BlockWorker/ModularAudio/design_simulations/lm5123sim/LM5123_Excel_Quickstart_Calculator_for_Boost_Controller_Design.xlsx

Sheet: Design Converter
 | LM5123 BOOST Controller Design Tool
ABOUT |  | =Input Box |  |  |  | TERMS OF USE
 |  |  |  |  |  | Rev 0.2 | December-2021
Step 1: Design Specifications
 |  |  | Minimum Input Supply Voltage , VSUPPLY(min) | 11 | V
 |  |  | Typical Input Supply Voltage, VSUPPLY(typ) | 12 | V
 |  |  | Maximum Input Supply Voltage , VSUPPLY(max) | 24 | V
 |  |  | Output Target Voltage, VLOAD | 54 | V
 |  |  | Maximum Output Current , ILOAD | 6.00 | A
 |  |  | Light load operation switching mode | FPWM
 |  |  | Free Running Switching Frequency, FSW | 1000 | kHz
 |  |  | Free running Oscillator Set Resistor, RT | 21.14 | kΩ
 |  |  | Output Power, POUT | 324.0 | W
 |  |  | Boost Converter Duty Cycle Limit of LM5123 at VSUPPLY(MIN) | 88.0 | %
 |  |  | Ideal Duty Cycle at VSUPPLY(MIN) | 79.6 | %
Step 2: Filter Inductor
 |  |  | Switching mode at VSUPPLY(min) | CCM
 |  |  | Desired Maximum Inductor Current Ripple Ratio | 60 | %
 |  |  | Recommended Inductance (LM_CALC) | 1.646 | uH
 |  |  | User Selection. Inductance, (LM) | 1.5 | uH
 |  |  | Max Inductor DCR, RDCR | 2.3 | mΩ
 |  |  | Peak inductor current, ILPK | 32.37 | A
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
