BlockWorker/ModularAudio/design_simulations/TPS552892/TPS552892-CALCULATION-TOOL-V1.0-orig.xlsx

Sheet: Design Calculation
Design Tool for TPS552892
V1.0 (04/26/2023)
This tool is designed to aid the user in designing the TPS552892 buck-boost converter. Refer to TPS552892 datasheet for detail design precedure and all equations.
 |  | User input value
 |  | Calculated value
 |  | No use or internal value
Description | Value | Units | Instructions/Comments | Schematic
Component Value
Vin(min) | 9 | V | >=3.0V
Vin(max) | 16 | V | <=36V
Vout | 12.00 | V | Must be lower than or equal to 22V
Iout(max) | 4 | A | Maximum output current
VCC | Internal |  | Select internal VCC or use external VCC power supply
EXTVCC | High |  | EXTVCC pin input logic status
Switching Mode at light load | FPWM |  | Select Forced PWM or Auto PFM mode at light load
MODE | High |  | MODE pin input logic status
R5 recommended | 100000.0 | Ω | Up resistor value of the extenral feedback resistor value. It is recommended to 100kΩ
R6 recommended | 11111.1 | Ω | Bottom resistor value of the external feedback resistor divider
Iout(limit) | 5 | A | Output current limit setting
R1 | 10.0 | mΩ | Output current sensing resistor
ΔIout(Cout_rms) | 2.31 | Arms | The equivalent output capacitor current ripple spec must be higher than this value.
ΔIin(Cin_rms) | 1.73 | Arms | The equivalent input capacitor current ripple spec must be higher than this value
f(sw) | 400000 | Hz | Typical switching frequency
R2 recommended | 49050 | Ω | Switching frequency setting resistor
Frequency dithering f(mod) | 1000 | Hz | Modulation frequency for spread spectrum
C8 recommended | 7.281199942e-09 | F |  | Register Setting
ΔVout(pk-pk) | 0.05 | Vpp | Maximum desired output ripple solely due to output capacitance (ignores ESR)
Cout(min) recommended | 5e-05 | F | Minimum output capacitance needed for Vout ripple requirement
C2 actual | 1e-06 | F | Effective ceramic capacitance at VOUT. Need to consider the derating with DC bias voltage
C3 actual | 6.8e-05 | F | Effective electrolytic capacitance. Need to consider the derating with DC bias voltage
ESR of C3 | 0.003 | Ω | Equivalent ESR if multiple high ESR electrolytic capacitors in parallel
ΔVin(pk-pk) | 0.05 | Vpp | Maximum desired input ripple due to solely to input capacitance at buck mode
Cin(min) recommended | 5e-05 | F | Minimum input capacitance needed for Vin ripple requirement
Cin actual | 4.3e-05 | F | effective output capacitance. Need to consider the derating with DC bias voltage when using ceramic cap
η estimate | 95.0% |  | Efficiency estimate. Correct it after getting the calculated efficiency
K | 0.5 |  | Fraction of maximum average inductor current that is ripple current (0.2-0.6 typically)
L1 recommended min | 2.00390625e-06 | H | L1's minimum recommended inductance value to meet inductor current ripple ratio at boost mode with Vin_min
L1 actual | 4.7e-06 | H
I(Lrms) max | 5.62 | Arms | Inductor maximum RMS current
I(Lpeak) max | 6.21 | A | The inductor (L1) is recommended to have saturation current rating 30% higher than this value.
I(Laverage) max | 5.61 | A | The inductor average current at minmum Vin.
I(Lvalley) max | 5.02 | A
Average Inductor Limit | 8.0 | A | Desired typical average inductor current limit. ±1A tolerance
External CDC voltage ratio | 0 | mV/mV | ΔVout / (VISP-VISN)
R4 recommend | floating | Ω | Recommended R4 for external CDC setting
Loop Compensation Calculation in FPWM CCM mode |  |  |  | Bode Plot
Vin | 9.0 | V | Check both buck and boost mode by changing Vin and Vout. The loop must have enough phase margin and gain margin
Vout | 12.0 | V
Buck or Boost? | Boost |  | Calculate open loop compensate at buck mode or boost mode
gm_PS | 18.6 | S | Power stage gm of IL/Vcomp
fp_PS | 1537.728919 | Hz | Power stage pole of Rload and Cout
fz_RHP | 51571.9159 | Hz | Right half plane zero in boost mode
fz_ESR | 780171.2897 | Hz | ESR zero of the output cap
f(BW) desired | 8000 | Hz | Should be less than 1/5*fzRPH and 1/10*fsw
gm_EA | 0.00019 | S | Error amplifier gm
R3 recommended | 14640.46384 | Ω
R3 actual | 10000 | Ω | COMP pin has internal 2k resistor in seriese with R3
C7 recommended | 1.657863991e-08 | F | Set the compensation fz = fco/10
C7 actual | 4.7e-09 | F
fz_COMP | 2821.896154 | Hz | Loop compensation zero frequency
C6 recommended | 3.302953772e-10 | F | The lower zero of the Cout's ESR zero and boost right half plane zero should be cancelled by the R3*(C6*C7/(C6+C7)) pole.
C6 actual | 1e-10 | F
fp2_COMP | 131588.0313 | Hz | Have internal 3pF cap between COMP and GND
Efficiency in buck CCM mode or boost CCM mode with maximum Iout
Vin | 9.0 | V | Vin for efficiency estimation at desired Vout and Iout(max)
I(Lrms) | 5.62 | A | Inductor RMS current
I(Lpeak) | 6.21 | A | Inductor peak current
I(Lvalley) | 5.02 | A | Inductor valley current
DCR of L1 | 0.013 | Ω | Inductor series resistance per inductor datasheet
Buck HSFET Rdson | 0.014 | Ω | Buck HSFET on-resistance in TPS552892 is 14mΩ at 25°C. Temperature coefficient is 0.4%/°C. Correct it when at high Tj
Buck HSFET rise time | 1.3e-08 | s | Estimate of SW1 node 10-90% rise time from measurement
Buck HSFET fall time | 1.3e-08 | s | Estimate of SW1 node 10-90% fall time from measurement
Buck LSFET Rdson | 0.022 | Ω | Buck LSFET on-resistance in TPS552892 is 22mΩ at 25°C. Temperature coefficient is 0.4%/°C. Correct it when at high Tj
Buck LSFET dead time | 1e-08 | s | Dead time during the switching
Buck LSFET diode voltage | 0.8 | V | Estimate of body diode voltage of the HSFET
Boost LSFET Rdson | 0.011 | Ω | Boost LSFET on-resistance in TPS552892 is 11mΩ at 25°C. Temperature coefficient is 0.4%/°C. Correct it when at high Tj
Boost LSFET fall time | 9e-09 | s | Estimate of SW node 10-90% fall time from measurement
Boost LSFET rise time | 1.3e-08 | s | Estimate of SW node 10-90% rise time from measurement
Boost HSFET Rdson | 0.01 | Ω | Boost HSFET on-resistance in TPS552892 is 10mΩ at 25°C. Temperature coefficient is 0.4%/°C. Correct it when at high Tj
Boost HSFET dead time | 2e-08 | s | Dead time during the switching
Boost HSFET diode voltage | 1.0 | V | Estimate of body diode voltage of the HSFET
Buck snubber Csnubber | 0 | F | Capacitance of snubber at buck side
Boost snubber Csnubber | 0 | F | Capacitance of snubber at boost side
Rpcb on power path | 2.0 | mΩ | PCB trace resistance on power path from Vin to Vout cap
Rpcb Pd | 63.27350503 | mW | Power losses on PCB trace
Inductor DCR Pd | 411.2777827 | mW | Includes losses from DC resistance drop only
Inductor core & AC Pd | 521 | mW | Core and AC loss of inductor. Use inductor vendor's formula to estimate. 521mW is the power loss of XAL7070-472 running at 400kHz with Ilrms=5.32A and Ilripple=2.63A at 400kHz.
TPS552892 Pd | 1270.262021 | mW | Power loss on TPS552892
Rsense Pd | 160 | mW | Power loss on output current sense resistor
Snubber Pd | 0 | mW | Power loss on snubber
Cout Pd | 17.23892236 | mW | Power loss on ESR of the output capacitor in boost mode | 2.956521739e-09 | 3.851412947 | 1.894894506
η - calculated | 95.2% |  | Efficiency at Iout_max
ΘJA | 33 | °C/W | TPS552892 junction to ambient thermal resistance on EVM. The actual ΘJA depends on the PCB design.
TPS552892 temperature rise | 41.9 | °C | The top case temperature of IC is very close to the Junction temperature because ΨJT=0.6°C/W

Sheet: LegalDisclaimer
THIS PROGRAM IS PROVIDED "AS IS". TI MAKES NO WARRANTIES OR REPRESENTATIONS, EITHER EXPRESS, IMPLIED OR STATUTORY, INCLUDING ANY IMPLIED WARRANTIES OF MERCHANTABILITY, FITNESS FOR A PARTICULAR PURPOSE, LACK OF VIRUSES, ACCURACY OR COMPLETENESS OF RESPONSES, RESULTS AND LACK OF NEGLIGENCE. TI DISCLAIMS ANY WARRANTY OF TITLE, QUIET ENJOYMENT, QUIET POSSESSION, AND NON-INFRINGEMENT OF ANY THIRD PARTY INTELLECTUAL PROPERTY RIGHTS WITH REGARD TO THE PROGRAM OR YOUR USE OF THE PROGRAM.
IN NO EVENT SHALL TI BE LIABLE FOR ANY SPECIAL, INCIDENTAL, CONSEQUENTIAL OR INDIRECT DAMAGES, HOWEVER CAUSED, ON ANY THEORY OF LIABILITY AND WHETHER OR NOT TI HAS BEEN ADVISED OF THE POSSIBILITY OF SUCH DAMAGES, ARISING IN ANY WAY OUT OF THIS AGREEMENT, THE PROGRAM, OR YOUR USE OF THE PROGRAM. EXCLUDED DAMAGES INCLUDE, BUT ARE NOT LIMITED TO, COST OF REMOVAL OR REINSTALLATION, COMPUTER TIME, LABOR COSTS, LOSS OF GOODWILL, LOSS OF PROFITS, LOSS OF SAVINGS, OR LOSS OF USE OR INTERRUPTION OF BUSINESS. IN NO EVENT WILL TI'S AGGREGATE LIABILITY UNDER THIS AGREEMENT OR ARISING OUT OF YOUR USE OF THE PROGRAM EXCEED FIVE HUNDRED DOLLARS (U.S.$500).
Unless otherwise stated, the Program written and copyrighted by Texas Instruments is distributed as "freeware". You may, only under TI's copyright in the Program, use and modify the Program without any charge or restriction. You may distribute to third parties, provided that you transfer a copy of this license to the third party and the third party agrees to these terms by its first use of the Program. You must reproduce the copyright notice and any other legend of ownership on each copy or partial copy, of the Program.
You acknowledge and agree that the Program contains copyrighted material, trade secrets and other TI proprietary information and is protected by copyright laws, international copyright treaties, and trade secret laws, as well as other intellectual property laws. To protect TI's rights in the Program, you agree not to decompile, reverse engineer, disassemble or otherwise translate any object code versions of the Program to a human-readable form. You agree that in no event will you alter, remove or destroy any copyright notice included in the Program. TI reserves all rights not specifically granted under this license. Except as specifically provided herein, nothing in this agreement shall be construed as conferring by implication, estoppel, or otherwise, upon you, any license or other right under any TI patents, copyrights or trade secrets.
TI Information - Selective Disclosure. You may not use the Program in non-TI devices.
