BlockWorker/ModularAudio/design_simulations/lm5123sim/LM5123_Excel_Quickstart_Calculator_for_Boost_Controller_Design-evm.xlsx

 | LM5123 BOOST Controller Design Tool
ABOUT |  | =Input Box |  |  |  | TERMS OF USE
 |  |  |  |  |  | Rev 0.2 | December-2021
Step 1: Design Specifications
 |  |  | Minimum Input Supply Voltage , VSUPPLY(min) | 8 | V
 |  |  | Typical Input Supply Voltage, VSUPPLY(typ) | 14 | V
 |  |  | Maximum Input Supply Voltage , VSUPPLY(max) | 18 | V
 |  |  | Output Target Voltage, VLOAD | 24 | V
 |  |  | Maximum Output Current , ILOAD | 8.33 | A
 |  |  | Light load operation switching mode | FPWM
 |  |  | Free Running Switching Frequency, FSW | 440 | kHz
 |  |  | Free running Oscillator Set Resistor, RT | 49.27 | kΩ
 |  |  | Output Power, POUT | 200.0 | W
 |  |  | Boost Converter Duty Cycle Limit of LM5123 at VSUPPLY(MIN) | 88.0 | %
 |  |  | Ideal Duty Cycle at VSUPPLY(MIN) | 66.7 | %
Step 2: Filter Inductor
 |  |  | Switching mode at VSUPPLY(min) | CCM
 |  |  | Desired Maximum Inductor Current Ripple Ratio | 60 | %
 |  |  | Recommended Inductance (LM_CALC) | 1.616 | uH
 |  |  | User Selection. Inductance, (LM) | 2.6 | uH
 |  |  | Max Inductor DCR, RDCR | 1.6 | mΩ
 |  |  | Peak inductor current, ILPK | 27.33 | A
Step 3: Current Sense Resistor Selection
 |  |  | Peak Current Limit Margin | 30 | %
 |  |  | Selected Peak Current limit(ILPK_select) | 37.24 | A
 |  |  | Recommended current sense Resistor (RS) | 1.61 | mΩ
 |  |  | Selected current sense Resistor (RS) | 1.5 | mΩ
 |  |  | Actual inductor peak current limit | 40.00 | A
Step 4: Output Capacitor Selection
 |  |  | Desired load step ripple voltage (ΔvOUT) | 400 | mV
 |  |  | Minimum output capacitance | 423.18 | uF
 |  |  | Selected Output Capacitance (COUT) | 450 | uF
 |  |  | Equivalent COUT ESR (RESR) | 1 | mΩ
Step 6: Soft-Start Capacitor Selection
 |  |  | Suggested minimum soft-start capacitor (CSS_MIN) | 25.92 | nF
 |  |  | Desied soft-start time at minimum input voltage (TSS) | 10 | ms
 |  |  | Calculated soft-start capacitor (CSS) | 300 | nF
Step 5: UVLO Resistor Divider Selection
 |  |  | Desired voltage On (VUVLO_ON) | 7 | V
 |  |  | Desired voltage OFF (VUVLO_OFF) | 6 | V
 |  |  | Calculated top UVLO resistor value (RUVT_CALC) | 84.09 | kΩ
 |  |  | Selected top UVLO resistor value (RUVT) | 86.6 | kΩ
 |  |  | Bottom UVLO Resistor (RUVB) | 16.146 | kΩ
Step 7: Loop Compensation
 |  |  | Voltage selected (VIN_VAR) | 14V
 |  |  | VREF Resistor Selection
 |  |  | Suggested output voltage range | High
 |  |  | Track pin voltage to set the output voltage (VTRK) | 0.400 | V
 |  |  | Minimum value for (RVREFT_min) | 12.0 | kΩ
 |  |  | Maximum value for (RVREFT_max) | 21.0 | kΩ
 |  |  | Select a top VREF resistor between RVREFT_min and RVREFT_max (RVREFT) | 21 | kΩ
 |  |  | Calculated bottom feedback resistor (RVREFB_calc) | 14.0 | kΩ
 |  |  | Select a bottomresistor based on calculated balue(RVREFB) | 14 | kΩ
 |  |  | Suggested bandwidth (FCO_calc) | 3.9 | kHz
 |  |  | Selected bandwidth (FCO) | 8 | kHz
 |  | Calculated |  | Selected
 | RCOMP | 54.5 | kΩ | 54.9 | kΩ
 | CCOMP | 1.9 | nF | 6.8 | nF
 | CHF | 45.60102166 | pF | 47 | pF
Efficiency / Power Loss Analyzer
Low-Side MOSFET Parameters (QLS)
 |  |  | On-State Resistance, RDS(on) | 4 | mΩ
 |  |  | Total Gate Charge, QG | 28 | nC
 |  |  | Gate-Drain Charge, QGD | 4 | nC
 |  |  | Gate-Source Charge, QGS | 9 | nC
 |  |  | Gate Resistance, RG | 0 | Ω
 |  |  | Gate-Source Threshold Voltage, VTH | 1.7 | V
High-Side MOSFET Parameters (QHS)
 |  |  | On-State Resistance, (RDS(on)) | 4 | mΩ
 |  |  | Total Gate Charge, (QG) | 28 | nC
 |  |  | Gate-Drain Charge, (QGD) | 4 | nC
 |  |  | Gate-Source Charge, (QGS) | 9 | nC
 |  |  | Gate Resistance, (RG) | 0 | Ω
 |  |  | Gate-Source Threshold Voltage, (VTH) | 1.7 | V
 |  |  | Body Diode Reverse Recovery Charge (QRR) | 0 | nC
 |  |  | Body Diode Forward Voltage Drop (VD_BD) | 0.5 | V
