BlockWorker/ModularAudio/design_simulations/lm5123sim/LM5123_Excel_Quickstart_Calculator_for_Boost_Controller_Design-protected.xlsx

 | LM5123 BOOST Controller Design Tool
ABOUT |  | =Input Box |  |  |  | TERMS OF USE
 |  |  |  |  |  | Rev 0.2 | December-2021
Step 1: Design Specifications
 |  |  | Minimum Input Supply Voltage , VSUPPLY(min) | 11 | V
 |  |  | Typical Input Supply Voltage, VSUPPLY(typ) | 11 | V
 |  |  | Maximum Input Supply Voltage , VSUPPLY(max) | 22 | V
 |  |  | Output Target Voltage, VLOAD | 53.5 | V
 |  |  | Maximum Output Current , ILOAD | 6.00 | A
 |  |  | Light load operation switching mode | FPWM
 |  |  | Free Running Switching Frequency, FSW | 2000 | kHz
 |  |  | Free running Oscillator Set Resistor, RT | 10.10 | kΩ
 |  |  | Output Power, POUT | 321.0 | W
 |  |  | Boost Converter Duty Cycle Limit of LM5123 at VSUPPLY(MIN) | 79.8 | %
 |  |  | Ideal Duty Cycle at VSUPPLY(MIN) | 79.4 | %
Step 2: Filter Inductor
 |  |  | Switching mode at VSUPPLY(min) | CCM
 |  |  | Desired Maximum Inductor Current Ripple Ratio | 60 | %
 |  |  | Recommended Inductance (LM_CALC) | 0.740 | uH
 |  |  | User Selection. Inductance, (LM) | 0.82 | uH
 |  |  | Max Inductor DCR, RDCR | 2.3 | mΩ
 |  |  | Peak inductor current, ILPK | 31.85 | A
Step 3: Current Sense Resistor Selection
 |  |  | Peak Current Limit Margin | 30 | %
 |  |  | Selected Peak Current limit(ILPK_select) | 43.40 | A
 |  |  | Recommended current sense Resistor (RS) | 1.38 | mΩ
 |  |  | Selected current sense Resistor (RS) | 1.2 | mΩ
 |  |  | Actual inductor peak current limit | 50.00 | A
Step 4: Output Capacitor Selection
 |  |  | Desired load step ripple voltage (ΔvOUT) | 50 | mV
 |  |  | Minimum output capacitance | 652.61 | uF
 |  |  | Selected Output Capacitance (COUT) | 1000 | uF
 |  |  | Equivalent COUT ESR (RESR) | 1 | mΩ
Step 6: Soft-Start Capacitor Selection
 |  |  | Suggested minimum soft-start capacitor (CSS_MIN) | 178.33 | nF
 |  |  | Desied soft-start time at minimum input voltage (TSS) | 10 | ms
 |  |  | Calculated soft-start capacitor (CSS) | 251.7647059 | nF
Step 5: UVLO Resistor Divider Selection
 |  |  | Desired voltage On (VUVLO_ON) | 10 | V
 |  |  | Desired voltage OFF (VUVLO_OFF) | 9 | V
 |  |  | Calculated top UVLO resistor value (RUVT_CALC) | 77.27 | kΩ
 |  |  | Selected top UVLO resistor value (RUVT) | 77 | kΩ
 |  |  | Bottom UVLO Resistor (RUVB) | 9.517 | kΩ
Step 7: Loop Compensation
 |  |  | Voltage selected (VIN_VAR) | 11V
 |  |  | VREF Resistor Selection
 |  |  | Suggested output voltage range | High
 |  |  | Track pin voltage to set the output voltage (VTRK) | 0.892 | V
 |  |  | Minimum value for (RVREFT_min) | 2.2 | kΩ
 |  |  | Maximum value for (RVREFT_max) | 3.8 | kΩ
 |  |  | Select a top VREF resistor between RVREFT_min and RVREFT_max (RVREFT) | 3.3 | kΩ
 |  |  | Calculated bottom feedback resistor (RVREFB_calc) | 27.2 | kΩ
 |  |  | Select a bottomresistor based on calculated balue(RVREFB) | 27 | kΩ
 |  |  | Suggested bandwidth (FCO_calc) | 14.6 | kHz
 |  |  | Selected bandwidth (FCO) | 12 | kHz
 |  | Calculated |  | Selected
 | RCOMP | 260.7 | kΩ | 220 | kΩ
 | CCOMP | 0.9 | nF | 1 | nF
 | CHF | 2.263152979 | pF | 3 | pF
Efficiency / Power Loss Analyzer
Low-Side MOSFET Parameters (QLS)
 |  |  | On-State Resistance, RDS(on) | 3.2 | mΩ
 |  |  | Total Gate Charge, QG | 12 | nC
 |  |  | Gate-Drain Charge, QGD | 1.7 | nC
 |  |  | Gate-Source Charge, QGS | 1.9 | nC
 |  |  | Gate Resistance, RG | 2.2 | Ω
 |  |  | Gate-Source Threshold Voltage, VTH | 1.1 | V
High-Side MOSFET Parameters (QHS)
 |  |  | On-State Resistance, (RDS(on)) | 3.2 | mΩ
 |  |  | Total Gate Charge, (QG) | 12 | nC
 |  |  | Gate-Drain Charge, (QGD) | 1.7 | nC
 |  |  | Gate-Source Charge, (QGS) | 1.9 | nC
 |  |  | Gate Resistance, (RG) | 2.2 | Ω
 |  |  | Gate-Source Threshold Voltage, (VTH) | 1.1 | V
 |  |  | Body Diode Reverse Recovery Charge (QRR) | 0 | nC
 |  |  | Body Diode Forward Voltage Drop (VD_BD) | 0.5 | V
