BlockWorker/ModularAudio/design_simulations/lm54406F/LMR54406F_PSPICE_TRANS - orig/LMR54406F_PSPICETransientModel_FeaturesandLimitations.pdf

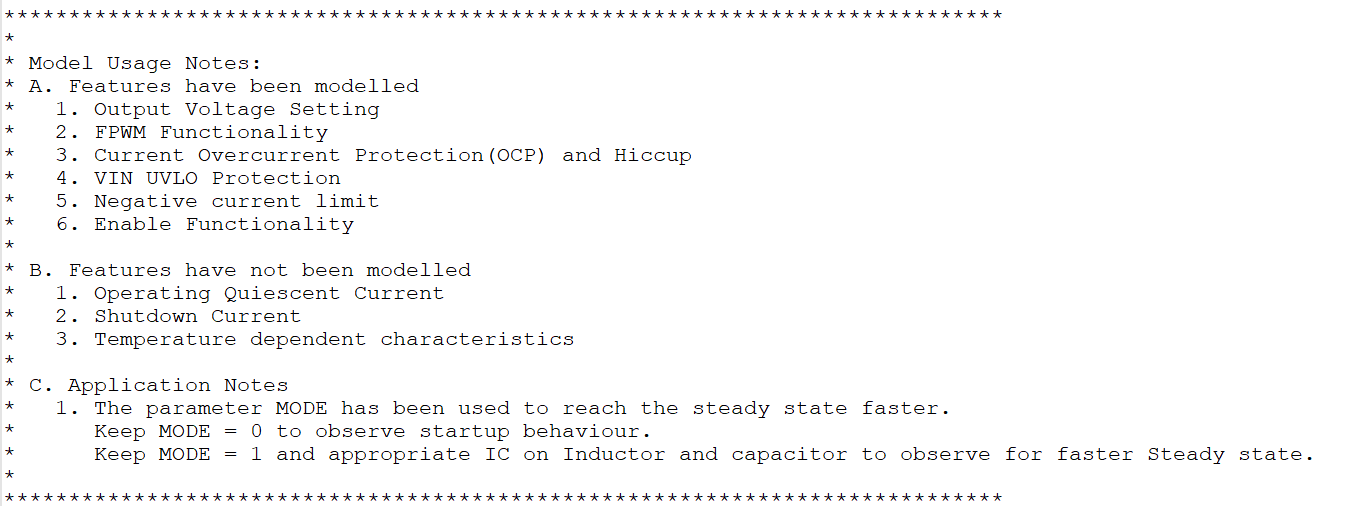
[picture p1: figure]
