BlockWorker/ModularAudio/design_simulations/SBAA333 Companion Simulations/Class-D LC Filter Designer.xlsx

Sheet: L-C Filter Designer
Class-D LC Filter Designer
Select the output configuration on the right.
Filter Type | Common Mode
Output Configuration | BTL
Load Factor | 0.5
Enter the speaker load, desired cutoff frequency, and quality factor.
 |  |  | Gain vs Frequency | Zoom (Gain vs Frequency)
Speaker Load (RLoad) | 4 | Ω
Cutoff Frequency | 40 | kHz
Quality Factor (Q) | 0.707
The calculated LC filter component values are shown below.
Inductor (L) | 11.26 | uH
Capacitor (Cg ) | 1.407 | uF
Capacitor (CBTL) | 1.407 | uF
Total Cap SE Equivalent | 1.407 | uF
Enter standard inductor and capacitor values below to graph & verify.
Inductor (L) | 10.00 | uH
Capacitor (Cg ) | 1.000 | uF
Capacitor (CBTL) | 0.680 | uF |  |  |  |  |  |  | Q
 |  |  |  |  |  | Load 1 | 2 | Ω | 0.316
Total Cap SE Equivalent | 1.000 | uF |  |  | Enter up to 5 different loads to graph. | Load 2 | 3 | Ω | 0.474
 |  |  |  |  |  | Load 3 | 4 | Ω | 0.632
Cut-Off Frequency | 50.3 | kHz |  |  |  | Load 4 | 6 | Ω | 0.949
 |  |  |  |  |  | Load 5 | 8 | Ω | 1.265
Quality Factor (Q) | 0.632
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
