BlockWorker/ModularAudio/design_simulations/lm5123sim/mos-estimates.xlsx

Vout | 53.5
vin | 11 | bottom fet q1 |  | top fet q2
fsw | 2000000 | pswon | 3.951967431 | pdiodec | 1.541695613
dcycle | 0.8046728972 | pswoff | 4.084788441 | pdioderr | 0
L | 8.2e-07 | pcoss | 2.675 | pcoss | 2.675
dil | 5.397196262 | pcond | 3.044897617 | pcond | 0.7391214888
Iout | 6 | pgate | 0.12 | pgate | 0.12
Ilmin | 28.01910522 | ptot | 13.87665349 | ptotd | 1.541695613
ilmax | 33.41630148 |  |  | ptott | 2.400817102
qgs2q1 | 1.2e-09 |  |  | ptot | 3.942512715
qgdq1 | 1.7e-09
ig1on | 1.1
ig2on | 1.1
ig1off | 1.269230769
ig2off | 1.269230769
qossq1 | 5e-08
qossq2 | 5e-08
vfq2 | 0.6
tdeadr | 2.2e-08
tdeadf | 2e-08
qrrq2 | 0
rr | 0.1757031182
irmsq1 | 27.59029547
rdsonq1 | 0.004
irmsq2 | 13.59339443
rdsonq2 | 0.004
qgq1 | 1.2e-08
qgq2 | 1.2e-08
vgs | 5
rgq1 | 2.2
rgq2 | 2.2
rdrq1 | 0.8
rdfq1 | 0.4
rdrq2 | 0.8
rdfq2 | 0.4
vplq1 | 1.7
vplq2 | 1.7
igr1 | 1.1
igf1 | 1.269230769
igr2 | 1.1
igf2 | 1.269230769
