BlockWorker/ModularAudio/design_simulations/battery_calculations/charge.png

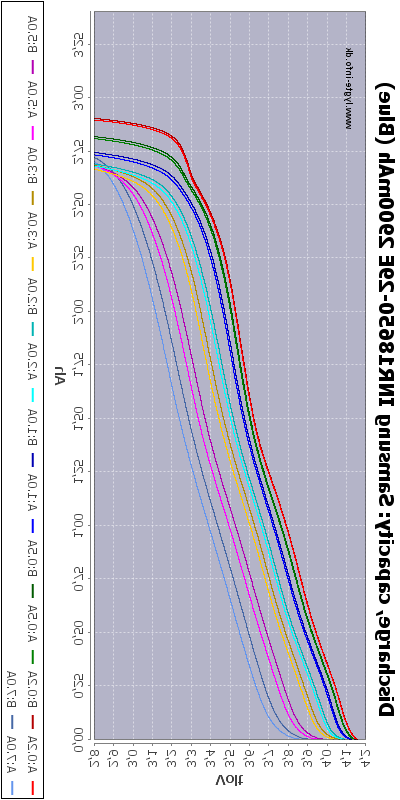
design_simulations/battery_calculations/charge.png
