BlockWorker/ModularAudio/design_simulations/lm5123sim/LM5123-Q1_PSPICE_TRANS/LM5123-Q1_PSPICE_TRANS.png

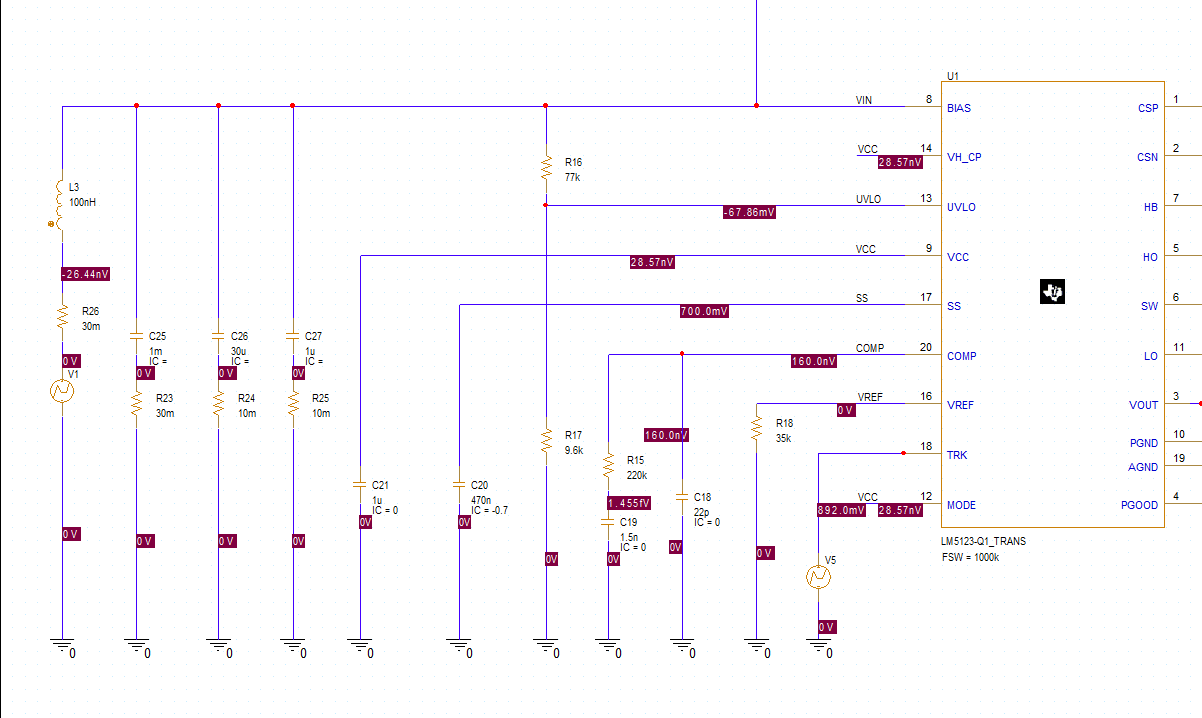
design_simulations/lm5123sim/LM5123-Q1_PSPICE_TRANS/LM5123-Q1_PSPICE_TRANS.png
