BlockWorker/ModularAudio/design_simulations/lm25576/LM25576_PSPICE_AVG/LM25576_AVG.png

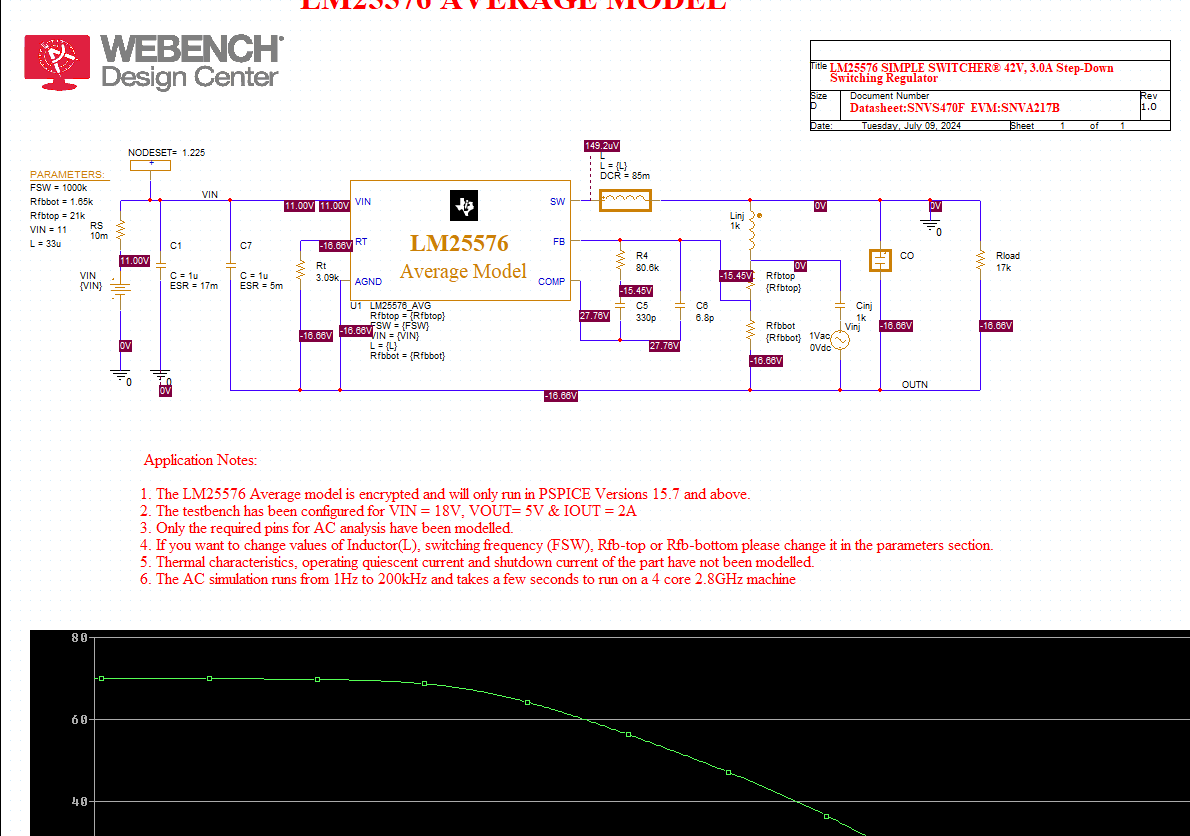
design_simulations/lm25576/LM25576_PSPICE_AVG/LM25576_AVG.png
