BlockWorker/ModularAudio/design_simulations/lm25576/LM25576_PSPICE_TRANS/LM25576_TRANS.png

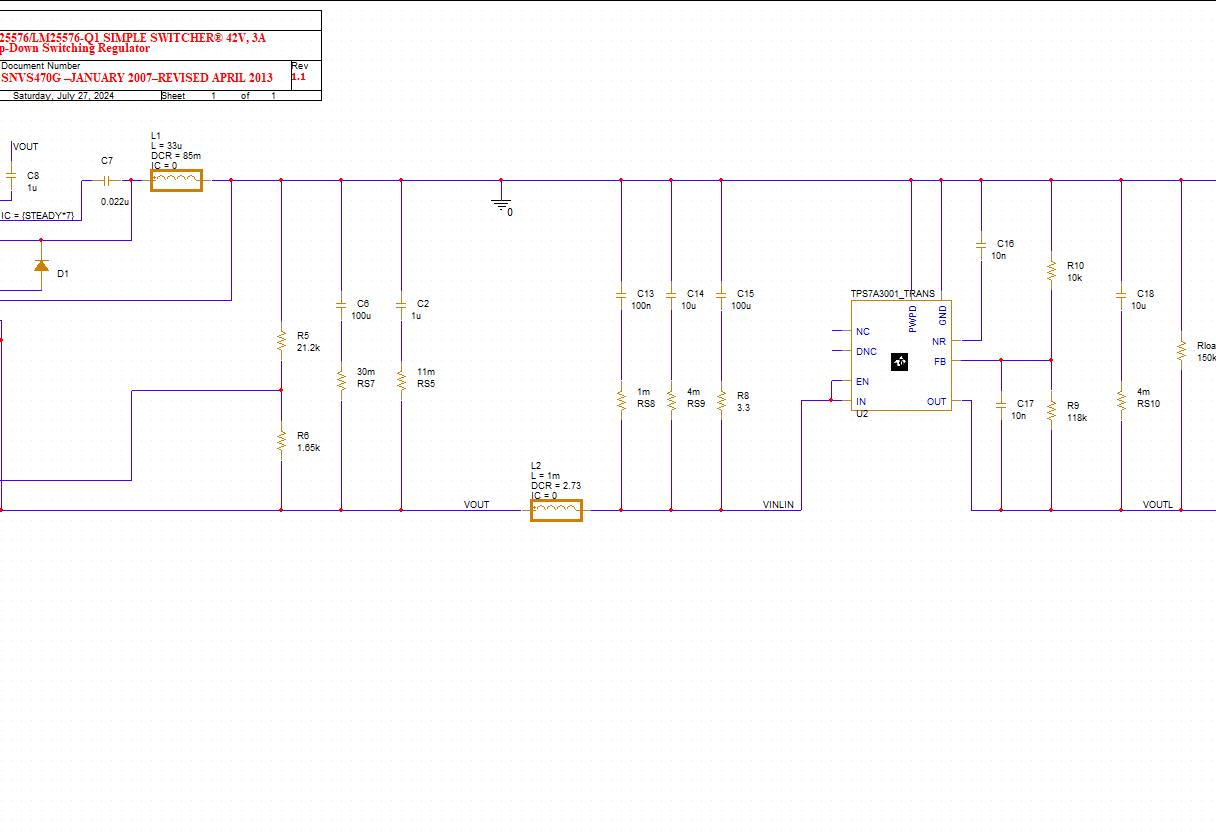
design_simulations/lm25576/LM25576_PSPICE_TRANS/LM25576_TRANS.png
