BlockWorker/ModularAudio/design_simulations/lm25576/TPS7A3001_PSPICE_TRANS/TPS7A3001_TRANS.png

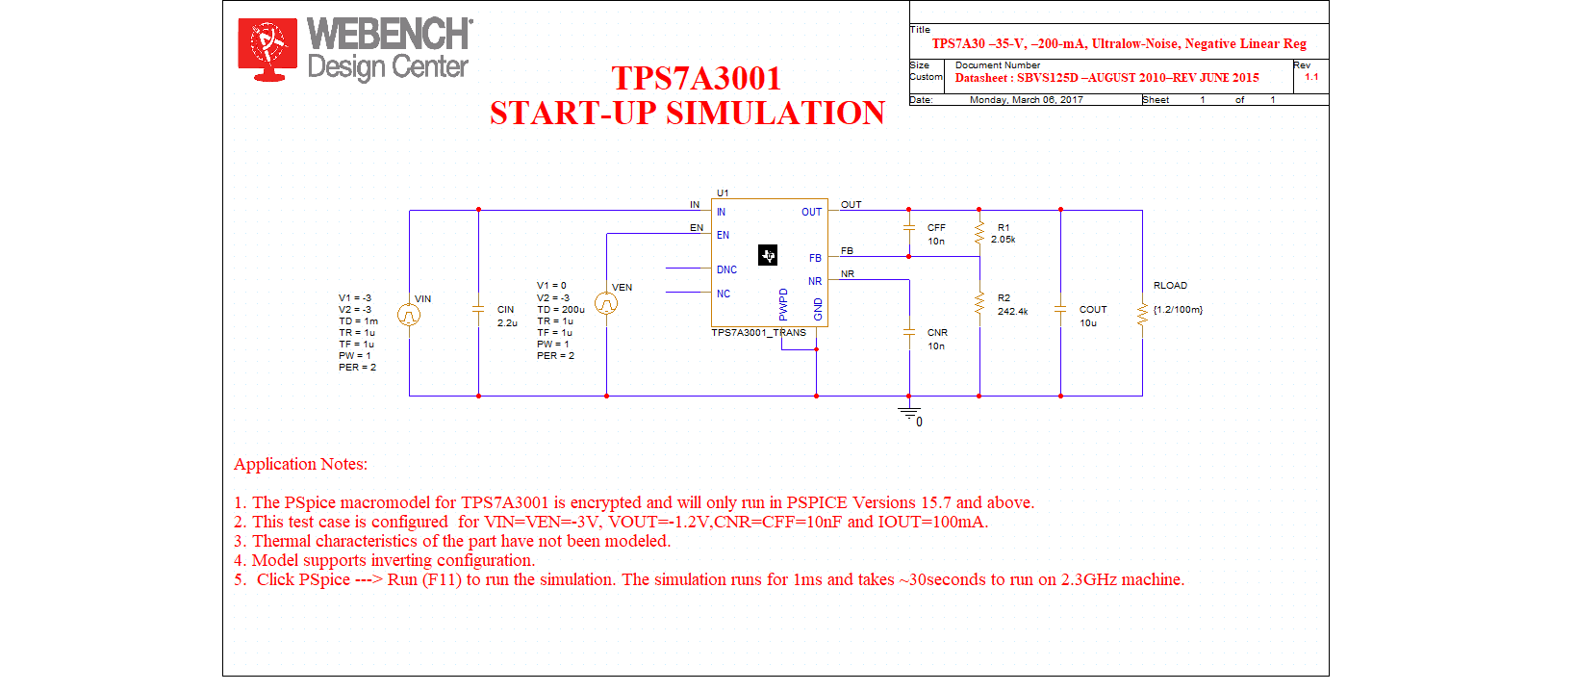
design_simulations/lm25576/TPS7A3001_PSPICE_TRANS/TPS7A3001_TRANS.png
