BlockWorker/ModularAudio/design_simulations/lm54406F/LMR54406F_PSPICE_TRANS/LMR54406F_TRANS.png

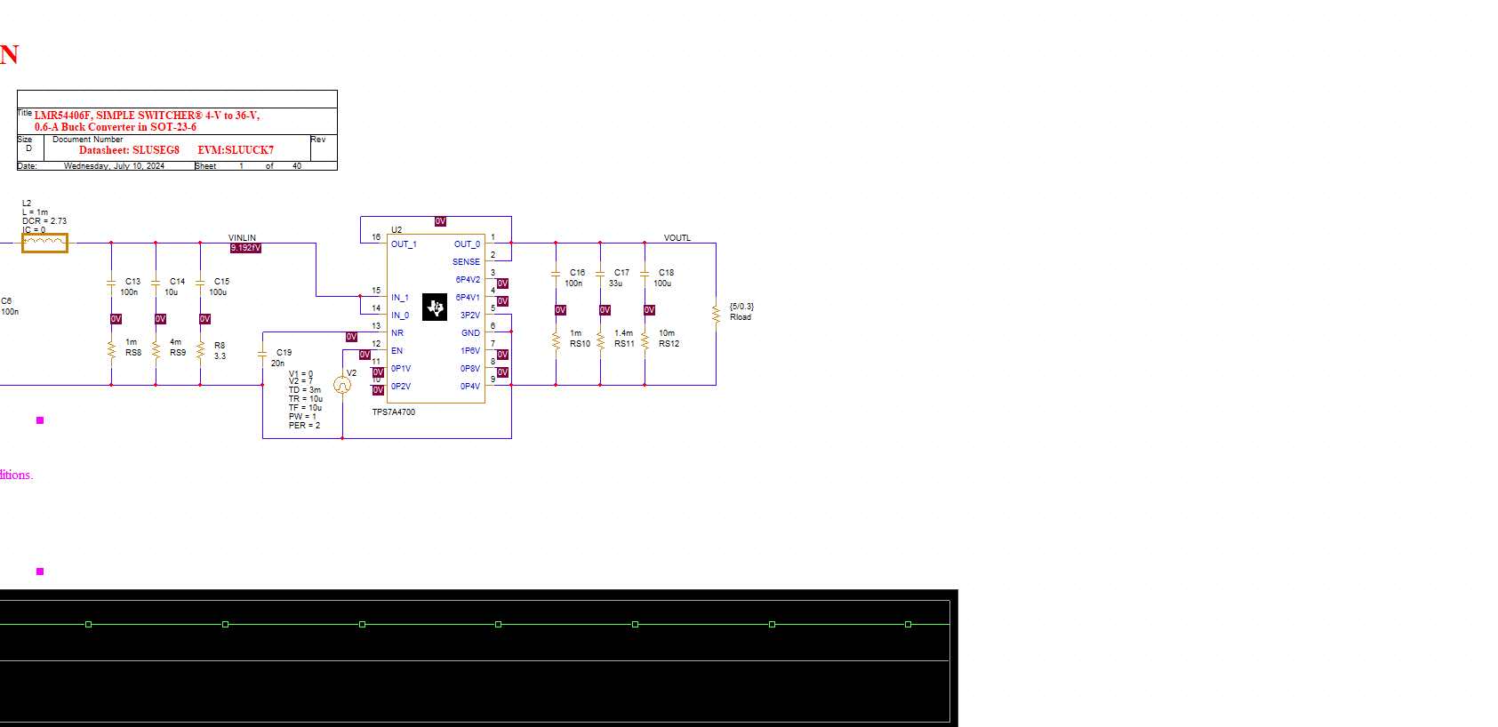
design_simulations/lm54406F/LMR54406F_PSPICE_TRANS/LMR54406F_TRANS.png
