BlockWorker/ModularAudio/design_simulations/lm54406F/TPS7A4700_PSPICE_TRANS/TPS7A4700_TRANS.png

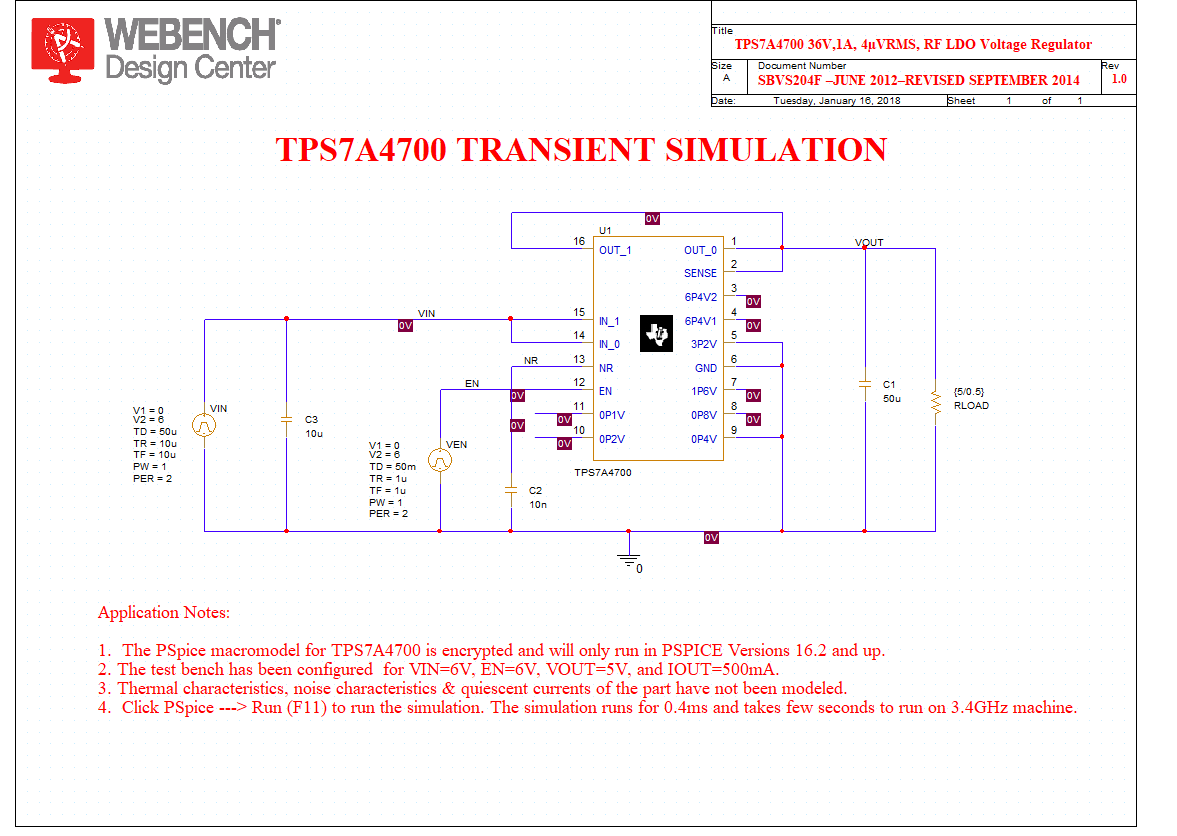
design_simulations/lm54406F/TPS7A4700_PSPICE_TRANS/TPS7A4700_TRANS.png
