BlockWorker/ModularAudio/design_simulations/TPS552892/TPS552892_Encrypted/TPS552892.png

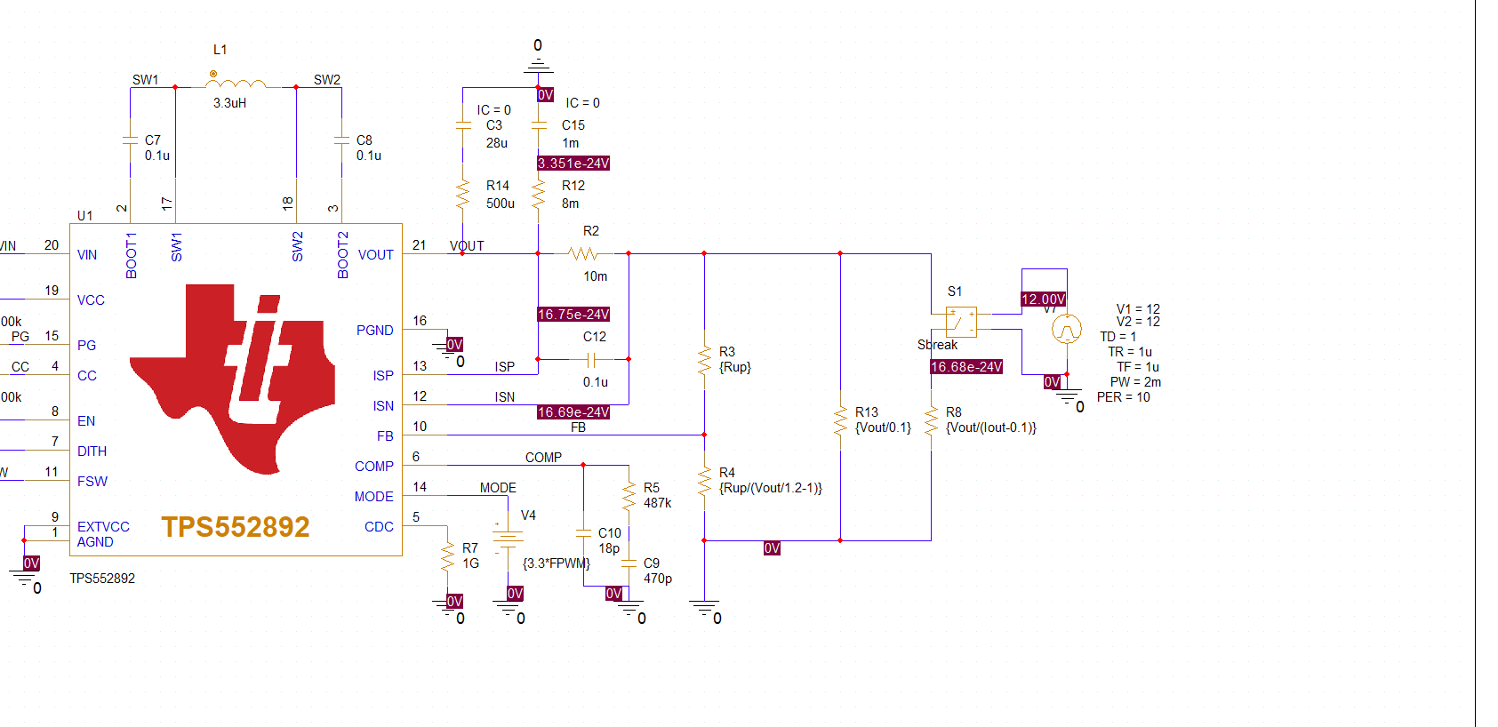
design_simulations/TPS552892/TPS552892_Encrypted/TPS552892.png
