BlockWorker/ModularAudio/Misc/PowerAmpSupply EMI/1khz_-4db_x.png

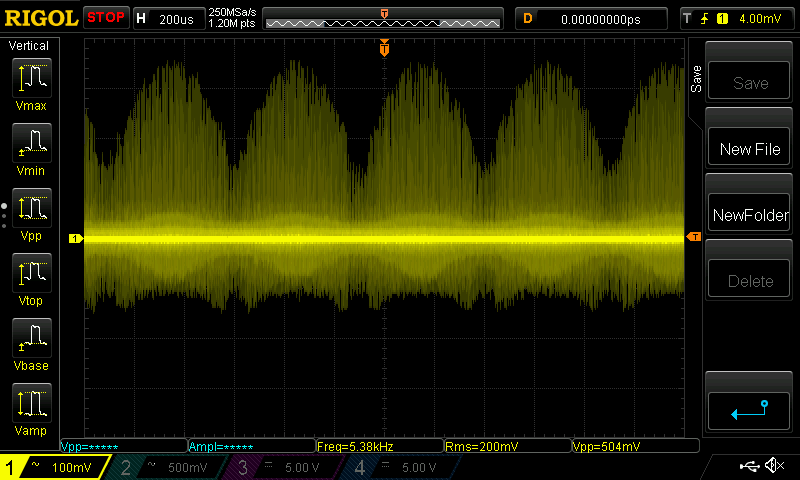
Misc/PowerAmpSupply EMI/1khz_-4db_x.png
