BlockWorker/ModularAudio/Misc/PowerAmpSupply EMI/1khz_-4db_x_after.png

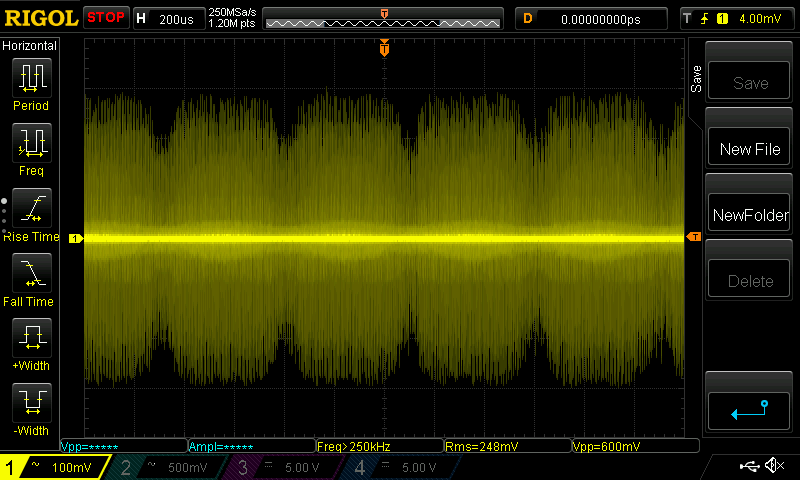
Misc/PowerAmpSupply EMI/1khz_-4db_x_after.png
