BlockWorker/ModularAudio/Misc/PowerAmpSupply EMI/1khz_-4db_y_after.png

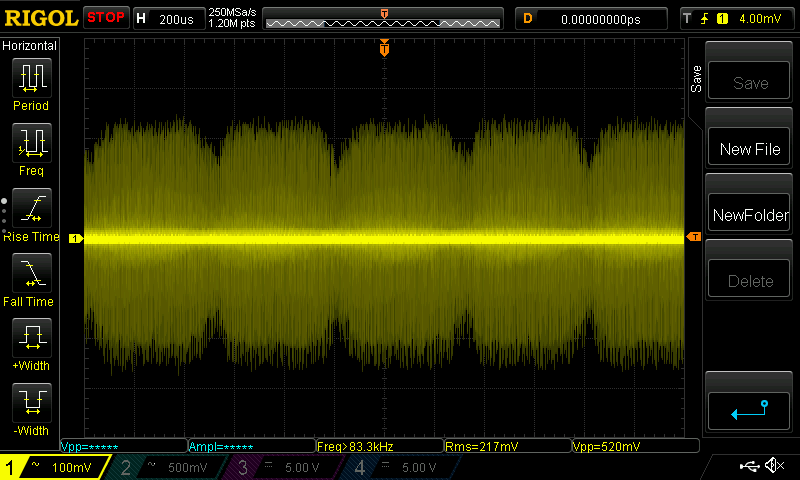
Misc/PowerAmpSupply EMI/1khz_-4db_y_after.png
