BlockWorker/ModularAudio/Misc/PowerAmpSupply EMI/1khz_-4db_z.png

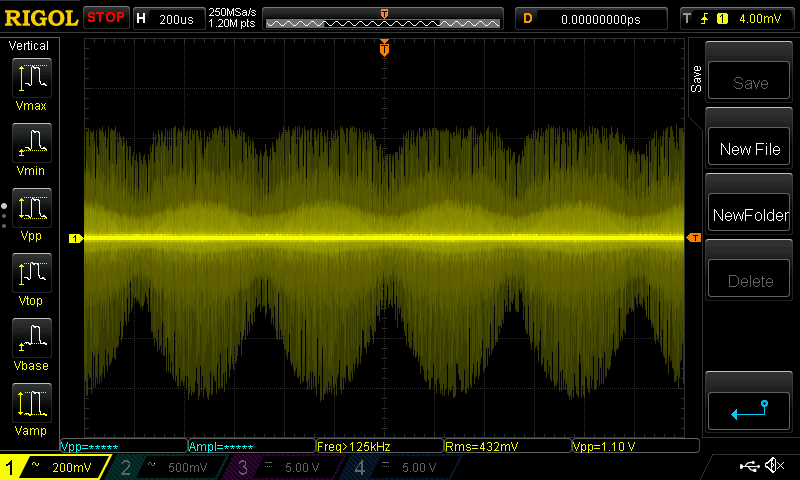
Misc/PowerAmpSupply EMI/1khz_-4db_z.png
