BlockWorker/ModularAudio/Misc/PowerAmpSupply EMI/1khz_-4db_z_after.png

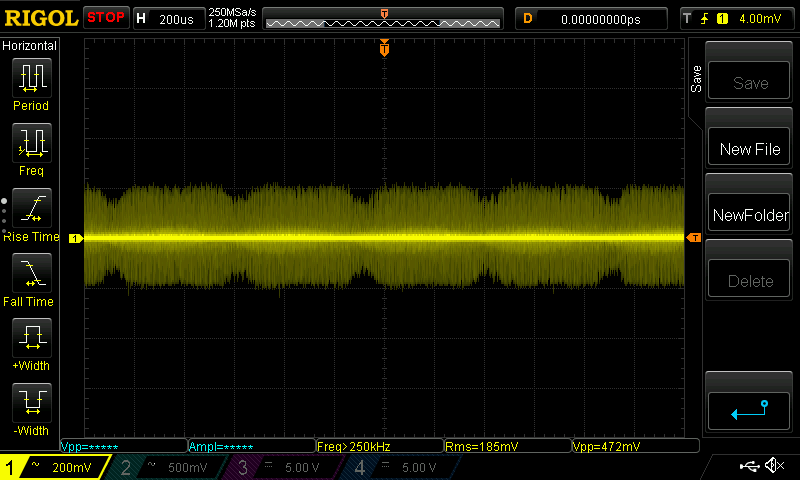
Misc/PowerAmpSupply EMI/1khz_-4db_z_after.png
