BlockWorker/ModularAudio/design_simulations/lm5123sim/SYNC-BOOST-FET-LOSS-CALC_Rev1.xlsm

Sheet: Intro
 |  | © 2021
TI NexFET Sync Boost Power Loss Calculation Tool- Rev. 1
User Input Worksheet Instructions:
Step 1: Fill in the blue System Parameters cells.
Step 2: Click on the big blue CLICK HERE Start FET Selection button.
Step 3a: Use the pulldown to select the FET configuration: Singe Discrete or Dual/Power Block.
Step 3b: Click on the blue CLICK HERE Top FET1 button.
Step 3c: Select Top FET1 from the pulldown list.
Step 3d: Click on the blue CLICK HERE Bottom FET1 button.
Step 3e: Select Bottom FET1 from the pulldown list.
Repeat to compare up to 3 TI FET solutions.
The yellow cells are from the FET datasheet. The green cells are calculated values.
The user can change the operating conditions and losses will automatically be recalculated in the summary table on User Input tab.
Click on the big blue CLICK HERE Start FET Selection button to clear previous FET selections and to start a new search.
Refer to Equations worksheet for equations used to estimate FET power loss.
Comments or suggestions should be posted on: e2e.ti.com
This worksheet is designed with Microsoft Excel 2019. Its use is intended to assist power supply designers in their routine, day-to-day
calculations.
The blue cells on worksheet "User Input" are inputs, yellow cells are from the FET datasheet and green cells are calculated values
After entering the system parameters, click on the big blue button to start the FET selection process. You can compare up to 3 different devices.
There are pulldown lists with estimated power losses, FET part number, package and 1ku pricing to help with your selection.
Questions, comments or suggestions should be posted on: e2e.ti.com
 | Disclaimer
 | This product is designed as an aid for customers of Texas Instruments. No warranties, either express
 | or implied, with respect to this software or its fitness for any particular purpose is claimed by Texas
 | Instruments or the author. The software is licensed solely on an "as is" basis. The entire risk as to its
 | quality and performance is with the customer.

Sheet: User Input
User Inputs
Datasheet Values
Calculated Values
Step 1: Input System Parameters |  |  | Step 3: Select FET Configuration, Pick Top FET & Bottom FET, Compare up to 3 FET Combinations
≤ 80V | Input Voltage (V) | 11.0 | 3a. Select FET Configuration →→→ | Dual/Power Block | Select FET Configuration | Select FET Configuration
2.5V ≤ VGS ≤ 16V | Gate Drive Voltage (V) | 5.0 | 3b. Start Q2, Top FET Selection →→→
Vout > Vin & Vout ≥ 75V | Output Voltage (V) | 53.50 |  | Choice 1 | Choice 2 | Choice 3
Iout ≤ 50A | Max Output Current (A) | 6.00 |  | PLOSS, PN, PKG, $/1ku | PLOSS, PN, PKG, $/1ku | PLOSS, PN, PKG, $/1ku
Fsw ≤ 2MHz | Switching Frequency (kHz) | 2000 | 3c. Pick Q2, Top FET →→→
ƞ < 100% | Target Efficiency for Duty Cycle | 95% | TI Part Number | #VALUE! | #VALUE! | #VALUE!
20% - 30% Typical | Target Ripple Ratio ΔIo/Io | 30% | BVDSS (V) | #VALUE! | #VALUE! | #VALUE!
 | Minimum Inductor (µH) | 0.48 | VGS Max (V) | #VALUE! | #VALUE! | #VALUE!
Pick Inductor | Select Inductor (µH) | 0.82 | RDS(ON) Max (mΩ) | #VALUE! | #VALUE! | #VALUE!
Controller Datasheet | HS Driver Pull Up (Ω) | 0.8 | QG(tot) (nC) | #VALUE! | #VALUE! | #VALUE!
Controller Datasheet | HS Driver Pull Down (Ω) | 0.4 | QGD (nC) | #VALUE! | #VALUE! | #VALUE!
Controller Datasheet | LS Driver Pull Up (Ω) | 0.8 | TJ Max (°C) | #VALUE! | #VALUE! | #VALUE!
Controller Datasheet | LS Driver Pull Down (Ω) | 0.4 | Package | #VALUE! | #VALUE! | #VALUE!
Controller Datasheet | VSW Rising Deadtime (ns) | 22.0 | 1ku Price | #VALUE! | #VALUE! | #VALUE!
Controller Datasheet | VSW Falling Deadtime (ns) | 20.0 | Datasheet Link | #VALUE! | #VALUE! | #VALUE!
TJ ≤ 150°C | Temperature (ºC) for RDS(ON) | 75 | 3d. Start Q1, Bottom FET Selection →→→
Calculated Operating Conditions |  |  | 3e. Pick Q1, Bottom FET →→→
 | Duty Cycle | 80.5% | TI Part Number | #VALUE! | #VALUE! | #VALUE!
 | On Time (µs) | 0.40 | BVDSS (V) | #VALUE! | #VALUE! | #VALUE!
 | Off Time (µs) | 0.10 | VGS Max (V) | #VALUE! | #VALUE! | #VALUE!
 | Inductor Ripple Current (AP-P) | 5.40 | RDS(ON) Max (mΩ) | #VALUE! | #VALUE! | #VALUE!
Target 25% to 30% | Ripple Current Ratio | 17.6% | QG(tot) (nC) | #VALUE! | #VALUE! | #VALUE!
 | Bottom FET RMS Current (ARMS) | 27.59 | QGD (nC) | #VALUE! | #VALUE! | #VALUE!
 | Top FET RMS Current (ARMS) | 13.59 | TJ Max (°C) | #VALUE! | #VALUE! | #VALUE!
Step 2: Click The Blue Button Below |  |  | Package | #VALUE! | #VALUE! | #VALUE!
↓↓↓↓↓↓↓↓↓↓↓↓↓↓↓↓↓↓↓↓ |  |  | 1ku Price | #VALUE! | #VALUE! | #VALUE!
 |  |  | Datasheet Link | #VALUE! | #VALUE! | #VALUE!
 |  |  | Click Here for N-Channel MOSFET Selector on TI.com (https://www.ti.com/power-management/mosfets/n-channel-transistors/products.html) |  | Click Here for Power Block MOSFET Selector on TI.com (https://www.ti.com/power-management/mosfets/power-blocks/products.html)
 |  |  | FET Power Loss and Cost Summary
 |  |  | Top FET RDS(ON) @ TJ (mΩ) | #VALUE! | #VALUE! | #VALUE!
 |  |  | Bottom FET RDS(ON) @ TJ (mΩ) | #VALUE! | #VALUE! | #VALUE!
↑↑↑↑↑↑↑↑↑↑↑↑↑↑↑↑↑↑↑↑ |  |  | Top FET Loss (W) | #VALUE! | #VALUE! | #VALUE!
 |  |  | Bottom FET Loss (W) | #VALUE! | #VALUE! | #VALUE!
 |  |  | Total MOSFET Losses (W) | #VALUE! | #VALUE! | #VALUE!
 |  |  | Total MOSFET Cost ($/1ku) | #VALUE! | #VALUE! | #VALUE!
 |  |  | Click Here to See FET Power Loss Capability by Package |  | Click Here to See TI Synchronous Boost Controllers (https://www.ti.com/power-management/non-isolated-dc-dc-switching-regulators/step-up-boost/boost-controllers-external-switch/products.html)

Sheet: Equations
Click here to see Power Loss Calculation With Common Source Inductance Consideration for Synchronous Buck Converters Application Report (https://www.ti.com/lit/an/slpa009a/slpa009a.pdf)
 |  | Package | TI part number | Package Source Inductance
MOSFET on resistance at junction temperature = TJ: | Bottom FET switching losses: | Stacked die power block | CSD8xxxxxQ5D/Q3D | 100pH
 |  | Powerblock 2 | CSD87381P, CSD87384M, CSD87588N | 250pH
 |  | Clip SON | CSD1xxxxQ3/Q5/Q5B | 450pH
 |  | SON wirebond 2x2, 3x3 | CSD1xxxxQ3A, Q2 | 650pH
 |  | SON wirebond 5x6 | CSD1xxxxQ5A | 850pH
Duty cycle: |  | SO-8 | CSD8853xND | 1.5nH
 |  | TO220/D2PAK | CSD1xxxxKCS/KTT | 7.5nH
 | Top FET body diode losses during deadtime:
MOSFET on & off times:
 | Top FET body diode reverse recovery losses:
Target inductor ripple & inductance: | Bottom FET output capacitance losses:
 | Top FET output capacitance losses:
Inductor currents: | Bottom FET conduction loss:
 | Top FET conduction loss:
 | MOSFET gate drive loss for both FETs:
Ripple current ratio:
Bottom FET RMS current:
Top FET RMS current:
