BlockWorker/ModularAudio/12VLDO/12VLDO.csv

Id | Designator | Footprint | Quantity | Designation | Supplier and ref
1 | J4,J3 | Amphenol_MINITEK_0.8_2P_V | 2 | OUT
2 | U1 | Texas_RGW0020A_VQFN-20-1EP_5x5mm_P0.65mm_EP3.15x3.15mm | 1 | TPS7A47
3 | J2 | SolderWirePad_1x01_SMD_1x2mm | 1 | IN-
4 | J1 | SolderWirePad_1x01_SMD_1x2mm | 1 | IN+
5 | C4 | C_1210_3225Metric | 1 | 22µF 16V
6 | C3 | C_0805_2012Metric | 1 | 1µF 50Vl
7 | C2 | C_0603_1608Metric | 1 | 0.1µF
8 | C1 | C_1206_3216Metric | 1 | 10µF 50V
