BlockWorker/ModularAudio/BatteryMonitor/BatteryMonitor.step

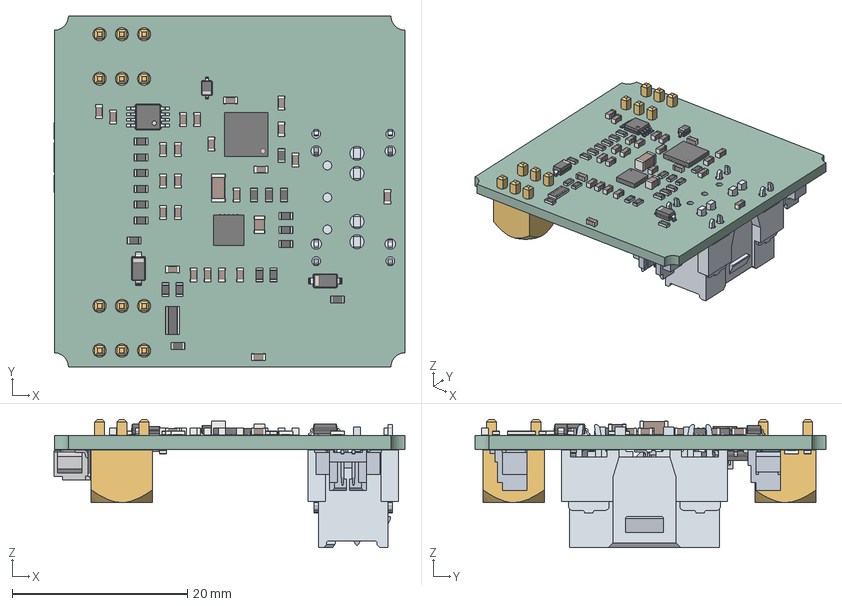
[picture p17: CAD file, 2025-01-15]
BatteryMonitor/BatteryMonitor.step
40.0 x 40.0 x 14.7 mm
R_0603_1608Metric x 25
C_0603_1608Metric x 24
D_SOD_123 x 2
C_0805_2012Metric
QFN-32-1EP_5x5mm_Pitch0.5mm
D_SOD_323
MSOP_8_3x3mm_P065mm
Texas_VQFN_RGR_20_1EP_35x35mm_Pitch05mm
C_1206_3216Metric
R_0612_1632Metric
10114828-XXX04LF(20200601)La
SOT-23-3
PinSocket_1x05_P127mm_Vertical_SMD_Pin1Right
SW_SPST_TL3305A
10114828-XXX02LFC
5P
C-2042274-2
BatteryMonitor_PCB
