BlockWorker/ModularAudio/Misc/AntennaMount.stl

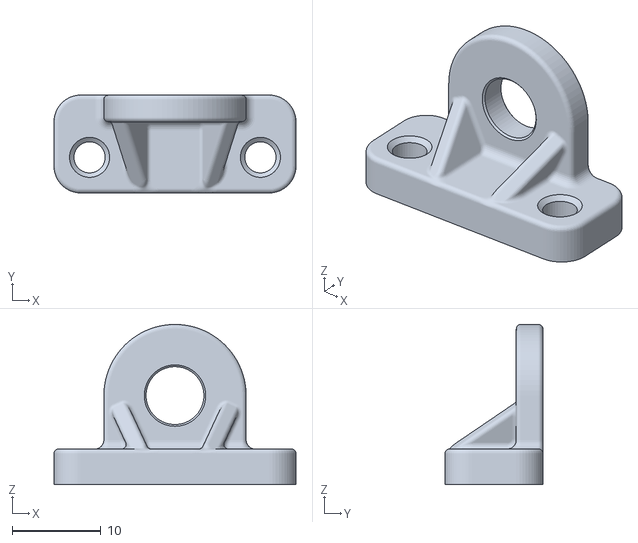
[picture p18: CAD file, 2025-08-03]
Misc/AntennaMount.stl
27.2 x 11.0 x 18.0
