BlockWorker/ModularAudio/Misc/BatteryEnclosure/Lid.stl

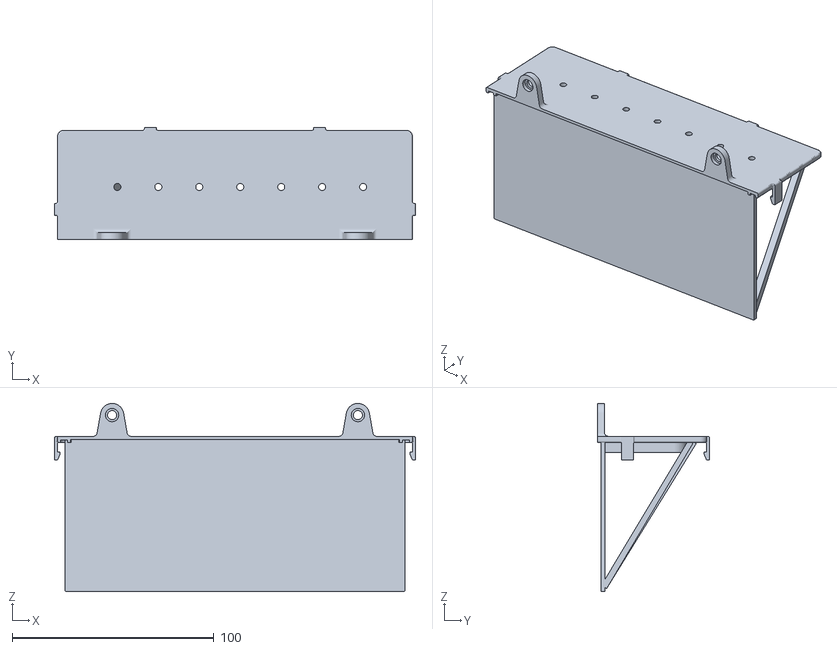
[picture p19: CAD file, 2025-01-15]
Misc/BatteryEnclosure/Lid.stl
178.9 x 55.7 x 93.3
