BlockWorker/ModularAudio/PowerAmplifier/PowerAmp heatspreader v2.step

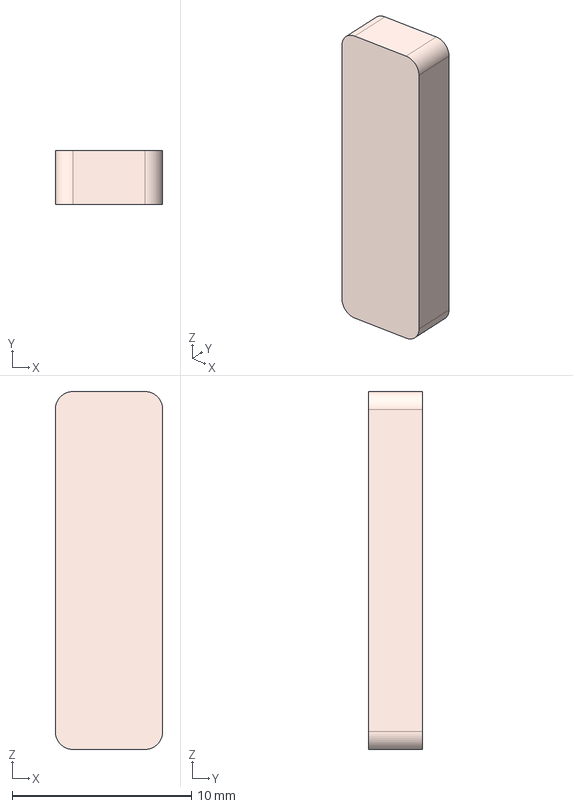
[picture p20: CAD file, 2024-08-12]
PowerAmplifier/PowerAmp heatspreader v2.step
6.00 x 3.00 x 20.0 mm
