BlockWorker/ModularAudio/PowerAmpSupply/PowerAmpSupply heatspreader v5.step

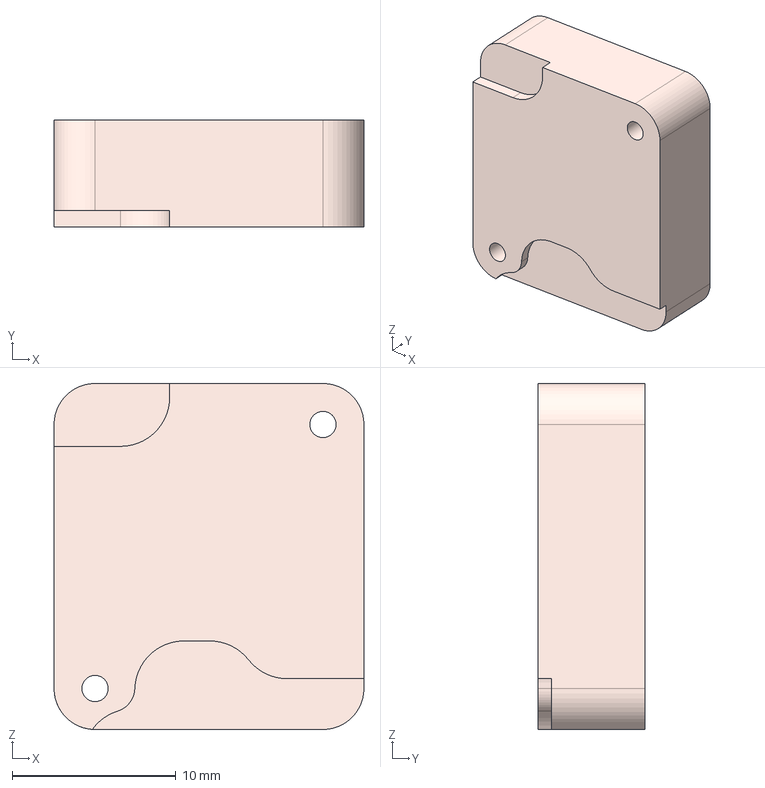
[picture p21: CAD file, 2024-08-12]
PowerAmpSupply/PowerAmpSupply heatspreader v5.step
18.9 x 6.50 x 21.1 mm
