BlockWorker/ModularAudio/Misc/BatteryEnclosure/Cover.stl

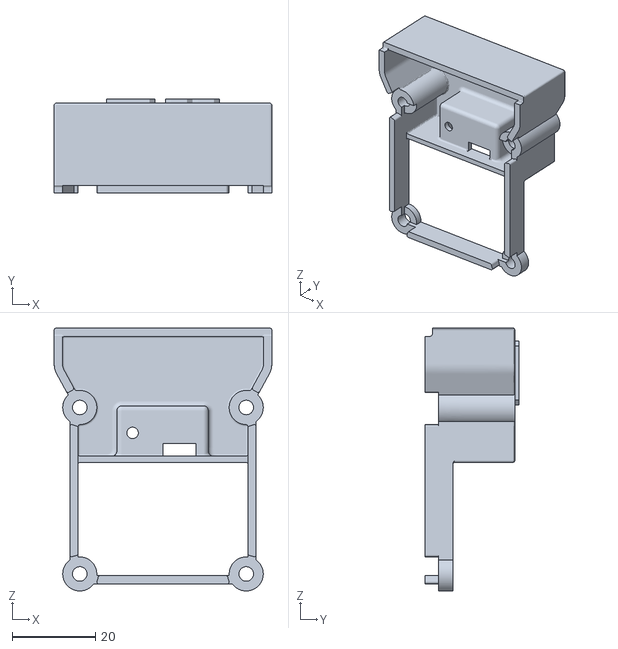
[picture p22: CAD file, 2025-01-15]
Misc/BatteryEnclosure/Cover.stl
52.3 x 22.6 x 63.2
