BlockWorker/ModularAudio/Misc/PanelDBlank.step

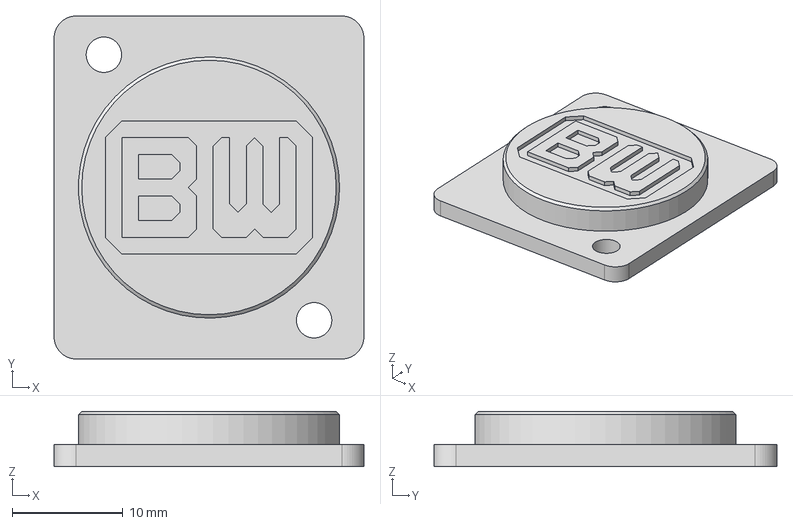
[picture p23: CAD file, 2025-08-03]
Misc/PanelDBlank.step
28.0 x 31.0 x 5.00 mm
