BlockWorker/ModularAudio/Misc/BatteryEnclosure/Shell.stl

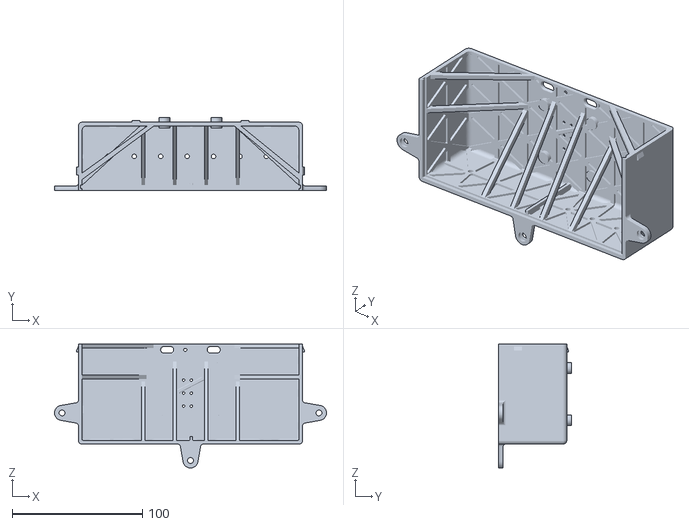
[picture p24: CAD file, 2025-01-15]
Misc/BatteryEnclosure/Shell.stl
209.0 x 55.9 x 95.2
