BlockWorker/ModularAudio/Misc/ToslinkBlank.step

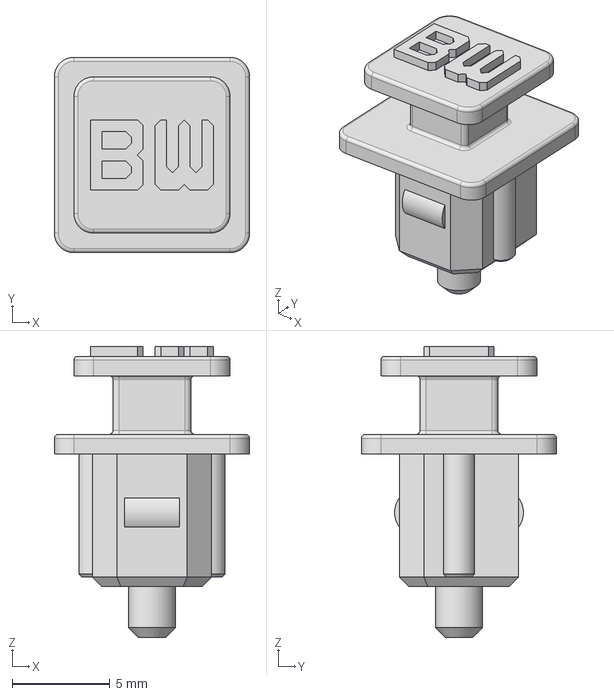
[picture p25: CAD file, 2025-08-03]
Misc/ToslinkBlank.step
10.0 x 10.0 x 14.9 mm
