BlockWorker/ModularAudio/Misc/PanelSmallBlank.step

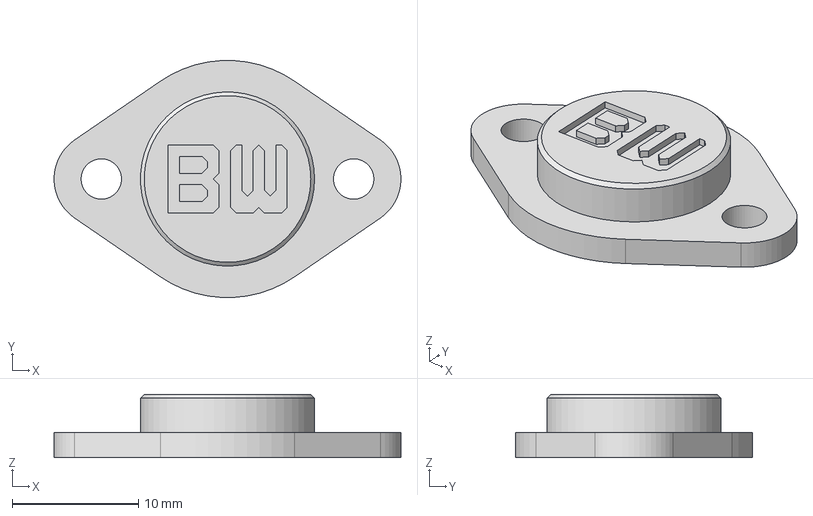
[picture p26: CAD file, 2025-08-03]
Misc/PanelSmallBlank.step
27.5 x 18.8 x 5.00 mm
