BlockWorker/ModularAudio/Misc/Baseplate 5x3 6mm flat.step

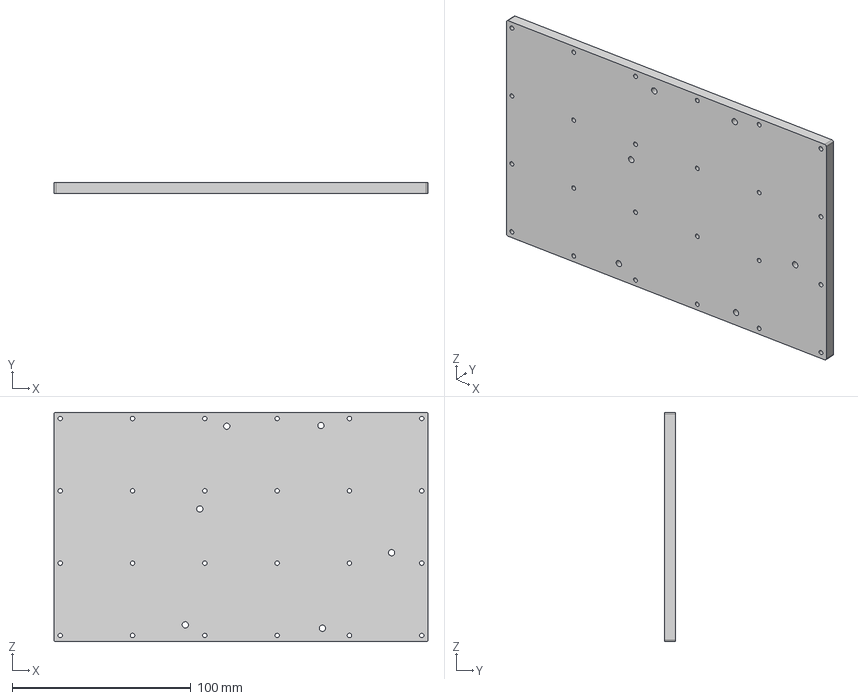
[picture p27: CAD file, 2024-10-09]
Misc/Baseplate 5x3 6mm flat.step
209.5 x 6.00 x 128.5 mm
