BlockWorker/ModularAudio/Misc/Baseplate 5x3 3mm.step

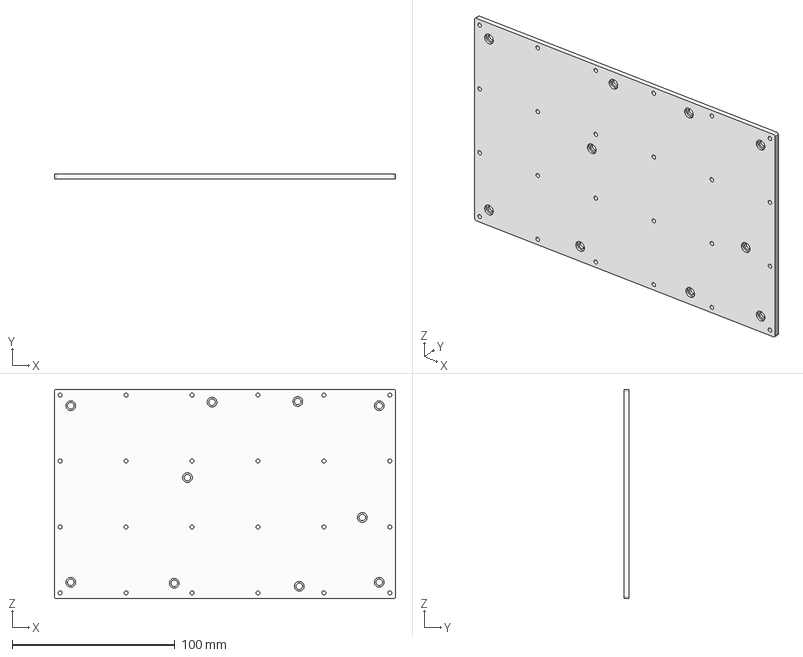
[picture p28: CAD file, 2024-10-09]
Misc/Baseplate 5x3 3mm.step
209.5 x 3.00 x 128.5 mm
