BlockWorker/ModularAudio/Misc/Baseplate 5x3 6mm light.step

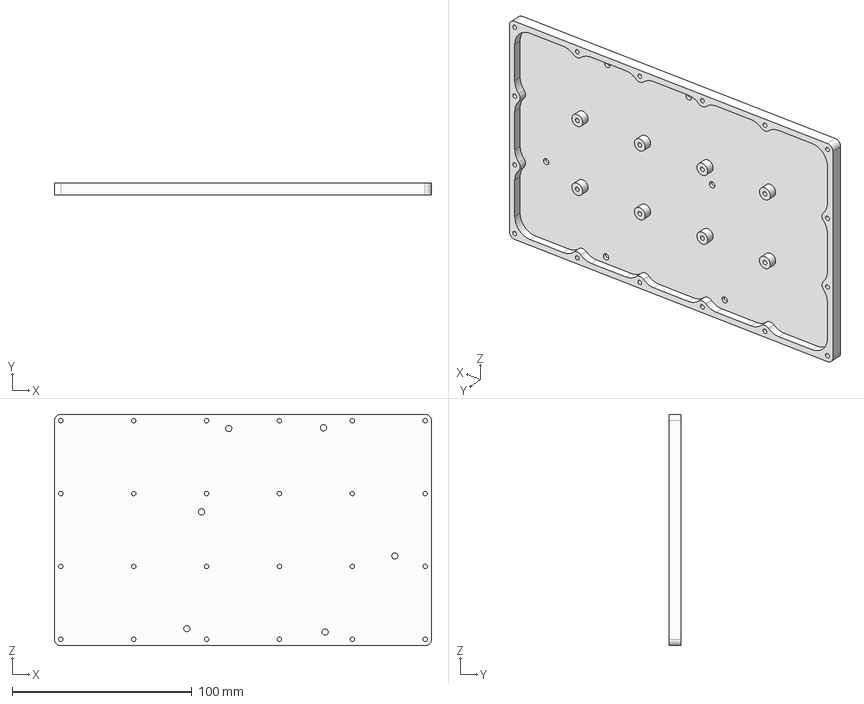
[picture p29: CAD file, 2024-10-09]
Misc/Baseplate 5x3 6mm light.step
209.5 x 6.50 x 128.5 mm
