BlockWorker/ModularAudio/Misc/Washers.stl

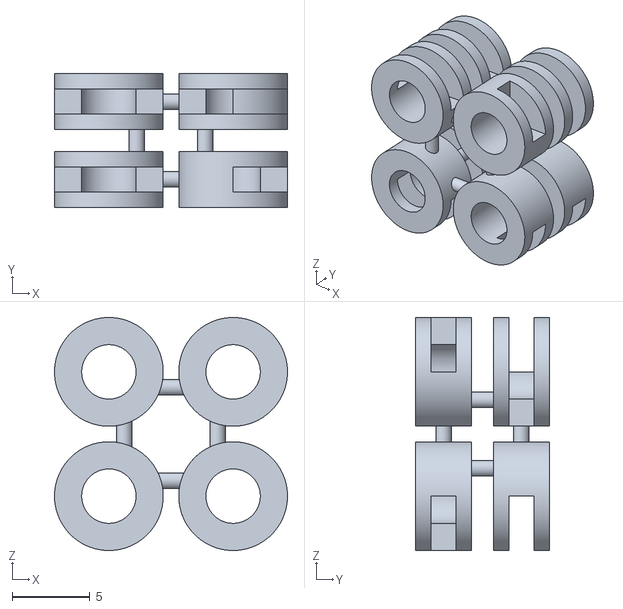
[picture p30: CAD file, 2025-01-07]
Misc/Washers.stl
15.0 x 8.60 x 15.0
