BlockWorker/ModularAudio/(list of files, cad)

Other CAD files:
Misc/PanelLaserMarking.dxf
