BlockWorker/ModularAudio/BatteryMonitor/current_calibration_measurements.txt

296.2 mA: CC1=45.25 CC2=11560
591.2 mA: CC1=90.08 CC2=23070
841.0 mA: CC1=128.1 CC2=32750
1388 mA: CC1=211.3 CC2=54090

CC1/I ~= 0.1521
I/CC1 ~= 6.575
32*I/CC1 ~= 210.4

CC2/I ~= 38.95
I/CC2 ~= 0.02568
8192*I/CC2 ~= 210.3
8192*I/CC2/2 ~= 105.2

stddev: CC1 ~= 0.5 (4µV=4mA); CC2 ~= 170 (5µV=5mA)

-----------------------------------------------------------------------

296.2 mA - CC1=45.25 CC2=11560
------------------------------
Mode: Normal, Sealed: 0, Alerts: 0x0000, Faults: 0x0000
FETs enabled: 1, FET state: DSG 1 CHG 1
Cell voltages: 3886 3895 3895 3863 3891, Stack voltage: 15531, Current: -346
Temps: Bat 26 Int 28, Charge: -78423, Time: 1161
CC1 CAL: mean = -45.25; stddev = 0.47
CC2 CAL: mean = -11604.13; stddev = 191.61; lt_mean = -7047.63
CC1 CAL: mean = -45.25; stddev = 0.46
CC2 CAL: mean = -11616.83; stddev = 185.18; lt_mean = -7056.95
------------------------------
Mode: Normal, Sealed: 0, Alerts: 0x0000, Faults: 0x0000
FETs enabled: 1, FET state: DSG 1 CHG 1
Cell voltages: 3886 3895 3895 3863 3891, Stack voltage: 15530, Current: -354
Temps: Bat 26 Int 28, Charge: -78785, Time: 1169
CC1 CAL: mean = -45.25; stddev = 0.46
CC2 CAL: mean = -11603.50; stddev = 183.18; lt_mean = -7065.84
CC1 CAL: mean = -45.25; stddev = 0.46
CC2 CAL: mean = -11600.67; stddev = 180.24; lt_mean = -7074.85
------------------------------
Mode: Normal, Sealed: 0, Alerts: 0x0000, Faults: 0x0000
FETs enabled: 1, FET state: DSG 1 CHG 1
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
CC2 CAL: mean = -54102.40; stddev = 165.74; lt_mean = -15723.69
------------------------------
Mode: Normal, Sealed: 0, Alerts: 0x0000, Faults: 0x0000
FETs enabled: 1, FET state: DSG 1 CHG 1
Cell voltages: 3829 3862 3863 3753 3884, Stack voltage: 15298, Current: -1594
Temps: Bat 28 Int 28, Charge: -151141, Time: 710
CC1 CAL: mean = -211.31; stddev = 0.52
CC2 CAL: mean = -54104.72; stddev = 164.06; lt_mean = -15800.43
CC1 CAL: mean = -211.31; stddev = 0.51
CC2 CAL: mean = -54103.82; stddev = 163.33; lt_mean = -15876.96
------------------------------
Mode: Normal, Sealed: 0, Alerts: 0x0000, Faults: 0x0000
FETs enabled: 1, FET state: DSG 1 CHG 1
Cell voltages: 3829 3862 3863 3753 3884, Stack voltage: 15300, Current: -1598
Temps: Bat 28 Int 28, Charge: -153043, Time: 719
CC1 CAL: mean = -211.30; stddev = 0.51
CC2 CAL: mean = -54090.44; stddev = 158.04; lt_mean = -15953.13
CC1 CAL: mean = -211.29; stddev = 0.50
CC2 CAL: mean = -54068.08; stddev = 181.63; lt_mean = -16028.96
