BlockWorker/ModularAudio/Misc/Panel Drawing.pdf

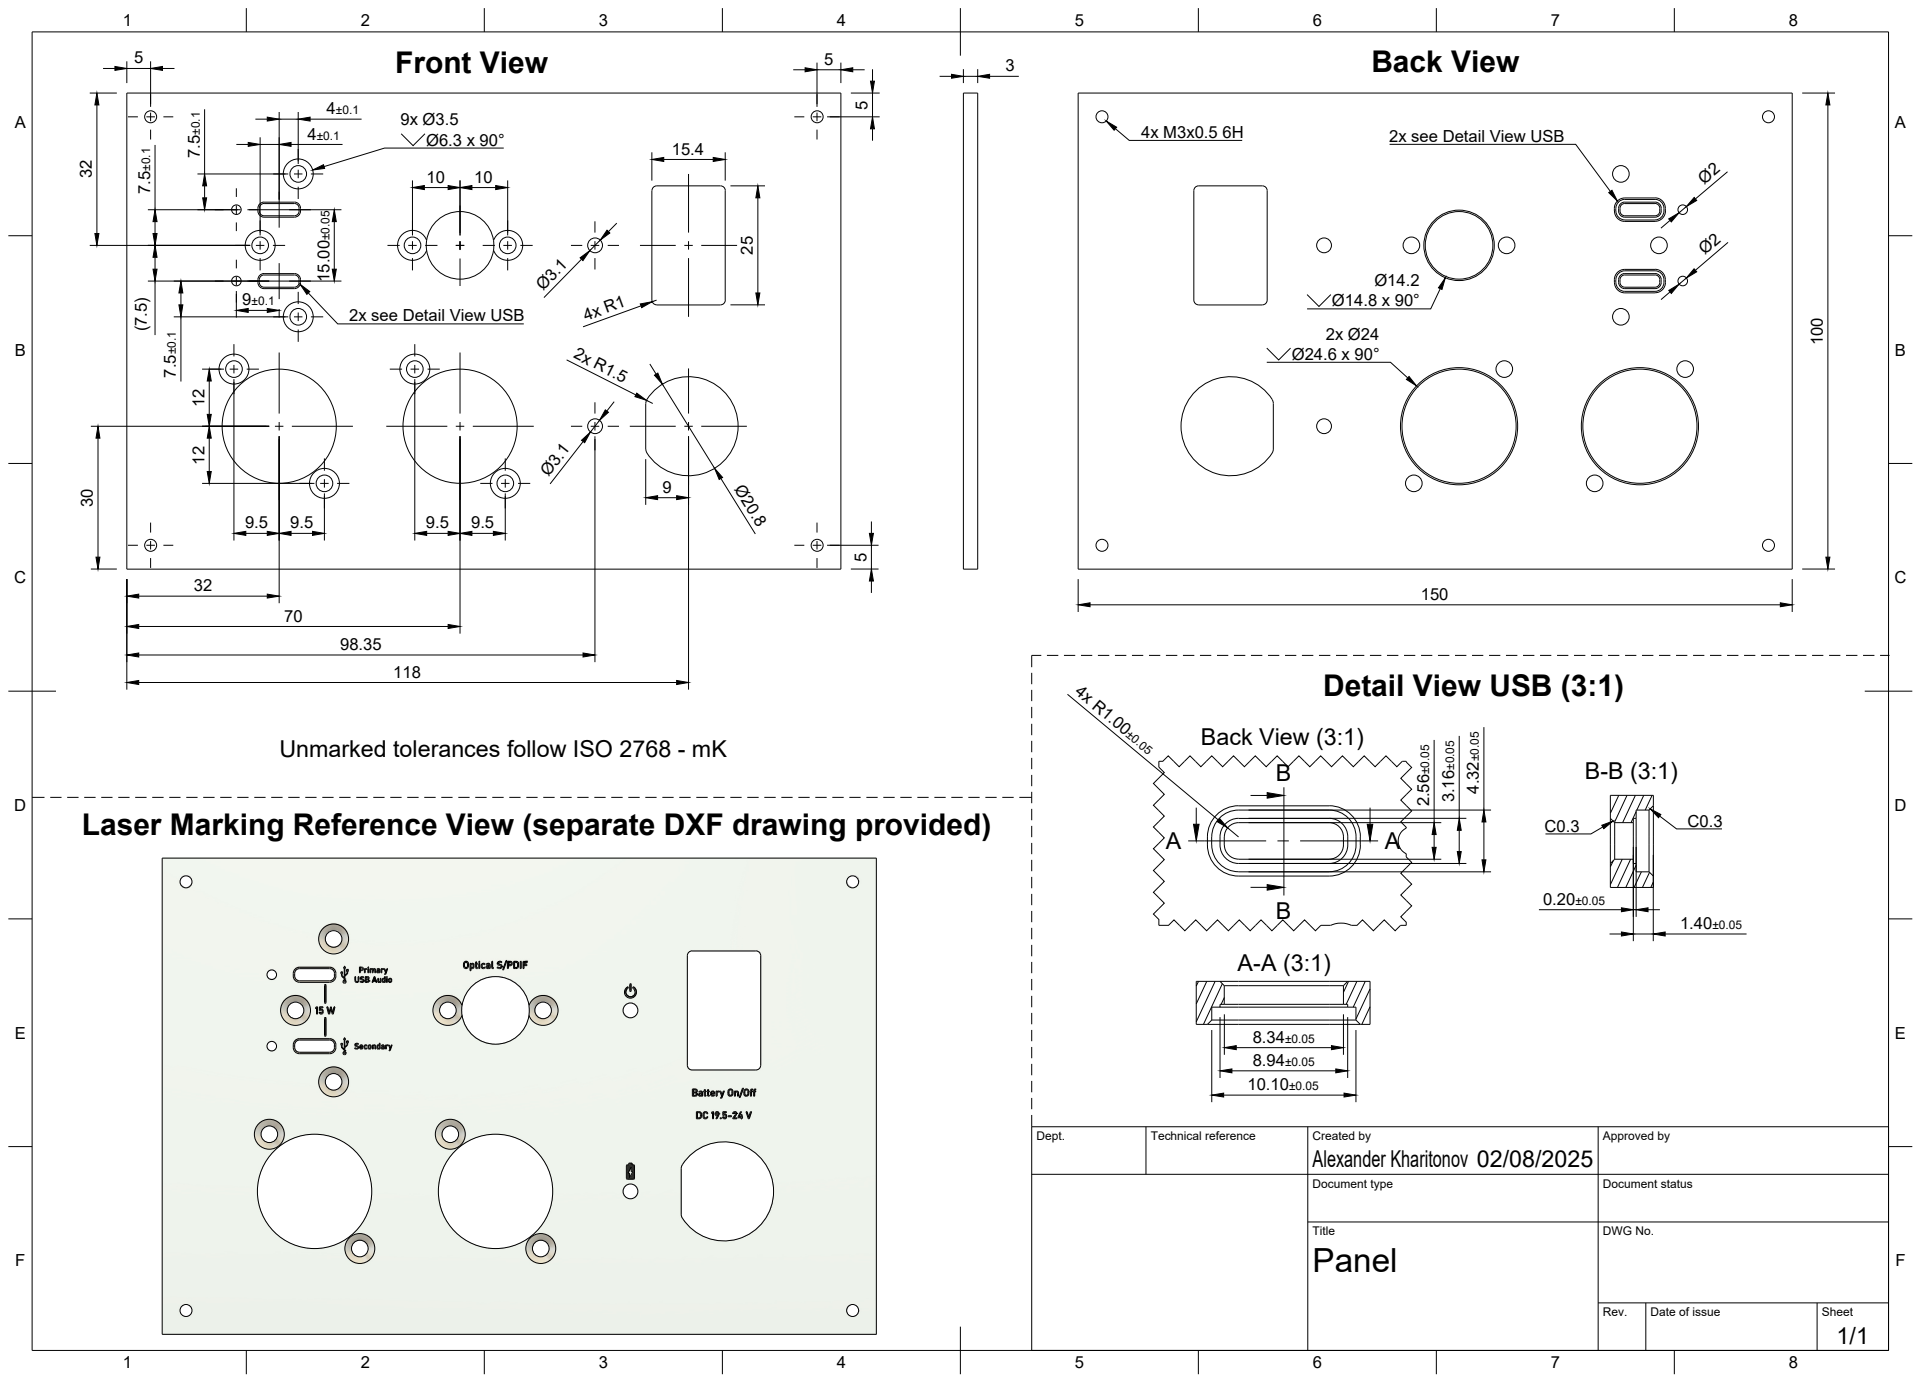
[picture p31: page 1]
Back View (3:1); Front View; Back View

2x see Detail View USB

Unmarked tolerances follow ISO 2768 - mK 15.00±0.05

Detail View USB (3:1)

Laser Marking Reference View (separate DXF drawing provided)

Dept. | Technical reference | Created by Alexander Kharitonov 02/08/2025 | Approved by

Document type | Document status

Title Panel | DWG No.

Rev. | Date of issue | Sheet 1/1
