BlockWorker/ModularAudio/Misc/Baseplate 5x3 3mm.pdf

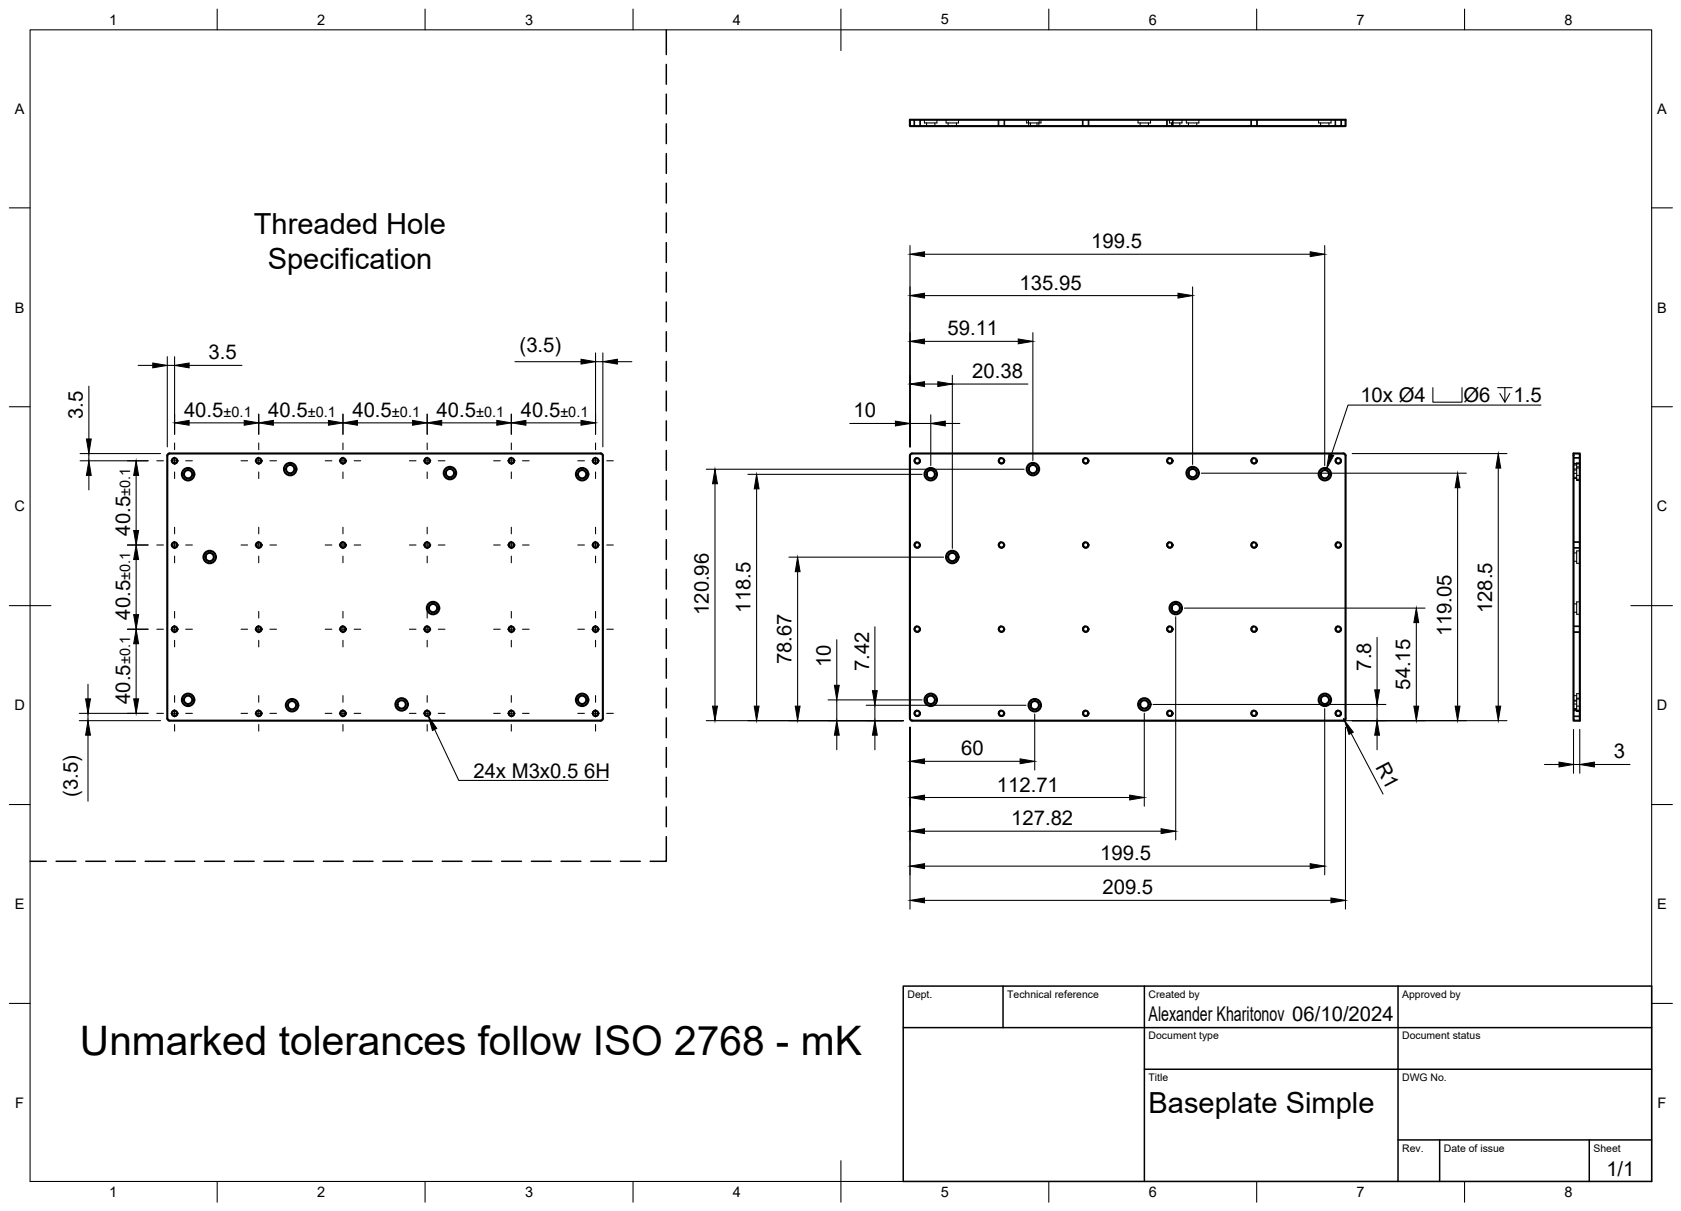
[picture p32: page 1]
Title; DWG No.; Rev.; Date of issue; Sheet; Baseplate Simple; Threaded Hole

Dept. | Technical reference | Created by Alexander Kharitonov 06/10/2024 | Approved by

Unmarked tolerances follow ISO 2768 - mK

Document type | Document status
