BlockWorker/ModularAudio/Misc/Baseplate 5x3 6mm flat.pdf

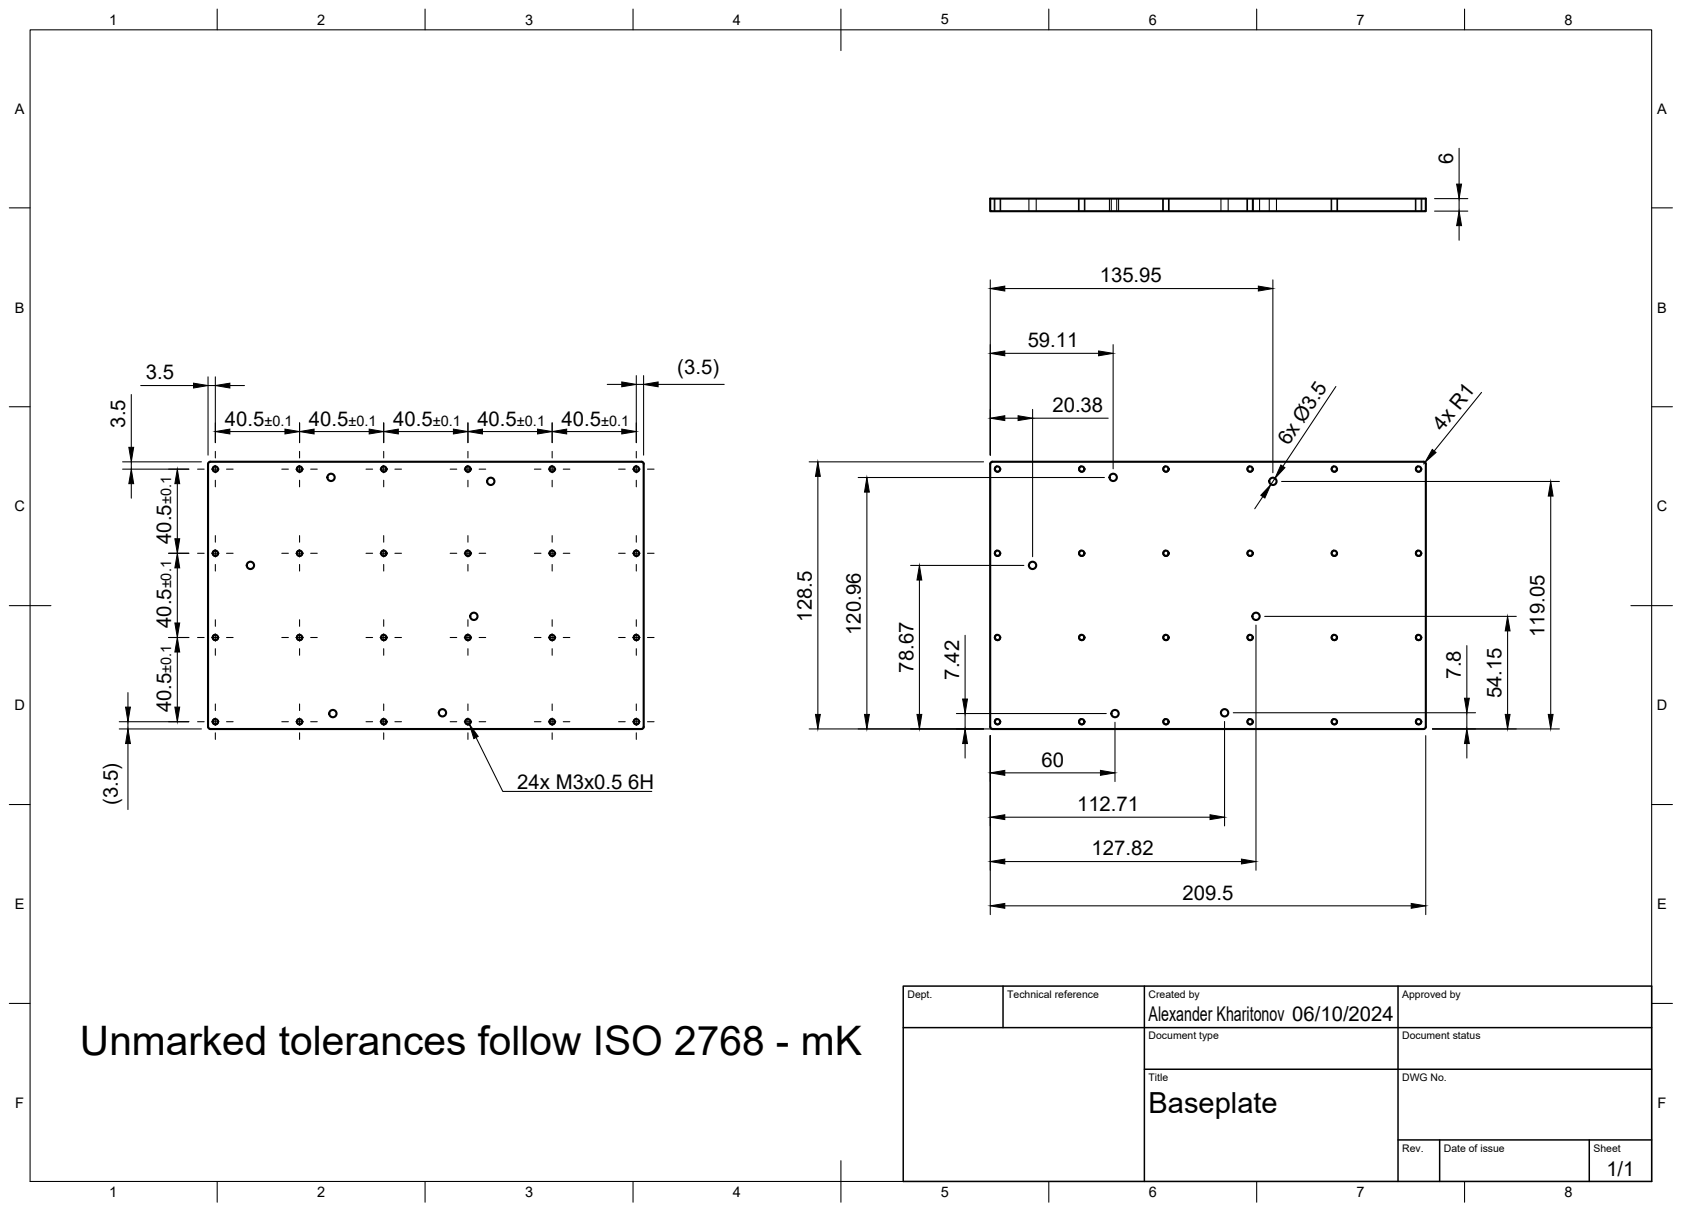
[picture p33: page 1]
Title; DWG No.; Rev.; Date of issue; Sheet; Unmarked tolerances follow ISO 2768 - mK

Dept. | Technical reference | Created by Alexander Kharitonov 06/10/2024 | Approved by

Document type | Document status
