BlockWorker/ModularAudio/Misc/Baseplate 5x3 6mm light.pdf

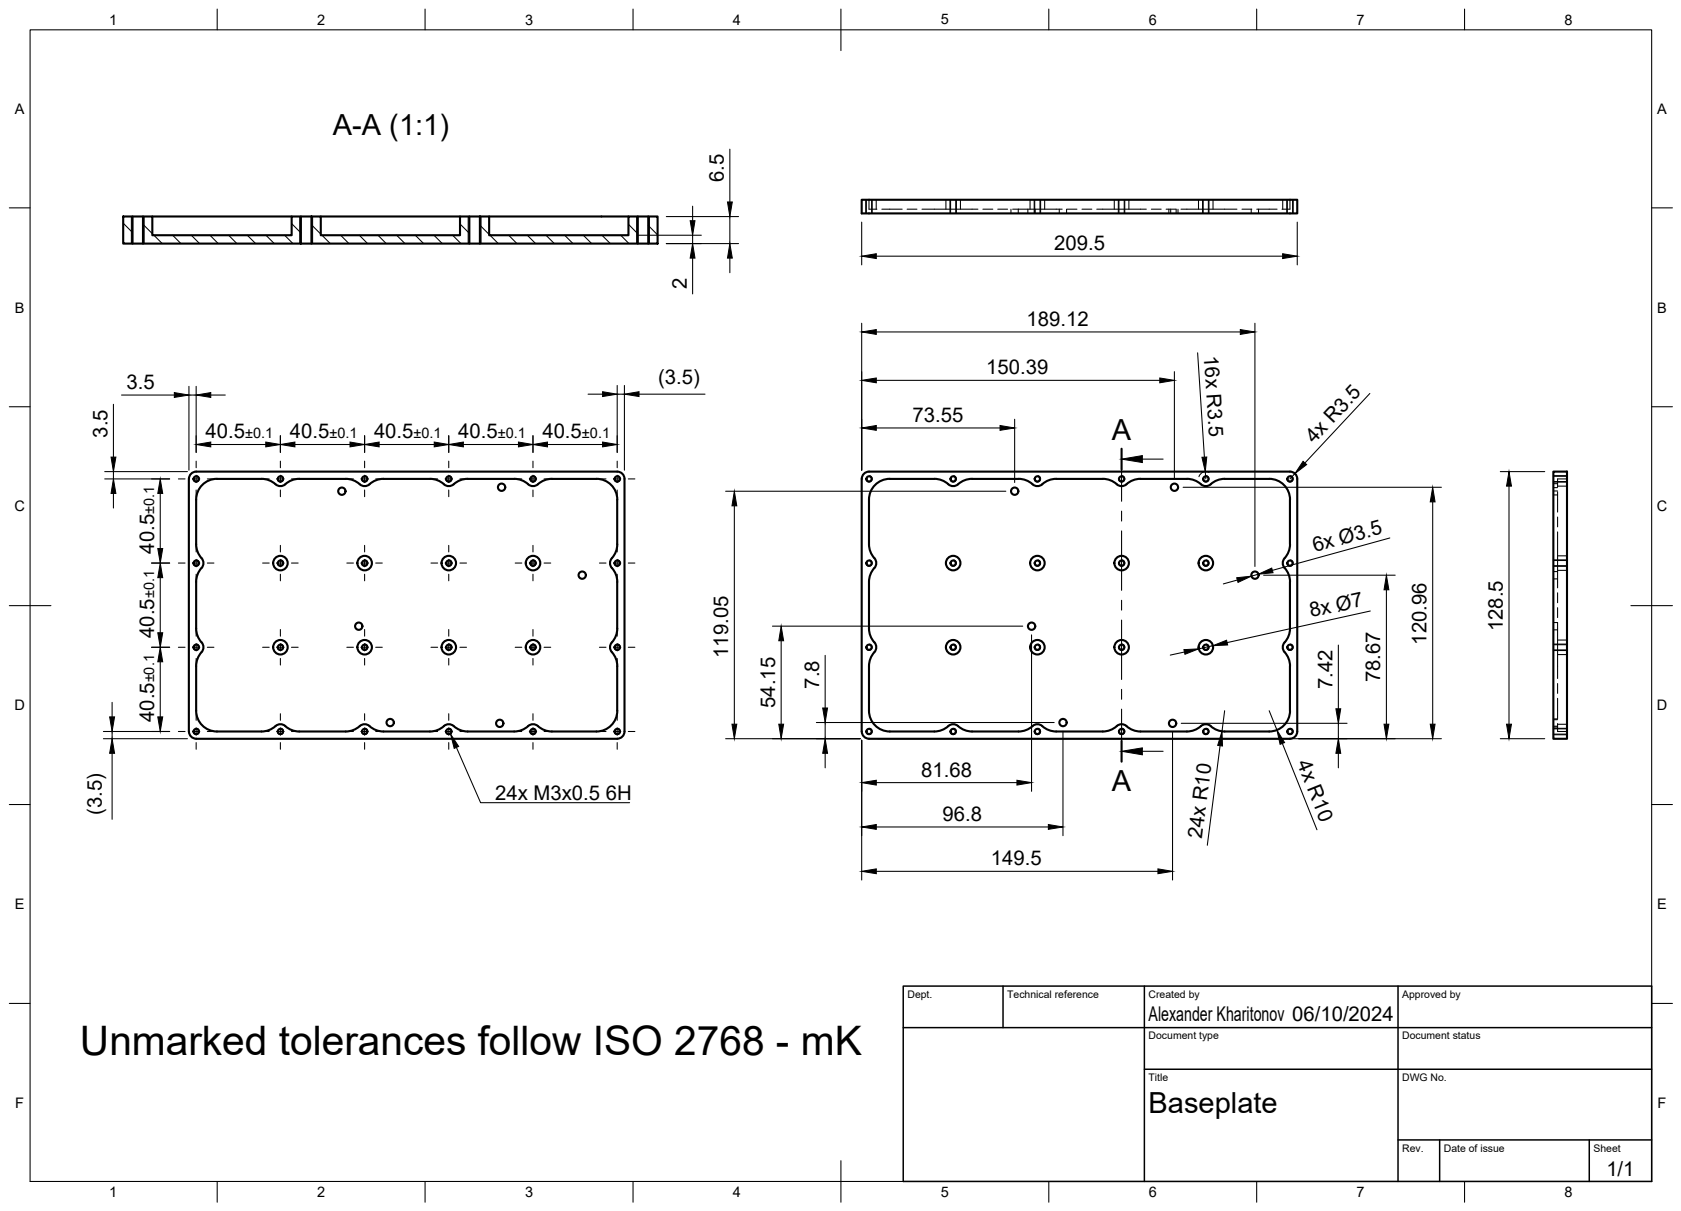
[picture p34: page 1]
Title; DWG No.; Rev.; Date of issue; Sheet

Dept. | Technical reference | Created by Alexander Kharitonov 06/10/2024 | Approved by

Unmarked tolerances follow ISO 2768 - mK

Document type | Document status
