BlockWorker/ModularAudio/design_simulations/PowerAmpSupply inrush limit/InrushLimit_slower.asc

C1: cap; 1µ; Rser=1m
C2: cap; 10µ; Rser=1m
C3: cap; 4.7µ; V=6.3 Rser=1m
C4: cap; 1m; Rser=18m
C5: cap; 0.1µ
C6: cap; 20µ; Rser=1m
C7: cap; 3m; Rser=6m
C8: cap; 100n; Rser=10m
C9: cap; 0.1µ; Rser=10m
C10: cap; 2m; Rser=10m
D1: zener; BZX84C12L
D2: schottky; 1N5819
D3: schottky; RBR40NS40A
L1: ind; 50n; Rser=290u
L2: ind; 1.5µ; Rser=2.3m
L3: ind; 100n; Rser=10m
M1: nmos; IPT004N03L
M2: nmos; IPT004N03L
M3: nmos; 2N7002
M4: nmos; 2N7002
M5: nmos; IPT004N03L
R1: res; 1.2Meg
R2: res; 100k
R3: res; 10k
R4: res; 1
R5: res; 510k
R6: res; 30k
R7: res; 100
R8: res; 10m
R9: res; 100
R10: res; 7.5k
R11: res; 2k
U2: LTC3290
V1: voltage; 12; Rser=10m
V2: voltage; PULSE(0 12 17m 1u 1u 10m 40m)
V3: voltage; 3.6
V4: voltage; PULSE(0 12 100u 1u 1u 20m 40m)
Named nets: CPOUT, 0, OUT, GATE, PGOOD, IN, EN
.tran 70m startup
