BlockWorker/ModularAudio/design_simulations/lm5123sim/LM5123-Q1_PSPICE_TRANS/LM5123-Q1_PSPICE_TRANS-PSpiceFiles/LM5123-Q1_STARTUP/trans/trans.cir

** Profile: "LM5123-Q1_STARTUP-trans"  [ e:\users\alex\documents\electronics projects\modular audio\design_simulations\lm5123sim\lm5123-q1_pspice_trans\lm5123-q1_pspice_trans-pspicefiles\lm5123-q1_startup\trans.sim ] 

** Creating circuit file "trans.cir" 
** WARNING: THIS AUTOMATICALLY GENERATED FILE MAY BE OVERWRITTEN BY SUBSEQUENT SIMULATIONS

*Libraries: 
* Profile Libraries :
* Local Libraries :
.LIB "../../../lm5123-q1_trans.lib" 
* From [PSPICE NETLIST] section of C:\cds_spb_home\cdssetup\OrCAD_PSpiceTIPSpice_Install\23.1.0\PSpice.ini file:
.lib "nom_pspti.lib" 
.lib "nom.lib" 

*Analysis directives: 
.TRAN  0 6m 0 20n 
.OPTIONS ADVCONV
.OPTIONS FILEMODELSEARCH
.OPTIONS ITL4= 50
.PROBE64 V(*) I(*) 
.INC "..\LM5123-Q1_STARTUP.net" 


.END
