BlockWorker/ModularAudio/(list of files, drawings)

Other design files:
design_simulations/lm5123sim/LM5123-Q1_PSPICE_AVG-orig/LM5123-Q1_AVG.OLB
design_simulations/lm5123sim/LM5123-Q1_PSPICE_AVG-orig/LM5123-Q1_PSPICE_AVG.opj
design_simulations/lm5123sim/LM5123-Q1_PSPICE_AVG/LM5123-Q1_AVG.OLB
design_simulations/lm5123sim/LM5123-Q1_PSPICE_AVG/LM5123-Q1_PSPICE_AVG.opj
design_simulations/lm5123sim/LM5123-Q1_PSPICE_TRANS-orig/LM5123-Q1_PSPICE_TRANS.opj
design_simulations/lm5123sim/LM5123-Q1_PSPICE_TRANS-orig/LM5123-Q1_TRANS.OLB
design_simulations/lm5123sim/LM5123-Q1_PSPICE_TRANS/LM5123-Q1_PSPICE_TRANS.opj
design_simulations/lm5123sim/LM5123-Q1_PSPICE_TRANS/LM5123-Q1_TRANS.OLB
design_simulations/lm25576/LM25576_PSPICE_AVG - orig/LM25576_AVG.OLB
design_simulations/lm25576/LM25576_PSPICE_AVG - orig/LM25576_AVG.opj
design_simulations/lm25576/LM25576_PSPICE_AVG/LM25576_AVG.OLB
design_simulations/lm25576/LM25576_PSPICE_AVG/LM25576_AVG.opj
design_simulations/lm25576/LM25576_PSPICE_TRANS - orig/LM25576_TRANS.OLB
design_simulations/lm25576/LM25576_PSPICE_TRANS - orig/LM25576_TRANS.OPJ
design_simulations/lm25576/LM25576_PSPICE_TRANS/LM25576_TRANS.OLB
design_simulations/lm25576/LM25576_PSPICE_TRANS/LM25576_TRANS.OPJ
design_simulations/lm25576/TPS7A3001_PSPICE_TRANS - orig/TPS7A3001_TRANS.OLB
design_simulations/lm25576/TPS7A3001_PSPICE_TRANS - orig/TPS7A3001_TRANS.opj
design_simulations/lm25576/TPS7A3001_PSPICE_TRANS/TPS7A3001_TRANS.OLB
design_simulations/lm25576/TPS7A3001_PSPICE_TRANS/TPS7A3001_TRANS.opj
design_simulations/lm54406F/LMR54406F_PSPICE_TRANS - orig/LMR54406F_TRANS.OPJ
design_simulations/lm54406F/LMR54406F_PSPICE_TRANS - orig/LMR54406FDBV_TRANS.OLB
design_simulations/lm54406F/LMR54406F_PSPICE_TRANS/LMR54406F_TRANS.OPJ
design_simulations/lm54406F/LMR54406F_PSPICE_TRANS/LMR54406FDBV_TRANS.OLB
design_simulations/lm54406F/TPS7A4700_PSPICE_TRANS - orig/TPS7A4700_TRANS.OLB
design_simulations/lm54406F/TPS7A4700_PSPICE_TRANS - orig/TPS7A4700_TRANS.opj
design_simulations/lm54406F/TPS7A4700_PSPICE_TRANS/TPS7A4700_TRANS.OLB
design_simulations/lm54406F/TPS7A4700_PSPICE_TRANS/TPS7A4700_TRANS.opj
design_simulations/TPS552892/TPS552892_Encrypted/GENERIC_BLOCKS.OLB
design_simulations/TPS552892/TPS552892_Encrypted/TPS552892.OLB
design_simulations/TPS552892/TPS552892_Encrypted/TPS552892.opj
