BlockWorker/ModularAudio/PowerAmpSupply/PowerAmpSupply.kicad_pcb

## KiCad design PowerAmpSupply/PowerAmpSupply.kicad_pcb (2025-08-31)

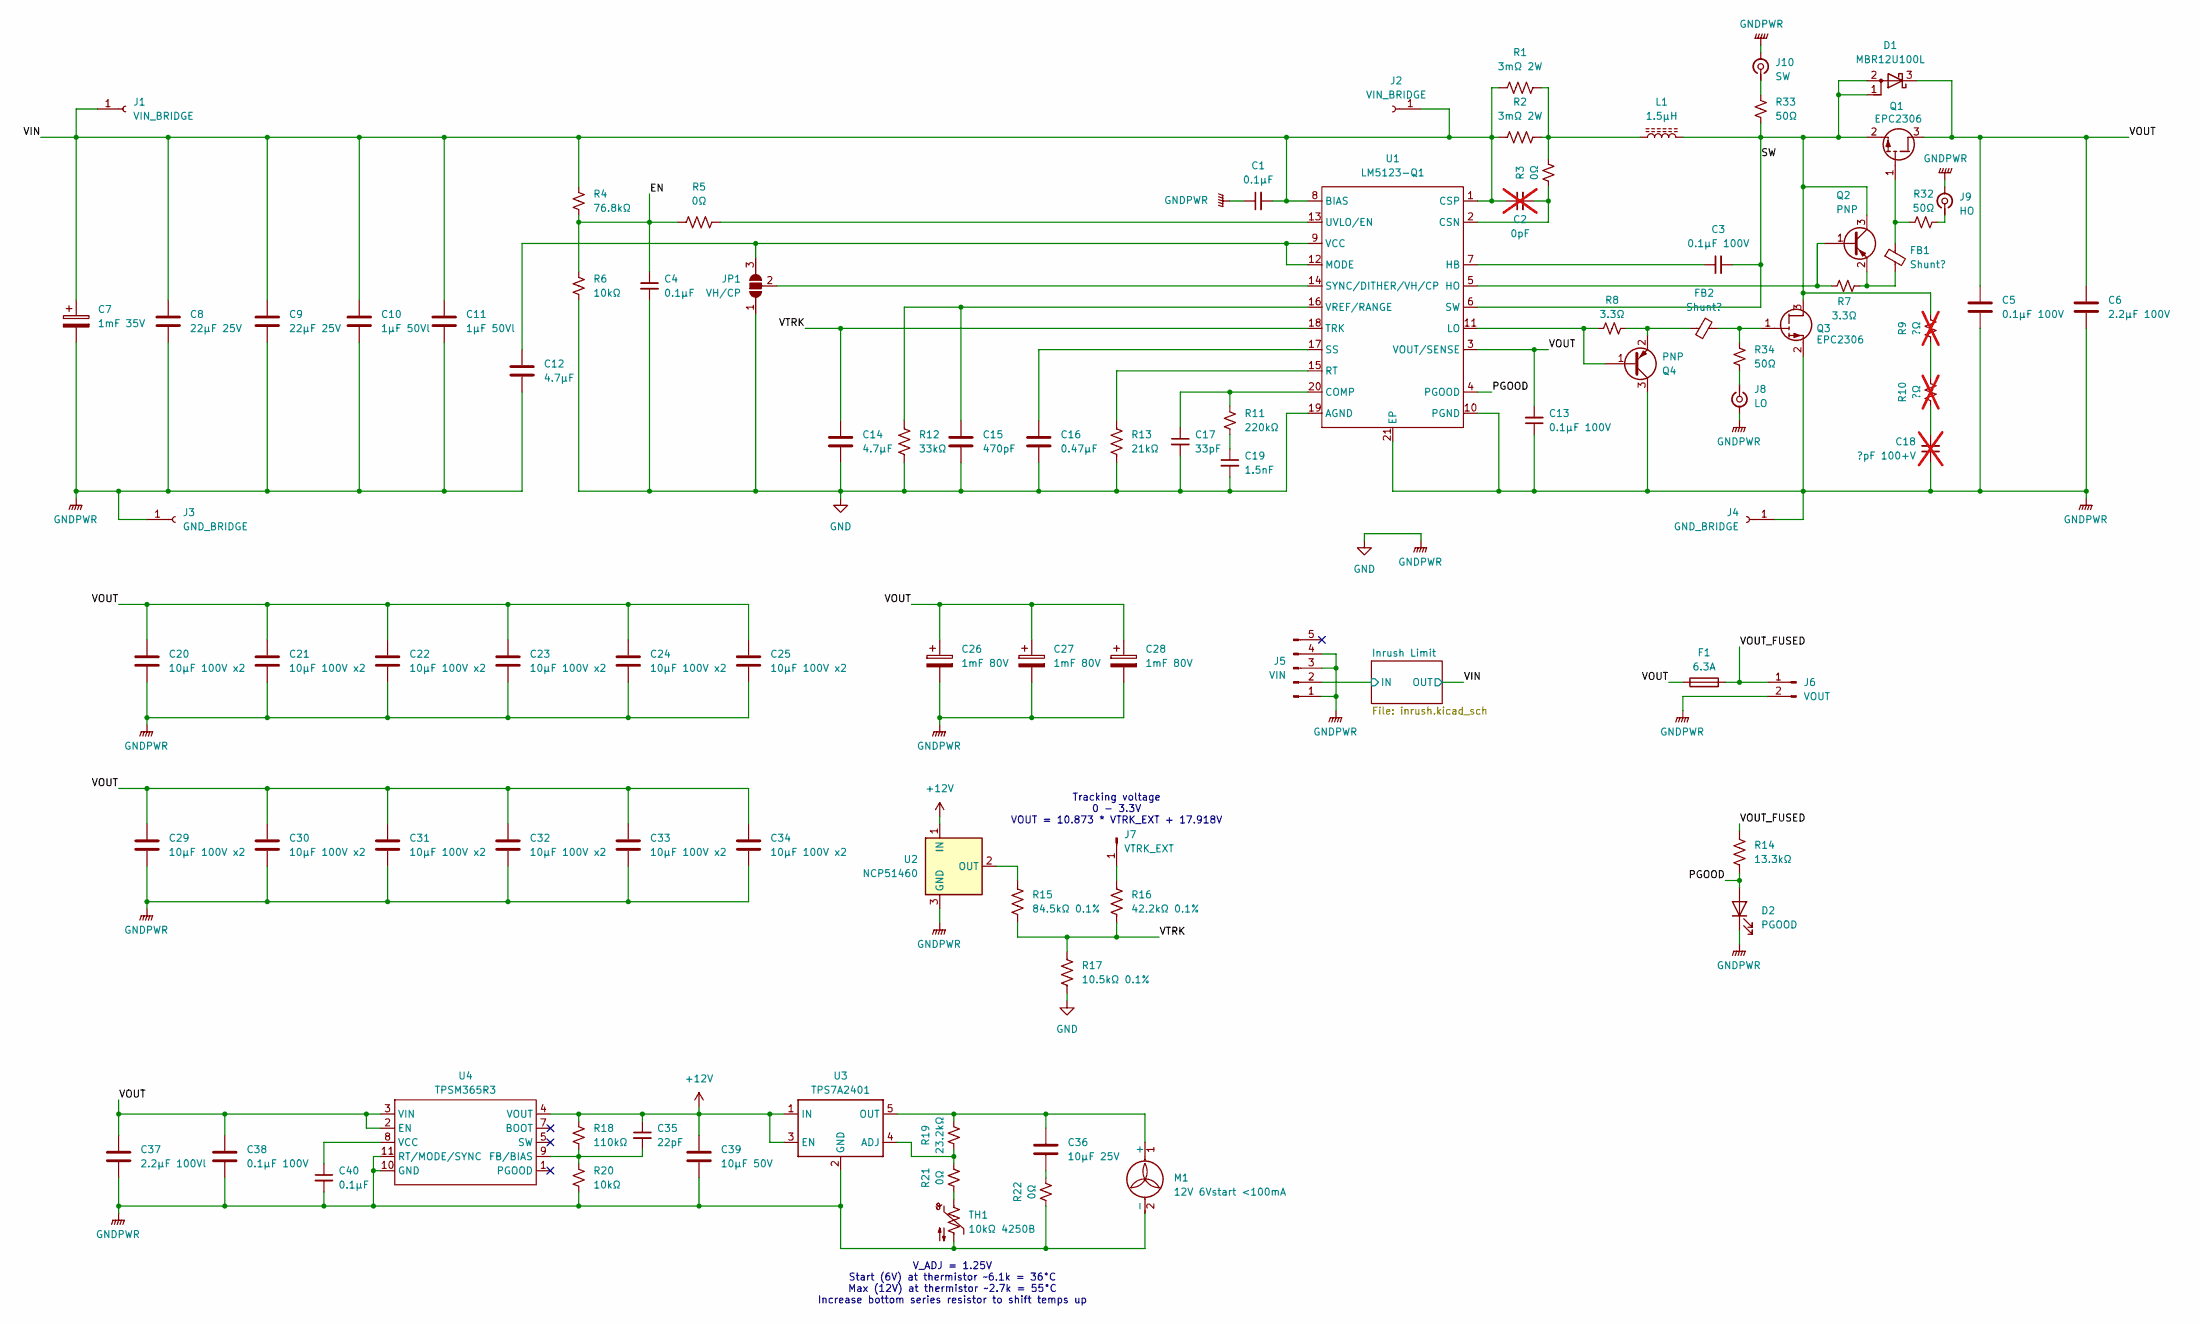
[picture p35: schematic PowerAmpSupply.kicad_sch]

Parts:
C1, C4, C40: 0.1µF; C_0603_1608Metric
C2: 0pF; C_0603_1608Metric; not fitted
C3, C5, C13, C38: 0.1µF 100V; C_0603_1608Metric
C6: 2.2µF 100V; C_0805_2012Metric
C7: 1mF 35V; CP_Radial_D10.0mm_P5.00mm
C8, C9: 22µF 25V; C_1210_3225Metric
C10, C11: 1µF 50Vl; C_0805_2012Metric
C12, C14: 4.7µF; C_0603_1608Metric
C15: 470pF; C_0603_1608Metric
C16: 0.47µF; C_0603_1608Metric
C17: 33pF; C_0603_1608Metric
C18: ?pF 100+V; C_0603_1608Metric; not fitted
C19: 1.5nF; C_0603_1608Metric
C20, C21, C22, C23, C24, C25, C29, C30, C31, C32, C33, C34: 10µF 100V x2; C_1210_3225Metric
C26, C27, C28: 1mF 80V; CP_Radial_D16.0mm_P7.50mm
C35: 22pF; C_0603_1608Metric
C36: 10µF 25V; C_0805_2012Metric
C37: 2.2µF 100Vl; C_1206_3216Metric
C39: 10µF 50V; C_1206_3216Metric
D1: MBR12U100L; TO-277B
D2: PGOOD; LED_0805_2012Metric
F1: 6.3A; Fuse_Schurter_MSB
FB1, FB2: Shunt?; L_0402_1005Metric_Pad0.77x0.64mm_HandSolder
J1, J2: VIN_BRIDGE; HolePad_2.5mm_3.5mm
J3, J4: GND_BRIDGE; HolePad_2.5mm_3.5mm
J5: VIN; TE_2042274_Solder
J6: VOUT; TE_644749-2
J7: VTRK_EXT; PinHeader_1x01_P2.54mm_Vertical
J8: LO; TE_CONMHF1-SMD
J9: HO; TE_CONMHF1-SMD
J10: SW; TE_CONMHF1-SMD
JP1: VH/CP; SolderJumper-3_P1.3mm_Open_RoundedPad1.0x1.5mm
L1: 1.5µH; L_Vishay_IHLP-6767
M1: 12V 6Vstart <100mA; Amphenol_MINITEK_0.8_2P_V_BoardEdge
Q1, Q3: EPC2306
Q2, Q4: PNP; HUSON-3-1EP_2x2mm_P1.3mm_EP1.1x1.6mm
R1, R2: 3mΩ 2W; R_0612_1632Metric
R3, R5, R21, R22: 0Ω; R_0603_1608Metric
R4: 76.8kΩ; R_0603_1608Metric
R6, R20: 10kΩ; R_0603_1608Metric
R7, R8: 3.3Ω; R_0603_1608Metric
R9, R10: ?Ω; R_1206_3216Metric; not fitted
R11: 220kΩ; R_0603_1608Metric
R12: 33kΩ; R_0603_1608Metric
R13: 21kΩ; R_0603_1608Metric
R14: 13.3kΩ; R_0603_1608Metric
R15: 84.5kΩ 0.1%; R_0603_1608Metric
R16: 42.2kΩ 0.1%; R_0603_1608Metric
R17: 10.5kΩ 0.1%; R_0603_1608Metric
R18: 110kΩ; R_0603_1608Metric
R19: 23.2kΩ; R_0603_1608Metric
R32, R33, R34: 50Ω; R_0402_1005Metric_Pad0.72x0.64mm_HandSolder
TH1: 10kΩ 4250B; R_0402_1005Metric_Pad0.72x0.64mm_HandSolder
U1: LM5123-Q1; VQFN-20-1EP_3.5x3.5mm_P0.5mm_EP2.05x2.05mm
U2: NCP51460; SOT-23
U3: TPS7A2401; SOT-23-5
U4: TPSM365R3; TI_QFN-FCMOD-HR

Connections:
+12V: C35.1, C39.1, R18.1, U2.1 (IN), U3.1 (IN), U3.3 (EN), U4.4 (VOUT)
/EN: C4.1, R4.2, R5.1, R6.1
/Inrush Limit/IN: J5.2; also elsewhere on the board
/PGOOD: D2.2 (A), R14.2, U1.4 (PGOOD)
/SW: C3.2, D1.1 (A), D1.2 (A), L1.2, Q1.2 (S), Q1.4 (S), Q1.6 (S), Q2.3 (C), Q3.3 (D), Q3.5 (D), Q3.7 (D), R9.2, R33.2, U1.6 (SW)
/VIN: C1.2, C2.1, C7.1, C8.1, C9.1, C10.1, C11.1, J1.1, J2.1, R1.1, R2.1, R4.1, U1.1 (CSP), U1.8 (BIAS); also elsewhere on the board
/VOUT: C5.1, C6.1, C13.2, C20.1, C21.1, C22.1, C23.1, C24.1, C25.1, C26.1, C27.1, C28.1, C29.1, C30.1, C31.1, C32.1, C33.1, C34.1, C37.1, C38.1, D1.3 (K), F1.1, Q1.3 (D), Q1.5 (D), Q1.7 (D), U1.3 (VOUT/SENSE), U4.2 (EN), U4.3 (VIN)
/VOUT_FUSED: F1.2, J6.1, R14.1
/VTRK: C14.1, R15.2, R16.2, R17.1, U1.18 (TRK)
GND: C1.1, C4.2, C5.2, C6.2, C7.2, C8.2, C9.2, C10.2, C11.2, C12.2, C13.1, C14.2, C15.2, C16.2, C17.2, C18.1, C19.2, C20.2, C21.2, C22.2, C23.2, C24.2, C25.2, C26.2, C27.2, C28.2, C29.2, C30.2, C31.2, C32.2, C33.2, C34.2, C37.2, C38.2, C39.2, C40.2, D2.1 (K), J3.1, J4.1, J5.1, J5.3, J5.4, J6.2, J8.2 (Ext), J9.2 (Ext), J10.2 (Ext), JP1.1 (A), M1.2 (-), Q3.2 (S), Q3.4 (S), Q3.6 (S), Q4.3 (C), R6.2, R12.2, R13.2, R17.2, R20.2, R22.2, TH1.2, U1.10 (PGND), U1.19 (AGND), U1.21 (EP), U2.3 (GND), U3.2 (GND), U4.10 (GND), U4.11 (RT/MODE/SYNC); also elsewhere on the board
unnamed: C18.2, R10.1
unnamed: C19.1, R11.2
unnamed: C36.2, R22.1
unnamed: J7.1, R16.1
unnamed: J8.1 (In), R34.2
unnamed: J9.1 (In), R32.2
unnamed: J10.1 (In), R33.1
unnamed: C12.1, JP1.3 (B), U1.9 (VCC), U1.12 (MODE)
unnamed: JP1.2 (C), U1.14 (SYNC/DITHER/VH/CP)
unnamed: L1.1, R1.2, R2.2, R3.2
unnamed: C36.1, M1.1 (+), R19.1, U3.5 (OUT)
unnamed: FB1.1, Q1.1 (G), R32.1
unnamed: Q2.1 (B), R7.1, U1.5 (HO)
unnamed: FB1.2, Q2.2 (E), R7.2
unnamed: FB2.2, Q3.1 (G), R34.1
unnamed: Q4.1 (B), R8.1, U1.11 (LO)
unnamed: FB2.1, Q4.2 (E), R8.2
unnamed: R9.1, R10.2
unnamed: R21.2, TH1.1
unnamed: C17.1, R11.1, U1.20 (COMP)
unnamed: C2.2, R3.1, U1.2 (CSN)
unnamed: C3.1, U1.7 (HB)
unnamed: R13.1, U1.15 (RT)
unnamed: C16.1, U1.17 (SS)
unnamed: R5.2, U1.13 (UVLO/EN)
unnamed: C15.1, R12.1, U1.16 (VREF/RANGE)
unnamed: R15.1, U2.2 (OUT)
unnamed: R19.2, R21.1, U3.4 (ADJ)
unnamed: C35.2, R18.2, R20.1, U4.9 (FB/BIAS)
unnamed: C40.1, U4.8 (VCC)

Notes on the sheet:
V_ADJ = 1.25V Start (6V) at thermistor ~6.1k = 36°C Max (12V) at thermistor ~2.7k = 55°C Increase bottom series resistor to shift temps up
Tracking voltage 0 - 3.3V VOUT = 10.873 * VTRK_EXT + 17.918V

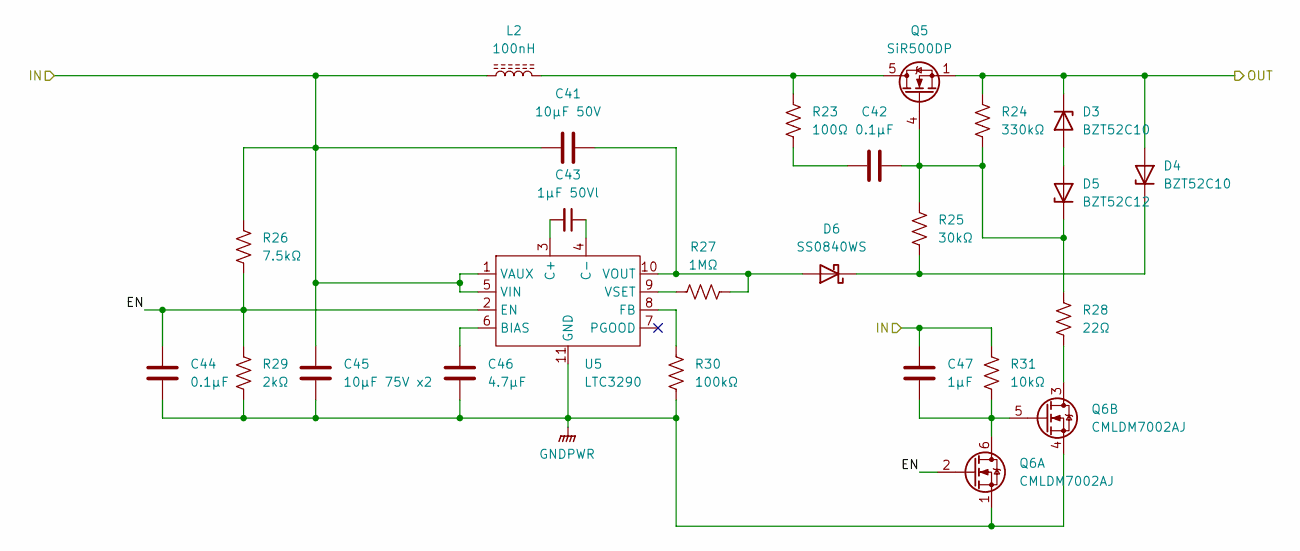
[picture p36: schematic inrush.kicad_sch]

Parts:
C41: 10µF 50V; C_1206_3216Metric
C42, C44: 0.1µF; C_0603_1608Metric
C43: 1µF 50Vl; C_0805_2012Metric
C45: 10µF 75V x2; C_1210_3225Metric
C46: 4.7µF; C_0603_1608Metric
C47: 1µF; C_0603_1608Metric
D3, D4: BZT52C10; D_SOD-123
D5: BZT52C12; D_SOD-123
D6: SS0840WS; D_SOD-323_HandSoldering
L2: 100nH; L_Pulse_PG2110HLT
Q5: SiR500DP; PowerPAK_SO-8_Single
Q6: CMLDM7002AJ; SOT-563
R23: 100Ω; R_0603_1608Metric
R24: 330kΩ; R_0603_1608Metric
R25: 30kΩ; R_0603_1608Metric
R26: 7.5kΩ; R_0603_1608Metric
R27: 1MΩ; R_0603_1608Metric
R28: 22Ω; R_0603_1608Metric
R29: 2kΩ; R_0603_1608Metric
R30: 100kΩ; R_0603_1608Metric
R31: 10kΩ; R_0603_1608Metric
U5: LTC3290; MSOP-10-1EP_3x3mm_P0.5mm_EP1.68x1.88mm

Connections:
/Inrush Limit/EN: C44.1, Q6.2 (G), R26.2, R29.1, U5.2 (EN)
/Inrush Limit/IN: C41.1, C45.1, C47.1, L2.1, R26.1, R31.1, U5.1 (VAUX), U5.5 (VIN); also elsewhere on the board
/VIN: D3.1 (K), D4.2 (A), Q5.1 (S), Q5.2 (S), Q5.3 (S), R24.1; also elsewhere on the board
GND: C44.2, C45.2, C46.2, Q6.1 (S), Q6.4 (S), R29.2, R30.2, U5.11 (GND); also elsewhere on the board
unnamed: C42.1, R23.2
unnamed: D3.2 (A), D5.2 (A)
unnamed: D4.1 (K), D6.1 (K), R25.2
unnamed: C42.2, D5.1 (K), Q5.4 (G), R24.2, R25.1, R28.1
unnamed: C41.2, D6.2 (A), R27.2, U5.10 (VOUT)
unnamed: L2.2, Q5.5 (D), R23.1
unnamed: C47.2, Q6.5 (G), Q6.6 (D), R31.2
unnamed: Q6.3 (D), R28.2
unnamed: C46.1, U5.6 (BIAS)
unnamed: C43.2, U5.3 (C+)
unnamed: C43.1, U5.4 (C-)
unnamed: R30.1, U5.8 (FB)
unnamed: R27.1, U5.9 (VSET)

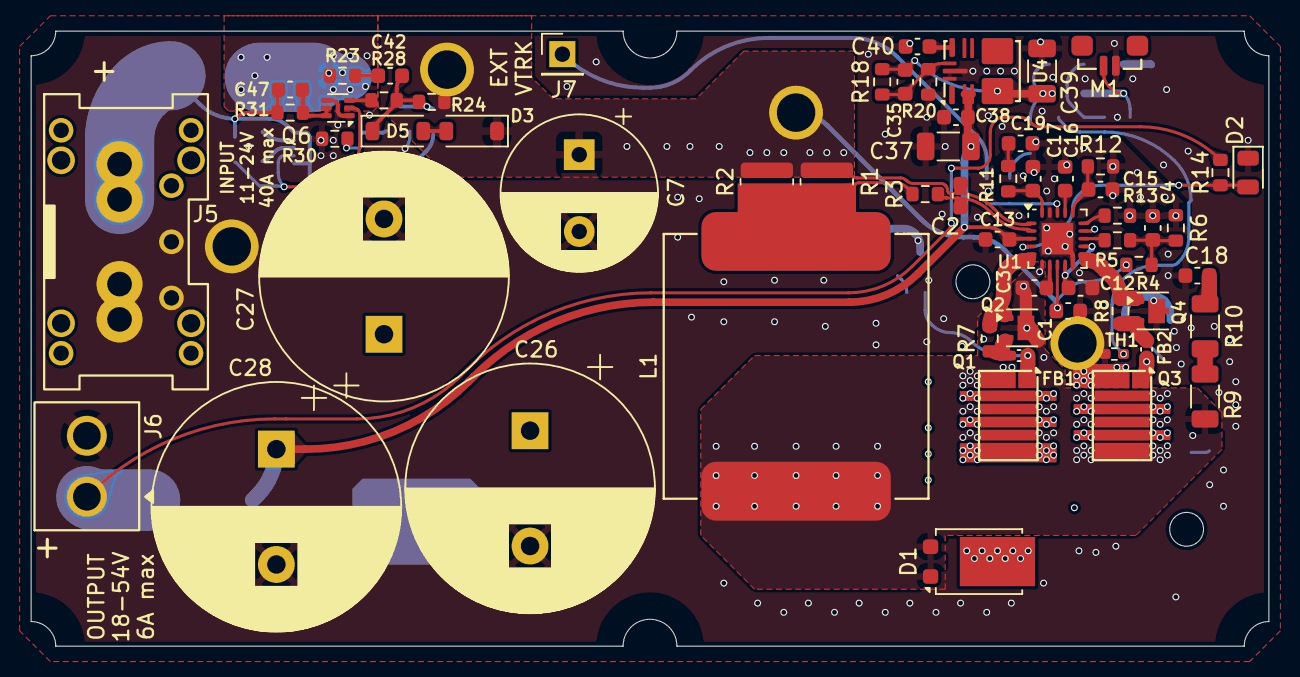
[picture p37: board PowerAmpSupply.kicad_pcb from above]

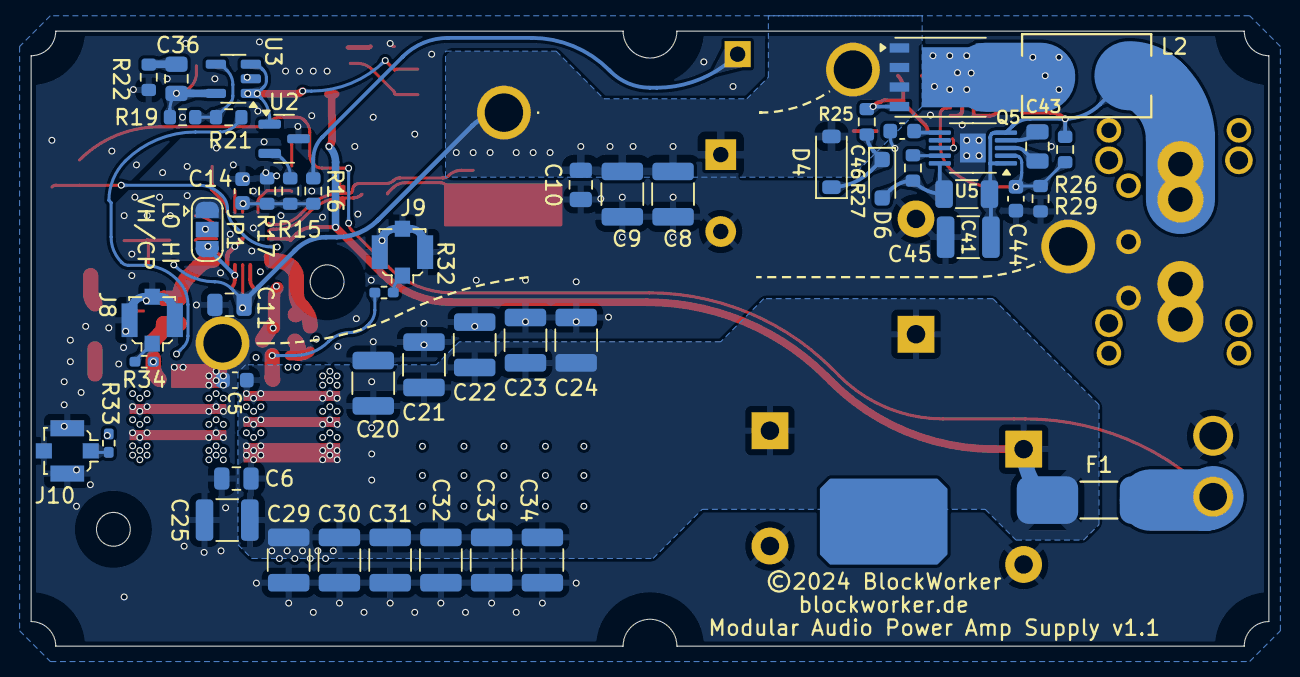
[picture p38: board PowerAmpSupply.kicad_pcb from below]

Board: 4 copper layers, 80.5 x 40.0 mm, 118 parts (51 on the bottom side), 54 nets.

Other parts of the board:
HS: ATS-xPX035035035_NoMounts
Logo: BW_Logo_7.5x4.8mm
