BlockWorker/ModularAudio/USBPanel/USBPanel.kicad_pcb

## KiCad design USBPanel/USBPanel.kicad_pcb (2025-08-23)

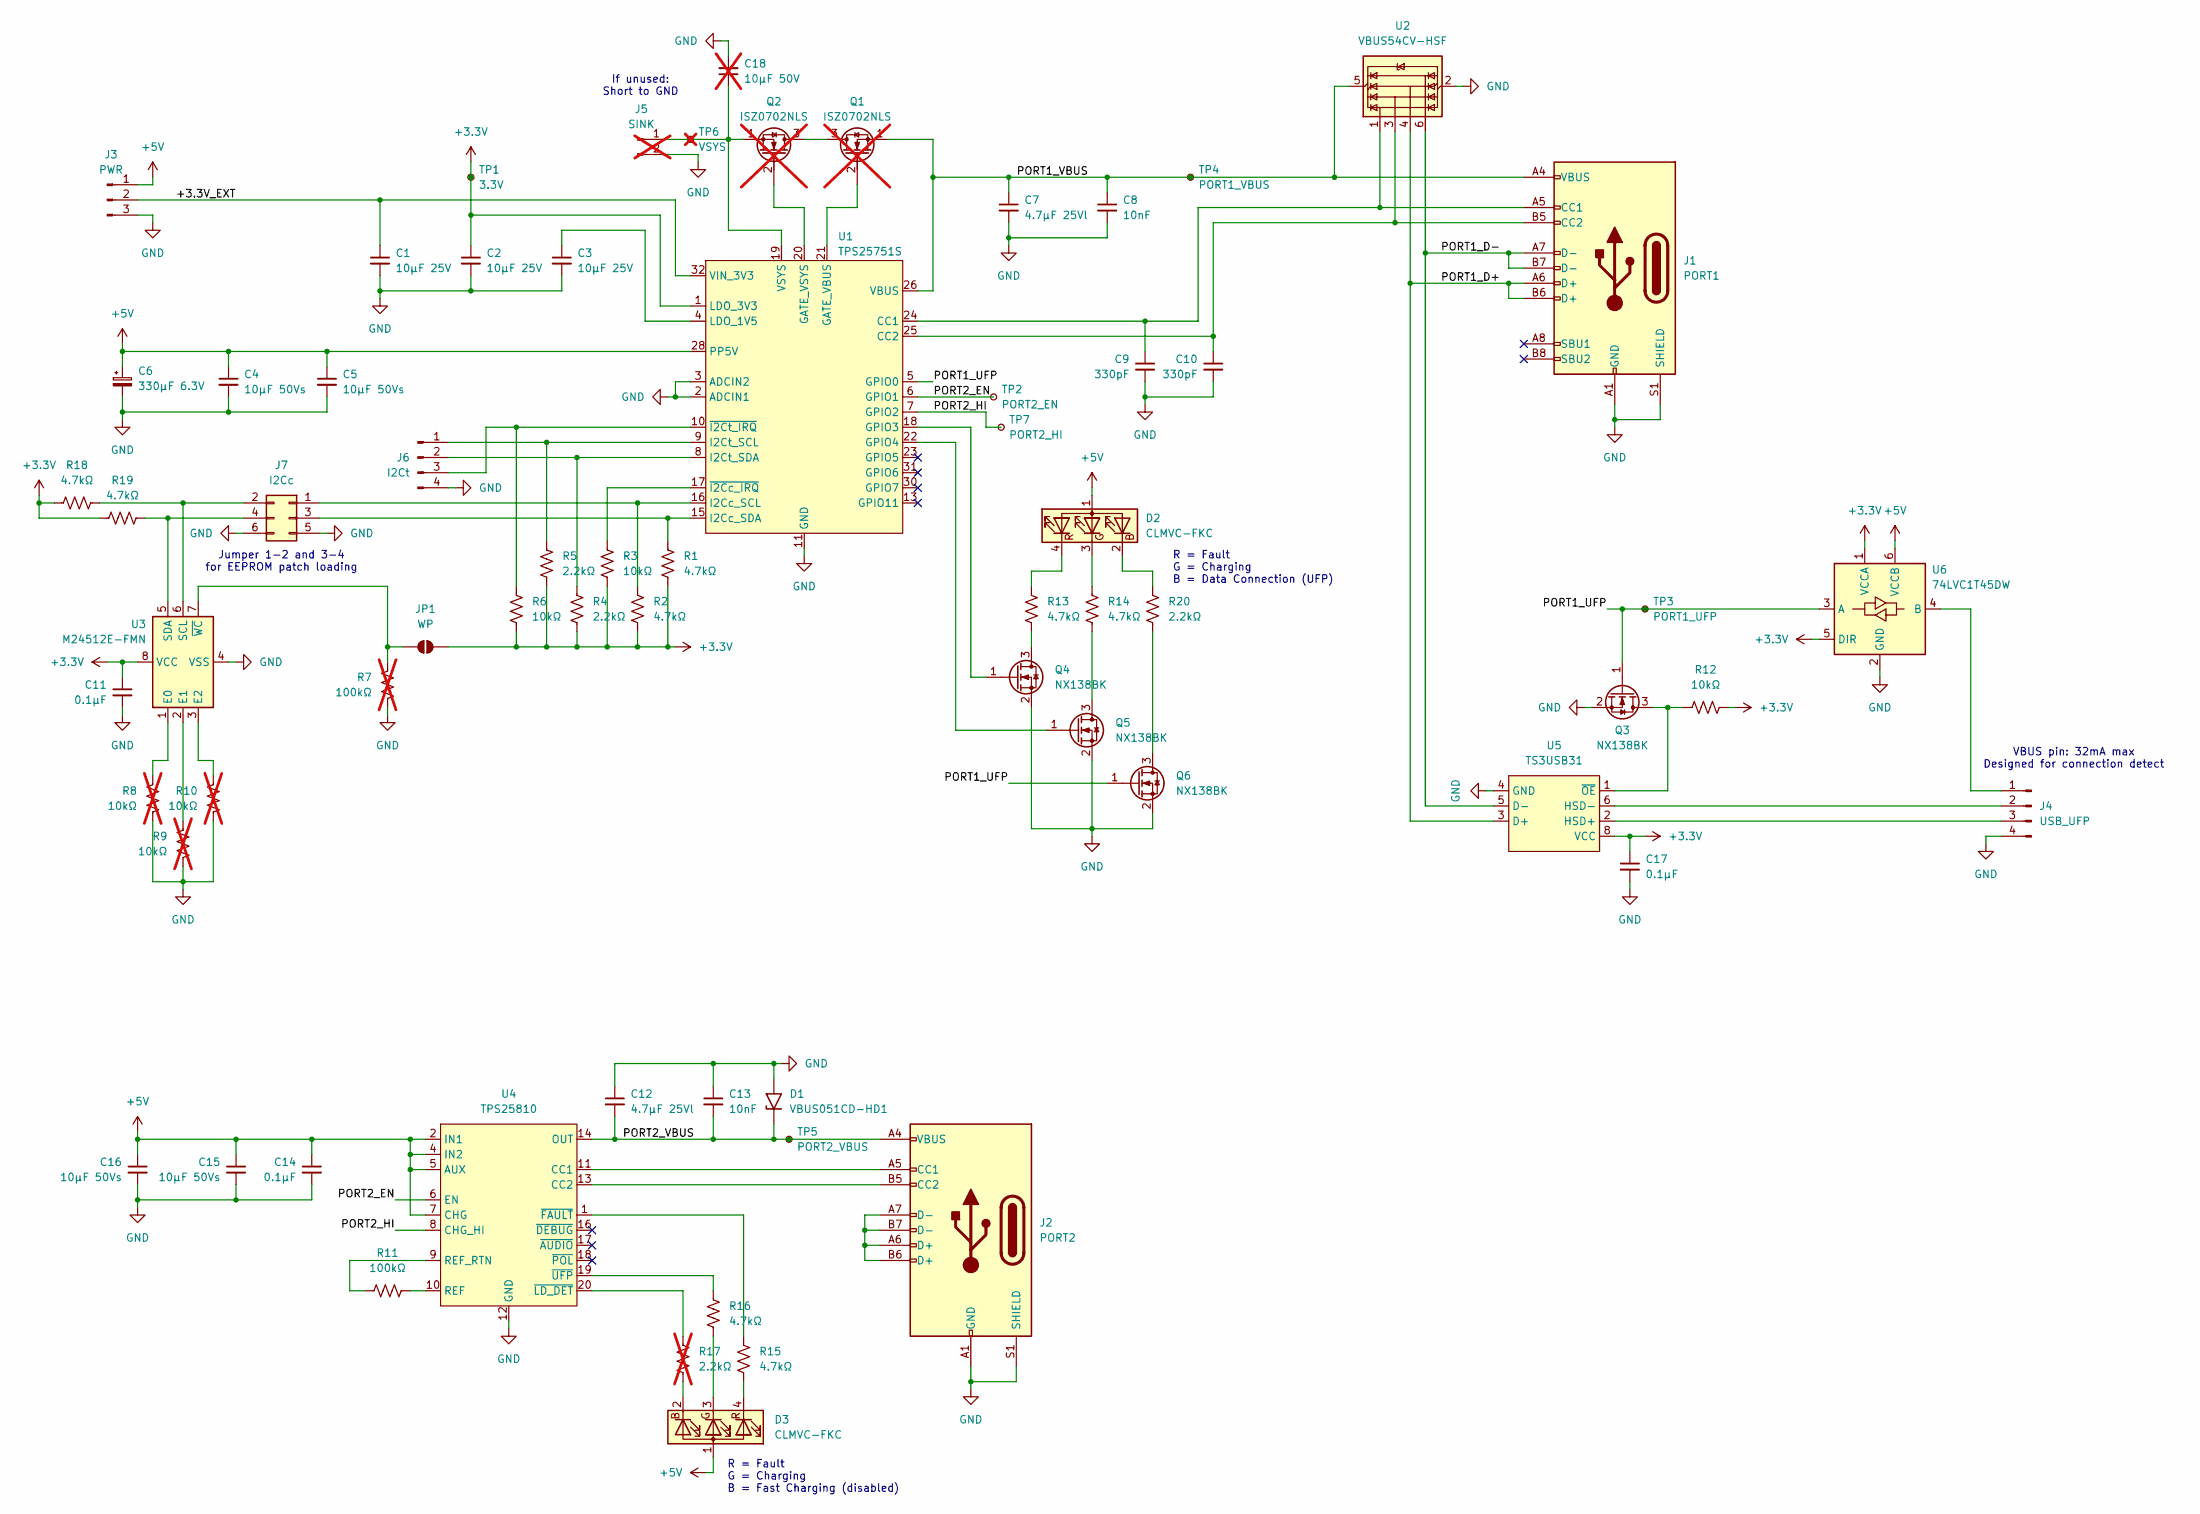
[picture p39: schematic USBPanel.kicad_sch]

Parts:
C1, C2, C3: 10μF 25V; C_0805_2012Metric
C4, C5, C15, C16: 10μF 50Vs; C_0805_2012Metric
C6: 330μF 6.3V; CP_Elec_6.3x5.9
C7, C12: 4.7μF 25Vl; C_0805_2012Metric
C8, C13: 10nF; C_0603_1608Metric
C9, C10: 330pF; C_0603_1608Metric
C11, C14, C17: 0.1μF; C_0603_1608Metric
C18: 10μF 50V; C_1206_3216Metric; not fitted
D1: VBUS051CD-HD1; D_0402_1005Metric
D2, D3: CLMVC-FKC; LED_Cree-PLCC4_2x2mm_CW
J1: PORT1; USB_C_Receptacle_Amphenol_12402082E512A
J2: PORT2; USB_C_Receptacle_Amphenol_12402082E512A
J3: PWR; Molex_Nano-Fit_105309-xx03_1x03_P2.50mm_Vertical
J4: USB_UFP; Amphenol_MINITEK_WTB_1.25_4P
J5: SINK; Molex_Nano-Fit_105309-xx02_1x02_P2.50mm_Vertical; not fitted
J6: I2Ct; PinHeader_1x04_P2.54mm_Vertical
J7: I2Cc; PinHeader_2x03_P2.54mm_Vertical
JP1: WP; SolderJumper-2_P1.3mm_Open_RoundedPad1.0x1.5mm
Q1, Q2: ISZ0702NLS; Infineon_PG-TSDSON-8-40; not fitted
Q3, Q4, Q5, Q6: NX138BK; SOT-23
R1, R2, R13, R14, R15, R16, R18, R19: 4.7kΩ; R_0603_1608Metric
R3, R6, R12: 10kΩ; R_0603_1608Metric
R4, R5, R20: 2.2kΩ; R_0603_1608Metric
R7: 100kΩ; R_0603_1608Metric; not fitted
R8, R9, R10: 10kΩ; R_0603_1608Metric; not fitted
R11: 100kΩ; R_0603_1608Metric
R17: 2.2kΩ; R_0603_1608Metric; not fitted
TP1: 3.3V; TP_0603_1608Metric_Fused
TP2: PORT2_EN; TP_0603_1608Metric_Fused
TP3: PORT1_UFP; TP_0603_1608Metric_Fused
TP4: PORT1_VBUS; TP_0603_1608Metric_Fused
TP5: PORT2_VBUS; TP_0603_1608Metric_Fused
TP6: VSYS; TP_0603_1608Metric_Fused; not fitted
TP7: PORT2_HI; TP_0603_1608Metric_Fused
U1: TPS25751S; VQFN-32-1EP_4x4mm_P0.4mm_EP2.8x2.8mm
U2: VBUS54CV-HSF; Vishay_LLP75-6L
U3: M24512E-FMN; SOIC-8_3.9x4.9mm_P1.27mm
U4: TPS25810; Texas_RVC0020A_WQFN-20-1EP_3x4mm_P0.5mm_EP2.6x1.6mm
U5: TS3USB31; Texas_RSE0008A_UQFN-8_1.5x1.5mm_P0.5mm
U6: 74LVC1T45DW; SOT-363_SC-70-6

Connections:
+3.3V: C2.1, C11.1, C17.1, JP1.2 (B), R1.2, R2.2, R3.2, R4.2, R5.2, R6.2, R12.1, R18.1, R19.1, TP1.1, U1.1 (LDO_3V3), U3.8 (VCC), U5.8 (VCC), U6.1 (VCCA), U6.5 (DIR)
+5V: C4.1, C5.1, C6.1, C14.1, C15.1, C16.1, D2.1 (A), D3.1 (A), J3.1, U1.28 (PP5V), U1.29 (PP5V), U4.2 (IN1), U4.3 (IN1), U4.4 (IN2), U4.5 (AUX), U4.7 (CHG), U6.6 (VCCB)
/+3.3V_EXT: C1.1, J3.2, U1.32 (VIN_3V3)
/PORT1_D+: J1.A6 (D+), J1.B6 (D+), U2.4 (I/O3), U5.3 (D+)
/PORT1_D-: J1.A7 (D-), J1.B7 (D-), U2.6 (I/O4), U5.5 (D-)
/PORT1_UFP: Q3.1 (G), Q6.1 (G), TP3.1, U1.5 (GPIO0), U6.3 (A)
/PORT1_VBUS: C7.1, C8.1, J1.A4 (VBUS), J1.A9 (VBUS), J1.B4 (VBUS), J1.B9 (VBUS), Q1.1 (S), TP4.1, U1.26 (VBUS), U1.27 (VBUS), U2.5 (VBUS)
/PORT2_EN: TP2.1, U1.6 (GPIO1), U4.6 (EN)
/PORT2_HI: TP7.1, U1.7 (GPIO2), U4.8 (CHG_HI)
/PORT2_VBUS: C12.2, C13.2, D1.1 (A1), J2.A4 (VBUS), J2.A9 (VBUS), J2.B4 (VBUS), J2.B9 (VBUS), TP5.1, U4.14 (OUT), U4.15 (OUT)
GND: C1.2, C2.2, C3.2, C4.2, C5.2, C6.2, C7.2, C8.2, C9.2, C10.2, C11.2, C12.1, C13.1, C14.2, C15.2, C16.2, C17.2, C18.2, D1.2 (A2), J1.A1 (GND), J1.A12 (GND), J1.B1 (GND), J1.B12 (GND), J1.S1 (SHIELD), J2.A1 (GND), J2.A12 (GND), J2.B1 (GND), J2.B12 (GND), J2.S1 (SHIELD), J3.3, J4.4, J5.2, J6.4, J7.5, J7.6, Q3.2 (S), Q4.2 (S), Q5.2 (S), Q6.2 (S), R7.2, R8.2, R9.2, R10.2, U1.2 (ADCIN1), U1.3 (ADCIN2), U1.11 (GND), U1.12 (GND), U1.14 (GND), U1.33 (GND), U2.2 (GND), U3.4 (VSS), U4.12 (GND), U4.21 (GND), U5.4 (GND), U6.2 (GND)
unnamed: D2.2 (BK), R20.1
unnamed: D2.3 (GK), R14.1
unnamed: D2.4 (RK), R13.1
unnamed: D3.2 (BK), R17.2
unnamed: D3.3 (GK), R16.2
unnamed: D3.4 (RK), R15.2
unnamed: C9.1, J1.A5 (CC1), U1.24 (CC1), U2.1 (I/O1)
unnamed: C10.1, J1.B5 (CC2), U1.25 (CC2), U2.3 (I/O2)
unnamed: J2.A5 (CC1), U4.11 (CC1)
unnamed: J2.B5 (CC2), U4.13 (CC2)
unnamed: J2.A6 (D+), J2.A7 (D-), J2.B6 (D+), J2.B7 (D-)
unnamed: J4.1, U6.4 (B)
unnamed: J4.2, U5.6 (HSD-)
unnamed: J4.3, U5.2 (HSD+)
unnamed: C18.1, J5.1, Q2.1 (S), TP6.1, U1.19 (VSYS)
unnamed: J6.1, R5.1, U1.9 (I2Ct_SCL)
unnamed: J6.2, R4.1, U1.8 (I2Ct_SDA)
unnamed: J6.3, R6.1, U1.10 (~I2Ct_IRQ)
unnamed: J7.1, R2.1, U1.16 (I2Cc_SCL)
unnamed: J7.2, R18.2, U3.6 (SCL)
unnamed: J7.3, R1.1, U1.15 (I2Cc_SDA)
unnamed: J7.4, R19.2, U3.5 (SDA)
unnamed: JP1.1 (A), R7.1, U3.7 (~WC)
unnamed: Q1.3 (D), Q2.3 (D)
unnamed: Q1.2 (G), U1.21 (GATE_VBUS)
unnamed: Q2.2 (G), U1.20 (GATE_VSYS)
unnamed: Q3.3 (D), R12.2, U5.1 (~OE)
unnamed: Q4.3 (D), R13.2
unnamed: Q4.1 (G), U1.18 (GPIO3)
unnamed: Q5.3 (D), R14.2
unnamed: Q5.1 (G), U1.22 (GPIO4)
unnamed: Q6.3 (D), R20.2
unnamed: C3.1, U1.4 (LDO_1V5)
unnamed: R3.1, U1.17 (~I2Cc_IRQ)
unnamed: R8.1, U3.1 (E0)
unnamed: R9.1, U3.2 (E1)
unnamed: R10.1, U3.3 (E2)
unnamed: R11.2, U4.10 (REF)
unnamed: R11.1, U4.9 (REF_RTN)
unnamed: R15.1, U4.1 (~FAULT)
unnamed: R17.1, U4.20 (~LD_DET)
unnamed: R16.1, U4.19 (~UFP)

Notes on the sheet:
Jumper 1-2 and 3-4 for EEPROM patch loading
VBUS pin: 32mA max Designed for connection detect
R = Fault G = Charging B = Fast Charging (disabled)
R = Fault G = Charging B = Data Connection (UFP)
If unused: Short to GND

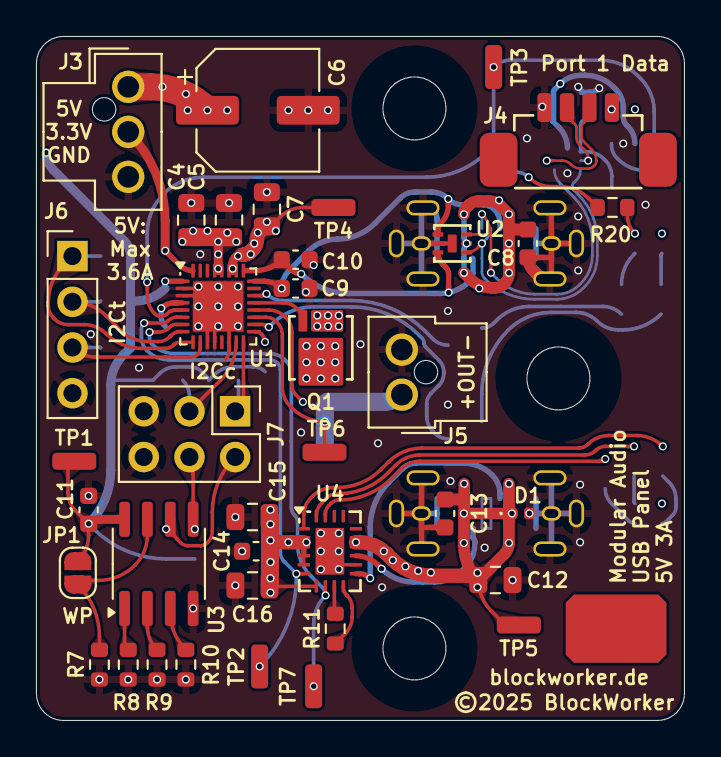
[picture p40: board USBPanel.kicad_pcb from above]

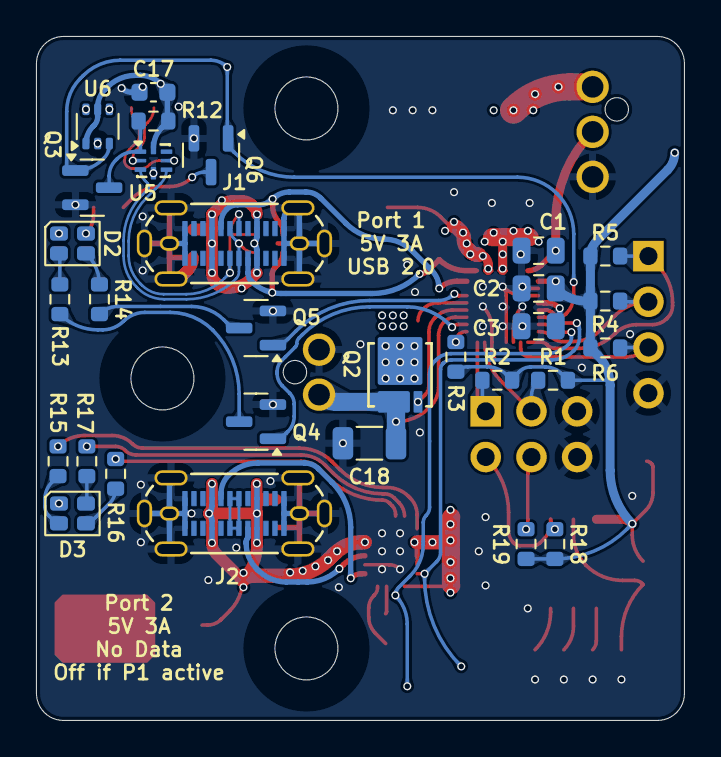
[picture p41: board USBPanel.kicad_pcb from below]

Board: 6 copper layers, 36.0 x 38.0 mm, 68 parts (30 on the bottom side), 53 nets.
