BlockWorker/ModularAudio/DigitalAudioProcessor/DigitalAudioProcessor.kicad_pcb

## KiCad design DigitalAudioProcessor/DigitalAudioProcessor.kicad_pcb (2025-07-26)

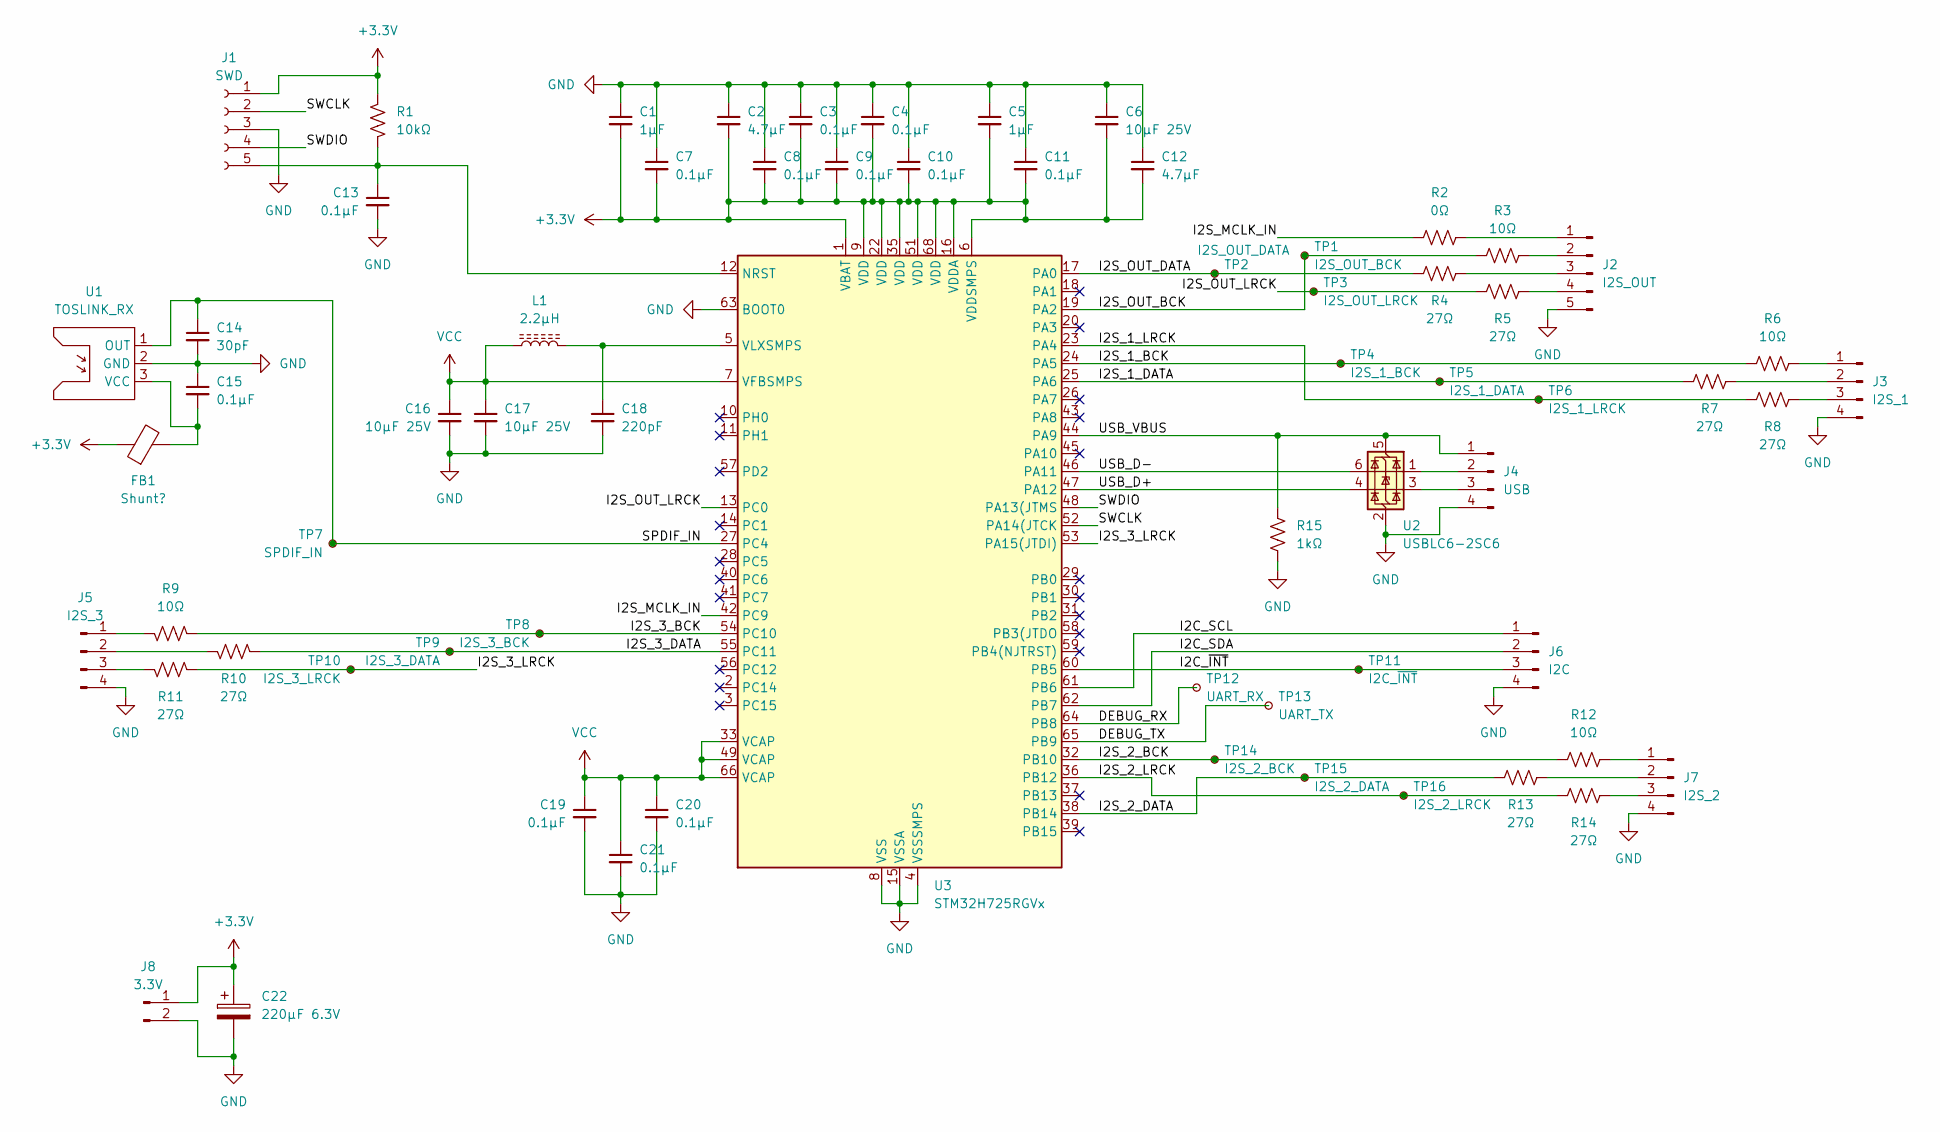
[picture p42: schematic DigitalAudioProcessor.kicad_sch]

Parts:
C1, C5: 1µF; C_0603_1608Metric
C2, C12: 4.7µF; C_0603_1608Metric
C3, C4, C7, C8, C9, C10, C11, C13, C15, C19, C20, C21: 0.1µF; C_0603_1608Metric
C6, C16, C17: 10µF 25V; C_0805_2012Metric
C14: 30pF; C_0603_1608Metric
C18: 220pF; C_0603_1608Metric
C22: 220µF 6.3V; CP_Elec_5x5.8
FB1: Shunt?; L_0603_1608Metric
J1: SWD; PinSocket_1x05_P1.27mm_Vertical_SMD_Pin1Right
J2: I2S_OUT; Amphenol_MINITEK_WTB_1.25_5P
J3: I2S_1; Amphenol_MINITEK_WTB_1.25_4P
J4: USB; Amphenol_MINITEK_WTB_1.25_4P
J5: I2S_3; Amphenol_MINITEK_WTB_1.25_4P
J6: I2C; Amphenol_MINITEK_WTB_1.25_4P
J7: I2S_2; Amphenol_MINITEK_WTB_1.25_4P
J8: 3.3V; Amphenol_MINITEK_WTB_1.25_2P
L1: 2.2µH; L_0805_2012Metric
R1: 10kΩ; R_0603_1608Metric
R2: 0Ω; R_0603_1608Metric
R3, R6, R9, R12: 10Ω; R_0603_1608Metric
R4, R5, R7, R8, R10, R11, R13, R14: 27Ω; R_0603_1608Metric
R15: 1kΩ; R_0603_1608Metric
TP1: I2S_OUT_BCK; TP_0603_1608Metric_Fused
TP2: I2S_OUT_DATA; TP_0603_1608Metric_Fused
TP3: I2S_OUT_LRCK; TP_0603_1608Metric_Fused
TP4: I2S_1_BCK; TP_0603_1608Metric_Fused
TP5: I2S_1_DATA; TP_0603_1608Metric_Fused
TP6: I2S_1_LRCK; TP_0603_1608Metric_Fused
TP7: SPDIF_IN; TP_0603_1608Metric_Fused
TP8: I2S_3_BCK; TP_0603_1608Metric_Fused
TP9: I2S_3_DATA; TP_0603_1608Metric_Fused
TP10: I2S_3_LRCK; TP_0603_1608Metric_Fused
TP11: I2C_~{INT}; TP_0603_1608Metric_Fused
TP12: UART_RX; TP_0603_1608Metric_Fused
TP13: UART_TX; TP_0603_1608Metric_Fused
TP14: I2S_2_BCK; TP_0603_1608Metric_Fused
TP15: I2S_2_DATA; TP_0603_1608Metric_Fused
TP16: I2S_2_LRCK; TP_0603_1608Metric_Fused
U1: TOSLINK_RX; DLR2180
U2: USBLC6-2SC6; SOT-23-6
U3: STM32H725RGVx; QFN-68-1EP_8x8mm_P0.4mm_EP6.4x6.4mm

Connections:
+3.3V: C1.2, C2.2, C3.2, C4.2, C5.2, C6.2, C7.2, C8.2, C9.2, C10.2, C11.2, C12.2, C22.1, FB1.1, J1.1, J8.1, R1.1, U3.1 (VBAT), U3.6 (VDDSMPS), U3.9 (VDD), U3.16 (VDDA), U3.22 (VDD), U3.35 (VDD), U3.51 (VDD), U3.68 (VDD)
/DEBUG_RX: TP12.1, U3.64 (PB8)
/DEBUG_TX: TP13.1, U3.65 (PB9)
/I2C_SCL: J6.1, U3.61 (PB6)
/I2C_SDA: J6.2, U3.62 (PB7)
/I2C_~INT: J6.3, TP11.1, U3.60 (PB5)
/I2S_1_BCK: R6.1, TP4.1, U3.24 (PA5)
/I2S_1_DATA: R7.1, TP5.1, U3.25 (PA6)
/I2S_1_LRCK: R8.1, TP6.1, U3.23 (PA4)
/I2S_2_BCK: R12.1, TP14.1, U3.32 (PB10)
/I2S_2_DATA: R13.1, TP15.1, U3.38 (PB14)
/I2S_2_LRCK: R14.1, TP16.1, U3.36 (PB12)
/I2S_3_BCK: R9.1, TP8.1, U3.54 (PC10)
/I2S_3_DATA: R10.1, TP9.1, U3.55 (PC11)
/I2S_3_LRCK: R11.1, TP10.1, U3.53 (PA15(JTDI))
/I2S_MCLK_IN: R2.1, U3.42 (PC9)
/I2S_OUT_BCK: R3.1, TP1.1, U3.19 (PA2)
/I2S_OUT_DATA: R4.1, TP2.1, U3.17 (PA0)
/I2S_OUT_LRCK: R5.1, TP3.1, U3.13 (PC0)
/SPDIF_IN: C14.1, TP7.1, U1.1 (OUT), U3.27 (PC4)
/SWCLK: J1.2, U3.52 (PA14(JTCK)
/SWDIO: J1.4, U3.48 (PA13(JTMS)
/USB_D+: U2.4 (I/O2), U3.47 (PA12)
/USB_D-: U2.6 (I/O1), U3.46 (PA11)
/USB_VBUS: J4.1, R15.2, U2.5 (VBUS), U3.44 (PA9)
GND: C1.1, C2.1, C3.1, C4.1, C5.1, C6.1, C7.1, C8.1, C9.1, C10.1, C11.1, C12.1, C13.2, C14.2, C15.1, C16.2, C17.2, C18.2, C19.2, C20.2, C21.2, C22.2, J1.3, J2.5, J3.4, J4.4, J5.4, J6.4, J7.4, J8.2, R15.1, U1.2 (GND), U2.2 (GND), U3.4 (VSSSMPS), U3.8 (VSS), U3.15 (VSSA), U3.21 (VSS), U3.34 (VSS), U3.50 (VSS), U3.63 (BOOT0), U3.67 (VSS), U3.69 (VSS)
unnamed: C13.1, J1.5, R1.2, U3.12 (NRST)
unnamed: J2.1, R2.2
unnamed: J2.2, R3.2
unnamed: J2.3, R4.2
unnamed: J2.4, R5.2
unnamed: J3.1, R6.2
unnamed: J3.2, R7.2
unnamed: J3.3, R8.2
unnamed: J4.2, U2.1 (I/O1)
unnamed: J4.3, U2.3 (I/O2)
unnamed: J5.1, R9.2
unnamed: J5.2, R10.2
unnamed: J5.3, R11.2
unnamed: J7.1, R12.2
unnamed: J7.2, R13.2
unnamed: J7.3, R14.2
unnamed: C15.2, FB1.2, U1.3 (VCC)
unnamed: C18.1, L1.2, U3.5 (VLXSMPS)
VCC: C16.1, C17.1, C19.1, C20.1, C21.1, L1.1, U3.7 (VFBSMPS), U3.33 (VCAP), U3.49 (VCAP), U3.66 (VCAP)

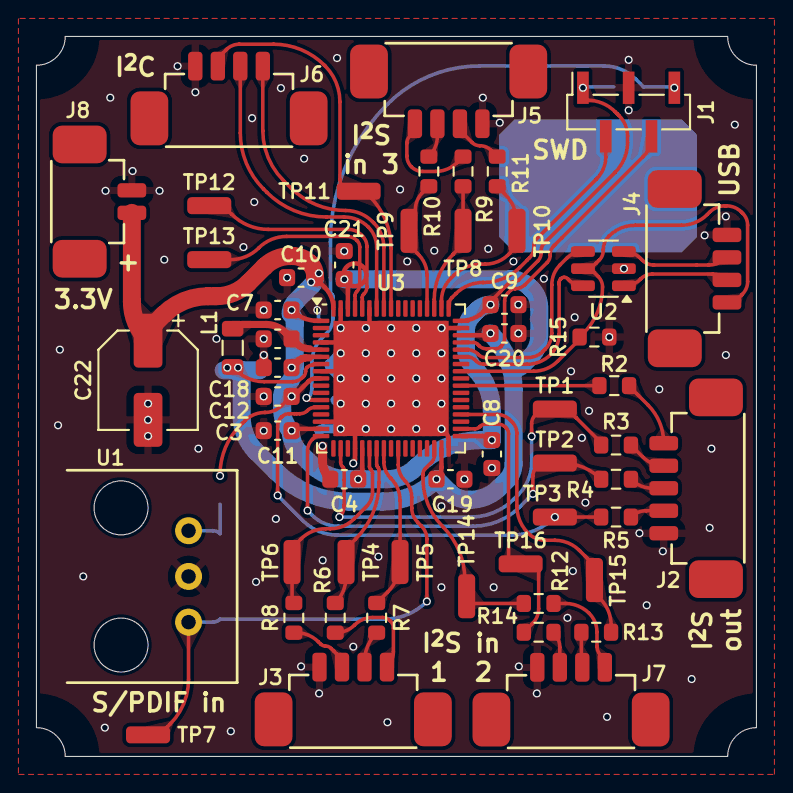
[picture p43: board DigitalAudioProcessor.kicad_pcb from above]

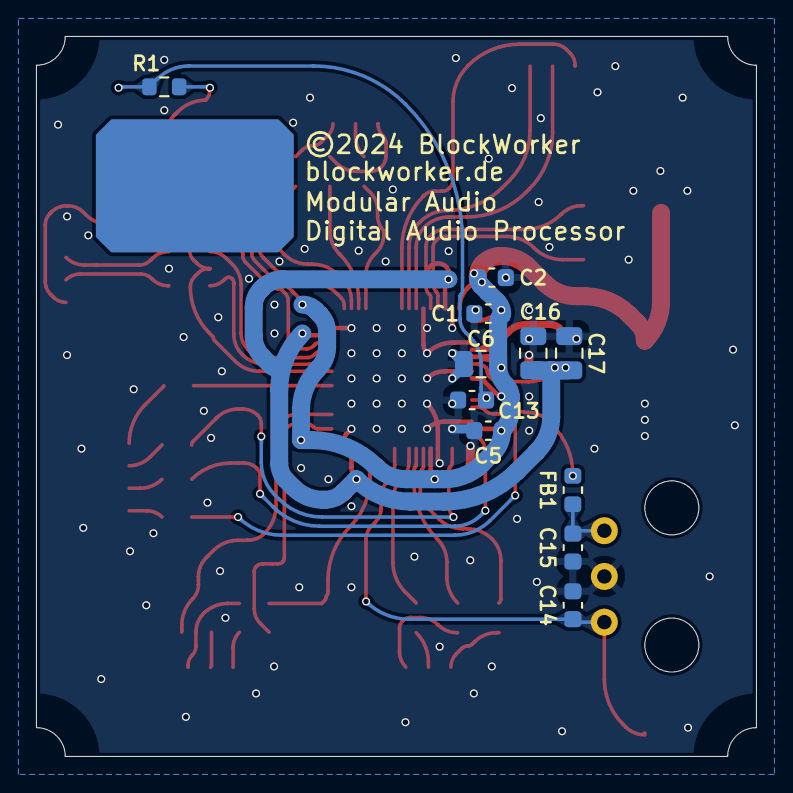
[picture p44: board DigitalAudioProcessor.kicad_pcb from below]

Board: 4 copper layers, 40.0 x 40.0 mm, 66 parts (11 on the bottom side), 45 nets.
