BlockWorker/ModularAudio/BatteryCharger/BatteryCharger.kicad_pcb

## KiCad design BatteryCharger/BatteryCharger.kicad_pcb (2025-04-26)

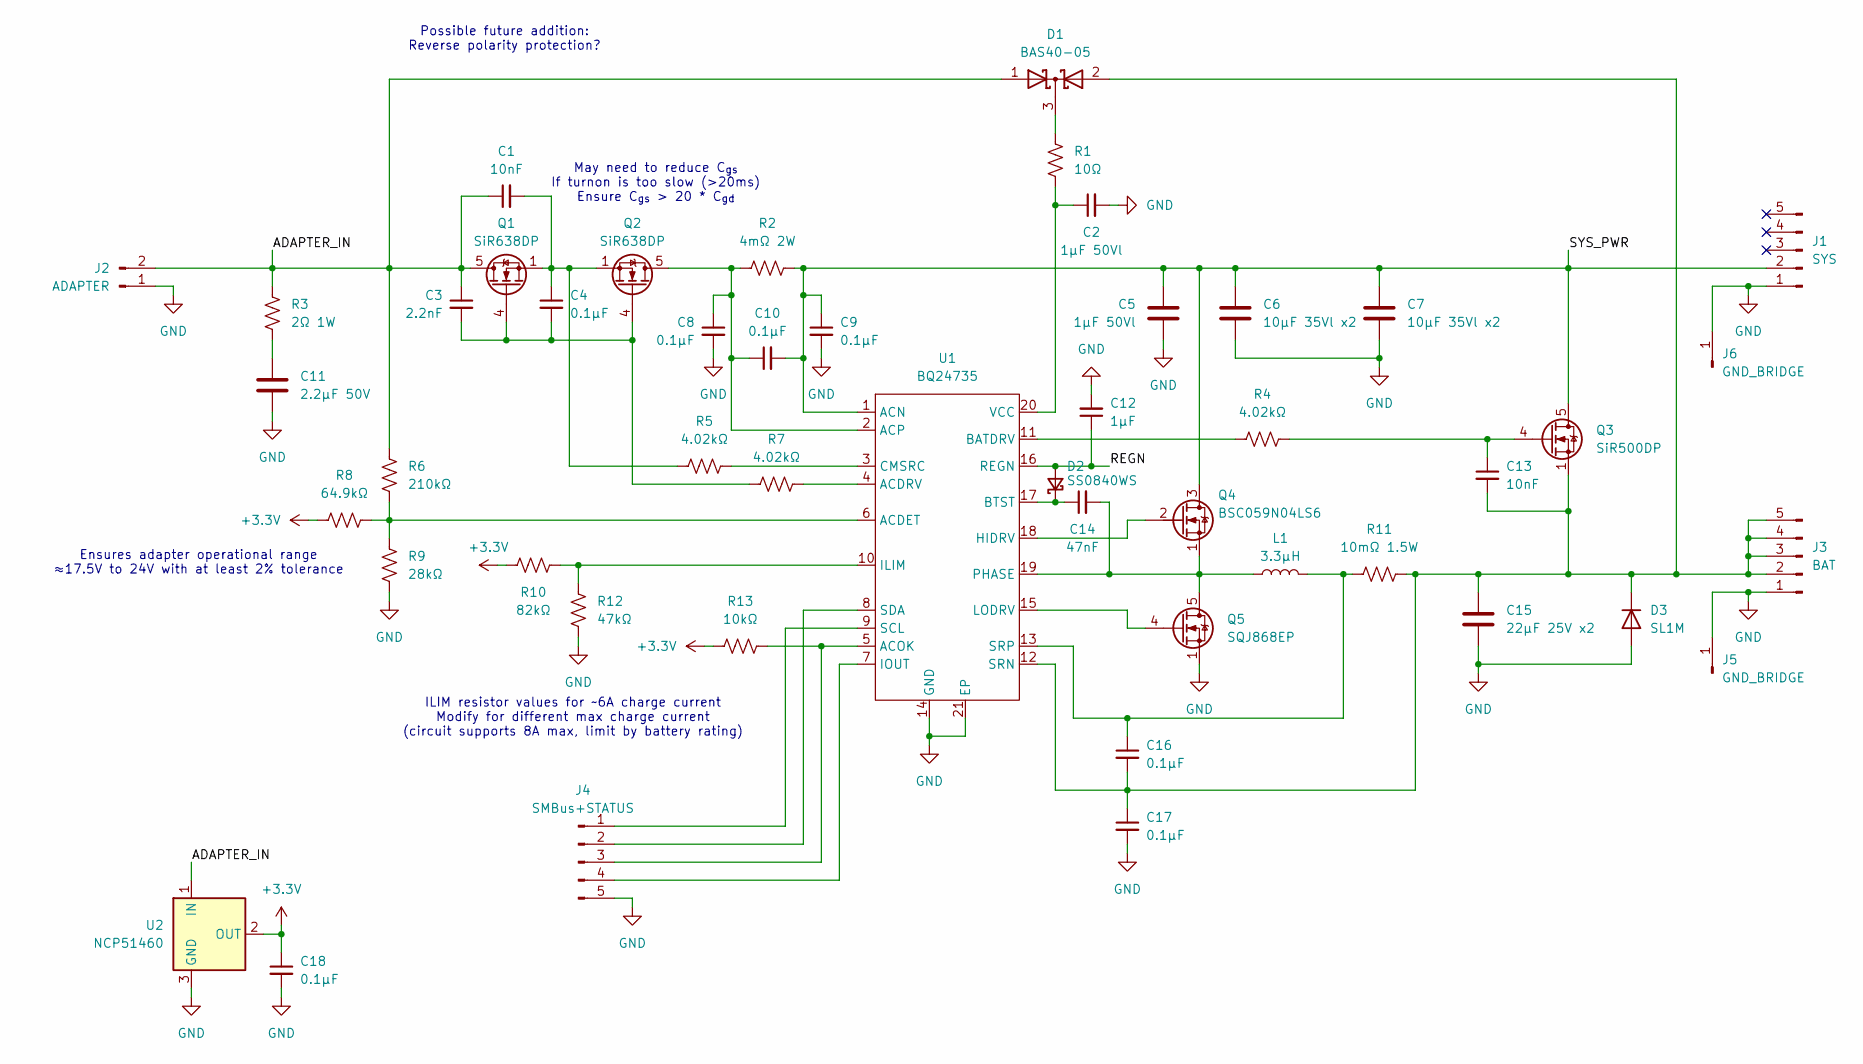
[picture p45: schematic BatteryCharger.kicad_sch]

Parts:
C1, C13: 10nF; C_0603_1608Metric
C2, C5: 1µF 50Vl; C_0805_2012Metric
C3: 2.2nF; C_0603_1608Metric
C4, C8, C9, C10, C16, C17, C18: 0.1µF; C_0603_1608Metric
C6, C7: 10µF 35Vl x2; C_1210_3225Metric
C11: 2.2µF 50V; C_0805_2012Metric
C12: 1µF; C_0603_1608Metric
C14: 47nF; C_0603_1608Metric
C15: 22µF 25V x2; C_1210_3225Metric
D1: BAS40-05; SOT-23
D2: SS0840WS; D_SOD-323_HandSoldering
D3: SL1M; D_SOD-123F
J1: SYS; TE_2042274_Solder
J2: ADAPTER; Molex_Mini-Fit_Max_2P_V_215915-1002
J3: BAT; TE_2042274_Solder
J4: SMBus+STATUS; Amphenol_MINITEK_WTB_1.25_5P
J5, J6: GND_BRIDGE; HolePad_2.5mm_3.5mm
L1: 3.3µH; L_Eaton_EXL1V0703
Q1, Q2: SiR638DP; PowerPAK_SO-8_Single
Q3: SiR500DP; PowerPAK_SO-8_Single
Q4: BSC059N04LS6; Infineon_PG-TDSON-8FL_6.15x5.15mm
Q5: SQJ868EP; PowerPAK_SO-8L_Single_Improved
R1: 10Ω; R_0603_1608Metric
R2: 4mΩ 2W; R_0612_1632Metric
R3: 2Ω 1W; R_0508_1220Metric
R4, R5, R7: 4.02kΩ; R_0603_1608Metric
R6: 210kΩ; R_0603_1608Metric
R8: 64.9kΩ; R_0603_1608Metric
R9: 28kΩ; R_0603_1608Metric
R10: 82kΩ; R_0603_1608Metric
R11: 10mΩ 1.5W; R_0612_1632Metric
R12: 47kΩ; R_0603_1608Metric
R13: 10kΩ; R_0603_1608Metric
U1: BQ24735; VQFN-20-1EP_3.5x3.5mm_P0.5mm_EP2.05x2.05mm
U2: NCP51460; SOT-23

Connections:
+3.3V: C18.1, R8.1, R10.1, R13.1, U2.2 (OUT)
/ADAPTER_IN: C1.1, C3.1, D1.1 (A), J2.2, Q1.5 (D), R3.1, R6.1, U2.1 (IN)
/REGN: C12.1, D2.2 (A), U1.16 (REGN)
/SYS_PWR: C5.1, C6.1, C7.1, C9.1, C10.2, J1.2, Q3.5 (D), Q4.3 (D), R2.2, U1.1 (ACN)
GND: C2.2, C5.2, C6.2, C7.2, C8.2, C9.2, C11.2, C12.2, C15.2, C17.2, C18.2, D3.2 (A), J1.1, J2.1, J3.1, J4.5, J5.1, J6.1, Q5.1 (S), Q5.2 (S), Q5.3 (S), R9.2, R12.1, U1.14 (GND), U1.21 (EP), U2.3 (GND)
unnamed: C1.2, C4.1, Q1.1 (S), Q1.2 (S), Q1.3 (S), Q2.1 (S), Q2.2 (S), Q2.3 (S), R5.1
unnamed: C11.1, R3.2
unnamed: D1.3 (K), R1.1
unnamed: C14.1, D2.1 (K), U1.17 (BTST)
unnamed: C13.2, C15.1, C16.2, C17.1, D1.2 (A), D3.1 (K), J3.2, J3.3, J3.4, J3.5, Q3.1 (S), Q3.2 (S), Q3.3 (S), R11.2, U1.12 (SRN)
unnamed: J4.1, U1.9 (SCL)
unnamed: J4.2, U1.8 (SDA)
unnamed: J4.3, R13.2, U1.5 (ACOK)
unnamed: J4.4, U1.7 (IOUT)
unnamed: C3.2, C4.2, Q1.4 (G), Q2.4 (G), R7.1
unnamed: C8.1, C10.1, Q2.5 (D), R2.1, U1.2 (ACP)
unnamed: C13.1, Q3.4 (G), R4.2
unnamed: Q4.2 (G), U1.18 (HIDRV)
unnamed: C14.2, L1.1, Q4.1 (S), Q5.5 (D), U1.19 (PHASE)
unnamed: Q5.4 (G), U1.15 (LODRV)
unnamed: R6.2, R8.2, R9.1, U1.6 (ACDET)
unnamed: R7.2, U1.4 (ACDRV)
unnamed: R4.1, U1.11 (BATDRV)
unnamed: R5.2, U1.3 (CMSRC)
unnamed: R10.2, R12.2, U1.10 (ILIM)
unnamed: C16.1, L1.2, R11.1, U1.13 (SRP)
unnamed: C2.1, R1.2, U1.20 (VCC)

Notes on the sheet:
ILIM resistor values for ~6A charge current Modify for different max charge current (circuit supports 8A max, limit by battery rating)
May need to reduce C_{gs} If turnon is too slow (>20ms) Ensure C_{gs} > 20 * C_{gd}
Possible future addition: Reverse polarity protection?
Ensures adapter operational range ≈17.5V to 24V with at least 2% tolerance

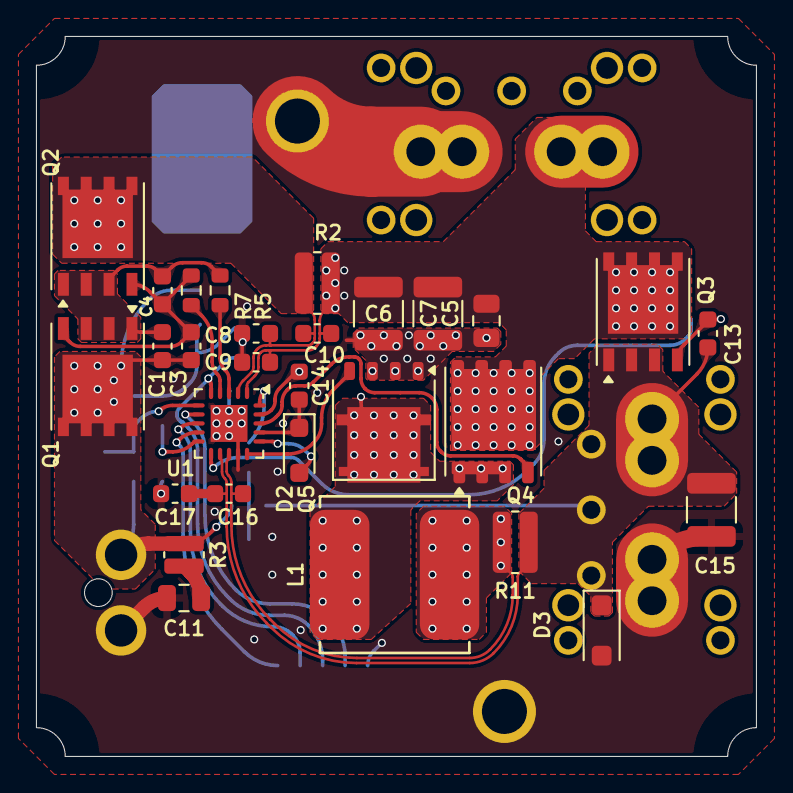
[picture p46: board BatteryCharger.kicad_pcb from above]

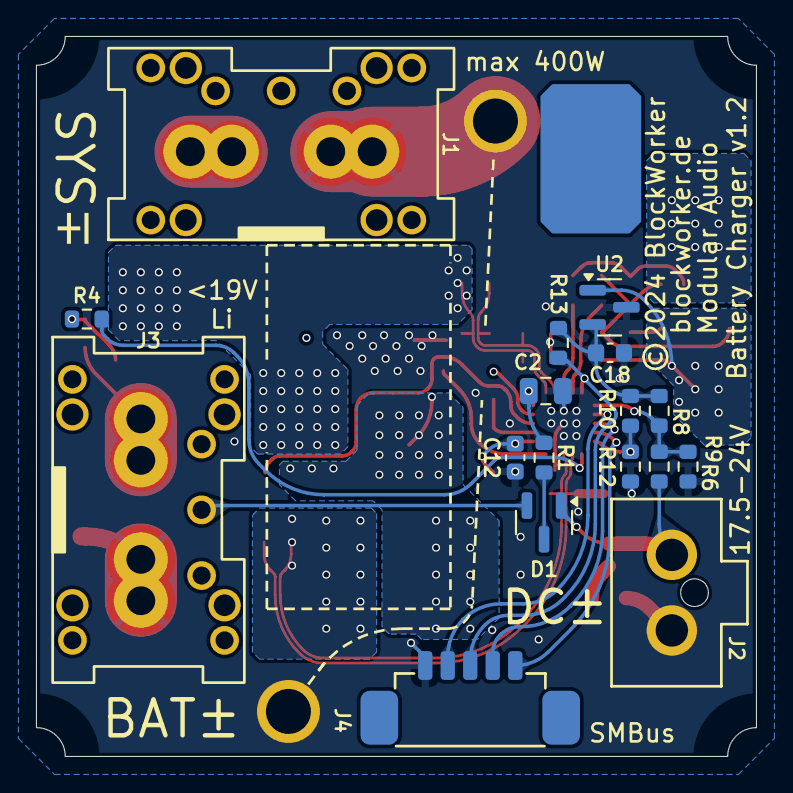
[picture p47: board BatteryCharger.kicad_pcb from below]

Board: 4 copper layers, 40.0 x 40.0 mm, 48 parts (17 on the bottom side), 27 nets.
