BlockWorker/ModularAudio/BlockBoxController/BlockBoxController.kicad_pcb

## KiCad design BlockBoxController/BlockBoxController.kicad_pcb (2025-02-23)

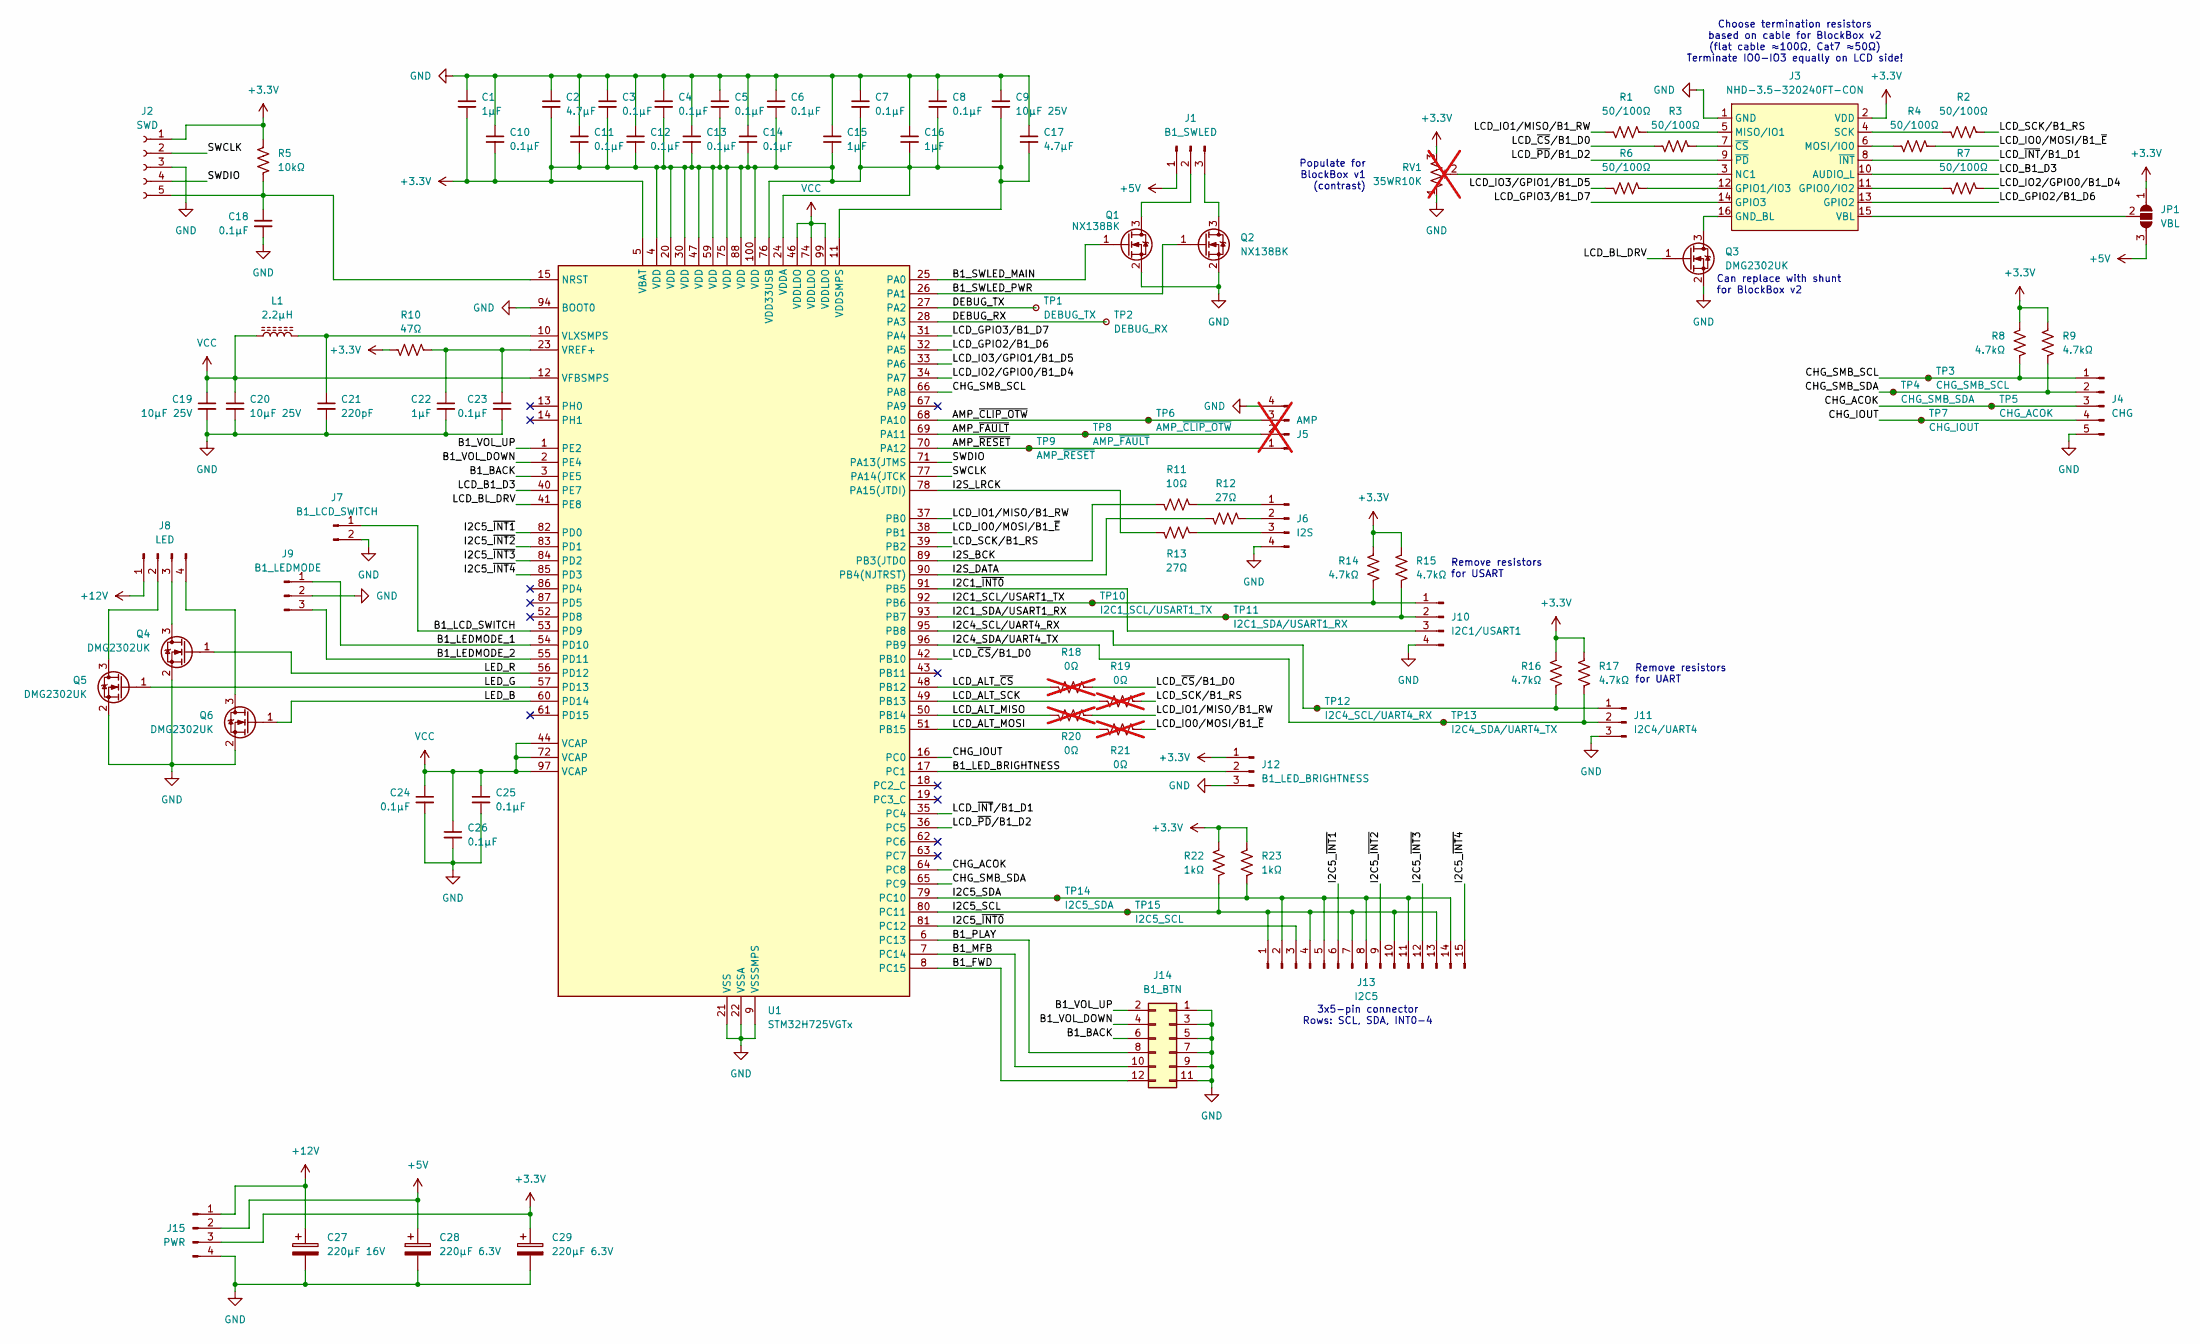
[picture p48: schematic BlockBoxController.kicad_sch]

Parts:
C1, C15, C16, C22: 1µF; C_0603_1608Metric
C2, C17: 4.7µF; C_0603_1608Metric
C3, C4, C5, C6, C7, C8, C10, C11, C12, C13, C14, C18, C23, C24, C25, C26: 0.1µF; C_0603_1608Metric
C9, C19, C20: 10µF 25V; C_0805_2012Metric
C21: 220pF; C_0603_1608Metric
C27: 220µF 16V; CP_Elec_6.3x7.7
C28, C29: 220µF 6.3V; CP_Elec_5x5.8
J1: B1_SWLED; PinHeader_1x03_P2.54mm_Vertical
J2: SWD; PinSocket_1x05_P1.27mm_Vertical_SMD_Pin1Right
J3: NHD-3.5-320240FT-CON; PinHeader_2x09_P2.54mm_Vertical_Mirrored
J4: CHG; Amphenol_MINITEK_WTB_1.25_5P
J5: AMP; Amphenol_MINITEK_WTB_1.25_4P; not fitted
J6: I2S; Amphenol_MINITEK_WTB_1.25_4P
J7: B1_LCD_SWITCH; PinHeader_1x02_P2.54mm_Vertical
J8: LED; PinHeader_1x04_P2.54mm_Vertical
J9: B1_LEDMODE; PinHeader_1x03_P2.54mm_Vertical
J10: I2C1/USART1; Amphenol_MINITEK_WTB_1.25_4P
J11: I2C4/UART4; Amphenol_MINITEK_WTB_1.25_3P
J12: B1_LED_BRIGHTNESS; PinHeader_1x03_P2.54mm_Vertical
J13: I2C5; PinHeader_3x05_P2.54mm_Vertical
J14: B1_BTN; PinHeader_2x06_P2.54mm_Vertical
J15: PWR; Molex_Nano-Fit_105309-xx04_1x04_P2.50mm_Vertical
JP1: VBL; SolderJumper-3_P1.3mm_Open_RoundedPad1.0x1.5mm
L1: 2.2µH; L_0805_2012Metric
Q1, Q2: NX138BK; SOT-23
Q3, Q4, Q5, Q6: DMG2302UK; SOT-23
R1, R2, R3, R4, R6, R7: 50/100Ω; R_0603_1608Metric
R5: 10kΩ; R_0603_1608Metric
R8, R9, R14, R15, R16, R17: 4.7kΩ; R_0603_1608Metric
R10: 47Ω; R_0603_1608Metric
R11: 10Ω; R_0603_1608Metric
R12, R13: 27Ω; R_0603_1608Metric
R18, R19, R20, R21: 0Ω; R_0603_1608Metric; not fitted
R22, R23: 1kΩ; R_0603_1608Metric
RV1: 35WR10K; Potentiometer_TT_35W; not fitted
TP1: DEBUG_TX; TP_0603_1608Metric_Fused
TP2: DEBUG_RX; TP_0603_1608Metric_Fused
TP3: CHG_SMB_SCL; TP_0603_1608Metric_Fused
TP4: CHG_SMB_SDA; TP_0603_1608Metric_Fused
TP5: CHG_ACOK; TP_0603_1608Metric_Fused
TP6: AMP_~{CLIP_OTW}; TestPoint_Pad_D1.0mm
TP7: CHG_IOUT; TestPoint_Pad_D1.0mm
TP8: AMP_~{FAULT}; TestPoint_Pad_D1.0mm
TP9: AMP_~{RESET}; TestPoint_Pad_D1.0mm
TP10: I2C1_SCL/USART1_TX; TP_0603_1608Metric_Fused
TP11: I2C1_SDA/USART1_RX; TP_0603_1608Metric_Fused
TP12: I2C4_SCL/UART4_RX; TP_0603_1608Metric_Fused
TP13: I2C4_SDA/UART4_TX; TP_0603_1608Metric_Fused
TP14: I2C5_SDA; TP_0603_1608Metric_Fused
TP15: I2C5_SCL; TP_0603_1608Metric_Fused
U1: STM32H725VGTx; LQFP-100_14x14mm_P0.5mm

Connections:
+3.3V: C1.2, C2.2, C3.2, C4.2, C5.2, C6.2, C7.2, C8.2, C9.2, C10.2, C11.2, C12.2, C13.2, C14.2, C15.2, C16.2, C17.2, C29.1, J2.1, J3.2 (VDD), J12.1, J15.3, JP1.1 (A), R5.1, R8.1, R9.1, R10.1, R14.1, R15.1, R16.1, R17.1, R22.1, R23.1, RV1.3, U1.4 (VDD), U1.5 (VBAT), U1.11 (VDDSMPS), U1.20 (VDD), U1.24 (VDDA), U1.30 (VDD), U1.47 (VDD), U1.59 (VDD), U1.75 (VDD), U1.76 (VDD33USB), U1.88 (VDD), U1.100 (VDD)
+5V: C28.1, J1.1, J15.2, JP1.3 (B)
+12V: C27.1, J8.1, J15.1
/AMP_~CLIP_OTW: J5.3, TP6.1, U1.68 (PA10)
/AMP_~FAULT: J5.2, TP8.1, U1.69 (PA11)
/AMP_~RESET: J5.1, TP9.1, U1.70 (PA12)
/B1_BACK: J14.6, U1.3 (PE5)
/B1_FWD: J14.12, U1.8 (PC15)
/B1_LCD_SWITCH: J7.1, U1.53 (PD9)
/B1_LEDMODE_1: J9.1, U1.54 (PD10)
/B1_LEDMODE_2: J9.3, U1.55 (PD11)
/B1_LED_BRIGHTNESS: J12.2, U1.17 (PC1)
/B1_MFB: J14.10, U1.7 (PC14)
/B1_PLAY: J14.8, U1.6 (PC13)
/B1_SWLED_MAIN: Q1.1 (G), U1.25 (PA0)
/B1_SWLED_PWR: Q2.1 (G), U1.26 (PA1)
/B1_VOL_DOWN: J14.4, U1.2 (PE4)
/B1_VOL_UP: J14.2, U1.1 (PE2)
/CHG_ACOK: J4.3, TP5.1, U1.64 (PC8)
/CHG_IOUT: J4.4, TP7.1, U1.16 (PC0)
/CHG_SMB_SCL: J4.1, R8.2, TP3.1, U1.66 (PA8)
/CHG_SMB_SDA: J4.2, R9.2, TP4.1, U1.65 (PC9)
/DEBUG_RX: TP2.1, U1.28 (PA3)
/DEBUG_TX: TP1.1, U1.27 (PA2)
/I2C1_SCL/USART1_TX: J10.1, R14.2, TP10.1, U1.92 (PB6)
/I2C1_SDA/USART1_RX: J10.2, R15.2, TP11.1, U1.93 (PB7)
/I2C1_~INT0: J10.3, U1.91 (PB5)
/I2C4_SCL/UART4_RX: J11.1, R16.2, TP12.1, U1.95 (PB8)
/I2C4_SDA/UART4_TX: J11.2, R17.2, TP13.1, U1.96 (PB9)
/I2C5_SCL: J13.1, J13.4, J13.7, J13.10, J13.13, R22.2, TP15.1, U1.80 (PC11)
/I2C5_SDA: J13.2, J13.5, J13.8, J13.11, J13.14, R23.2, TP14.1, U1.79 (PC10)
/I2C5_~INT0: J13.3, U1.81 (PC12)
/I2C5_~INT1: J13.6, U1.82 (PD0)
/I2C5_~INT2: J13.9, U1.83 (PD1)
/I2C5_~INT3: J13.12, U1.84 (PD2)
/I2C5_~INT4: J13.15, U1.85 (PD3)
/I2S_BCK: R11.1, U1.89 (PB3(JTDO)
/I2S_DATA: R12.1, U1.90 (PB4(NJTRST))
/I2S_LRCK: R13.1, U1.78 (PA15(JTDI))
/LCD_ALT_MISO: R20.1, U1.50 (PB14)
/LCD_ALT_MOSI: R21.1, U1.51 (PB15)
/LCD_ALT_SCK: R19.1, U1.49 (PB13)
/LCD_ALT_~CS: R18.1, U1.48 (PB12)
/LCD_B1_D3: J3.10 (AUDIO_L), U1.40 (PE7)
/LCD_BL_DRV: Q3.1 (G), U1.41 (PE8)
/LCD_GPIO2/B1_D6: J3.13 (GPIO2), U1.32 (PA5)
/LCD_GPIO3/B1_D7: J3.14 (GPIO3), U1.31 (PA4)
/LCD_IO0/MOSI/B1_~E: R4.2, R21.2, U1.38 (PB1)
/LCD_IO1/MISO/B1_RW: R1.1, R20.2, U1.37 (PB0)
/LCD_IO2/GPIO0/B1_D4: R7.2, U1.34 (PA7)
/LCD_IO3/GPIO1/B1_D5: R6.1, U1.33 (PA6)
/LCD_SCK/B1_RS: R2.2, R19.2, U1.39 (PB2)
/LCD_~CS/B1_D0: R3.1, R18.2, U1.42 (PB10)
/LCD_~INT/B1_D1: J3.8 (~INT), U1.35 (PC4)
/LCD_~PD/B1_D2: J3.9 (~PD), U1.36 (PC5)
/LED_B: Q6.1 (G), U1.60 (PD14)
/LED_G: Q5.1 (G), U1.57 (PD13)
/LED_R: Q4.1 (G), U1.56 (PD12)
/SWCLK: J2.2, U1.77 (PA14(JTCK)
/SWDIO: J2.4, U1.71 (PA13(JTMS)
GND: C1.1, C2.1, C3.1, C4.1, C5.1, C6.1, C7.1, C8.1, C9.1, C10.1, C11.1, C12.1, C13.1, C14.1, C15.1, C16.1, C17.1, C18.2, C19.2, C20.2, C21.2, C22.2, C23.2, C24.2, C25.2, C26.2, C27.2, C28.2, C29.2, J2.3, J3.1 (GND), J4.5, J5.4, J6.4, J7.2, J9.2, J10.4, J11.3, J12.3, J14.1, J14.3, J14.5, J14.7, J14.9, J14.11, J15.4, Q1.2 (S), Q2.2 (S), Q3.2 (S), Q4.2 (S), Q5.2 (S), Q6.2 (S), RV1.1, U1.9 (VSSSMPS), U1.21 (VSS), U1.22 (VSSA), U1.29 (VSS), U1.45 (VSS), U1.58 (VSS), U1.73 (VSS), U1.94 (BOOT0), U1.98 (VSS)
unnamed: J1.2, Q1.3 (D)
unnamed: J1.3, Q2.3 (D)
unnamed: C18.1, J2.5, R5.2, U1.15 (NRST)
unnamed: J3.11 (GPIO0/IO2), R7.1
unnamed: J3.12 (GPIO1/IO3), R6.2
unnamed: J3.5 (MISO/IO1), R1.2
unnamed: J3.6 (MOSI/IO0), R4.1
unnamed: J3.3 (NC1), RV1.2
unnamed: J3.4 (SCK), R2.1
unnamed: J3.7 (~CS), R3.2
unnamed: J6.1, R11.2
unnamed: J6.2, R12.2
unnamed: J6.3, R13.2
unnamed: J8.2, Q5.3 (D)
unnamed: J8.3, Q4.3 (D)
unnamed: J8.4, Q6.3 (D)
unnamed: J3.15 (VBL), J3.17 (VBL), JP1.2 (C)
unnamed: J3.16 (GND_BL), J3.18 (GND_BL), Q3.3 (D)
unnamed: C21.1, L1.2, U1.10 (VLXSMPS)
unnamed: C22.1, C23.1, R10.2, U1.23 (VREF+)
VCC: C19.1, C20.1, C24.1, C25.1, C26.1, L1.1, U1.12 (VFBSMPS), U1.44 (VCAP), U1.46 (VDDLDO), U1.72 (VCAP), U1.74 (VDDLDO), U1.97 (VCAP), U1.99 (VDDLDO)

Notes on the sheet:
Can replace with shunt for BlockBox v2
3x5-pin connector Rows: SCL, SDA, INT0-4
Remove resistors for UART
Populate for BlockBox v1 (contrast)
Choose termination resistors based on cable for BlockBox v2 (flat cable ≈100Ω, Cat7 ≈50Ω) Terminate IO0-IO3 equally on LCD side!
Remove resistors for USART

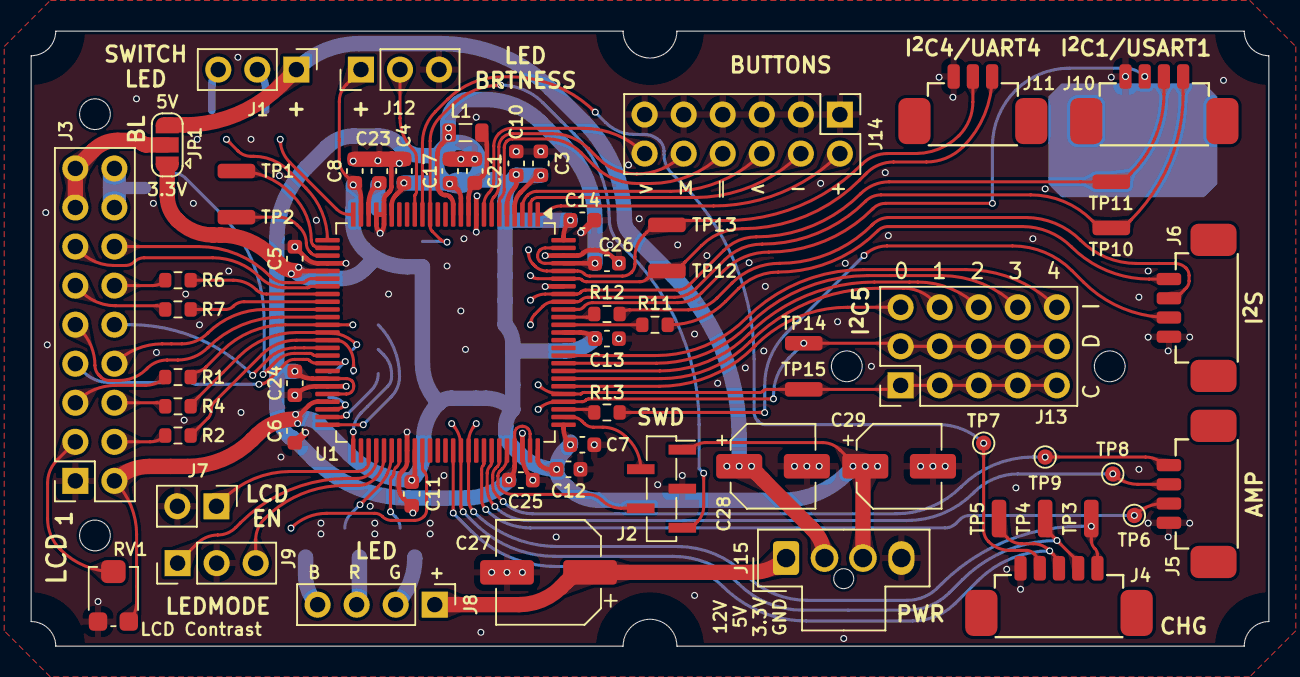
[picture p49: board BlockBoxController.kicad_pcb from above]

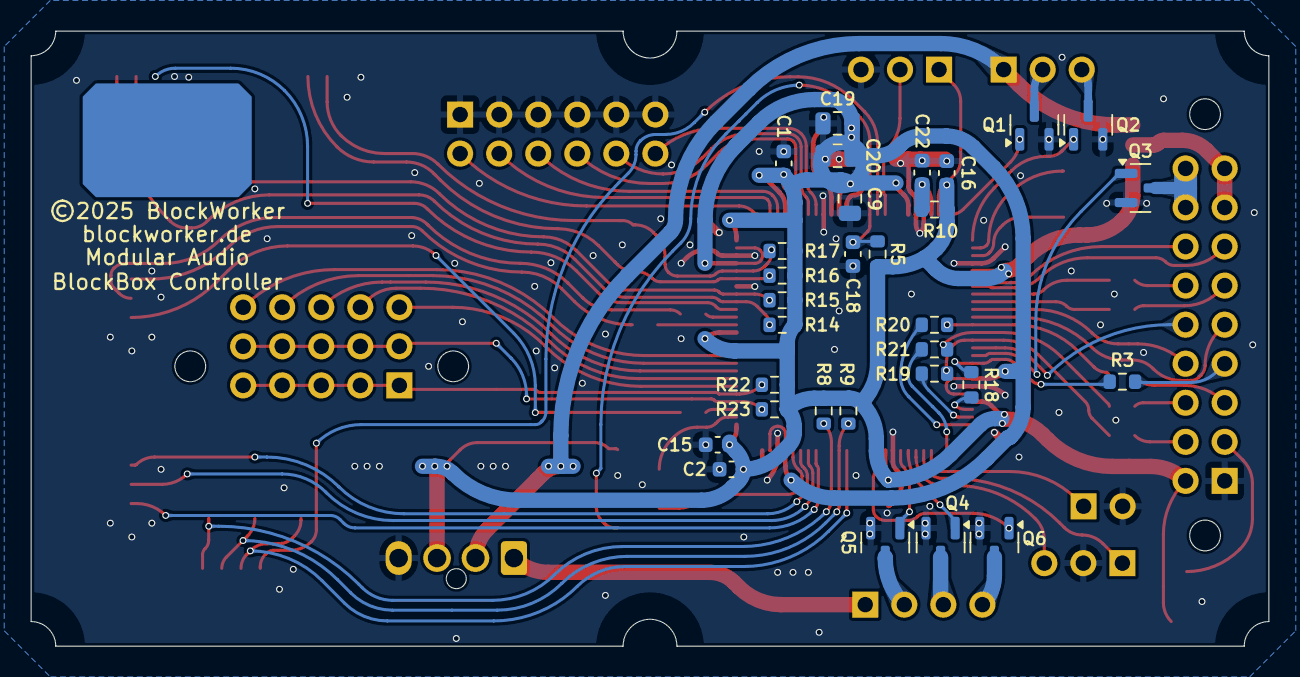
[picture p50: board BlockBoxController.kicad_pcb from below]

Board: 4 copper layers, 80.5 x 40.0 mm, 92 parts (30 on the bottom side), 82 nets.
