BlockWorker/ModularAudio/BasePower/BasePower.kicad_pcb

## KiCad design BasePower/BasePower.kicad_pcb (2025-01-31)

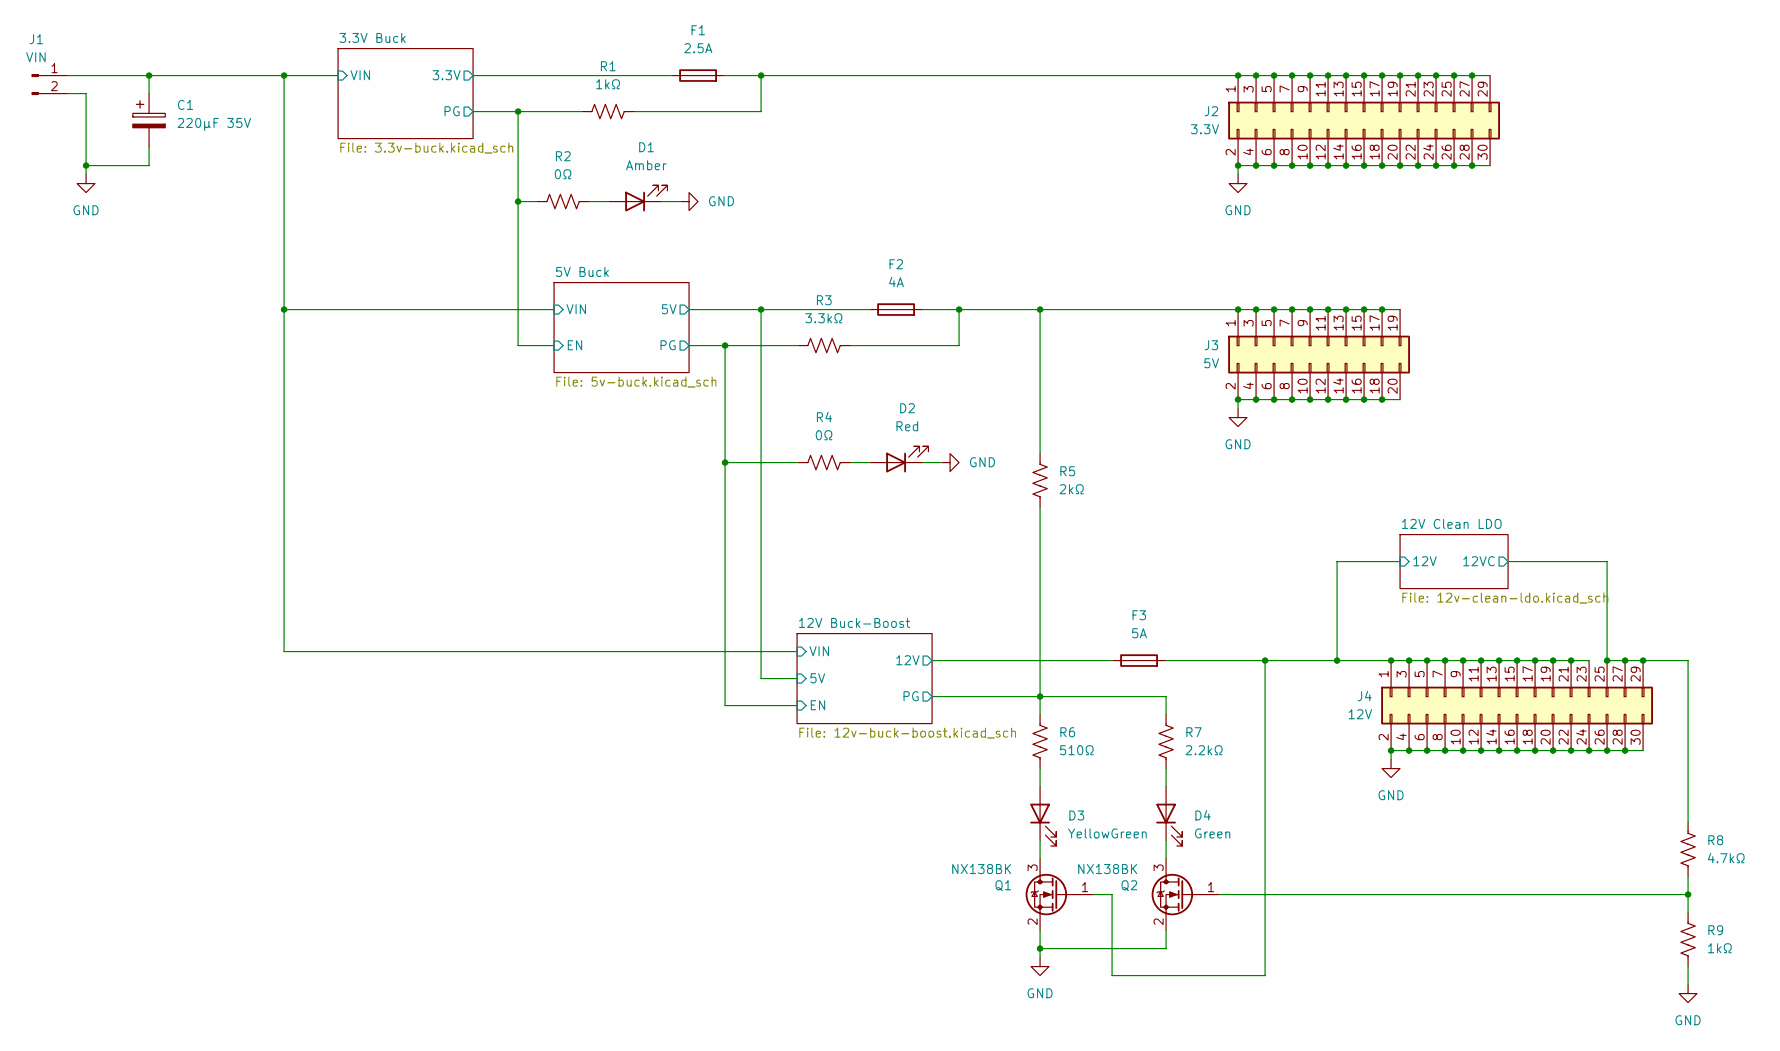
[picture p51: schematic BasePower.kicad_sch]

Parts:
C1: 220µF 35V; CP_Radial_D8.0mm_P3.50mm
D1: Amber; LED_0603_1608Metric
D2: Red; LED_0603_1608Metric
D3: YellowGreen; LED_0603_1608Metric
D4: Green; LED_0603_1608Metric
F1: 2.5A; Fuse_0603_1608Metric
F2: 4A; Fuse_0603_1608Metric
F3: 5A; Fuse_0603_1608Metric
J1: VIN; Molex_Nano-Fit_105309-xx02_1x02_P2.50mm_Vertical
J2: 3.3V; PinHeader_2x15_P2.54mm_Vertical
J3: 5V; PinHeader_2x10_P2.54mm_Vertical
J4: 12V; PinHeader_2x15_P2.54mm_Vertical
Q1, Q2: NX138BK; SOT-23
R1, R9: 1kΩ; R_0603_1608Metric
R2, R4: 0Ω; R_0603_1608Metric
R3: 3.3kΩ; R_0603_1608Metric
R5: 2kΩ; R_0603_1608Metric
R6: 510Ω; R_0603_1608Metric
R7: 2.2kΩ; R_0603_1608Metric
R8: 4.7kΩ; R_0603_1608Metric

Connections:
/3.3V Buck/3.3V: F1.1; also elsewhere on the board
/3.3V Buck/PG: R1.1, R2.1; also elsewhere on the board
/12V Buck-Boost/5V: F2.1; also elsewhere on the board
/12V Buck-Boost/12V: F3.1; also elsewhere on the board
/12V Buck-Boost/EN: R3.1, R4.1; also elsewhere on the board
/12V Buck-Boost/PG: R5.1, R6.1, R7.1; also elsewhere on the board
/12V Buck-Boost/VIN: C1.1, J1.1; also elsewhere on the board
/12V Clean LDO/12V: F3.2, J4.1, J4.3, J4.5, J4.7, J4.9, J4.11, J4.13, J4.15, J4.17, J4.19, J4.21, J4.23, Q1.1 (G); also elsewhere on the board
/12V Clean LDO/12VC: J4.25, J4.27, J4.29, R8.1; also elsewhere on the board
GND: C1.2, D1.1 (K), D2.1 (K), J1.2, J2.2, J2.4, J2.6, J2.8, J2.10, J2.12, J2.14, J2.16, J2.18, J2.20, J2.22, J2.24, J2.26, J2.28, J2.30, J3.2, J3.4, J3.6, J3.8, J3.10, J3.12, J3.14, J3.16, J3.18, J3.20, J4.2, J4.4, J4.6, J4.8, J4.10, J4.12, J4.14, J4.16, J4.18, J4.20, J4.22, J4.24, J4.26, J4.28, J4.30, Q1.2 (S), Q2.2 (S), R9.2; also elsewhere on the board
unnamed: D1.2 (A), R2.2
unnamed: D2.2 (A), R4.2
unnamed: D3.2 (A), R6.2
unnamed: D3.1 (K), Q1.3 (D)
unnamed: D4.2 (A), R7.2
unnamed: D4.1 (K), Q2.3 (D)
unnamed: F1.2, J2.1, J2.3, J2.5, J2.7, J2.9, J2.11, J2.13, J2.15, J2.17, J2.19, J2.21, J2.23, J2.25, J2.27, J2.29, R1.2
unnamed: F2.2, J3.1, J3.3, J3.5, J3.7, J3.9, J3.11, J3.13, J3.15, J3.17, J3.19, R3.2, R5.2
unnamed: Q2.1 (G), R8.2, R9.1

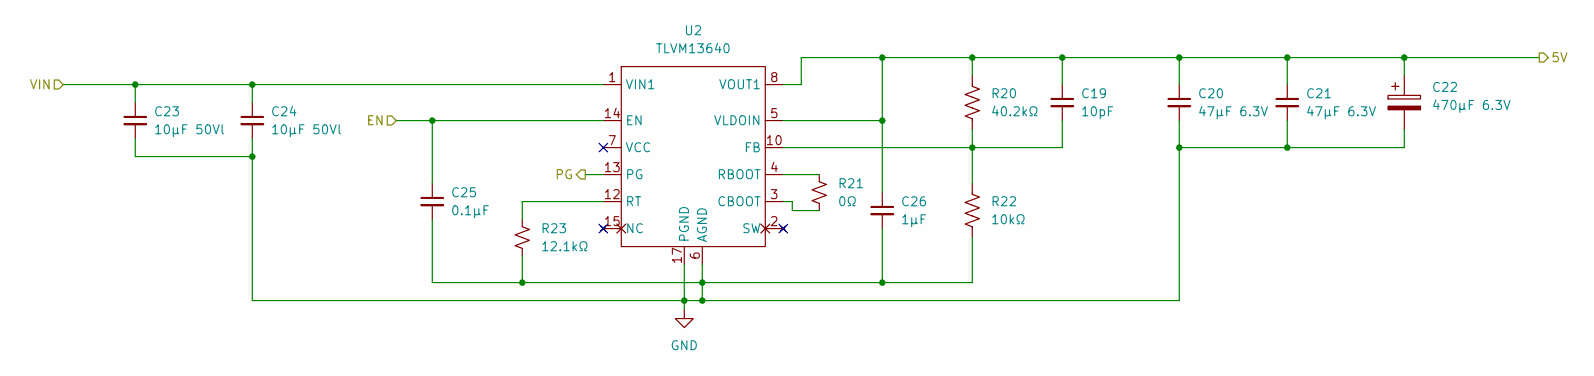
[picture p52: schematic 5v-buck.kicad_sch]

Parts:
C19: 10pF; C_0603_1608Metric
C20, C21: 47µF 6.3V; C_1210_3225Metric
C22: 470µF 6.3V; CP_Radial_D6.3mm_P2.50mm
C23, C24: 10µF 50Vl; C_1210_3225Metric
C25: 0.1µF; C_0603_1608Metric
C26: 1µF; C_0603_1608Metric
R20: 40.2kΩ; R_0603_1608Metric
R21: 0Ω; R_0603_1608Metric
R22: 10kΩ; R_0603_1608Metric
R23: 12.1kΩ; R_0603_1608Metric
U2: TLVM13640; TI_B3QFN-20

Connections:
/3.3V Buck/PG: C25.1, U2.14 (EN); also elsewhere on the board
/12V Buck-Boost/5V: C19.1, C20.1, C21.1, C22.1, C26.1, R20.1, U2.5 (VLDOIN), U2.8 (VOUT1), U2.9 (VOUT2); also elsewhere on the board
/12V Buck-Boost/EN: U2.13 (PG); also elsewhere on the board
/12V Buck-Boost/VIN: C23.1, C24.1, U2.1 (VIN1), U2.16 (VIN2); also elsewhere on the board
GND: C20.2, C21.2, C22.2, C23.2, C24.2, C25.2, C26.2, R22.2, R23.2, U2.6 (AGND), U2.11 (AGND), U2.17 (PGND), U2.18 (PGND), U2.19 (PGND), U2.20 (PGND); also elsewhere on the board
unnamed: R21.2, U2.3 (CBOOT)
unnamed: C19.2, R20.2, R22.1, U2.10 (FB)
unnamed: R21.1, U2.4 (RBOOT)
unnamed: R23.1, U2.12 (RT)

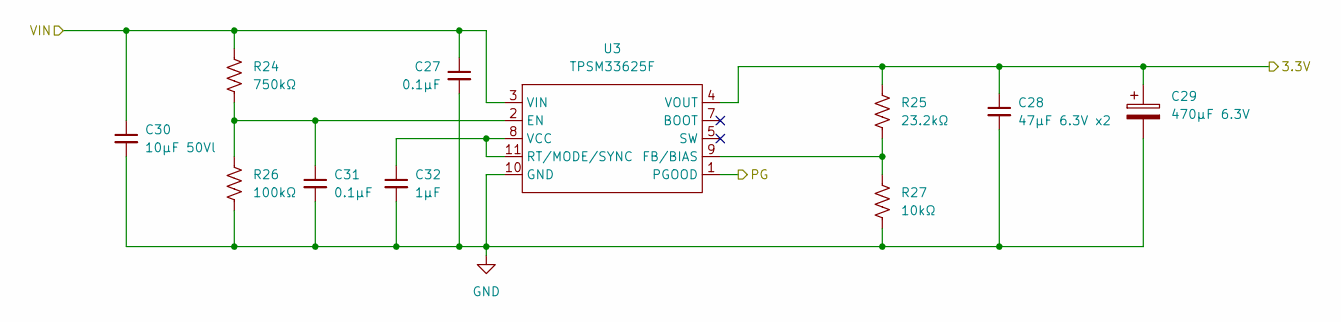
[picture p53: schematic 3.3v-buck.kicad_sch]

Parts:
C27, C31: 0.1µF; C_0603_1608Metric
C28: 47µF 6.3V x2; C_1210_3225Metric
C29: 470µF 6.3V; CP_Radial_D6.3mm_P2.50mm
C30: 10µF 50Vl; C_1210_3225Metric
C32: 1µF; C_0603_1608Metric
R24: 750kΩ; R_0603_1608Metric
R25: 23.2kΩ; R_0603_1608Metric
R26: 100kΩ; R_0603_1608Metric
R27: 10kΩ; R_0603_1608Metric
U3: TPSM33625F; TI_QFN-FCMOD-HR

Connections:
/3.3V Buck/3.3V: C28.1, C29.1, R25.1, U3.4 (VOUT); also elsewhere on the board
/3.3V Buck/PG: U3.1 (PGOOD); also elsewhere on the board
/12V Buck-Boost/VIN: C27.1, C30.1, R24.1, U3.3 (VIN); also elsewhere on the board
GND: C27.2, C28.2, C29.2, C30.2, C31.2, C32.2, R26.2, R27.2, U3.10 (GND); also elsewhere on the board
unnamed: C31.1, R24.2, R26.1, U3.2 (EN)
unnamed: R25.2, R27.1, U3.9 (FB/BIAS)
unnamed: C32.1, U3.8 (VCC), U3.11 (RT/MODE/SYNC)

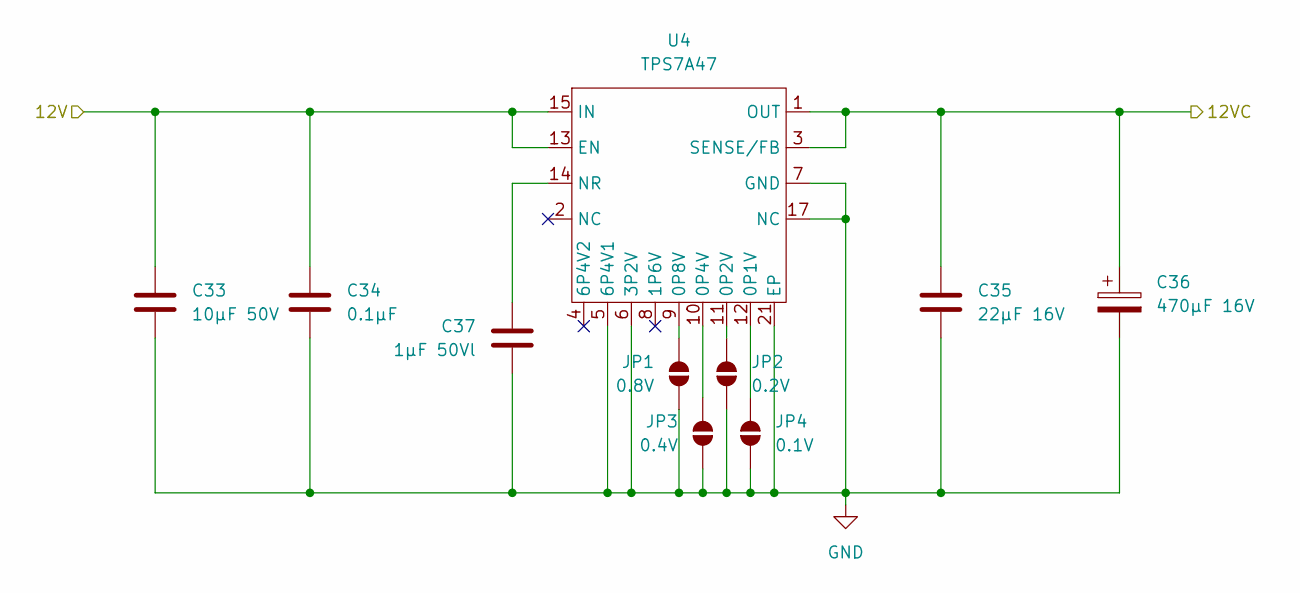
[picture p54: schematic 12v-clean-ldo.kicad_sch]

Parts:
C33: 10µF 50V; C_1206_3216Metric
C34: 0.1µF; C_0603_1608Metric
C35: 22µF 16V; C_1210_3225Metric
C36: 470µF 16V; CP_Radial_D6.3mm_P2.50mm
C37: 1µF 50Vl; C_0805_2012Metric
JP1: 0.8V; SolderJumper-2_P1.3mm_Open_RoundedPad1.0x1.5mm
JP2: 0.2V; SolderJumper-2_P1.3mm_Open_RoundedPad1.0x1.5mm
JP3: 0.4V; SolderJumper-2_P1.3mm_Open_RoundedPad1.0x1.5mm
JP4: 0.1V; SolderJumper-2_P1.3mm_Open_RoundedPad1.0x1.5mm
U4: TPS7A47; Texas_RGW0020A_VQFN-20-1EP_5x5mm_P0.65mm_EP3.15x3.15mm

Connections:
/12V Clean LDO/12V: C33.1, C34.1, U4.13 (EN), U4.15 (IN), U4.16 (IN); also elsewhere on the board
/12V Clean LDO/12VC: C35.1, C36.1, U4.1 (OUT), U4.3 (SENSE/FB), U4.20 (OUT); also elsewhere on the board
GND: C33.2, C34.2, C35.2, C36.2, C37.2, JP1.1 (A), JP2.1 (A), JP3.1 (A), JP4.1 (A), U4.5 (6P4V1), U4.6 (3P2V), U4.7 (GND), U4.17 (NC), U4.18 (NC), U4.19 (NC), U4.21 (EP); also elsewhere on the board
unnamed: JP1.2 (B), U4.9 (0P8V)
unnamed: JP2.2 (B), U4.11 (0P2V)
unnamed: JP3.2 (B), U4.10 (0P4V)
unnamed: JP4.2 (B), U4.12 (0P1V)
unnamed: C37.1, U4.14 (NR)

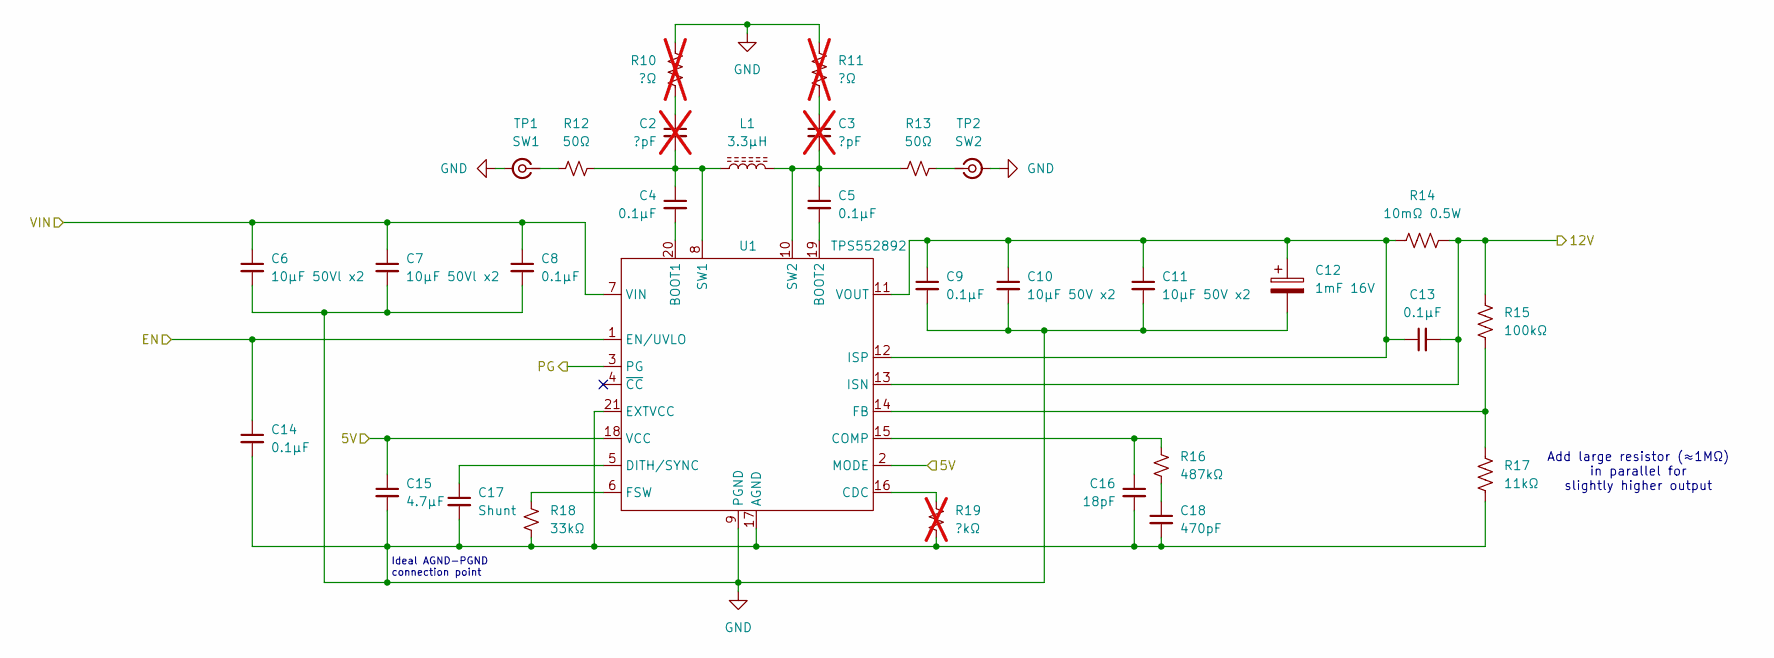
[picture p55: schematic 12v-buck-boost.kicad_sch]

Parts:
C2, C3: ?pF; C_0603_1608Metric; not fitted
C4, C5, C8, C9, C13, C14: 0.1µF; C_0603_1608Metric
C6, C7: 10µF 50Vl x2; C_1210_3225Metric
C10, C11: 10µF 50V x2; C_1206_3216Metric
C12: 1mF 16V; CP_Radial_D8.0mm_P3.50mm
C15: 4.7µF; C_0603_1608Metric
C16: 18pF; C_0603_1608Metric
C17: Shunt; C_0603_1608Metric
C18: 470pF; C_0603_1608Metric
L1: 3.3µH; L_Vishay_IHLP-2525
R10, R11: ?Ω; R_1206_3216Metric; not fitted
R12, R13: 50Ω; R_0603_1608Metric
R14: 10mΩ 0.5W; R_0805_2012Metric
R15: 100kΩ; R_0603_1608Metric
R16: 487kΩ; R_0603_1608Metric
R17: 11kΩ; R_0603_1608Metric
R18: 33kΩ; R_0603_1608Metric
R19: ?kΩ; R_0603_1608Metric; not fitted
TP1: SW1; U.FL_Molex_MCRF_73412-0110_Vertical
TP2: SW2; U.FL_Molex_MCRF_73412-0110_Vertical
U1: TPS552892; TI_VQFN-HR-21

Connections:
/12V Buck-Boost/5V: C15.1, U1.2 (MODE), U1.18 (VCC); also elsewhere on the board
/12V Buck-Boost/12V: C13.2, R14.2, R15.1, U1.13 (ISN); also elsewhere on the board
/12V Buck-Boost/EN: C14.1, U1.1 (EN/UVLO); also elsewhere on the board
/12V Buck-Boost/PG: U1.3 (PG); also elsewhere on the board
/12V Buck-Boost/VIN: C6.1, C7.1, C8.1, U1.7 (VIN); also elsewhere on the board
GND: C6.2, C7.2, C8.2, C9.2, C10.2, C11.2, C12.2, C14.2, C15.2, C16.2, C17.2, C18.2, R10.1, R11.1, R17.2, R18.2, R19.2, TP1.2 (Ext), TP2.2 (Ext), U1.9 (PGND), U1.17 (AGND), U1.21 (EXTVCC); also elsewhere on the board
unnamed: C2.1, R10.2
unnamed: C3.1, R11.2
unnamed: C18.1, R16.2
unnamed: R12.2, TP1.1 (In)
unnamed: R13.2, TP2.1 (In)
unnamed: C4.2, U1.20 (BOOT1)
unnamed: C5.2, U1.19 (BOOT2)
unnamed: R19.1, U1.16 (CDC)
unnamed: C16.1, R16.1, U1.15 (COMP)
unnamed: C17.1, U1.5 (DITH/SYNC)
unnamed: R15.2, R17.1, U1.14 (FB)
unnamed: R18.1, U1.6 (FSW)
unnamed: C9.1, C10.1, C11.1, C12.1, C13.1, R14.1, U1.11 (VOUT), U1.12 (ISP)
unnamed: C2.2, C4.1, L1.1, R12.1, U1.8 (SW1)
unnamed: C3.2, C5.1, L1.2, R13.1, U1.10 (SW2)

Notes on the sheet:
Add large resistor (≈1MΩ) in parallel for slightly higher output
Ideal AGND-PGND connection point
