BlockWorker/ModularAudio/BasePower/BasePower.kicad_pcb

## KiCad design BasePower/BasePower.kicad_pcb (continued)

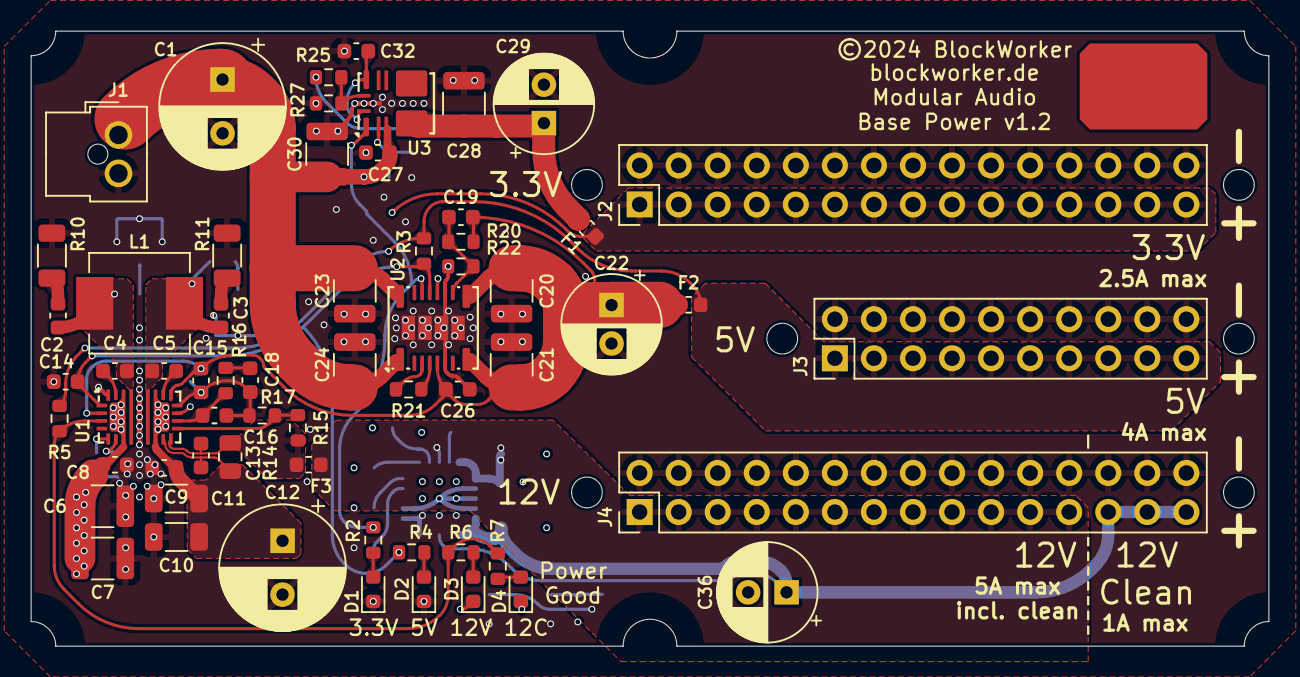
[picture p56: board BasePower.kicad_pcb from above]

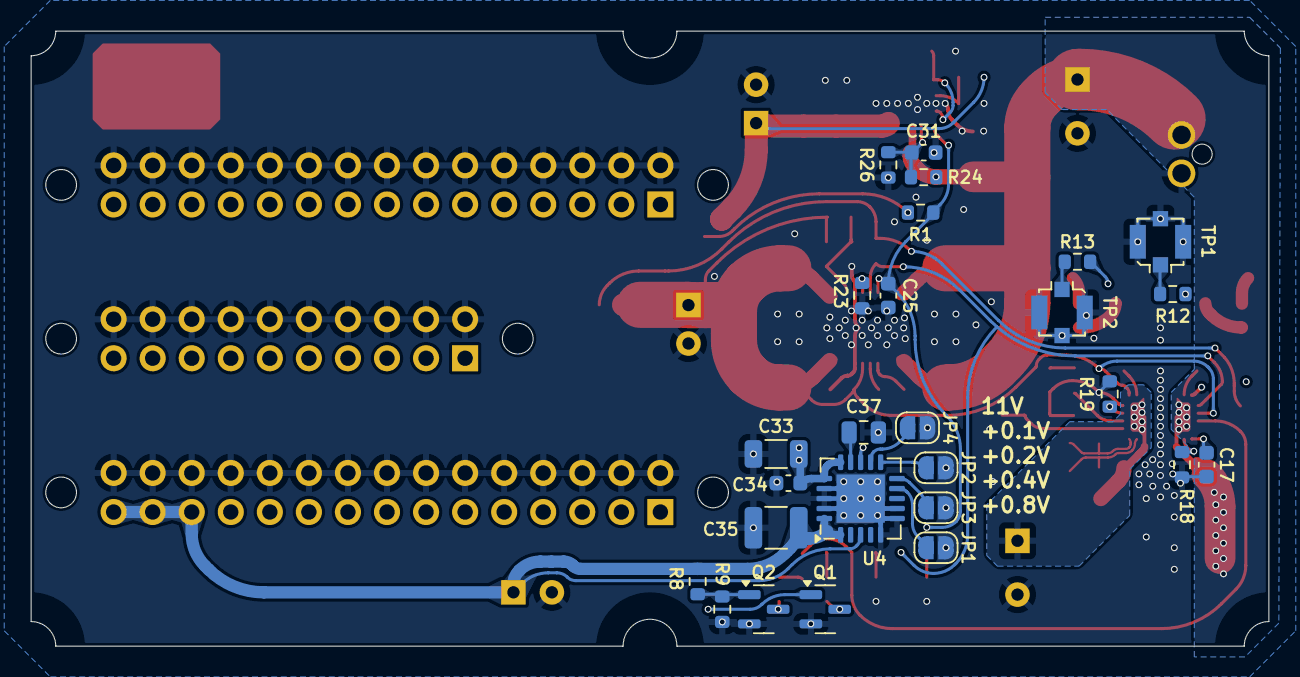
[picture p57: board BasePower.kicad_pcb from below]

Board: 4 copper layers, 80.5 x 40.0 mm, 94 parts (26 on the bottom side), 46 nets.

Other parts of the board:
Hole1, Hole2, Hole3, Hole4, Hole5, Hole6: Hole_2mm
