BlockWorker/ModularAudio/BatteryMonitor/BatteryMonitor.kicad_pcb

## KiCad design BatteryMonitor/BatteryMonitor.kicad_pcb (2025-01-18)

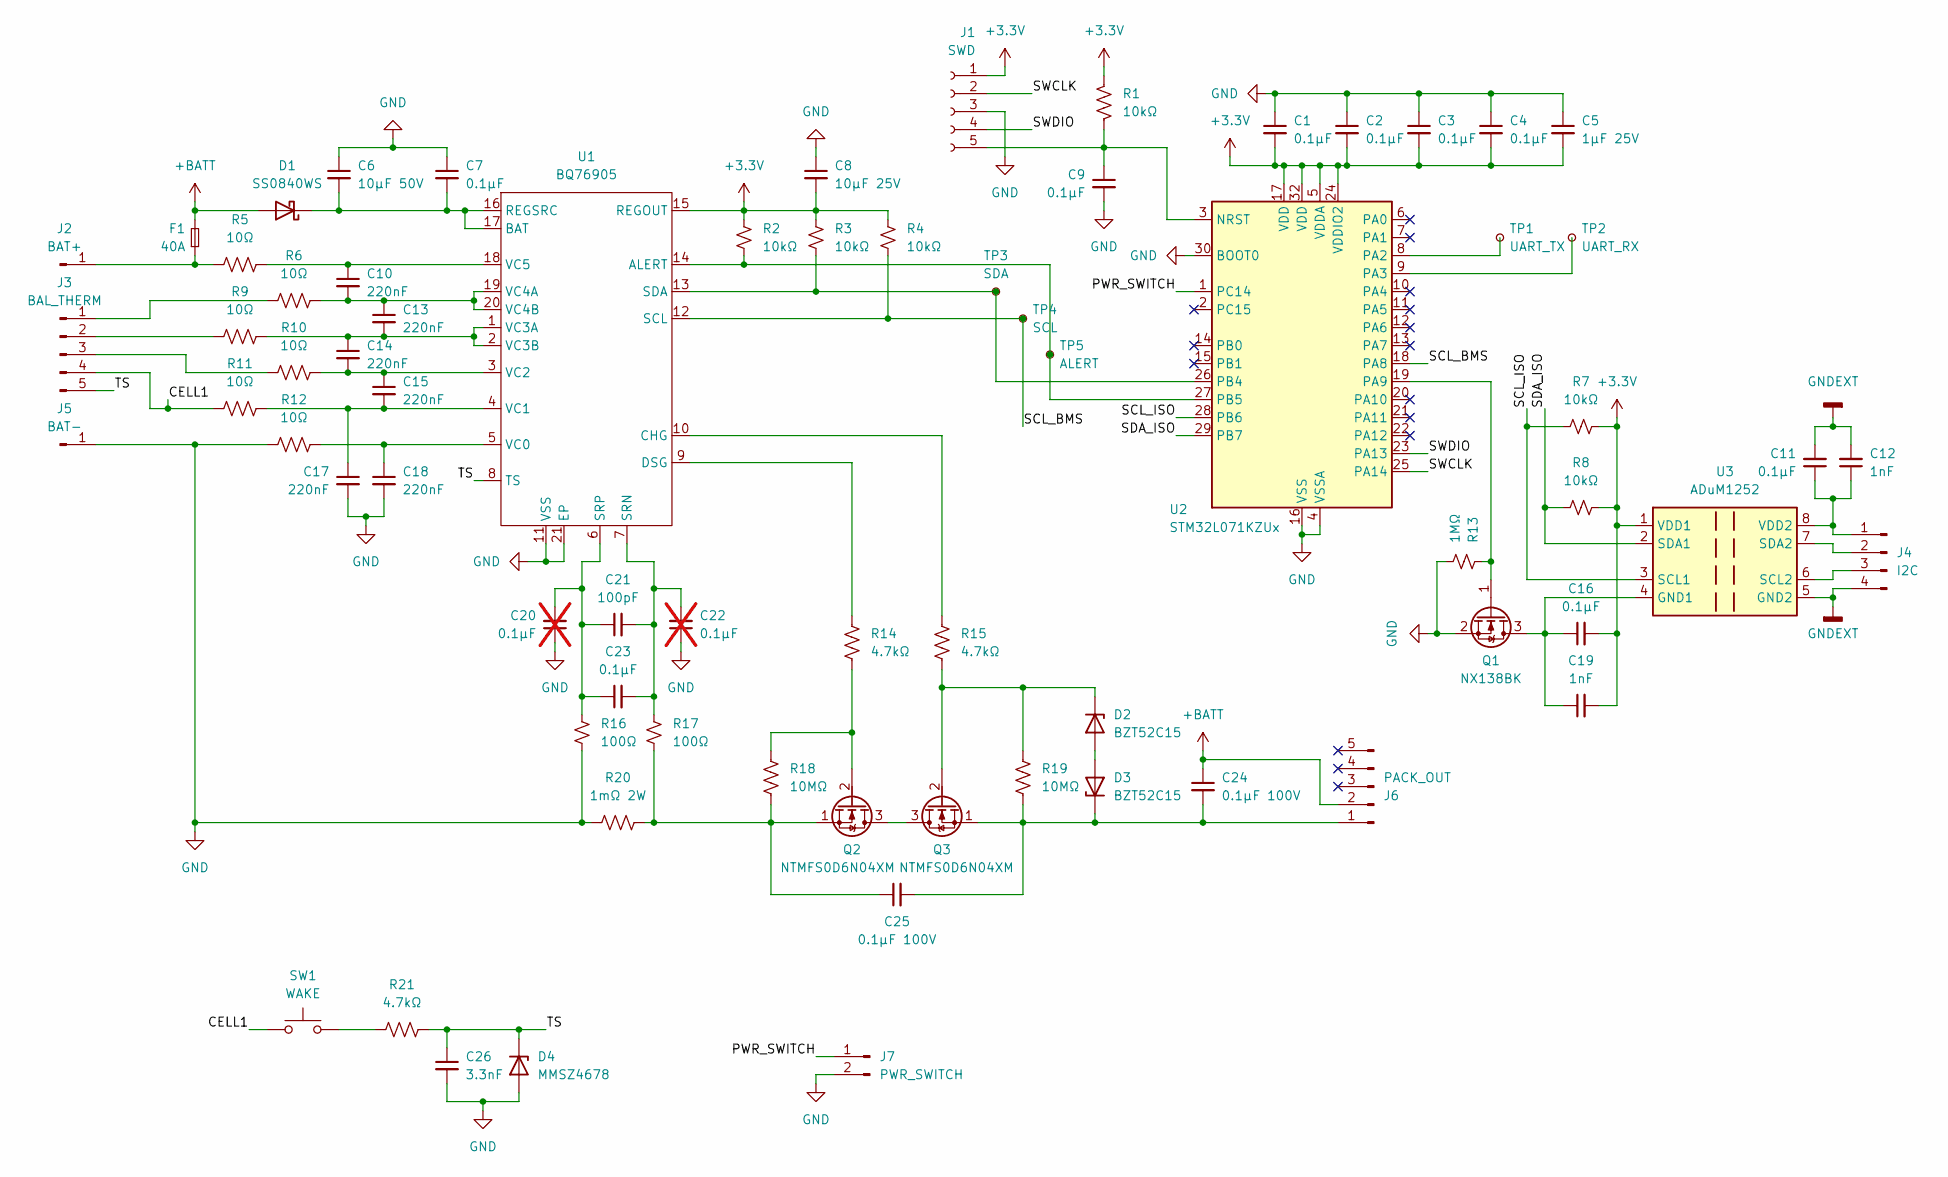
[picture p58: schematic BatteryMonitor.kicad_sch]

Parts:
C1, C2, C3, C4, C7, C9, C11, C16, C23: 0.1µF; C_0603_1608Metric
C5: 1µF 25V; C_0603_1608Metric
C6: 10µF 50V; C_1206_3216Metric
C8: 10µF 25V; C_0805_2012Metric
C10, C13, C14, C15, C17, C18: 220nF; C_0603_1608Metric
C12, C19: 1nF; C_0603_1608Metric
C20, C22: 0.1µF; C_0603_1608Metric; not fitted
C21: 100pF; C_0603_1608Metric
C24, C25: 0.1µF 100V; C_0603_1608Metric
C26: 3.3nF; C_0603_1608Metric
D1: SS0840WS; D_SOD-323_HandSoldering
D2, D3: BZT52C15; D_SOD-123
D4: MMSZ4678; D_SOD-123
F1: 40A; Fuse_2410_6125Metric
J1: SWD; PinSocket_1x05_P1.27mm_Vertical_SMD_Pin1Right
J2: BAT+; Wuerth_REDCUBE-THR_WP-BUTR_7461057_NonPress
J3: BAL_THERM; Amphenol_MINITEK_WTB_1.25_5P
J4: I2C; Amphenol_MINITEK_WTB_1.25_4P
J5: BAT-; Wuerth_REDCUBE-THR_WP-BUTR_7461057_NonPress
J6: PACK_OUT; TE_2042274_Solder
J7: PWR_SWITCH; Amphenol_MINITEK_WTB_1.25_2P
Q1: NX138BK; SOT-23-3
Q2, Q3: NTMFS0D6N04XM; ONSemi_SO8-FL_506FA
R1, R2, R3, R4, R7, R8: 10kΩ; R_0603_1608Metric
R5, R6, R9, R10, R11, R12: 10Ω; R_0603_1608Metric
R13: 1MΩ; R_0603_1608Metric
R14, R15, R21: 4.7kΩ; R_0603_1608Metric
R16, R17: 100Ω; R_0603_1608Metric
R18, R19: 10MΩ; R_0603_1608Metric
R20: 1mΩ 2W; R_0612_1632Metric
SW1: WAKE; SW_SPST_TL3305A
TP1: UART_TX; TP_0603_1608Metric_Fused
TP2: UART_RX; TP_0603_1608Metric_Fused
TP3: SDA; TP_0603_1608Metric_Fused
TP4: SCL; TP_0603_1608Metric_Fused
TP5: ALERT; TP_0603_1608Metric_Fused
U1: BQ76905; VQFN-20-1EP_3.5x3.5mm_P0.5mm_EP2.05x2.05mm
U2: STM32L071KZUx; QFN-32-1EP_5x5mm_P0.5mm_EP3.45x3.45mm
U3: ADuM1252; MSOP-8_3x3mm_P0.65mm

Connections:
+3.3V: C1.2, C2.2, C3.2, C4.2, C5.2, C8.2, C16.2, C19.2, J1.1, R1.1, R2.1, R3.1, R4.1, R7.1, R8.1, U1.15 (REGOUT), U2.5 (VDDA), U2.17 (VDD), U2.24 (VDDIO2), U2.32 (VDD), U3.1 (VDD1)
+BATT: C24.1, D1.2 (A), F1.2, J6.2
/CELL1: J3.4, R11.1, SW1.1
/PWR_SWITCH: J7.1, U2.1 (PC14)
/SCL_BMS: R4.2, TP4.1, U1.12 (SCL), U2.18 (PA8)
/SCL_ISO: R7.2, U2.28 (PB6), U3.3 (SCL1)
/SDA_ISO: R8.2, U2.29 (PB7), U3.2 (SDA1)
/SWCLK: J1.2, U2.25 (PA14)
/SWDIO: J1.4, U2.23 (PA13)
/TS: C26.1, D4.1 (K), J3.5, R21.2, U1.8 (TS)
GND: C1.1, C2.1, C3.1, C4.1, C5.1, C6.1, C7.1, C8.1, C9.2, C17.2, C18.2, C20.1, C22.1, C26.2, D4.2 (A), J1.3, J5.1, J7.2, Q1.2 (S), R12.1, R13.2, R16.2, R20.1, U1.11 (VSS), U1.21 (EP), U2.4 (VSSA), U2.16 (VSS), U2.30 (BOOT0), U2.31 (VSS), U2.33 (VSS)
GNDEXT: C11.2, C12.2, J4.4, U3.5 (GND2)
unnamed: C6.2, C7.2, D1.1 (K), U1.16 (REGSRC), U1.17 (BAT)
unnamed: D2.2 (A), D3.2 (A)
unnamed: D2.1 (K), Q3.2 (G), R15.2, R19.1
unnamed: C24.2, C25.2, D3.1 (K), J6.1, Q3.1 (S), R19.2
unnamed: C9.1, J1.5, R1.2, U2.3 (NRST)
unnamed: F1.1, J2.1, R5.1
unnamed: J3.1, R6.1
unnamed: J3.2, R9.1
unnamed: J3.3, R10.1
unnamed: C11.1, C12.1, J4.1, U3.8 (VDD2)
unnamed: J4.2, U3.7 (SDA2)
unnamed: J4.3, U3.6 (SCL2)
unnamed: C16.1, C19.1, Q1.3 (D), U3.4 (GND1)
unnamed: Q1.1 (G), R13.1, U2.19 (PA9)
unnamed: Q2.3 (D), Q3.3 (D)
unnamed: Q2.2 (G), R14.2, R18.1
unnamed: C25.1, Q2.1 (S), R17.2, R18.2, R20.2
unnamed: R21.1, SW1.2
unnamed: R2.2, TP5.1, U1.14 (ALERT), U2.27 (PB5)
unnamed: R15.1, U1.10 (CHG)
unnamed: R14.1, U1.9 (DSG)
unnamed: R3.2, TP3.1, U1.13 (SDA), U2.26 (PB4)
unnamed: C21.2, C22.2, C23.2, R17.1, U1.7 (SRN)
unnamed: C20.2, C21.1, C23.1, R16.1, U1.6 (SRP)
unnamed: C18.1, R12.2, U1.5 (VC0)
unnamed: C15.2, C17.1, R11.2, U1.4 (VC1)
unnamed: C14.2, C15.1, R10.2, U1.3 (VC2)
unnamed: C13.2, C14.1, R9.2, U1.1 (VC3A), U1.2 (VC3B)
unnamed: C10.2, C13.1, R6.2, U1.19 (VC4A), U1.20 (VC4B)
unnamed: C10.1, R5.2, U1.18 (VC5)
unnamed: TP1.1, U2.8 (PA2)
unnamed: TP2.1, U2.9 (PA3)

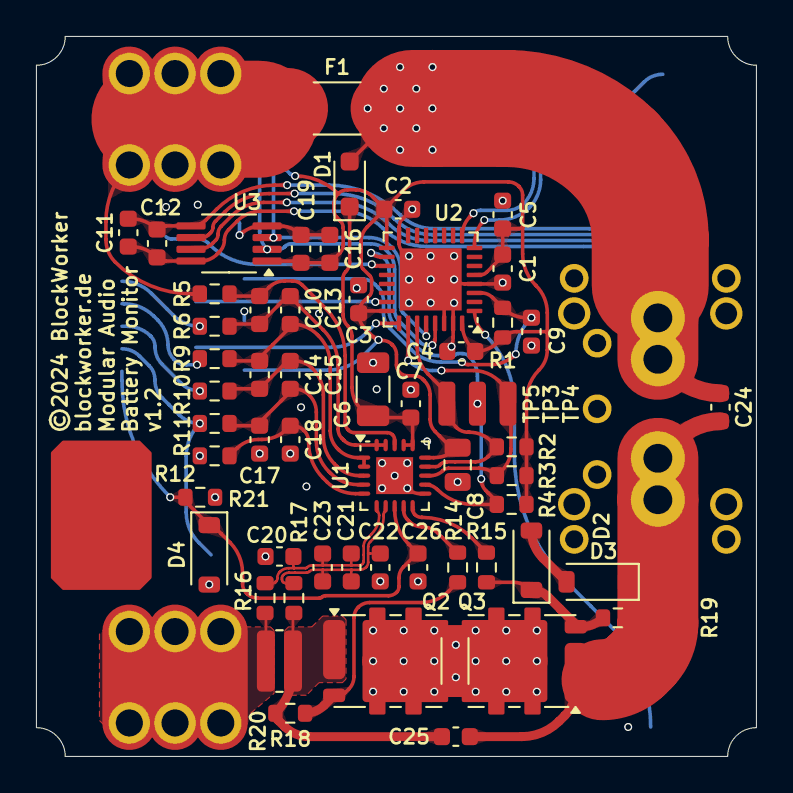
[picture p59: board BatteryMonitor.kicad_pcb from above]

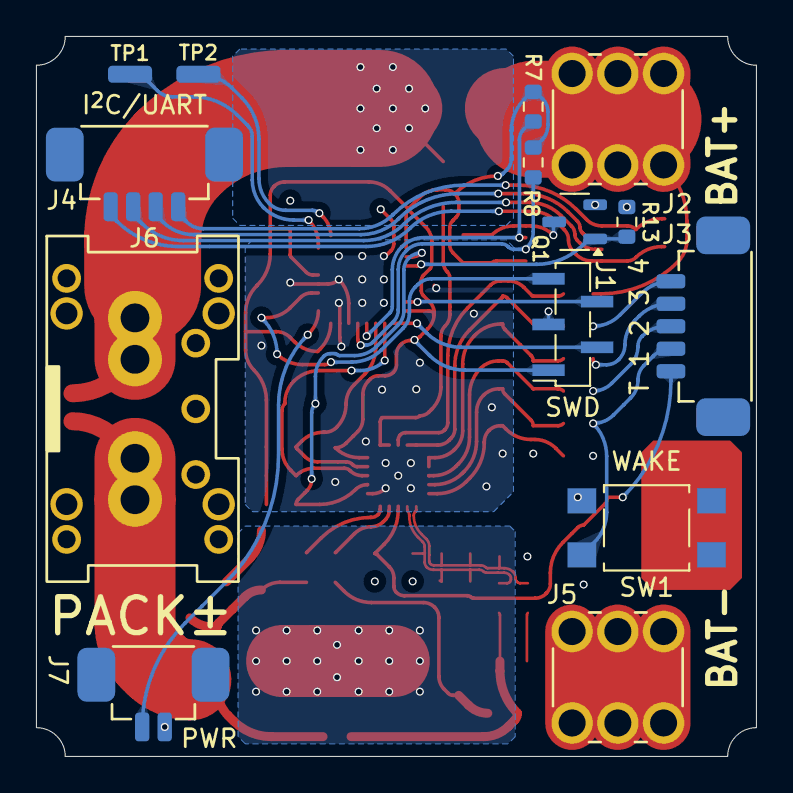
[picture p60: board BatteryMonitor.kicad_pcb from below]

Board: 4 copper layers, 40.0 x 40.0 mm, 71 parts (14 on the bottom side), 44 nets.
