BlockWorker/ModularAudio/BluetoothReceiver/BluetoothReceiver.kicad_pcb

## KiCad design BluetoothReceiver/BluetoothReceiver.kicad_pcb (2025-01-02)

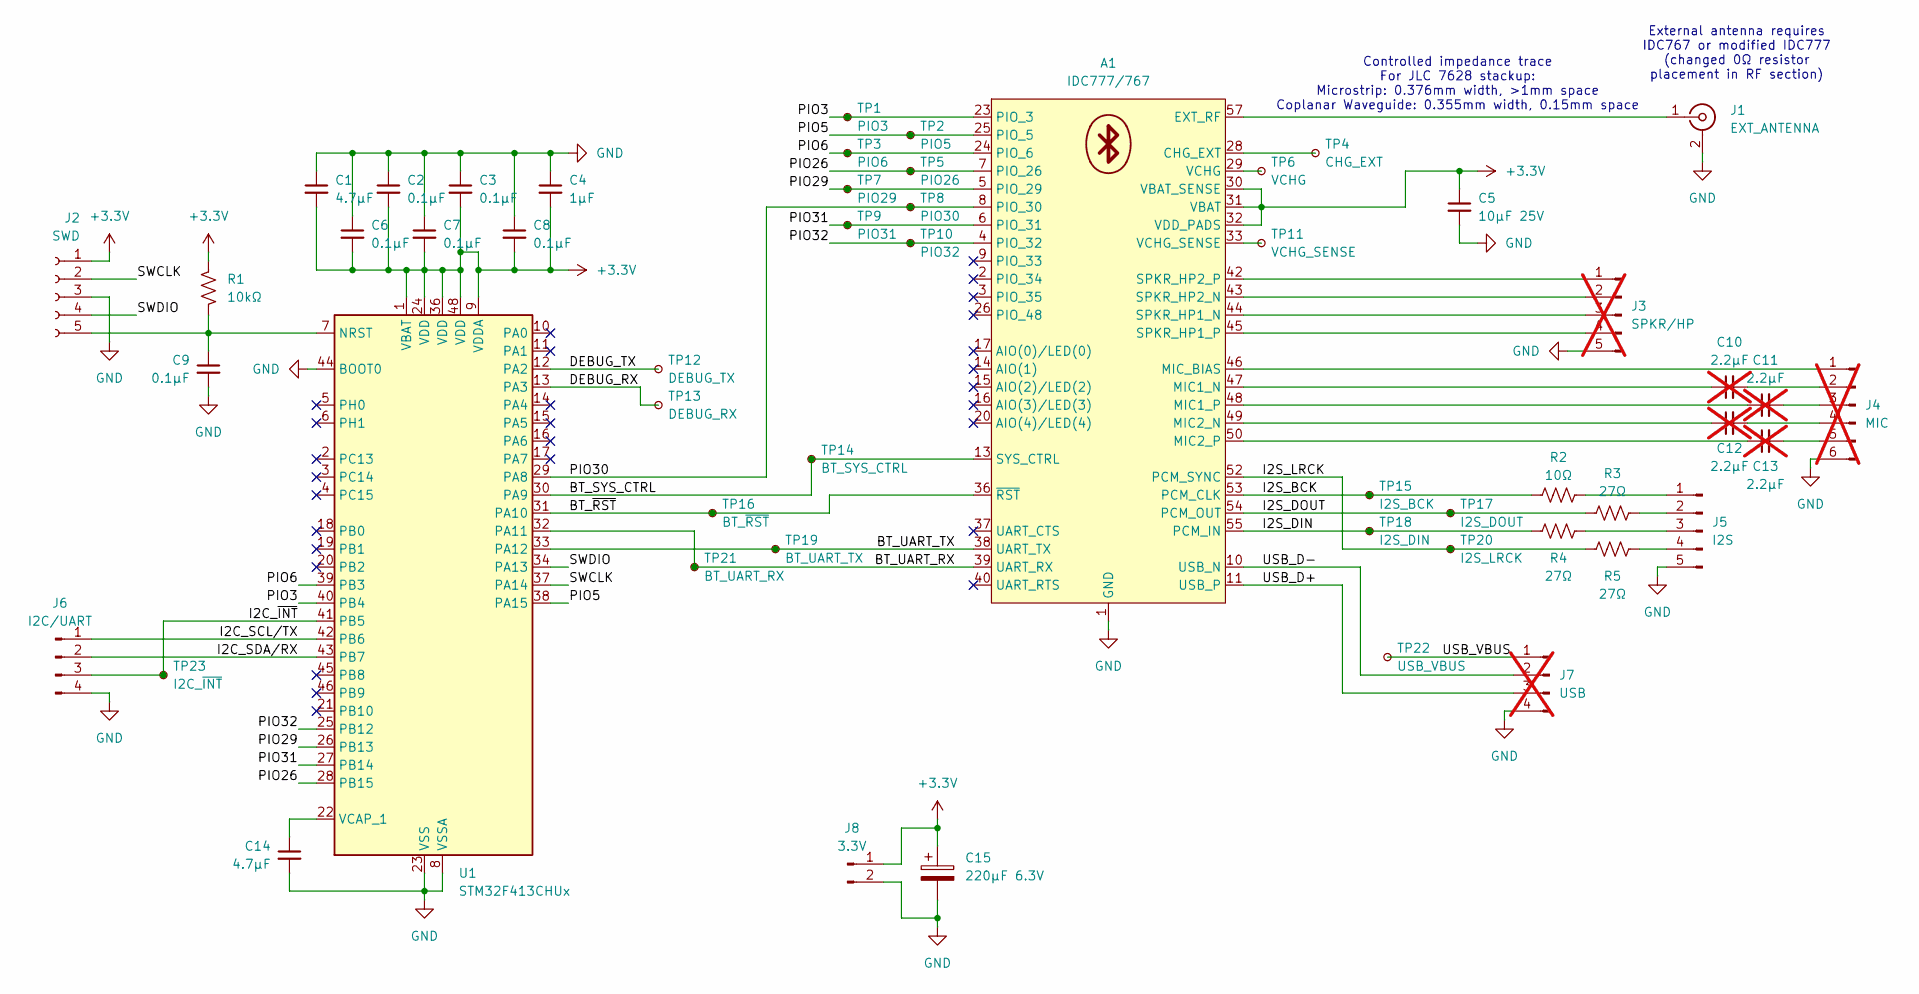
[picture p61: schematic BluetoothReceiver.kicad_sch]

Parts:
A1: IDC777/767; IDC777_767
C1, C14: 4.7µF; C_0603_1608Metric
C2, C3, C6, C7, C8, C9: 0.1µF; C_0603_1608Metric
C4: 1µF; C_0603_1608Metric
C5: 10µF 25V; C_0805_2012Metric
C10, C11, C12, C13: 2.2µF; C_0603_1608Metric; not fitted
C15: 220µF 6.3V; CP_Elec_5x5.8
J1: EXT_ANTENNA; U.FL_Molex_MCRF_73412-0110_Vertical
J2: SWD; PinSocket_1x05_P1.27mm_Vertical_SMD_Pin1Right
J3: SPKR/HP; Amphenol_MINITEK_WTB_1.25_5P; not fitted
J4: MIC; Amphenol_MINITEK_WTB_1.25_6P; not fitted
J5: I2S; Amphenol_MINITEK_WTB_1.25_5P
J6: I2C/UART; Amphenol_MINITEK_WTB_1.25_4P
J7: USB; Amphenol_MINITEK_0.8_4P_V; not fitted
J8: 3.3V; Amphenol_MINITEK_WTB_1.25_2P
R1: 10kΩ; R_0603_1608Metric
R2: 10Ω; R_0603_1608Metric
R3, R4, R5: 27Ω; R_0603_1608Metric
TP1: PIO3; TestPoint_Pad_D1.0mm
TP2: PIO5; TestPoint_Pad_D1.0mm
TP3: PIO6; TestPoint_Pad_D1.0mm
TP4: CHG_EXT; TestPoint_Pad_D1.0mm
TP5: PIO26; TestPoint_Pad_D1.0mm
TP6: VCHG; TestPoint_Pad_D1.0mm
TP7: PIO29; TestPoint_Pad_D1.0mm
TP8: PIO30; TestPoint_Pad_D1.0mm
TP9: PIO31; TestPoint_Pad_D1.0mm
TP10: PIO32; TestPoint_Pad_D1.0mm
TP11: VCHG_SENSE; TestPoint_Pad_D1.0mm
TP12: DEBUG_TX; TP_0603_1608Metric_Fused
TP13: DEBUG_RX; TP_0603_1608Metric_Fused
TP14: BT_SYS_CTRL; TP_0603_1608Metric_Fused
TP15: I2S_BCK; TP_0603_1608Metric_Fused
TP16: BT_~{RST}; TP_0603_1608Metric_Fused
TP17: I2S_DOUT; TP_0603_1608Metric_Fused
TP18: I2S_DIN; TP_0603_1608Metric_Fused
TP19: BT_UART_TX; TP_0603_1608Metric_Fused
TP20: I2S_LRCK; TP_0603_1608Metric_Fused
TP21: BT_UART_RX; TP_0603_1608Metric_Fused
TP22: USB_VBUS; TestPoint_Pad_D1.0mm
TP23: I2C_~{INT}; TP_0603_1608Metric_Fused
U1: STM32F413CHUx; QFN-48-1EP_7x7mm_P0.5mm_EP5.6x5.6mm

Connections:
+3.3V: A1.30 (VBAT_SENSE), A1.31 (VBAT), A1.32 (VDD_PADS), C1.2, C2.2, C3.2, C4.2, C5.1, C6.2, C7.2, C8.2, C15.1, J2.1, J8.1, R1.1, U1.1 (VBAT), U1.9 (VDDA), U1.24 (VDD), U1.36 (VDD), U1.48 (VDD)
/BT_SYS_CTRL: A1.13 (SYS_CTRL), TP14.1, U1.30 (PA9)
/BT_UART_RX: A1.39 (UART_RX), TP21.1, U1.32 (PA11)
/BT_UART_TX: A1.38 (UART_TX), TP19.1, U1.33 (PA12)
/BT_~RST: A1.36 (~RST), TP16.1, U1.31 (PA10)
/DEBUG_RX: TP13.1, U1.13 (PA3)
/DEBUG_TX: TP12.1, U1.12 (PA2)
/I2C_SCL/TX: J6.1, U1.42 (PB6)
/I2C_SDA/RX: J6.2, U1.43 (PB7)
/I2C_~INT: J6.3, TP23.1, U1.41 (PB5)
/I2S_BCK: A1.53 (PCM_CLK), R2.1, TP15.1
/I2S_DIN: A1.55 (PCM_IN), R4.1, TP18.1
/I2S_DOUT: A1.54 (PCM_OUT), R3.1, TP17.1
/I2S_LRCK: A1.52 (PCM_SYNC), R5.1, TP20.1
/PIO3: A1.23 (PIO_3), TP1.1, U1.40 (PB4)
/PIO5: A1.25 (PIO_5), TP2.1, U1.38 (PA15)
/PIO6: A1.24 (PIO_6), TP3.1, U1.39 (PB3)
/PIO26: A1.7 (PIO_26), TP5.1, U1.28 (PB15)
/PIO29: A1.5 (PIO_29), TP7.1, U1.26 (PB13)
/PIO30: A1.8 (PIO_30), TP8.1, U1.29 (PA8)
/PIO31: A1.6 (PIO_31), TP9.1, U1.27 (PB14)
/PIO32: A1.4 (PIO_32), TP10.1, U1.25 (PB12)
/SWCLK: J2.2, U1.37 (PA14)
/SWDIO: J2.4, U1.34 (PA13)
/USB_D+: A1.11 (USB_P), J7.3
/USB_D-: A1.10 (USB_N), J7.2
/USB_VBUS: J7.1, TP22.1
GND: A1.1 (GND), A1.12 (GND), A1.18 (GND), A1.19 (GND), A1.21 (GND), A1.22 (GND), A1.27 (GND), A1.34 (GND), A1.35 (GND), A1.41 (GND), A1.51 (GND), A1.56 (GND), A1.58 (GND), A1.59 (GND), A1.60 (GND), C1.1, C2.1, C3.1, C4.1, C5.2, C6.1, C7.1, C8.1, C9.2, C14.2, C15.2, J1.2 (Ext), J2.3, J3.5, J4.6, J5.5, J6.4, J7.4, J8.2, U1.8 (VSSA), U1.23 (VSS), U1.35 (VSS), U1.44 (BOOT0), U1.47 (VSS), U1.49 (VSS)
unnamed: A1.28 (CHG_EXT), TP4.1
unnamed: A1.57 (EXT_RF), J1.1 (In)
unnamed: A1.47 (MIC1_N), C10.1
unnamed: A1.48 (MIC1_P), C11.1
unnamed: A1.49 (MIC2_N), C12.1
unnamed: A1.50 (MIC2_P), C13.1
unnamed: A1.46 (MIC_BIAS), J4.1
unnamed: A1.44 (SPKR_HP1_N), J3.3
unnamed: A1.45 (SPKR_HP1_P), J3.4
unnamed: A1.43 (SPKR_HP2_N), J3.2
unnamed: A1.42 (SPKR_HP2_P), J3.1
unnamed: A1.29 (VCHG), TP6.1
unnamed: A1.33 (VCHG_SENSE), TP11.1
unnamed: C9.1, J2.5, R1.2, U1.7 (NRST)
unnamed: C10.2, J4.2
unnamed: C11.2, J4.3
unnamed: C12.2, J4.4
unnamed: C13.2, J4.5
unnamed: J5.1, R2.2
unnamed: J5.2, R3.2
unnamed: J5.3, R4.2
unnamed: J5.4, R5.2
unnamed: C14.1, U1.22 (VCAP_1)

Notes on the sheet:
Controlled impedance trace For JLC 7628 stackup: Microstrip: 0.376mm width, >1mm space Coplanar Waveguide: 0.355mm width, 0.15mm space
External antenna requires IDC767 or modified IDC777 (changed 0Ω resistor placement in RF section)

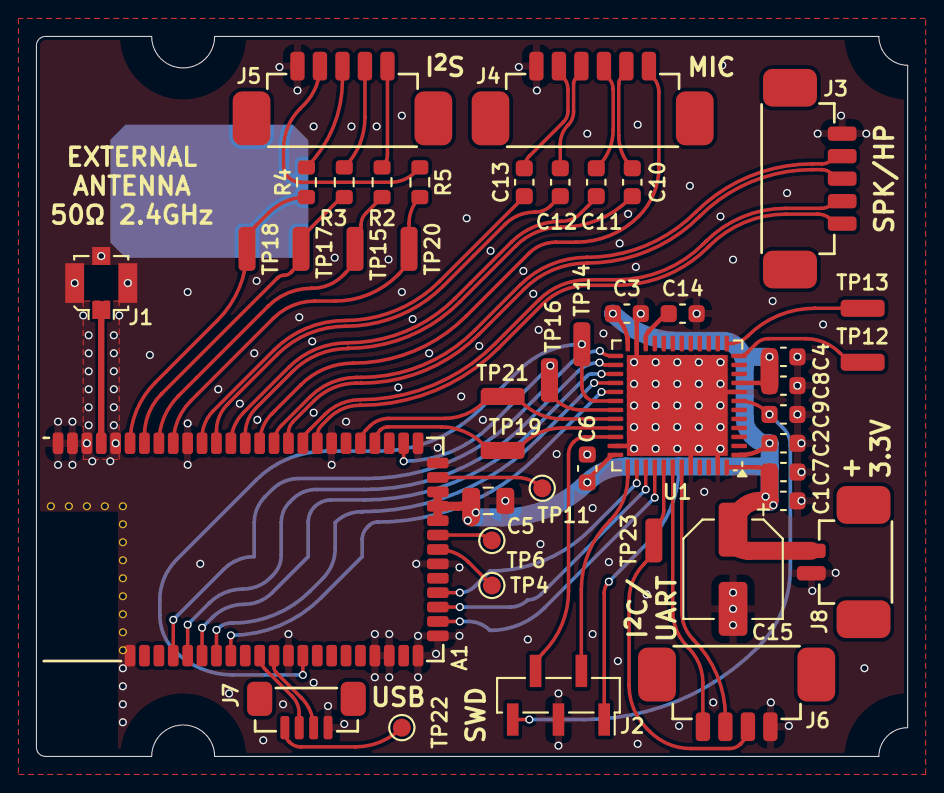
[picture p62: board BluetoothReceiver.kicad_pcb from above]

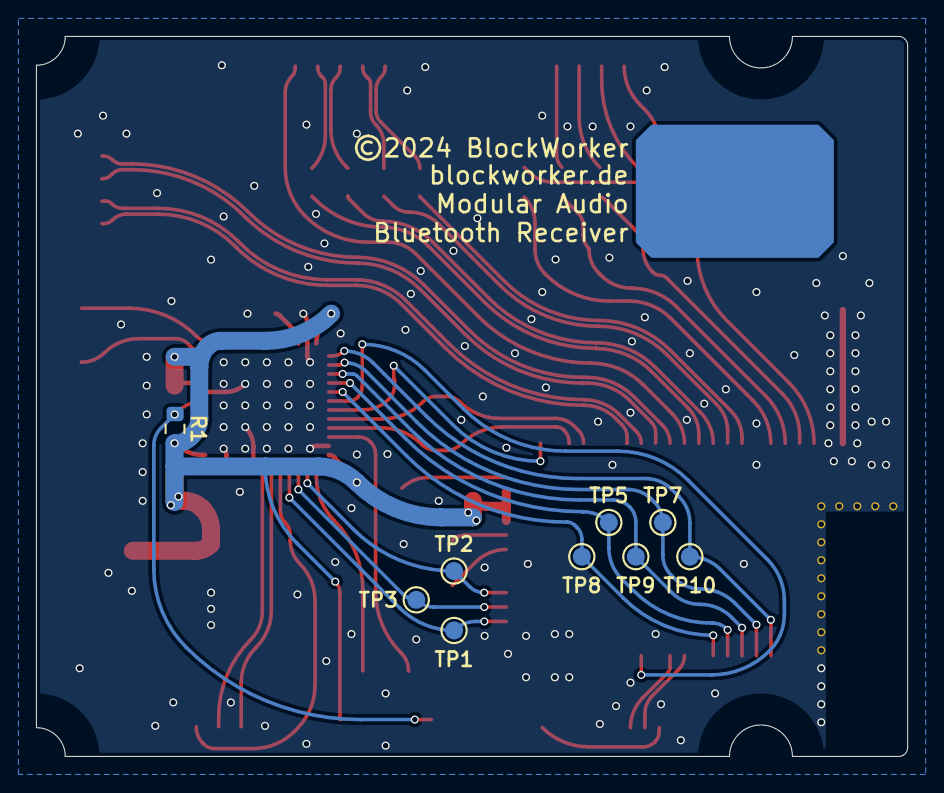
[picture p63: board BluetoothReceiver.kicad_pcb from below]

Board: 4 copper layers, 48.4 x 40.0 mm, 53 parts (9 on the bottom side), 51 nets.
