BlockWorker/ModularAudio/12VLDO/12VLDO.kicad_pcb

## KiCad design 12VLDO/12VLDO.kicad_pcb (2024-12-28)

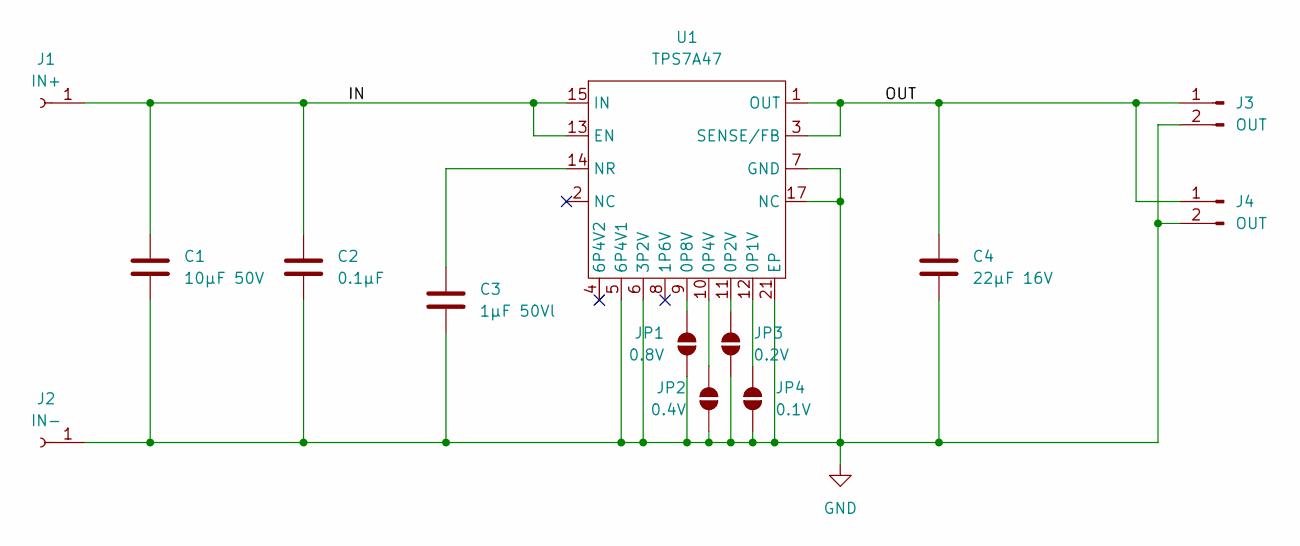
[picture p64: schematic 12VLDO.kicad_sch]

Parts:
C1: 10µF 50V; C_1206_3216Metric
C2: 0.1µF; C_0603_1608Metric
C3: 1µF 50Vl; C_0805_2012Metric
C4: 22µF 16V; C_1210_3225Metric
J1: IN+; SolderWirePad_1x01_SMD_1x2mm
J2: IN-; SolderWirePad_1x01_SMD_1x2mm
J3, J4: OUT; Amphenol_MINITEK_0.8_2P_V
JP1: 0.8V; SolderJumper-2_P1.3mm_Open_RoundedPad1.0x1.5mm
JP2: 0.4V; SolderJumper-2_P1.3mm_Open_RoundedPad1.0x1.5mm
JP3: 0.2V; SolderJumper-2_P1.3mm_Open_RoundedPad1.0x1.5mm
JP4: 0.1V; SolderJumper-2_P1.3mm_Open_RoundedPad1.0x1.5mm
U1: TPS7A47; Texas_RGW0020A_VQFN-20-1EP_5x5mm_P0.65mm_EP3.15x3.15mm

Connections:
/IN: C1.1, C2.1, J1.1, U1.13 (EN), U1.15 (IN), U1.16 (IN)
/OUT: C4.1, J3.1, J4.1, U1.1 (OUT), U1.3 (SENSE/FB), U1.20 (OUT)
GND: C1.2, C2.2, C3.2, C4.2, J2.1, J3.2, J4.2, JP1.1 (A), JP2.1 (A), JP3.1 (A), JP4.1 (A), U1.5 (6P4V1), U1.6 (3P2V), U1.7 (GND), U1.17 (NC), U1.18 (NC), U1.19 (NC), U1.21 (EP)
unnamed: JP1.2 (B), U1.9 (0P8V)
unnamed: JP2.2 (B), U1.10 (0P4V)
unnamed: JP3.2 (B), U1.11 (0P2V)
unnamed: JP4.2 (B), U1.12 (0P1V)
unnamed: C3.1, U1.14 (NR)

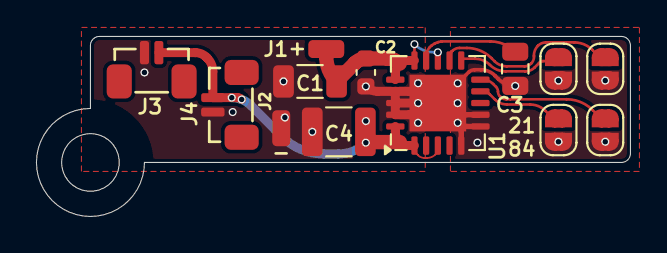
[picture p65: board 12VLDO.kicad_pcb from above]

Board: 2 copper layers, 33.0 x 10.0 mm, 13 parts (0 on the bottom side), 8 nets.
