BlockWorker/ModularAudio/HiFiDAC/HiFiDAC.kicad_pcb

## KiCad design HiFiDAC/HiFiDAC.kicad_pcb (2024-12-12)

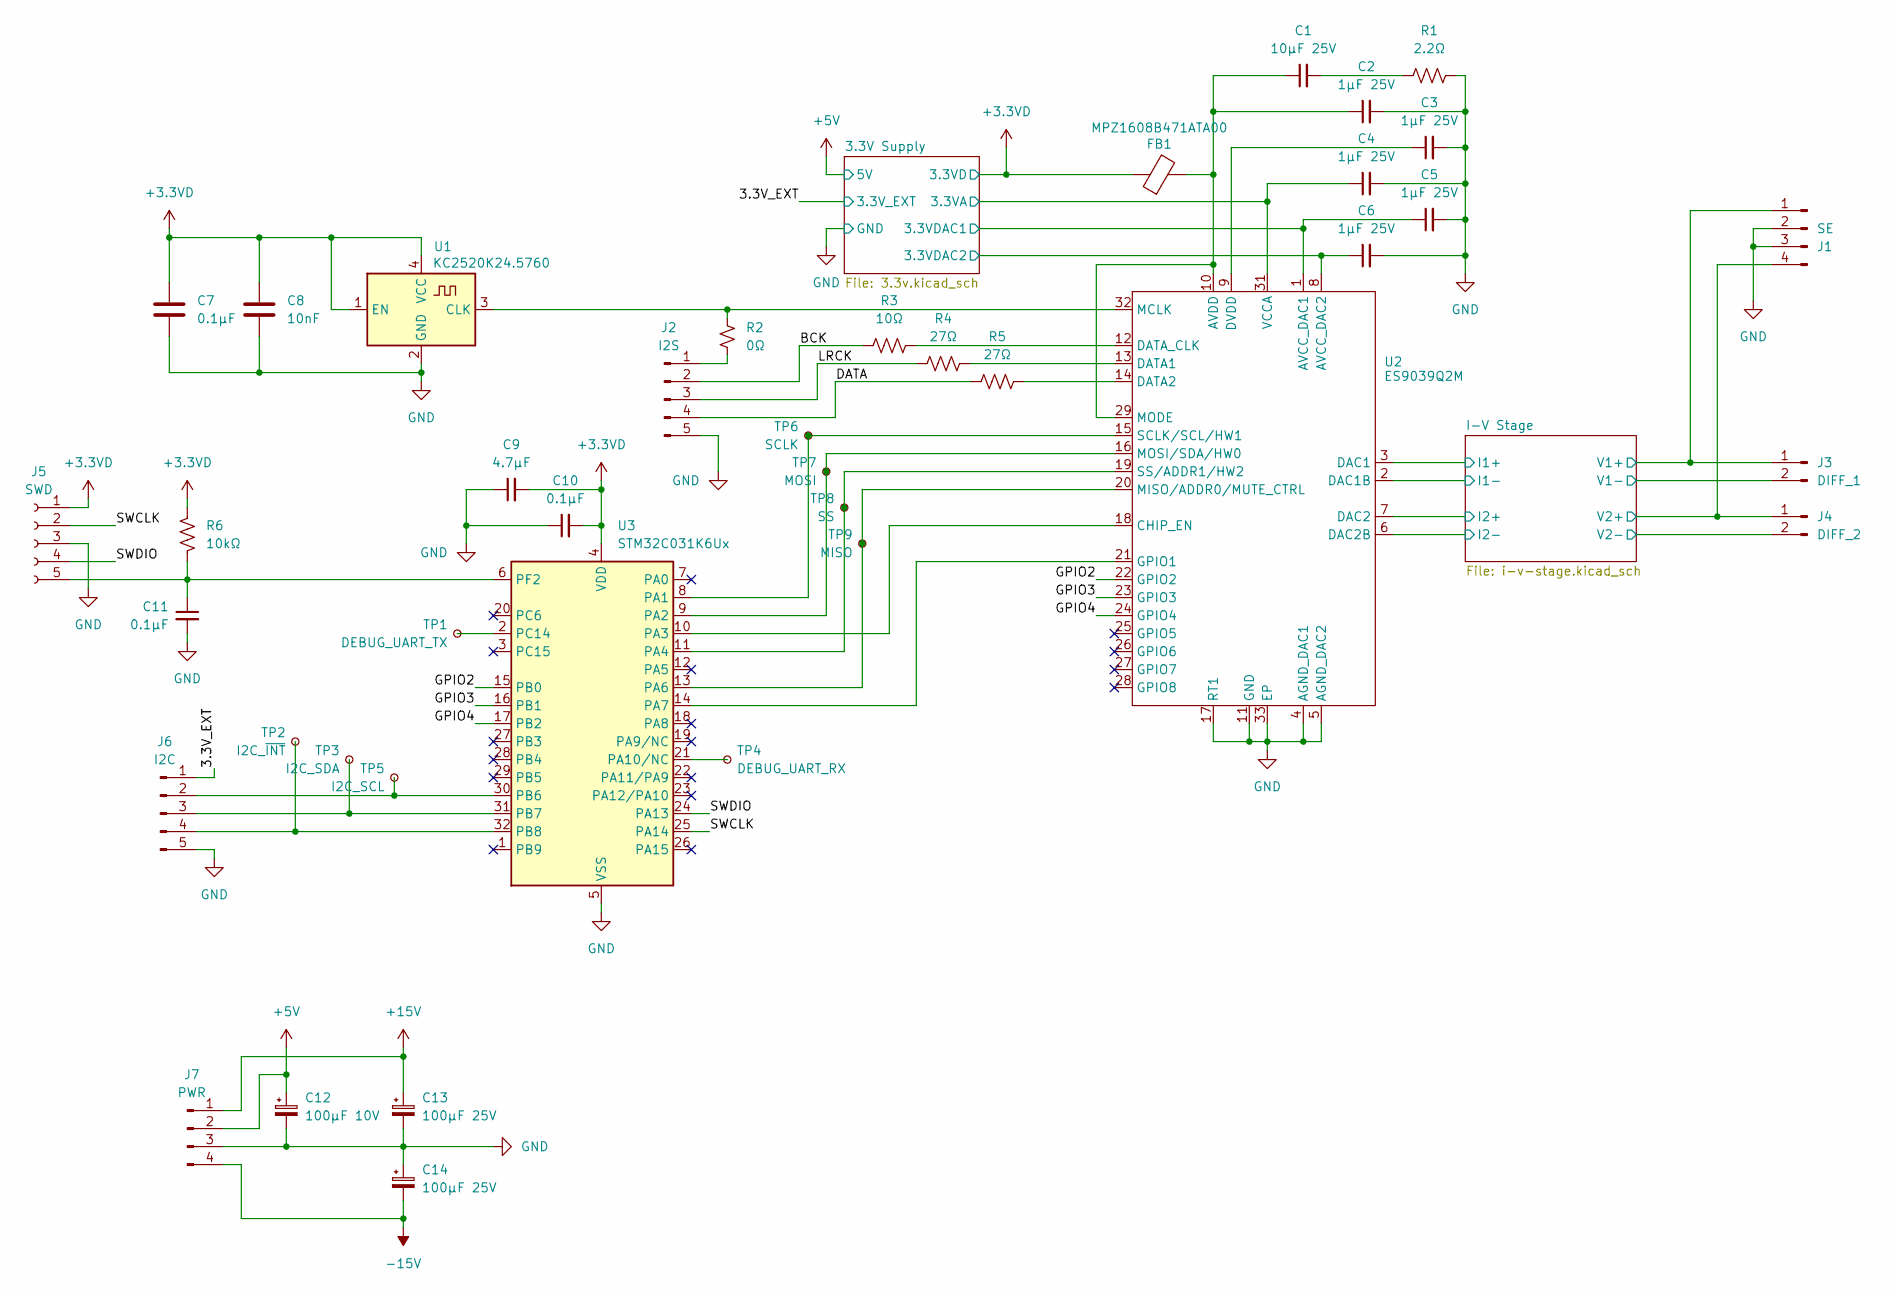
[picture p66: schematic HiFiDAC.kicad_sch]

Parts:
C1: 10µF 25V; C_0805_2012Metric
C2, C3, C4, C5, C6: 1µF 25V; C_0603_1608Metric
C7, C10, C11: 0.1µF; C_0603_1608Metric
C8: 10nF; C_0603_1608Metric
C9: 4.7µF; C_0603_1608Metric
C12: 100µF 10V; CP_Radial_D6.3mm_P2.50mm
C13, C14: 100µF 25V; CP_Elec_6.3x5.9
FB1: MPZ1608B471ATA00; L_0603_1608Metric
J1: SE; Amphenol_MINITEK_0.8_4P_V
J2: I2S; Amphenol_MINITEK_WTB_1.25_5P_V
J3: DIFF_1; Amphenol_MINITEK_0.8_2P_V
J4: DIFF_2; Amphenol_MINITEK_0.8_2P_V
J5: SWD; PinSocket_1x05_P1.27mm_Vertical_SMD_Pin1Right
J6: I2C; Amphenol_MINITEK_WTB_1.25_5P_V
J7: PWR; Amphenol_MINITEK_WTB_1.25_4P_V
R1: 2.2Ω; R_0603_1608Metric
R2: 0Ω; R_0603_1608Metric
R3: 10Ω; R_0603_1608Metric
R4, R5: 27Ω; R_0603_1608Metric
R6: 10kΩ; R_0603_1608Metric
TP1: DEBUG_UART_TX; TP_0603_1608Metric_Fused
TP2: I2C_~{INT}; TP_0603_1608Metric_Fused
TP3: I2C_SDA; TP_0603_1608Metric_Fused
TP4: DEBUG_UART_RX; TP_0603_1608Metric_Fused
TP5: I2C_SCL; TP_0603_1608Metric_Fused
TP6: SCLK; TP_0603_1608Metric_Fused
TP7: MOSI; TP_0603_1608Metric_Fused
TP8: SS; TP_0603_1608Metric_Fused
TP9: MISO; TP_0603_1608Metric_Fused
U1: KC2520K24.5760; Oscillator_SMD_Kyocera_KC2520Z-4Pin_2.5x2.0mm
U2: ES9039Q2M; QFN-32-1EP_5x5mm_P0.5mm_EP3.2x3.2mm
U3: STM32C031K6Ux; QFN-32-1EP_5x5mm_P0.5mm_EP3.45x3.45mm

Connections:
+3.3VD: C7.1, C8.1, C9.2, C10.2, FB1.1, J5.1, R6.1, U1.1 (EN), U1.4 (VCC), U3.4 (VDD); also elsewhere on the board
+5V: C12.1, J7.2; also elsewhere on the board
+15V: C13.1, J7.1; also elsewhere on the board
-15V: C14.2, J7.4; also elsewhere on the board
/3.3V Supply/3.3VA: C4.1, U2.31 (VCCA); also elsewhere on the board
/3.3V Supply/3.3VDAC1: C5.1, U2.1 (AVCC_DAC1); also elsewhere on the board
/3.3V Supply/3.3VDAC2: C6.1, U2.8 (AVCC_DAC2); also elsewhere on the board
/3.3V_EXT: J6.1; also elsewhere on the board
/BCK: J2.2, R3.1
/DATA: J2.4, R5.1
/GPIO2: U2.22 (GPIO2), U3.15 (PB0)
/GPIO3: U2.23 (GPIO3), U3.16 (PB1)
/GPIO4: U2.24 (GPIO4), U3.17 (PB2)
/I-V Stage/I1+: U2.3 (DAC1); also elsewhere on the board
/I-V Stage/I1-: U2.2 (DAC1B); also elsewhere on the board
/I-V Stage/I2+: U2.7 (DAC2); also elsewhere on the board
/I-V Stage/I2-: U2.6 (DAC2B); also elsewhere on the board
/I-V Stage/V1+: J1.1, J3.1; also elsewhere on the board
/I-V Stage/V1-: J3.2; also elsewhere on the board
/I-V Stage/V2+: J1.4, J4.1; also elsewhere on the board
/I-V Stage/V2-: J4.2; also elsewhere on the board
/LRCK: J2.3, R4.1
/SWCLK: J5.2, U3.25 (PA14)
/SWDIO: J5.4, U3.24 (PA13)
GND: C2.2, C3.2, C4.2, C5.2, C6.2, C7.2, C8.2, C9.1, C10.1, C11.2, C12.2, C13.2, C14.1, J1.2, J1.3, J2.5, J5.3, J6.5, J7.3, R1.1, U1.2 (GND), U2.4 (AGND_DAC1), U2.5 (AGND_DAC2), U2.11 (GND), U2.17 (RT1), U2.30 (GND), U2.33 (EP), U3.5 (VSS), U3.33 (VSS); also elsewhere on the board
unnamed: C1.2, R1.2
unnamed: J2.1, R2.1
unnamed: C11.1, J5.5, R6.2, U3.6 (PF2)
unnamed: J6.2, TP5.1, U3.30 (PB6)
unnamed: J6.3, TP3.1, U3.31 (PB7)
unnamed: J6.4, TP2.1, U3.32 (PB8)
unnamed: R2.2, U1.3 (CLK), U2.32 (MCLK)
unnamed: C1.1, C2.1, FB1.2, U2.10 (AVDD), U2.29 (MODE)
unnamed: U2.18 (CHIP_EN), U3.10 (PA3)
unnamed: R4.2, U2.13 (DATA1)
unnamed: R5.2, U2.14 (DATA2)
unnamed: R3.2, U2.12 (DATA_CLK)
unnamed: C3.1, U2.9 (DVDD)
unnamed: U2.21 (GPIO1), U3.14 (PA7)
unnamed: TP9.1, U2.20 (MISO/ADDR0/MUTE_CTRL), U3.13 (PA6)
unnamed: TP7.1, U2.16 (MOSI/SDA/HW0), U3.9 (PA2)
unnamed: TP6.1, U2.15 (SCLK/SCL/HW1), U3.8 (PA1)
unnamed: TP8.1, U2.19 (SS/ADDR1/HW2), U3.11 (PA4)
unnamed: TP4.1, U3.21 (PA10/NC)
unnamed: TP1.1, U3.2 (PC14)

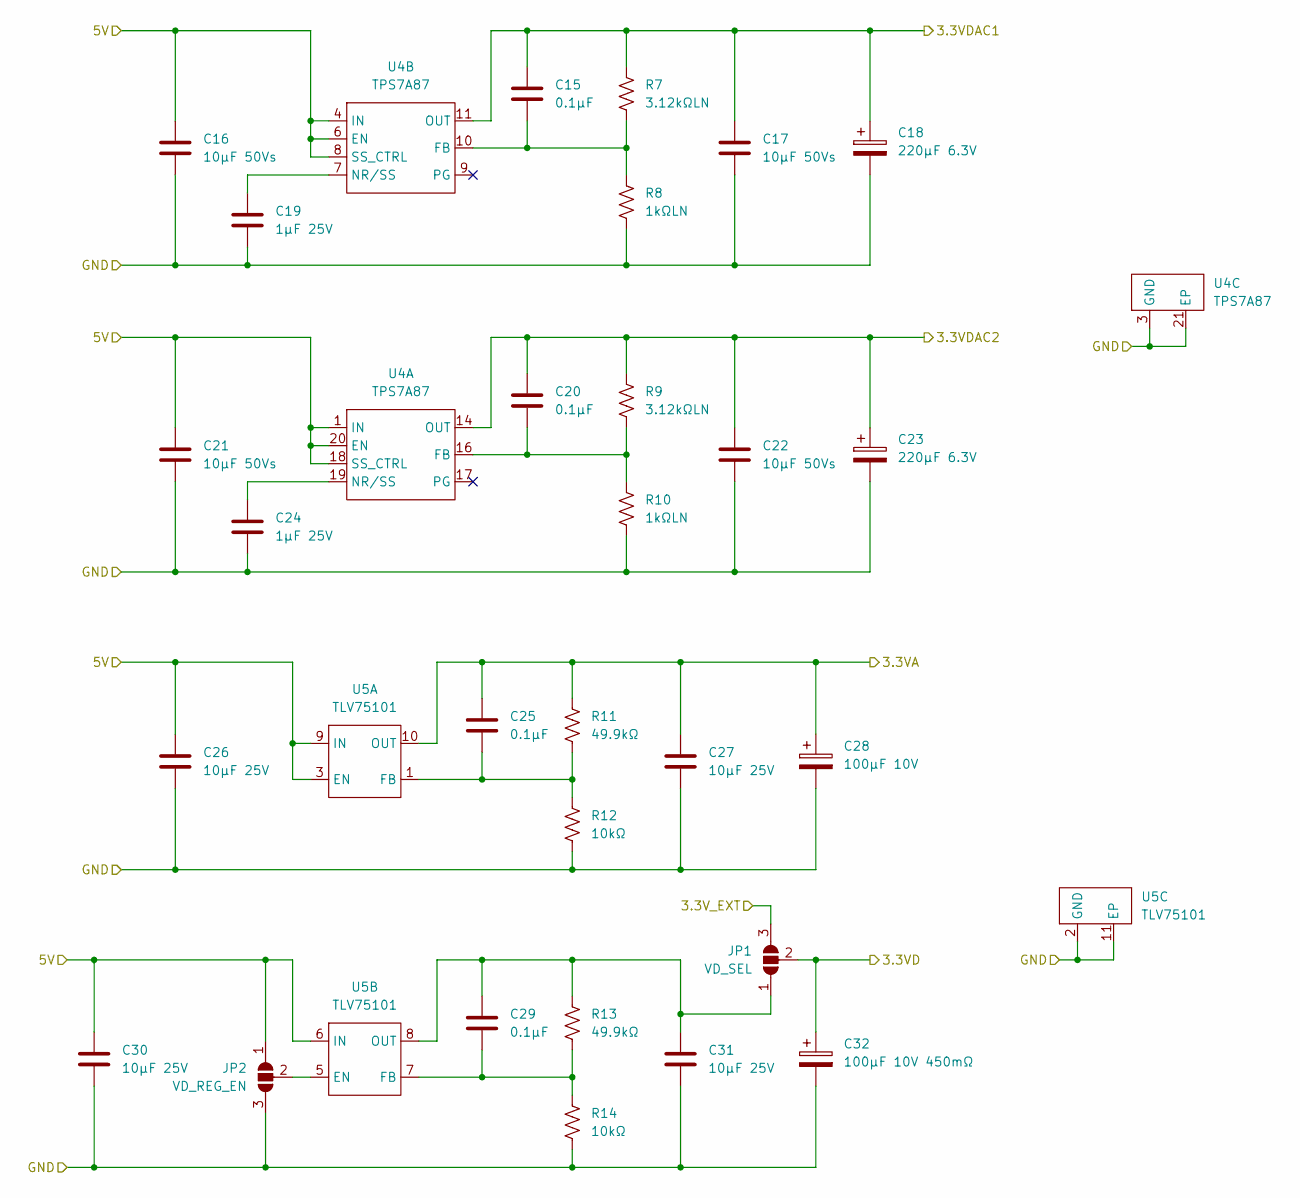
[picture p67: schematic 3.3v.kicad_sch]

Parts:
C15, C20, C25, C29: 0.1µF; C_0603_1608Metric
C16, C17, C21, C22: 10µF 50Vs; C_0805_2012Metric
C18, C23: 220µF 6.3V; CP_Radial_D5.0mm_P2.00mm
C19, C24: 1µF 25V; C_0603_1608Metric
C26, C27, C30, C31: 10µF 25V; C_0805_2012Metric
C28: 100µF 10V; CP_Radial_D6.3mm_P2.50mm
C32: 100µF 10V 450mΩ; CP_Elec_6.3x7.7
JP1: VD_SEL; SolderJumper-3_P1.3mm_Open_RoundedPad1.0x1.5mm
JP2: VD_REG_EN; SolderJumper-3_P1.3mm_Open_RoundedPad1.0x1.5mm
R7, R9: 3.12kΩLN; R_0603_1608Metric
R8, R10: 1kΩLN; R_0603_1608Metric
R11, R13: 49.9kΩ; R_0603_1608Metric
R12, R14: 10kΩ; R_0603_1608Metric
U4: TPS7A87; QFN-20-1EP_4x4mm_P0.5mm_EP2.7x2.7mm
U5: TLV75101; WSON-10-1EP_2x2mm_P0.4mm_EP0.9x1.5mm

Connections:
+3.3VD: C32.1, JP1.2 (C); also elsewhere on the board
+5V: C16.1, C21.1, C26.1, C30.1, JP2.1 (A), U4.1 (IN), U4.2 (IN), U4.4 (IN), U4.5 (IN), U4.6 (EN), U4.8 (SS_CTRL), U4.18 (SS_CTRL), U4.20 (EN), U5.3 (EN), U5.6 (IN), U5.9 (IN); also elsewhere on the board
/3.3V Supply/3.3VA: C25.1, C27.1, C28.1, R11.1, U5.10 (OUT); also elsewhere on the board
/3.3V Supply/3.3VDAC1: C15.1, C17.1, C18.1, R7.1, U4.11 (OUT), U4.12 (OUT); also elsewhere on the board
/3.3V Supply/3.3VDAC2: C20.1, C22.1, C23.1, R9.1, U4.14 (OUT), U4.15 (OUT); also elsewhere on the board
/3.3V_EXT: JP1.3 (B); also elsewhere on the board
GND: C16.2, C17.2, C18.2, C19.2, C21.2, C22.2, C23.2, C24.2, C26.2, C27.2, C28.2, C30.2, C31.2, C32.2, JP2.3 (B), R8.2, R10.2, R12.2, R14.2, U4.3 (GND), U4.13 (GND), U4.21 (EP), U5.2 (GND), U5.4 (GND), U5.11 (EP); also elsewhere on the board
unnamed: C29.1, C31.1, JP1.1 (A), R13.1, U5.8 (OUT)
unnamed: JP2.2 (C), U5.5 (EN)
unnamed: C20.2, R9.2, R10.1, U4.16 (FB)
unnamed: C24.1, U4.19 (NR/SS)
unnamed: C15.2, R7.2, R8.1, U4.10 (FB)
unnamed: C19.1, U4.7 (NR/SS)
unnamed: C25.2, R11.2, R12.1, U5.1 (FB)
unnamed: C29.2, R13.2, R14.1, U5.7 (FB)
