BlockWorker/ModularAudio/HiFiDAC/HiFiDAC.kicad_pcb

## KiCad design HiFiDAC/HiFiDAC.kicad_pcb (continued)

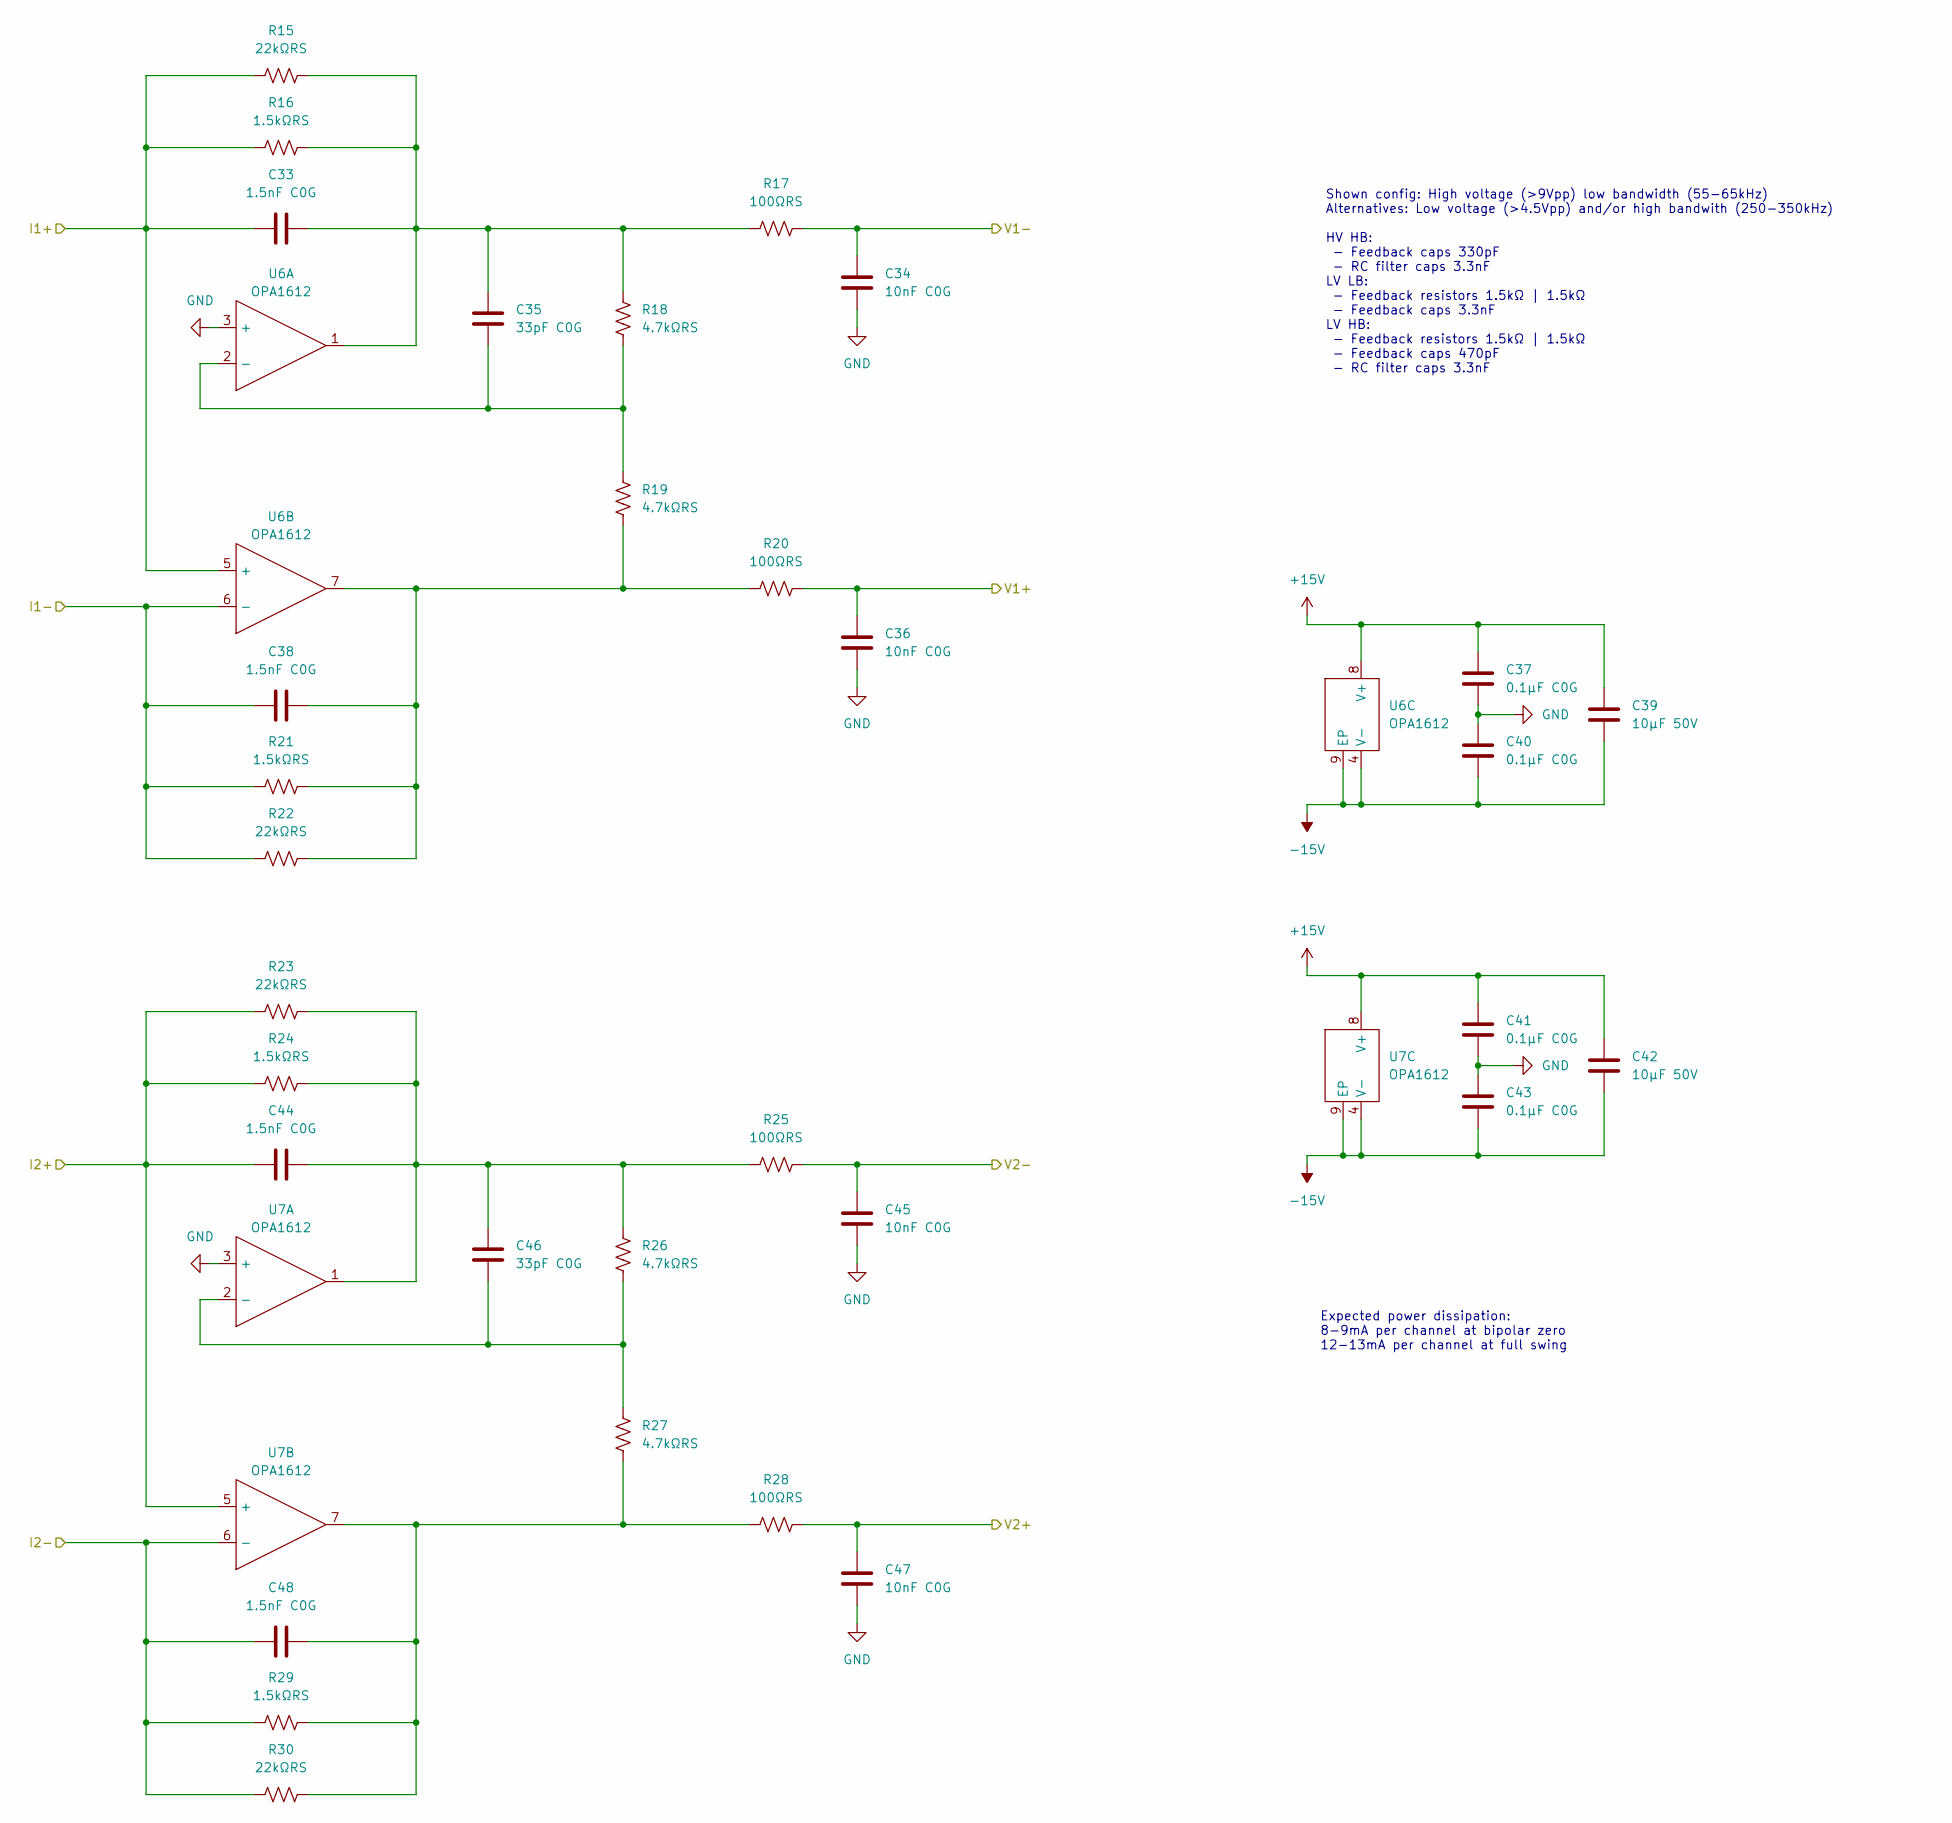
[picture p68: schematic i-v-stage.kicad_sch]

Parts:
C33, C38, C44, C48: 1.5nF C0G; C_0603_1608Metric
C34, C36, C45, C47: 10nF C0G; C_0603_1608Metric
C35, C46: 33pF C0G; C_0603_1608Metric
C37, C40, C41, C43: 0.1µF C0G; C_0704_1810Metric
C39, C42: 10µF 50V; C_1206_3216Metric
R15, R22, R23, R30: 22kΩRS; R_0805_2012Metric
R16, R21, R24, R29: 1.5kΩRS; R_0805_2012Metric
R17, R20, R25, R28: 100ΩRS; R_0805_2012Metric
R18, R19, R26, R27: 4.7kΩRS; R_0805_2012Metric
U6, U7: OPA1612; WSON-8-1EP_3x3mm_P0.5mm_EP1.2x2mm

Connections:
+15V: C37.2, C39.1, C41.2, C42.1, U6.8 (V+), U7.8 (V+); also elsewhere on the board
-15V: C39.2, C40.1, C42.2, C43.1, U6.4 (V-), U6.9 (EP), U7.4 (V-), U7.9 (EP); also elsewhere on the board
/I-V Stage/I1+: C33.1, R15.1, R16.1, U6.5 (+); also elsewhere on the board
/I-V Stage/I1-: C38.1, R21.1, R22.1, U6.6 (-); also elsewhere on the board
/I-V Stage/I2+: C44.1, R23.1, R24.1, U7.5 (+); also elsewhere on the board
/I-V Stage/I2-: C48.1, R29.1, R30.1, U7.6 (-); also elsewhere on the board
/I-V Stage/V1+: C36.2, R20.2; also elsewhere on the board
/I-V Stage/V1-: C34.2, R17.2; also elsewhere on the board
/I-V Stage/V2+: C47.2, R28.2; also elsewhere on the board
/I-V Stage/V2-: C45.2, R25.2; also elsewhere on the board
GND: C34.1, C36.1, C37.1, C40.2, C41.1, C43.2, C45.1, C47.1, U6.3 (+), U7.3 (+); also elsewhere on the board
unnamed: C33.2, C35.2, R15.2, R16.2, R17.1, R18.2, U6.1
unnamed: C38.2, R19.1, R20.1, R21.2, R22.2, U6.7
unnamed: C44.2, C46.2, R23.2, R24.2, R25.1, R26.2, U7.1
unnamed: C48.2, R27.1, R28.1, R29.2, R30.2, U7.7
unnamed: C35.1, R18.1, R19.2, U6.2 (-)
unnamed: C46.1, R26.1, R27.2, U7.2 (-)

Notes on the sheet:
Expected power dissipation: 8-9mA per channel at bipolar zero 12-13mA per channel at full swing
Shown config: High voltage (>9Vpp) low bandwidth (55-65kHz) Alternatives: Low voltage (>4.5Vpp) and/or high bandwith (250-350kHz) HV HB: - Feedback caps 330pF - RC filter caps 3.3nF LV LB: - Feedback resistors 1.5kΩ | 1.5kΩ - Feedback caps 3.3nF LV HB: - Feedback resistors 1.5kΩ | 1.5kΩ - Feedback 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

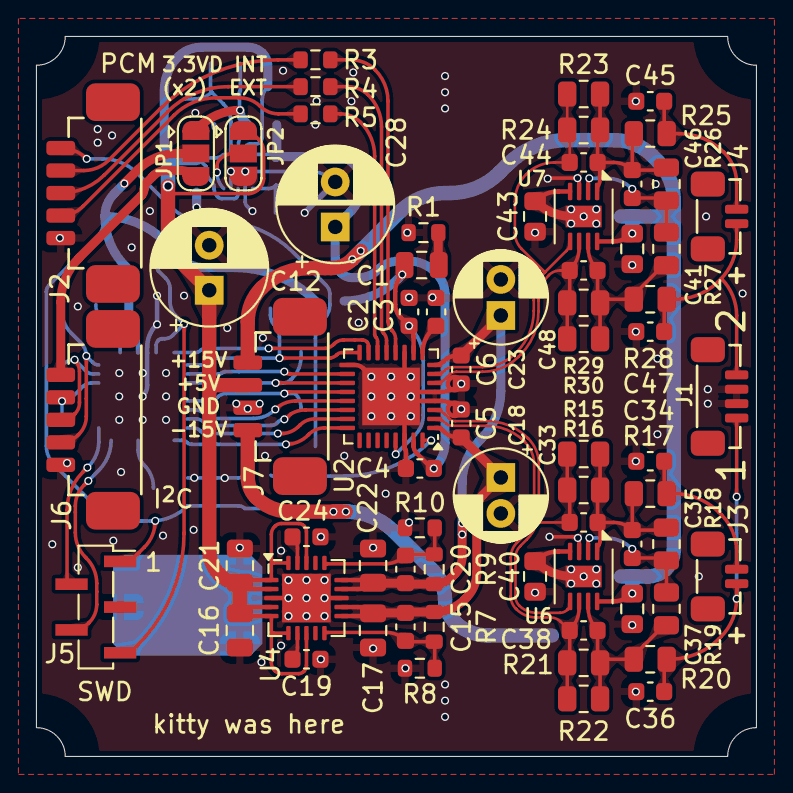
[picture p69: board HiFiDAC.kicad_pcb from above]

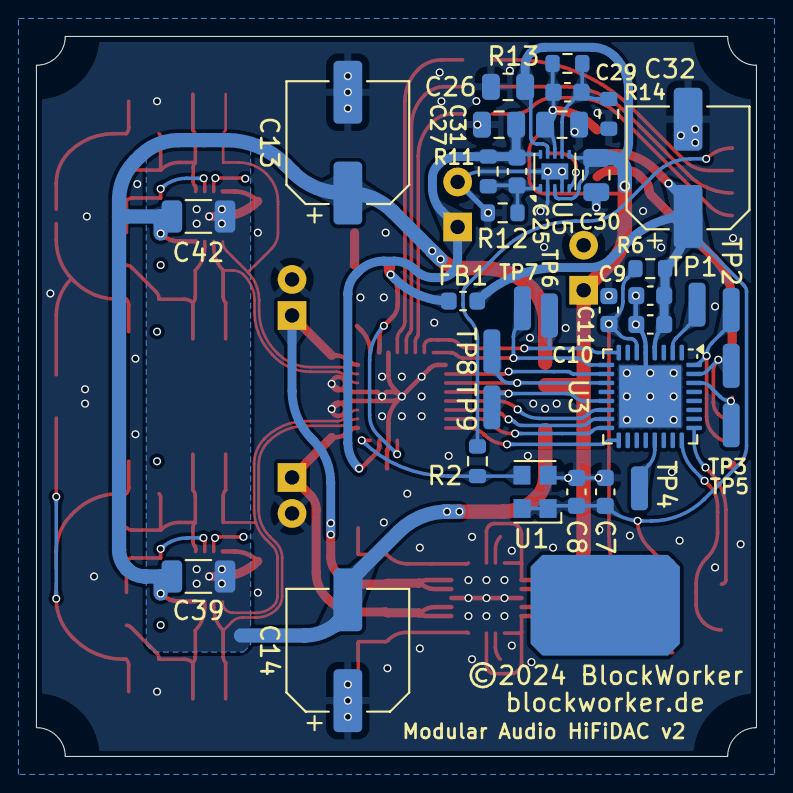
[picture p70: board HiFiDAC.kicad_pcb from below]

Board: 4 copper layers, 40.0 x 40.0 mm, 104 parts (35 on the bottom side), 59 nets.
