BlockWorker/ModularAudio/PowerAmplifier/PowerAmplifier.kicad_pcb

## KiCad design PowerAmplifier/PowerAmplifier.kicad_pcb (2024-10-06)

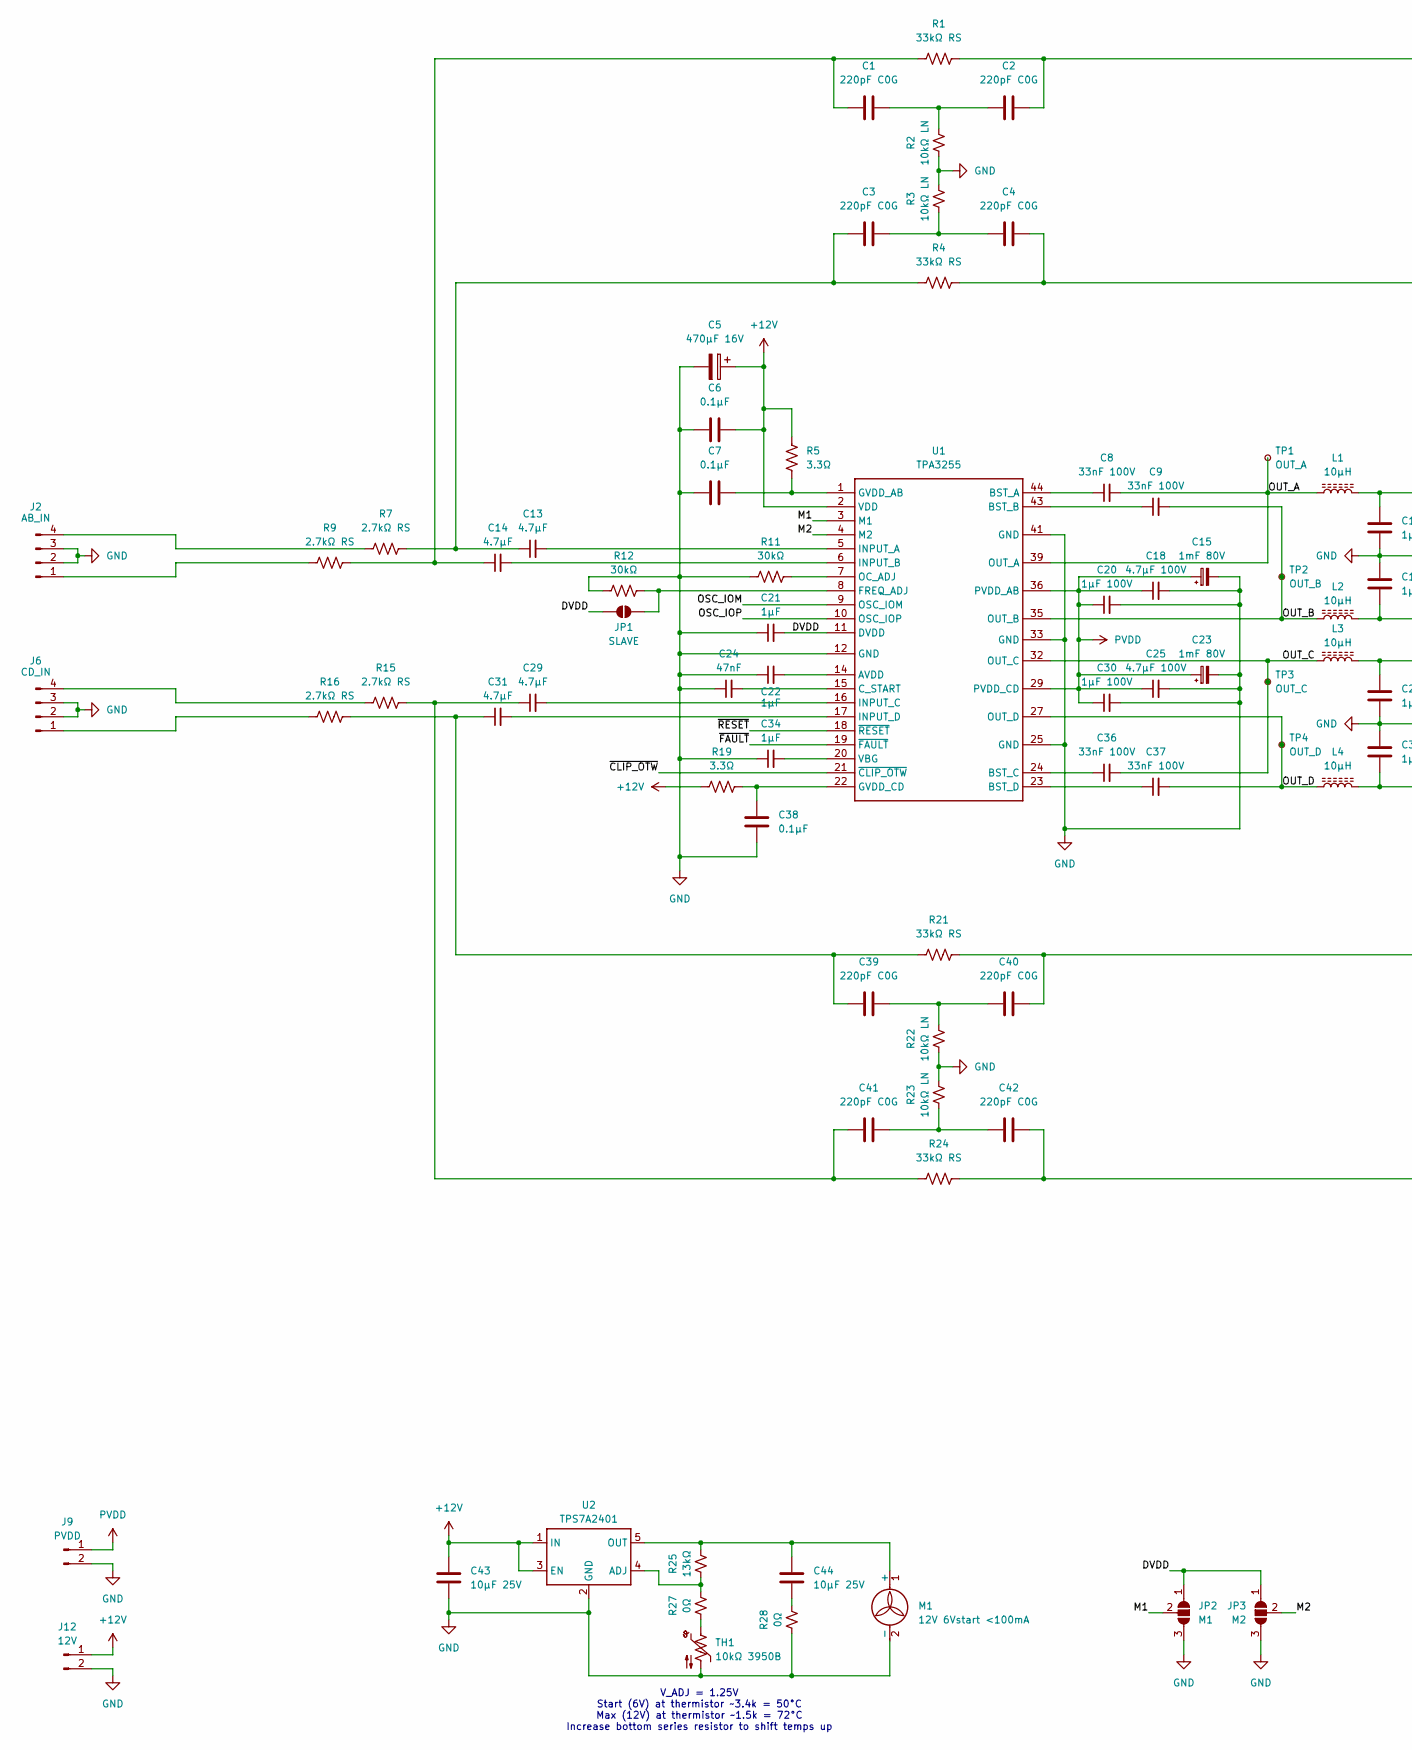
[picture p71: schematic PowerAmplifier.kicad_sch, part in row 1, column 1]

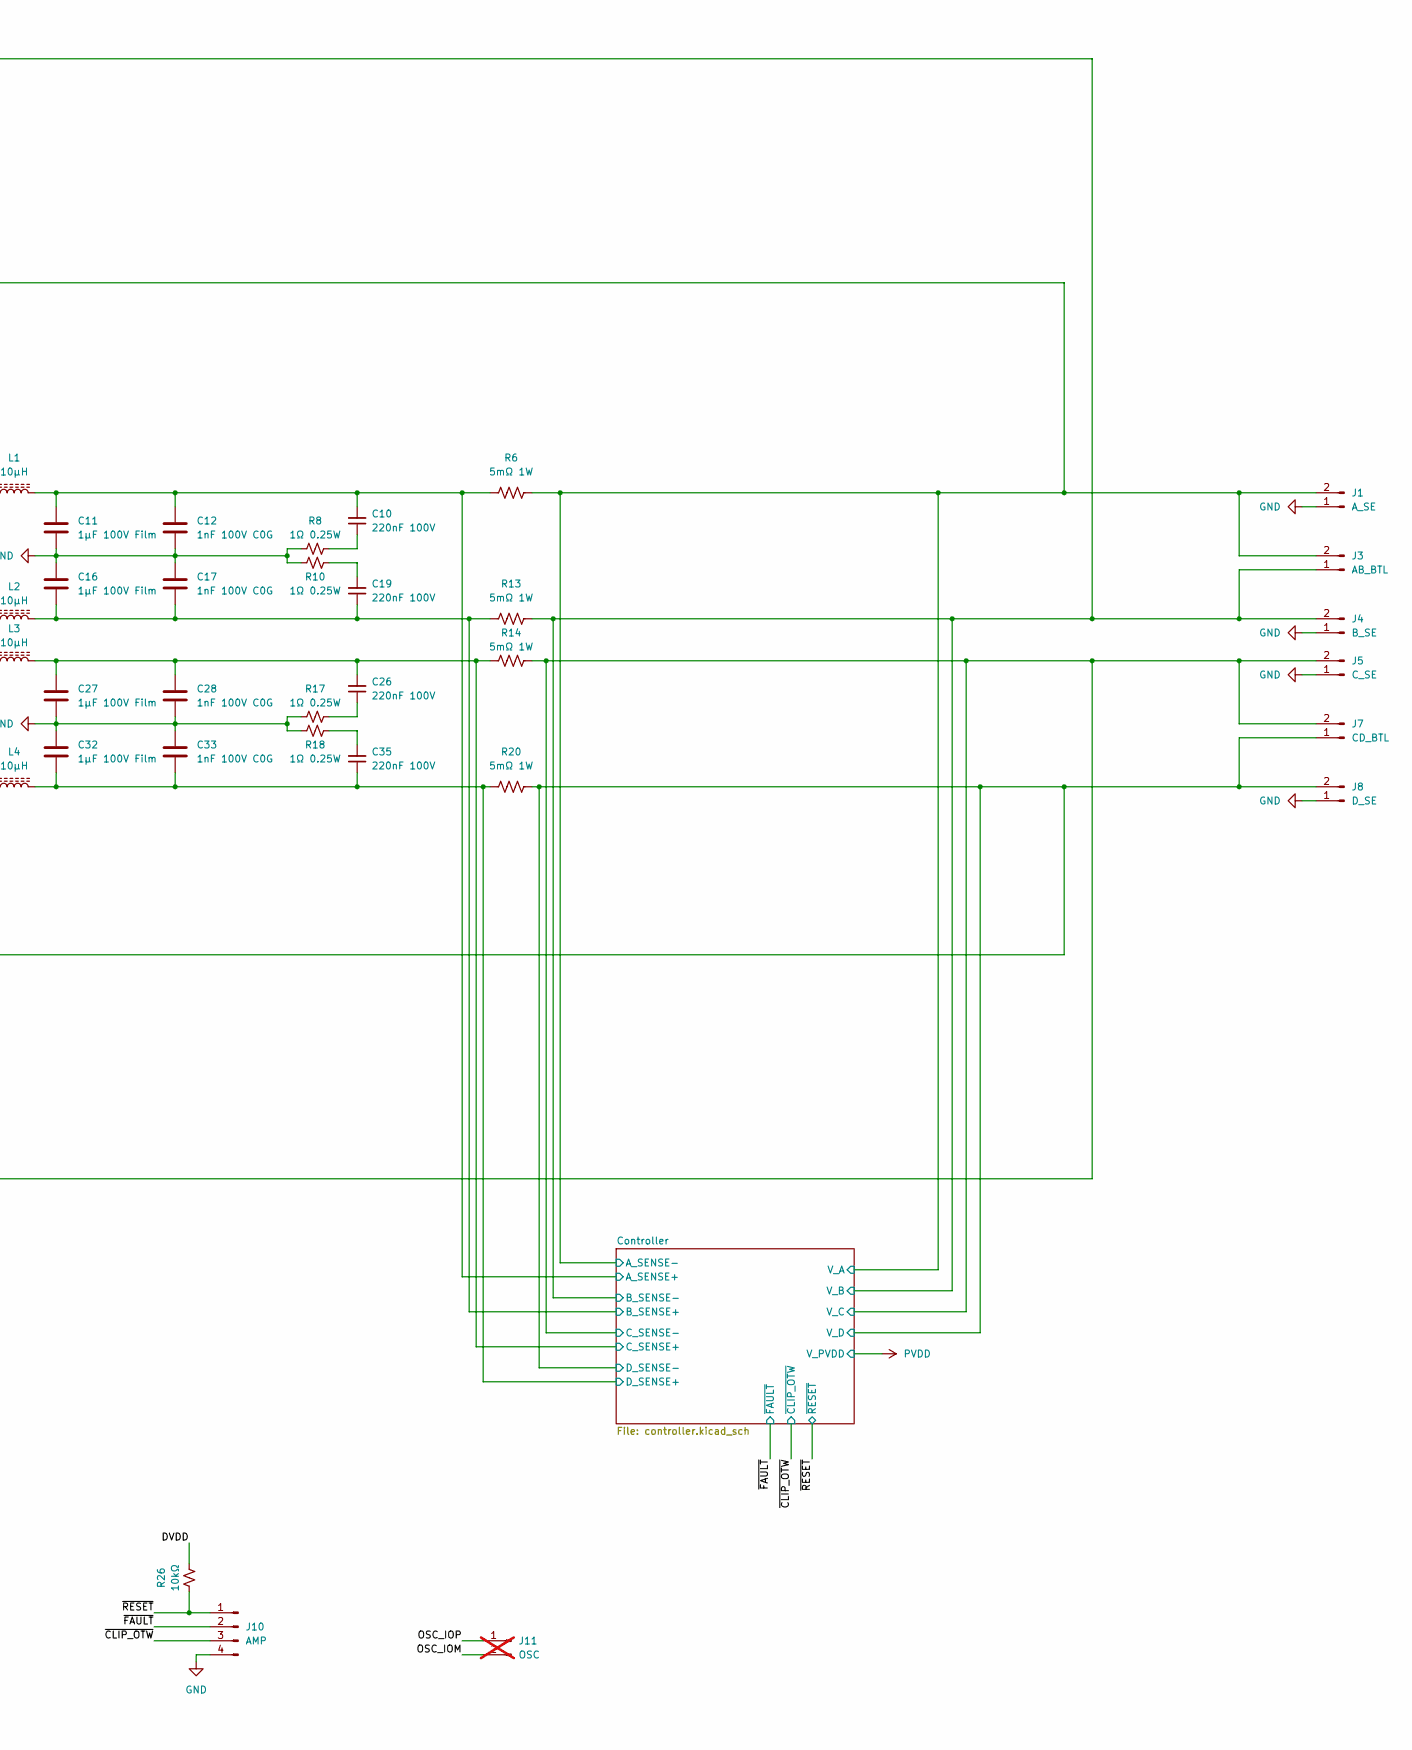
[picture p72: schematic PowerAmplifier.kicad_sch, part in row 1, column 2]

Parts:
C1, C2, C3, C4, C39, C40, C41, C42: 220pF C0G; C_0603_1608Metric
C5: 470µF 16V; CP_Radial_D8.0mm_P3.50mm
C6, C7, C38: 0.1µF; C_0603_1608Metric
C8, C9, C36, C37: 33nF 100V; C_0603_1608Metric
C10, C19, C26, C35: 220nF 100V; C_0805_2012Metric
C11, C16, C27, C32: 1µF 100V Film; C_Rect_L7.0mm_W6.0mm_P5.00mm
C12, C17, C28, C33: 1nF 100V C0G; C_0603_1608Metric
C13, C14, C29, C31: 4.7µF; C_Rect_L7.2mm_W7.2mm_P5.00mm_FKS2_FKP2_MKS2_MKP2
C15, C23: 1mF 80V; CP_Radial_D16.0mm_P7.50mm
C18, C25: 4.7µF 100V; C_1206_3216Metric
C20, C30: 1µF 100V; C_1206_3216Metric
C21, C22, C34: 1µF; C_0603_1608Metric
C24: 47nF; C_0603_1608Metric
C43, C44: 10µF 25V; C_0805_2012Metric
J1: A_SE; TE_MATE-N-LOK_1-770872-x_1x02_P4.14mm_Vertical
J2: AB_IN; Amphenol_MINITEK_0.8_4P_V_BoardEdge
J3: AB_BTL; TE_MATE-N-LOK_1-770872-x_1x02_P4.14mm_Vertical
J4: B_SE; TE_MATE-N-LOK_1-770872-x_1x02_P4.14mm_Vertical
J5: C_SE; TE_MATE-N-LOK_1-770872-x_1x02_P4.14mm_Vertical
J6: CD_IN; Amphenol_MINITEK_0.8_4P_V_BoardEdge
J7: CD_BTL; TE_MATE-N-LOK_1-770872-x_1x02_P4.14mm_Vertical
J8: D_SE; TE_MATE-N-LOK_1-770872-x_1x02_P4.14mm_Vertical
J9: PVDD; TE_644749-2
J10: AMP; Amphenol_MINITEK_0.8_4P_V_BoardEdge
J11: OSC; Amphenol_MINITEK_0.8_2P_V; not fitted
J12: 12V; Amphenol_MINITEK_0.8_2P_V_BoardEdge
JP1: SLAVE; SolderJumper-2_P1.3mm_Open_RoundedPad1.0x1.5mm
JP2: M1; SolderJumper-3_P1.3mm_Open_RoundedPad1.0x1.5mm
JP3: M2; SolderJumper-3_P1.3mm_Open_RoundedPad1.0x1.5mm
L1, L2, L3, L4: 10µH; L_ICE_1D17A
M1: 12V 6Vstart <100mA; Amphenol_MINITEK_0.8_2P_V
R1, R4, R21, R24: 33kΩ RS; R_0805_2012Metric
R2, R3, R22, R23: 10kΩ LN; R_0603_1608Metric
R5, R19: 3.3Ω; R_0805_2012Metric
R6, R13, R14, R20: 5mΩ 1W; R_0612_1632Metric
R7, R9, R15, R16: 2.7kΩ RS; R_0805_2012Metric
R8, R10, R17, R18: 1Ω 0.25W; R_0603_1608Metric
R11, R12: 30kΩ; R_0603_1608Metric
R25: 13kΩ; R_0603_1608Metric
R26: 10kΩ; R_0603_1608Metric
R27, R28: 0Ω; R_0603_1608Metric
TH1: 10kΩ 3950B; R_0603_1608Metric
TP1: OUT_A; TP_0603_1608Metric_Fused
TP2: OUT_B; TP_0603_1608Metric_Fused
TP3: OUT_C; TP_0603_1608Metric_Fused
TP4: OUT_D; TP_0603_1608Metric_Fused
U1: TPA3255; HTSSOP-44_6.1x14mm_P0.635mm
U2: TPS7A2401; SOT-23-5

Connections:
+12V: C5.1, C6.1, C43.1, J12.1, R5.2, R19.1, U1.2 (VDD), U2.1 (IN), U2.3 (EN); also elsewhere on the board
/Controller/A_SENSE+: C10.2, C11.1, C12.1, L1.2, R6.2; also elsewhere on the board
/Controller/A_SENSE-: C4.1, J1.2, J3.2, R4.1, R6.1; also elsewhere on the board
/Controller/B_SENSE+: C16.2, C17.2, C19.1, L2.2, R13.2; also elsewhere on the board
/Controller/B_SENSE-: C2.1, J3.1, J4.2, R1.1, R13.1; also elsewhere on the board
/Controller/C_SENSE+: C26.2, C27.1, C28.1, L3.2, R14.2; also elsewhere on the board
/Controller/C_SENSE-: C42.1, J5.2, J7.2, R14.1, R24.1; also elsewhere on the board
/Controller/D_SENSE+: C32.2, C33.2, C35.1, L4.2, R20.2; also elsewhere on the board
/Controller/D_SENSE-: C40.1, J7.1, J8.2, R20.1, R21.1; also elsewhere on the board
/DVDD: C21.2, JP1.1 (A), JP2.1 (A), JP3.1 (A), R26.1, U1.11 (DVDD)
/M1: JP2.2 (C), U1.3 (M1)
/M2: JP3.2 (C), U1.4 (M2)
/OSC_IOM: J11.2, U1.9 (OSC_IOM)
/OSC_IOP: J11.1, U1.10 (OSC_IOP)
/OUT_A: C8.2, L1.1, TP1.1, U1.39 (OUT_A), U1.40 (OUT_A)
/OUT_B: C9.2, L2.1, TP2.1, U1.35 (OUT_B)
/OUT_C: C36.2, L3.1, TP3.1, U1.32 (OUT_C)
/OUT_D: C37.2, L4.1, TP4.1, U1.27 (OUT_D), U1.28 (OUT_D)
/~CLIP_OTW: J10.3, U1.21 (~CLIP_OTW); also elsewhere on the board
/~FAULT: J10.2, U1.19 (~FAULT); also elsewhere on the board
/~RESET: J10.1, R26.2, U1.18 (~RESET); also elsewhere on the board
GND: C5.2, C6.2, C7.2, C11.2, C12.2, C15.2, C16.1, C17.1, C18.2, C20.2, C21.1, C22.1, C23.2, C24.1, C25.2, C27.2, C28.2, C30.2, C32.1, C33.1, C34.1, C38.2, C43.2, J1.1, J2.2, J2.3, J4.1, J5.1, J6.2, J6.3, J8.1, J9.2, J10.4, J12.2, JP2.3 (B), JP3.3 (B), M1.2 (-), R2.2, R3.1, R8.2, R10.2, R11.2, R12.2, R17.2, R18.2, R22.2, R23.1, R28.2, TH1.2, U1.12 (GND), U1.13 (GND), U1.25 (GND), U1.26 (GND), U1.33 (GND), U1.34 (GND), U1.41 (GND), U1.42 (GND), U2.2 (GND); also elsewhere on the board
unnamed: C1.1, C2.2, R2.1
unnamed: C1.2, C14.1, R1.2, R9.1
unnamed: C3.1, C4.2, R3.2
unnamed: C10.1, R8.1
unnamed: C3.2, C13.1, R4.2, R7.1
unnamed: C19.2, R10.1
unnamed: C26.1, R17.1
unnamed: C29.1, C41.2, R15.1, R24.2
unnamed: C31.1, C39.2, R16.1, R21.2
unnamed: C35.2, R18.1
unnamed: C39.1, C40.2, R22.1
unnamed: C41.1, C42.2, R23.2
unnamed: C44.2, R28.1
unnamed: J2.1, R9.2
unnamed: J2.4, R7.2
unnamed: J6.1, R16.2
unnamed: J6.4, R15.2
unnamed: JP1.2 (B), R12.1, U1.8 (FREQ_ADJ)
unnamed: C44.1, M1.1 (+), R25.1, U2.5 (OUT)
unnamed: R27.2, TH1.1
unnamed: C22.2, U1.14 (AVDD)
unnamed: C8.1, U1.44 (BST_A)
unnamed: C9.1, U1.43 (BST_B)
unnamed: C36.1, U1.24 (BST_C)
unnamed: C37.1, U1.23 (BST_D)
unnamed: C24.2, U1.15 (C_START)
unnamed: C7.1, R5.1, U1.1 (GVDD_AB)
unnamed: C38.1, R19.2, U1.22 (GVDD_CD)
unnamed: C13.2, U1.5 (INPUT_A)
unnamed: C14.2, U1.6 (INPUT_B)
unnamed: C29.2, U1.16 (INPUT_C)
unnamed: C31.2, U1.17 (INPUT_D)
unnamed: R11.1, U1.7 (OC_ADJ)
unnamed: C34.2, U1.20 (VBG)
unnamed: R25.2, R27.1, U2.4 (ADJ)
PVDD: C15.1, C18.1, C20.1, C23.1, C25.1, C30.1, J9.1, U1.29 (PVDD_CD), U1.30 (PVDD_CD), U1.31 (PVDD_CD), U1.36 (PVDD_AB), U1.37 (PVDD_AB), U1.38 (PVDD_AB); also elsewhere on the board

Notes on the sheet:
V_ADJ = 1.25V Start (6V) at thermistor ~3.4k = 50°C Max (12V) at thermistor ~1.5k = 72°C Increase bottom series resistor to shift temps up

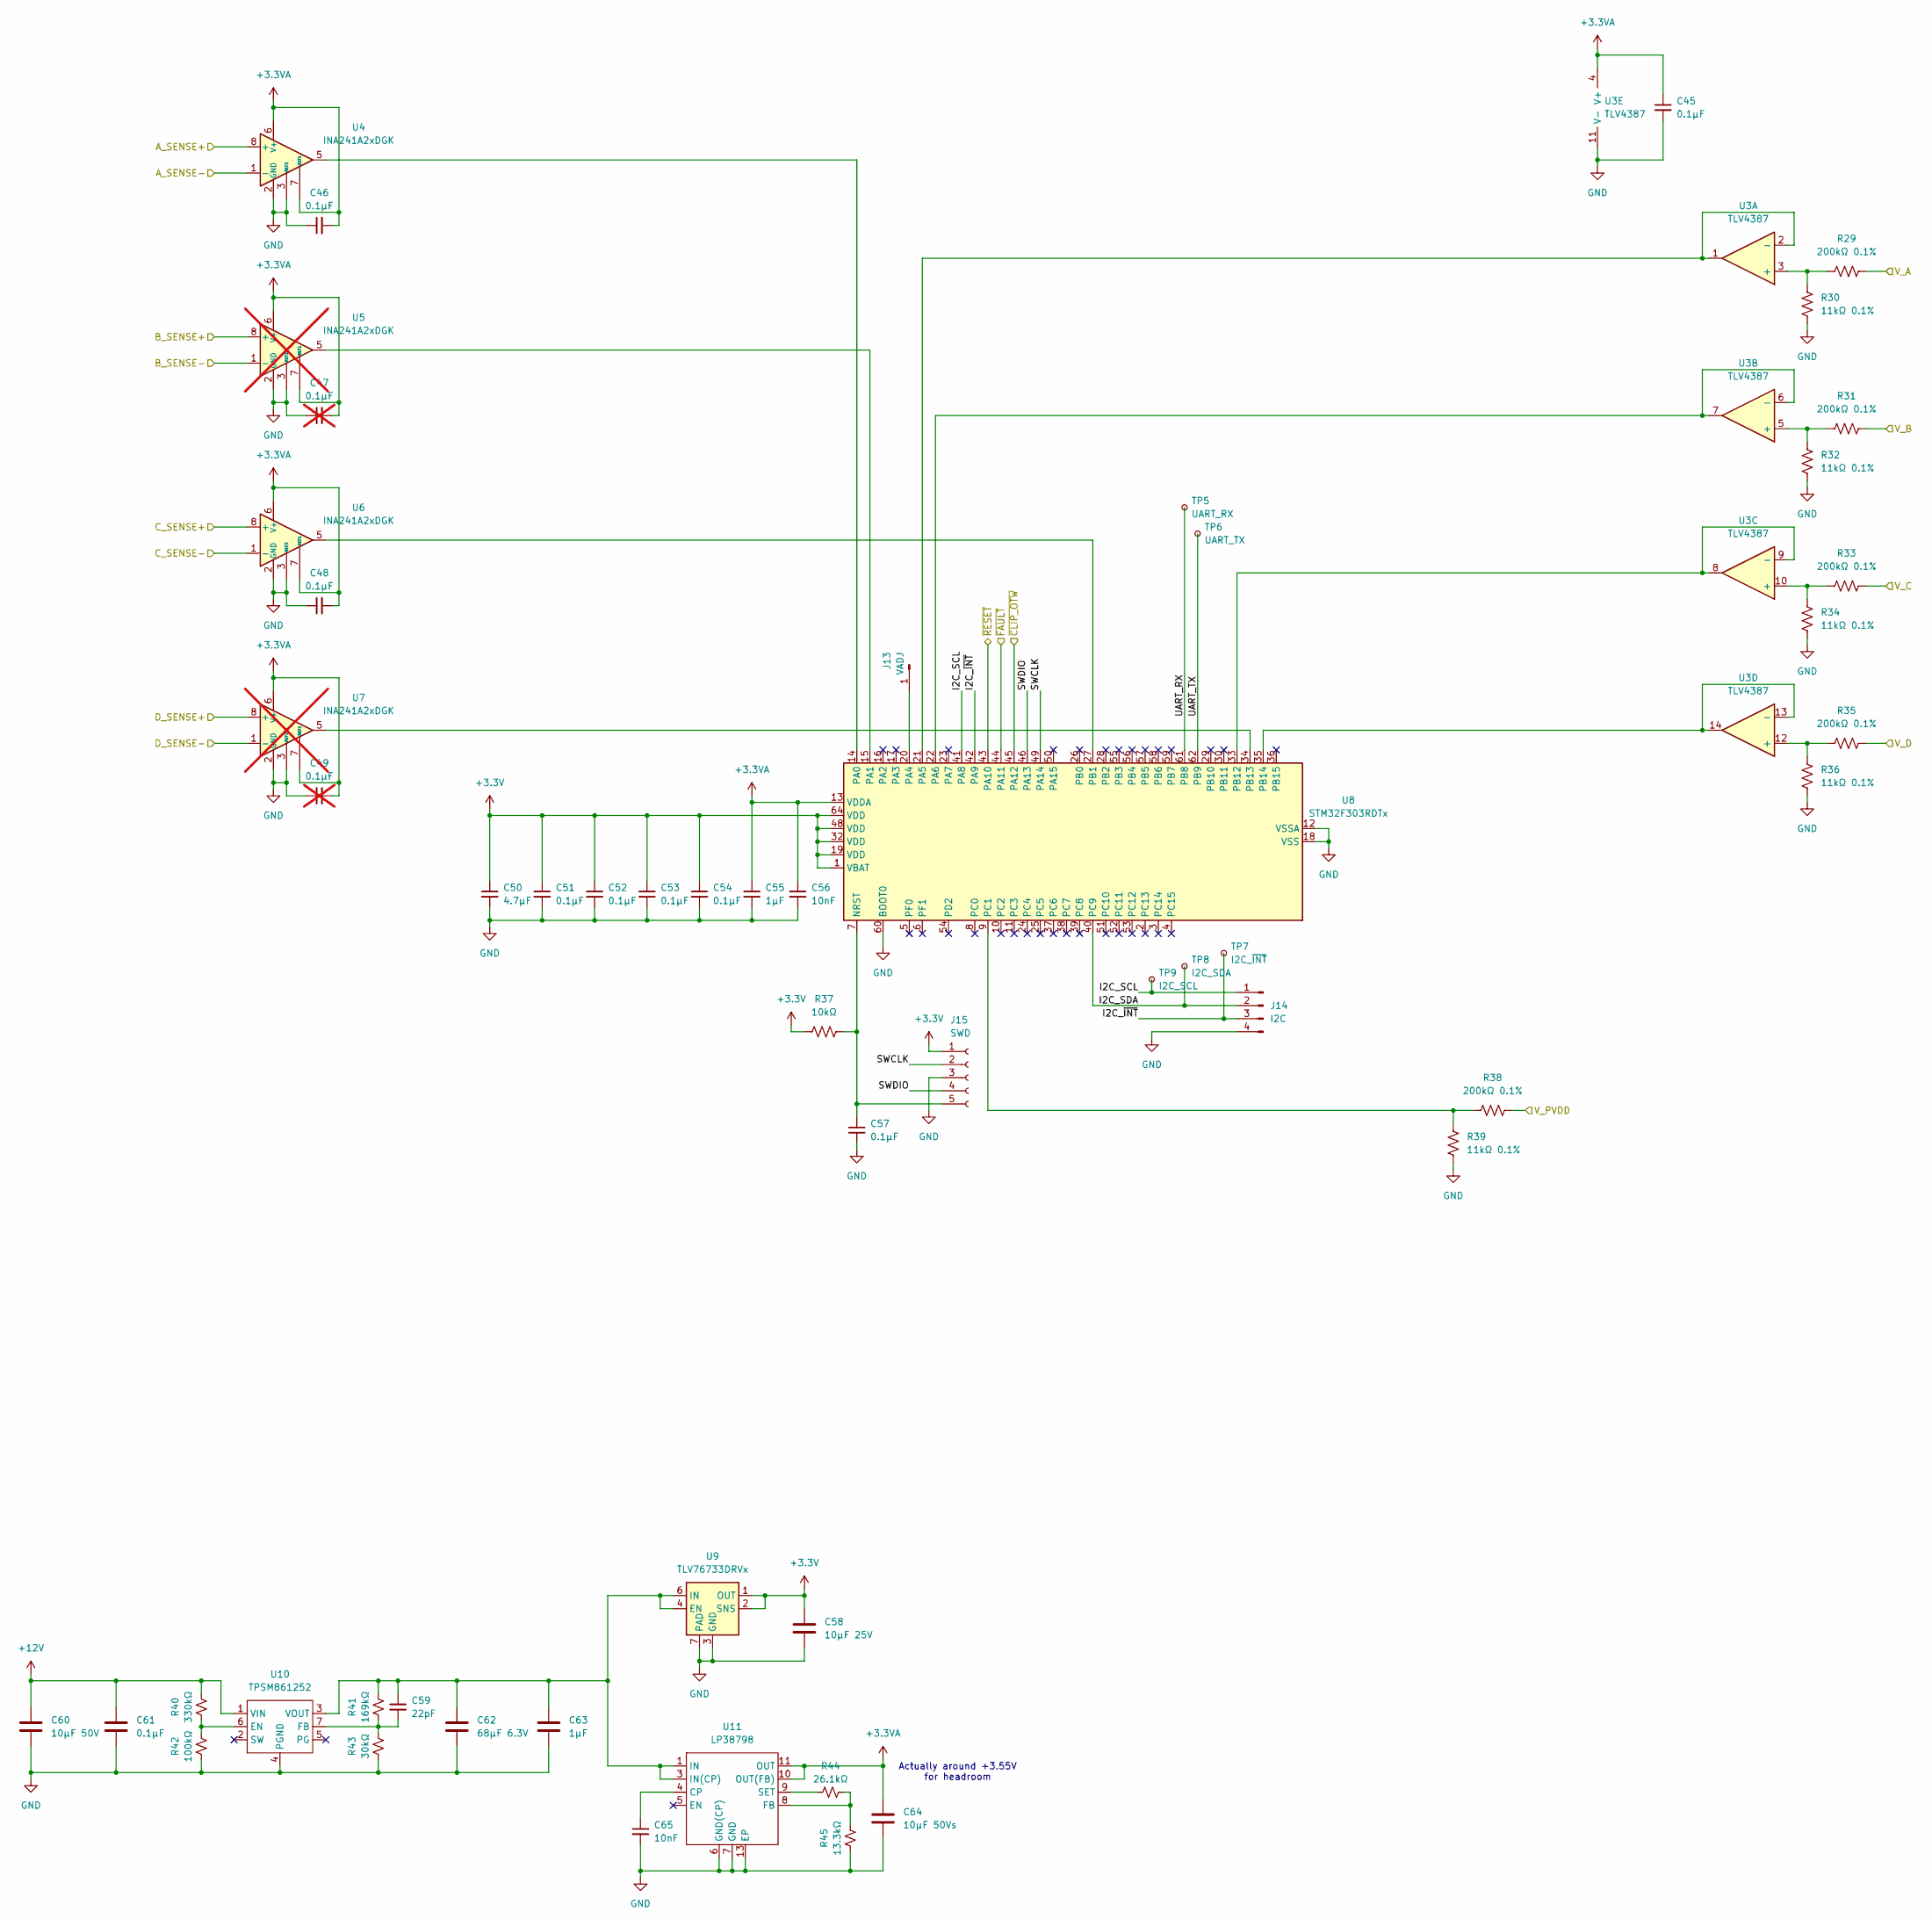
[picture p73: schematic controller.kicad_sch]

Parts:
C45, C46, C48, C51, C52, C53, C54, C57, C61: 0.1µF; C_0603_1608Metric
C47, C49: 0.1µF; C_0603_1608Metric; not fitted
C50: 4.7µF; C_0603_1608Metric
C55, C63: 1µF; C_0603_1608Metric
C56, C65: 10nF; C_0603_1608Metric
C58: 10µF 25V; C_0805_2012Metric
C59: 22pF; C_0603_1608Metric
C60: 10µF 50V; C_1206_3216Metric
C62: 68µF 6.3V; C_1206_3216Metric
C64: 10µF 50Vs; C_0805_2012Metric
J13: VADJ; PinHeader_1x01_P2.54mm_Vertical
J14: I2C; Amphenol_MINITEK_0.8_4P_V_BoardEdge
J15: SWD; PinSocket_1x05_P1.27mm_Vertical_SMD_Pin1Right
R29, R31, R33, R35, R38: 200kΩ 0.1%; R_0603_1608Metric
R30, R32, R34, R36, R39: 11kΩ 0.1%; R_0603_1608Metric
R37: 10kΩ; R_0603_1608Metric
R40: 330kΩ; R_0603_1608Metric
R41: 169kΩ; R_0603_1608Metric
R42: 100kΩ; R_0603_1608Metric
R43: 30kΩ; R_0603_1608Metric
R44: 26.1kΩ; R_0603_1608Metric
R45: 13.3kΩ; R_0603_1608Metric
TP5: UART_RX; TP_0603_1608Metric_Fused
TP6: UART_TX; TP_0603_1608Metric_Fused
TP7: I2C_~{INT}; TP_0603_1608Metric_Fused
TP8: I2C_SDA; TP_0603_1608Metric_Fused
TP9: I2C_SCL; TP_0603_1608Metric_Fused
U3: TLV4387; TSSOP-14_4.4x5mm_P0.65mm
U4, U6: INA241A2xDGK; VSSOP-8_3x3mm_P0.65mm
U5, U7: INA241A2xDGK; VSSOP-8_3x3mm_P0.65mm; not fitted
U8: STM32F303RDTx; LQFP-64_10x10mm_P0.5mm
U9: TLV76733DRVx; WSON-6-1EP_2x2mm_P0.65mm_EP1x1.6mm_LongerPads
U10: TPSM861252; TI_QFN-FCMOD
U11: LP38798; WSON-12-1EP_4x4mm_P0.5mm_EP2.6x3mm

Connections:
+3.3V: C50.1, C51.1, C52.1, C53.1, C54.1, C58.1, J15.1, R37.1, U8.1 (VBAT), U8.19 (VDD), U8.32 (VDD), U8.48 (VDD), U8.64 (VDD), U9.1 (OUT), U9.2 (SNS)
+3.3VA: C45.1, C46.2, C47.2, C48.2, C49.2, C55.1, C56.1, C64.1, U3.4 (V+), U4.6 (V+), U4.7 (REF1), U5.6 (V+), U5.7 (REF1), U6.6 (V+), U6.7 (REF1), U7.6 (V+), U7.7 (REF1), U8.13 (VDDA), U11.10 (OUT(FB)), U11.11 (OUT), U11.12 (OUT)
+12V: C60.1, C61.1, R40.1, U10.1 (VIN); also elsewhere on the board
/Controller/A_SENSE+: U4.8 (+); also elsewhere on the board
/Controller/A_SENSE-: R29.1, U4.1 (-); also elsewhere on the board
/Controller/B_SENSE+: U5.8 (+); also elsewhere on the board
/Controller/B_SENSE-: R31.1, U5.1 (-); also elsewhere on the board
/Controller/C_SENSE+: U6.8 (+); also elsewhere on the board
/Controller/C_SENSE-: R33.1, U6.1 (-); also elsewhere on the board
/Controller/D_SENSE+: U7.8 (+); also elsewhere on the board
/Controller/D_SENSE-: R35.1, U7.1 (-); also elsewhere on the board
/Controller/I2C_SCL: J14.1, TP9.1, U8.41 (PA8)
/Controller/I2C_SDA: J14.2, TP8.1, U8.40 (PC9)
/Controller/I2C_~INT: J14.3, TP7.1, U8.42 (PA9)
/Controller/SWCLK: J15.2, U8.49 (PA14)
/Controller/SWDIO: J15.4, U8.46 (PA13)
/Controller/UART_RX: TP5.1, U8.61 (PB8)
/Controller/UART_TX: TP6.1, U8.62 (PB9)
/~CLIP_OTW: U8.45 (PA12); also elsewhere on the board
/~FAULT: U8.44 (PA11); also elsewhere on the board
/~RESET: U8.43 (PA10); also elsewhere on the board
GND: C45.2, C46.1, C47.1, C48.1, C49.1, C50.2, C51.2, C52.2, C53.2, C54.2, C55.2, C56.2, C57.2, C58.2, C60.2, C61.2, C62.2, C63.2, C64.2, C65.2, J14.4, J15.3, R30.1, R32.1, R34.1, R36.1, R39.1, R42.2, R43.2, R45.2, U3.11 (V-), U4.2 (GND), U4.3 (REF2), U4.4 (GND), U5.2 (GND), U5.3 (REF2), U5.4 (GND), U6.2 (GND), U6.3 (REF2), U6.4 (GND), U7.2 (GND), U7.3 (REF2), U7.4 (GND), U8.12 (VSSA), U8.18 (VSS), U8.31 (VSS), U8.47 (VSS), U8.60 (BOOT0), U8.63 (VSS), U9.3 (GND), U9.5 (GND), U9.7 (PAD), U10.4 (PGND), U11.6 (GND(CP)), U11.7 (GND), U11.13 (EP); also elsewhere on the board
unnamed: J13.1, U8.20 (PA4)
unnamed: C57.1, J15.5, R37.2, U8.7 (NRST)
unnamed: R29.2, R30.2, U3.3 (+)
unnamed: U3.1, U3.2 (-), U8.21 (PA5)
unnamed: R31.2, R32.2, U3.5 (+)
unnamed: U3.6 (-), U3.7, U8.22 (PA6)
unnamed: R33.2, R34.2, U3.10 (+)
unnamed: U3.8, U3.9 (-), U8.33 (PB12)
unnamed: R35.2, R36.2, U3.12 (+)
unnamed: U3.13 (-), U3.14, U8.35 (PB14)
unnamed: U4.5, U8.14 (PA0)
unnamed: U5.5, U8.15 (PA1)
unnamed: U6.5, U8.27 (PB1)
unnamed: U7.5, U8.34 (PB13)
unnamed: R38.2, R39.2, U8.9 (PC1)
unnamed: R40.2, R42.1, U10.6 (EN)
unnamed: C59.2, R41.2, R43.1, U10.7 (FB)
unnamed: C59.1, C62.1, C63.1, R41.1, U9.4 (EN), U9.6 (IN), U10.3 (VOUT), U11.1 (IN), U11.2 (IN), U11.3 (IN(CP))
unnamed: C65.1, U11.4 (CP)
unnamed: R44.1, R45.1, U11.8 (FB)
unnamed: R44.2, U11.9 (SET)
PVDD: R38.1; also elsewhere on the board

Notes on the sheet:
Actually around +3.55V for headroom

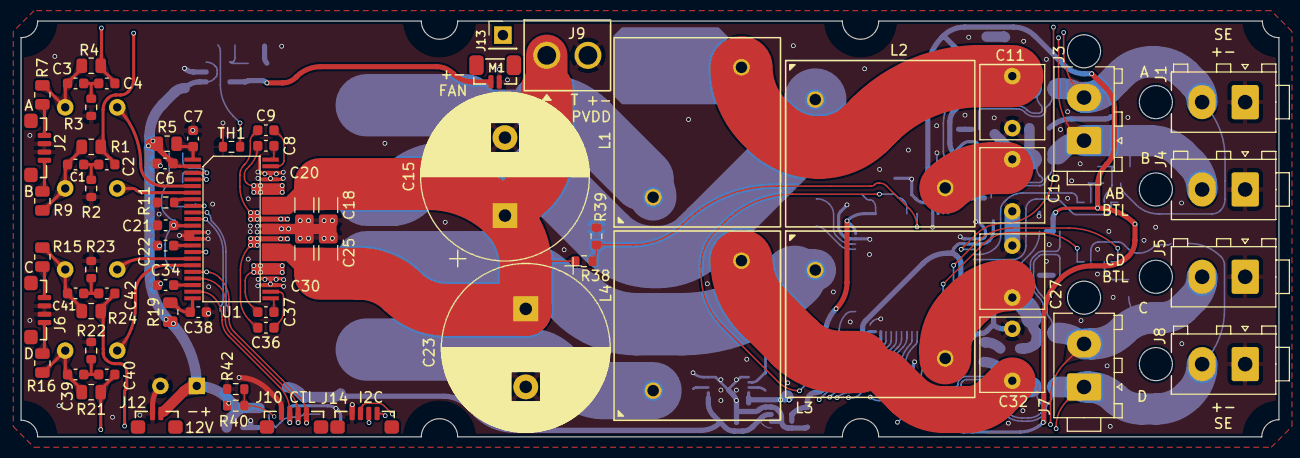
[picture p74: board PowerAmplifier.kicad_pcb from above]

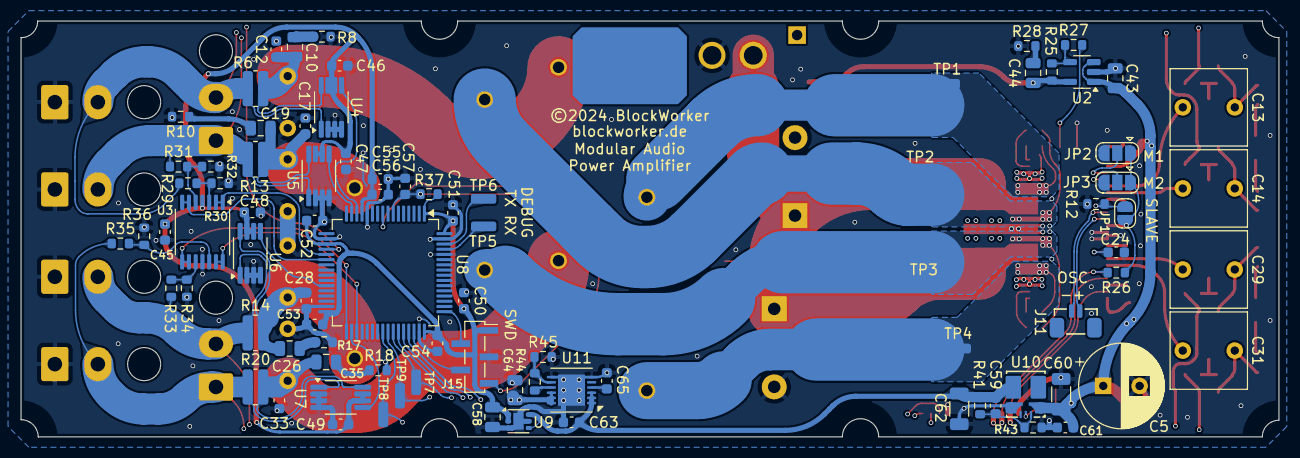
[picture p75: board PowerAmplifier.kicad_pcb from below]

Board: 4 copper layers, 121.0 x 40.0 mm, 155 parts (87 on the bottom side), 88 nets.

Other parts of the board:
HS1: ATS-xPX035035035_NoMounts
