BlockWorker/ModularAudio/CleanLVSupply/CleanLVSupply.kicad_pcb

## KiCad design CleanLVSupply/CleanLVSupply.kicad_pcb (2024-07-28)

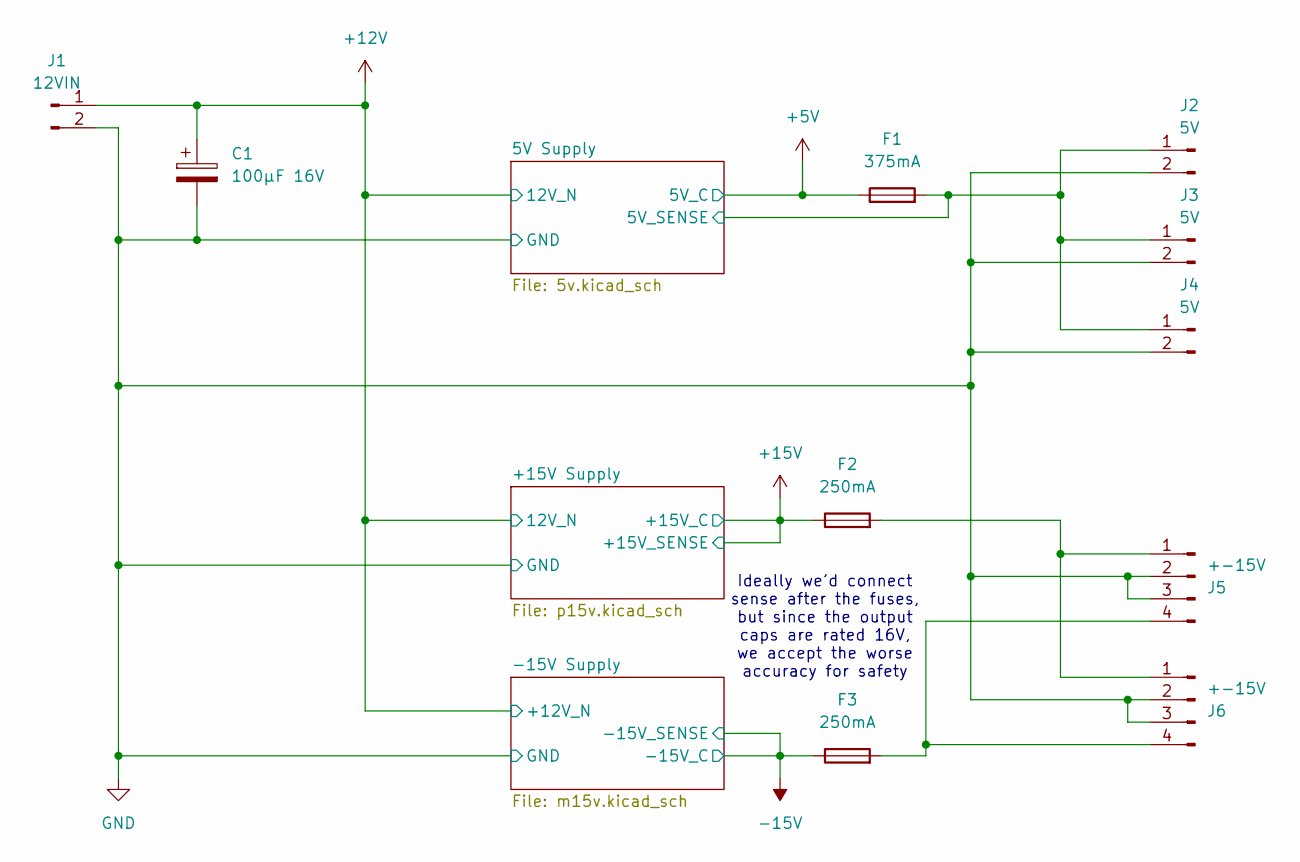
[picture p76: schematic CleanLVSupply.kicad_sch]

Parts:
C1: 100µF 16V; CP_Elec_6.3x5.8
F1: 375mA; Fuse_0603_1608Metric
F2, F3: 250mA; Fuse_0603_1608Metric
J1: 12VIN; Amphenol_MINITEK_0.8_2P_V
J2, J3, J4: 5V; Amphenol_MINITEK_0.8_2P_V
J5, J6: +-15V; Amphenol_MINITEK_0.8_4P_V

Connections:
+5V: F1.1; also elsewhere on the board
+12V: C1.1, J1.1; also elsewhere on the board
+15V: F2.1; also elsewhere on the board
-15V: F3.1; also elsewhere on the board
/5V Supply/5V_SENSE: F1.2, J2.1, J3.1, J4.1; also elsewhere on the board
GND: C1.2, J1.2, J2.2, J3.2, J4.2, J5.2, J5.3, J6.2, J6.3; also elsewhere on the board
unnamed: F2.2, J5.1, J6.1
unnamed: F3.2, J5.4, J6.4

Notes on the sheet:
Ideally we'd connect sense after the fuses, but since the output caps are rated 16V, we accept the worse accuracy for safety

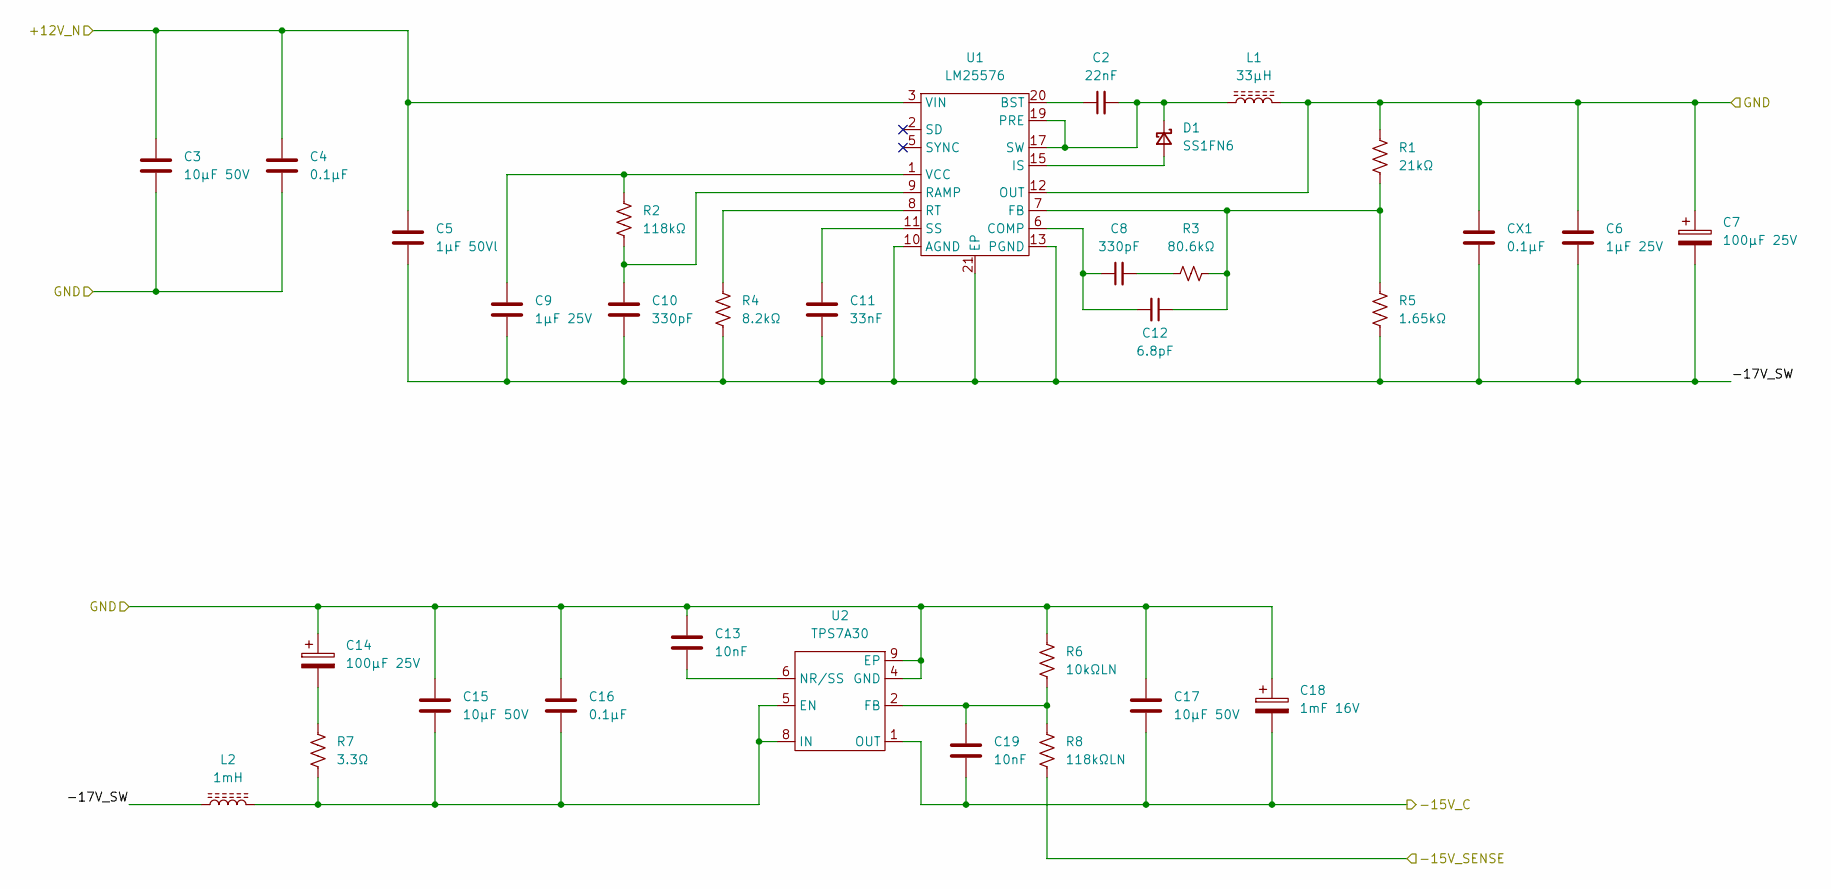
[picture p77: schematic m15v.kicad_sch]

Parts:
C2: 22nF; C_0603_1608Metric
C3, C15, C17: 10µF 50V; C_1206_3216Metric
C4, C16: 0.1µF; C_0603_1608Metric
C5: 1µF 50Vl; C_0805_2012Metric
C6, C9: 1µF 25V; C_0603_1608Metric
C7: 100µF 25V; CP_Elec_6.3x7.7
C8, C10: 330pF; C_0603_1608Metric
C11: 33nF; C_0603_1608Metric
C12: 6.8pF; C_0603_1608Metric
C13, C19: 10nF; C_0603_1608Metric
C14: 100µF 25V; CP_Radial_D6.3mm_P2.50mm
C18: 1mF 16V; CP_Radial_D8.0mm_P3.50mm
CX1: 0.1µF; C_0603_1608Metric
D1: SS1FN6; D_SMF
L1: 33µH; L_KEMET_MPGV1D1054
L2: 1mH; L_Coilcraft_MSS7348-XXX-fixed
R1: 21kΩ; R_0603_1608Metric
R2: 118kΩ; R_0603_1608Metric
R3: 80.6kΩ; R_0603_1608Metric
R4: 8.2kΩ; R_0603_1608Metric
R5: 1.65kΩ; R_0603_1608Metric
R6: 10kΩLN; R_0603_1608Metric
R7: 3.3Ω; R_0805_2012Metric
R8: 118kΩLN; R_0603_1608Metric
U1: LM25576; HTSSOP-20-1EP_4.4x6.5mm_P0.65mm_EP2.85x4mm
U2: TPS7A30; HVSSOP-8-1EP_3x3mm_P0.65mm_EP1.57x1.89mm

Connections:
+12V: C3.1, C4.1, C5.1, U1.3 (VIN), U1.4 (VIN); also elsewhere on the board
-15V: C17.2, C18.2, C19.2, R8.2, U2.1 (OUT); also elsewhere on the board
/-15V Supply/-17V_SW: C5.2, C6.2, C7.2, C9.2, C10.2, C11.2, CX1.2, L2.1, R4.2, R5.2, U1.10 (AGND), U1.13 (PGND), U1.14 (PGND), U1.21 (EP)
GND: C3.2, C4.2, C6.1, C7.1, C13.1, C14.1, C15.1, C16.1, C17.1, C18.1, CX1.1, L1.2, R1.1, R6.1, U1.12 (OUT), U2.4 (GND), U2.9 (EP); also elsewhere on the board
unnamed: C8.2, R3.1
unnamed: C14.2, R7.1
unnamed: D1.2 (A), U1.15 (IS), U1.16 (IS)
unnamed: C2.2, D1.1 (K), L1.1, U1.17 (SW), U1.18 (SW), U1.19 (PRE)
unnamed: C2.1, U1.20 (BST)
unnamed: C8.1, C12.2, U1.6 (COMP)
unnamed: C12.1, R1.2, R3.2, R5.1, U1.7 (FB)
unnamed: C10.1, R2.2, U1.9 (RAMP)
unnamed: R4.1, U1.8 (RT)
unnamed: C11.1, U1.11 (SS)
unnamed: C9.1, R2.1, U1.1 (VCC)
unnamed: C15.2, C16.2, L2.2, R7.2, U2.5 (EN), U2.8 (IN)
unnamed: C19.1, R6.2, R8.1, U2.2 (FB)
unnamed: C13.2, U2.6 (NR/SS)

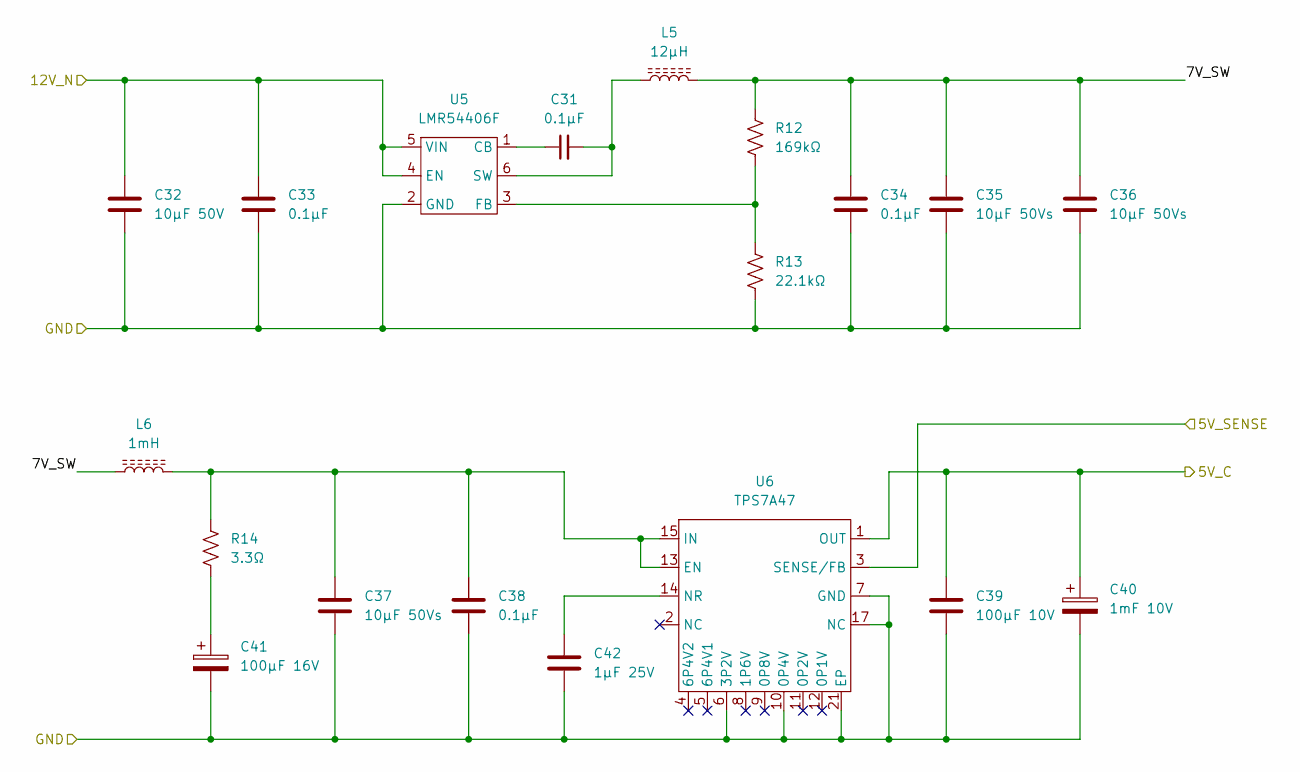
[picture p78: schematic 5v.kicad_sch]

Parts:
C31, C33, C34, C38: 0.1µF; C_0603_1608Metric
C32: 10µF 50V; C_1206_3216Metric
C35, C36, C37: 10µF 50Vs; C_0805_2012Metric
C39: 100µF 10V; C_1210_3225Metric
C40: 1mF 10V; CP_Radial_D8.0mm_P3.50mm
C41: 100µF 16V; CP_Radial_D5.0mm_P2.00mm
C42: 1µF 25V; C_0603_1608Metric
L5: 12µH; L_Bourns_SRR4528A
L6: 1mH; L_Coilcraft_MSS7348-XXX-fixed
R12: 169kΩ; R_0603_1608Metric
R13: 22.1kΩ; R_0603_1608Metric
R14: 3.3Ω; R_0805_2012Metric
U5: LMR54406F; SOT-23-6
U6: TPS7A47; Texas_RGW0020A_VQFN-20-1EP_5x5mm_P0.65mm_EP3.15x3.15mm

Connections:
+5V: C39.1, C40.1, U6.1 (OUT), U6.20 (OUT); also elsewhere on the board
+12V: C32.1, C33.1, U5.4 (EN), U5.5 (VIN); also elsewhere on the board
/5V Supply/5V_SENSE: U6.3 (SENSE/FB); also elsewhere on the board
/5V Supply/7V_SW: C34.1, C35.1, C36.1, L5.2, L6.1, R12.1
GND: C32.2, C33.2, C34.2, C35.2, C36.2, C37.2, C38.2, C39.2, C40.2, C41.2, C42.2, R13.2, U5.2 (GND), U6.6 (3P2V), U6.7 (GND), U6.10 (0P4V), U6.17 (NC), U6.18 (NC), U6.19 (NC), U6.21 (EP); also elsewhere on the board
unnamed: C41.1, R14.2
unnamed: C31.1, U5.1 (CB)
unnamed: R12.2, R13.1, U5.3 (FB)
unnamed: C31.2, L5.1, U5.6 (SW)
unnamed: C37.1, C38.1, L6.2, R14.1, U6.13 (EN), U6.15 (IN), U6.16 (IN)
unnamed: C42.1, U6.14 (NR)

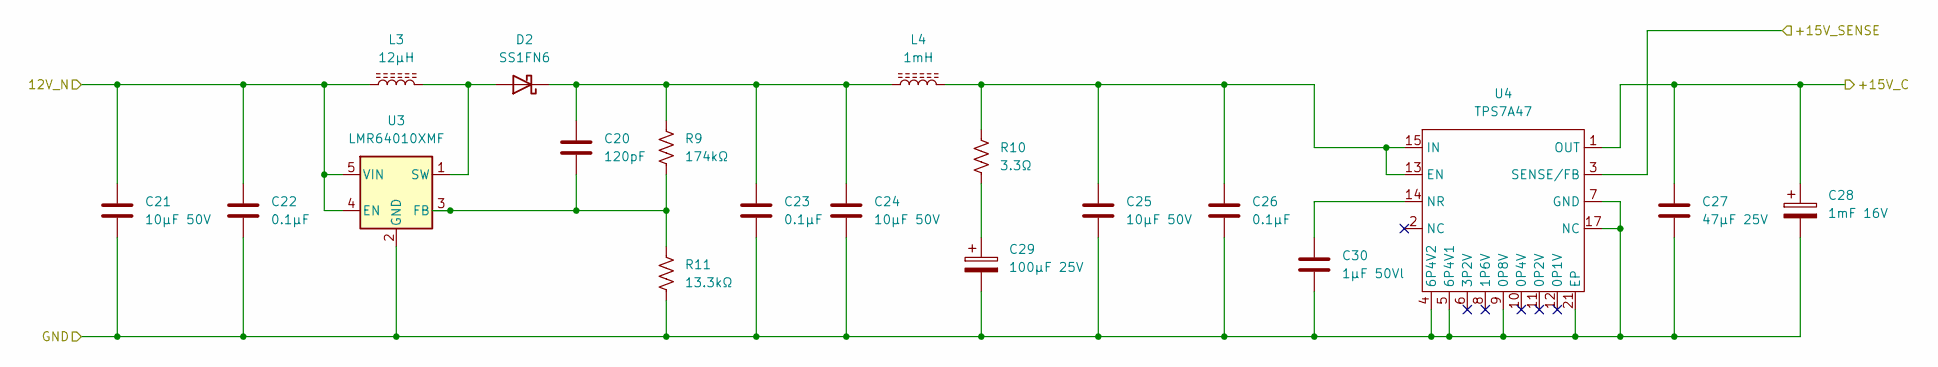
[picture p79: schematic p15v.kicad_sch]

Parts:
C20: 120pF; C_0603_1608Metric
C21, C24, C25: 10µF 50V; C_1206_3216Metric
C22, C23, C26: 0.1µF; C_0603_1608Metric
C27: 47µF 25V; C_2220_5750Metric
C28: 1mF 16V; CP_Radial_D8.0mm_P3.50mm
C29: 100µF 25V; CP_Radial_D6.3mm_P2.50mm
C30: 1µF 50Vl; C_0805_2012Metric
D2: SS1FN6; D_SMF
L3: 12µH; L_Abracon_ASPI-6045S
L4: 1mH; L_Coilcraft_MSS7348-XXX-fixed
R9: 174kΩ; R_0603_1608Metric
R10: 3.3Ω; R_0805_2012Metric
R11: 13.3kΩ; R_0603_1608Metric
U3: LMR64010XMF; SOT-23-5
U4: TPS7A47; Texas_RGW0020A_VQFN-20-1EP_5x5mm_P0.65mm_EP3.15x3.15mm

Connections:
+12V: C21.1, C22.1, L3.1, U3.4 (EN), U3.5 (VIN); also elsewhere on the board
+15V: C27.1, C28.1, U4.1 (OUT), U4.3 (SENSE/FB), U4.20 (OUT); also elsewhere on the board
GND: C21.2, C22.2, C23.2, C24.2, C25.2, C26.2, C27.2, C28.2, C29.2, C30.2, R11.2, U3.2 (GND), U4.4 (6P4V2), U4.5 (6P4V1), U4.7 (GND), U4.9 (0P8V), U4.17 (NC), U4.18 (NC), U4.19 (NC), U4.21 (EP); also elsewhere on the board
unnamed: C29.1, R10.2
unnamed: D2.2 (A), L3.2, U3.1 (SW)
unnamed: C20.1, C23.1, C24.1, D2.1 (K), L4.1, R9.1
unnamed: C20.2, R9.2, R11.1, U3.3 (FB)
unnamed: C25.1, C26.1, L4.2, R10.1, U4.13 (EN), U4.15 (IN), U4.16 (IN)
unnamed: C30.1, U4.14 (NR)

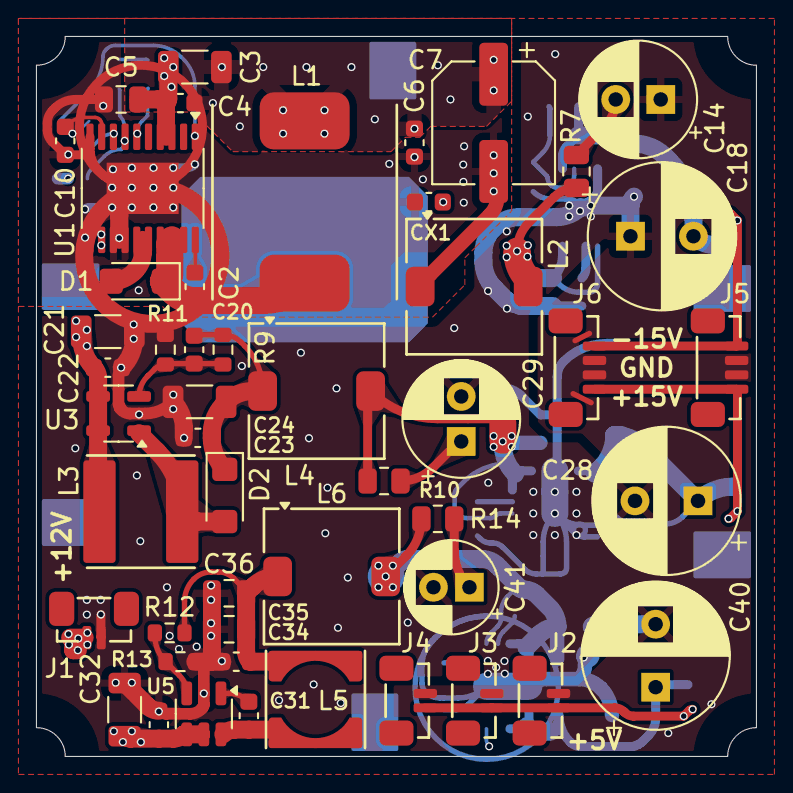
[picture p80: board CleanLVSupply.kicad_pcb from above]

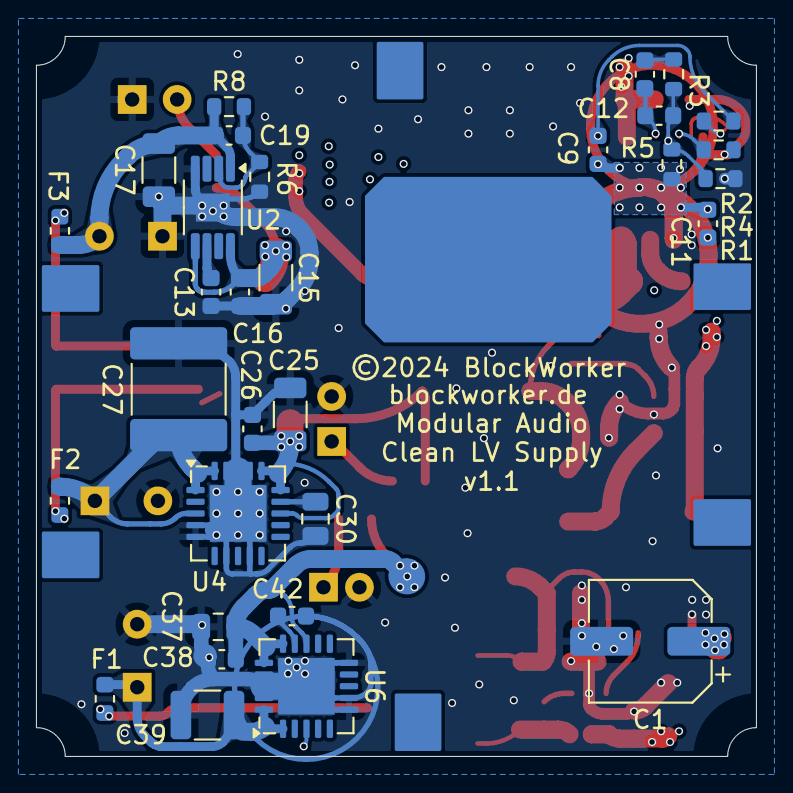
[picture p81: board CleanLVSupply.kicad_pcb from below]

Board: 4 copper layers, 40.0 x 40.0 mm, 80 parts (31 on the bottom side), 36 nets.
