BlockWorker/ModularAudio/firmware/BlockBoxController/BlockBoxController.ioc

Mcu.UserName=STM32H725VGTx
PA0.Signal=S_TIM2_CH1_ETR
PA1.Signal=S_TIM2_CH2
PA10.GPIO_Label=AMP_CLIP_OTW_N
PA10.Signal=GPIO_Input
PA11.GPIO_Label=AMP_FAULT_N
PA11.Signal=GPIO_Input
PA12.GPIO_Label=AMP_RESET_N
PA12.Signal=GPIO_Input
PA13(JTMS/SWDIO).Signal=DEBUG_JTMS-SWDIO
PA14(JTCK/SWCLK).Signal=DEBUG_JTCK-SWCLK
PA15(JTDI).Signal=I2S6_WS
PA2.Signal=USART2_TX
PA3.Signal=USART2_RX
PA4.GPIO_Label=LCD_GPIO3
PA4.Signal=GPIO_Input
PA5.GPIO_Label=LCD_GPIO2
PA5.Signal=GPIO_Input
PA6.Signal=OCTOSPIM_P1_IO3
PA7.Signal=OCTOSPIM_P1_IO2
PA8.Signal=I2C3_SCL
PB0.Signal=OCTOSPIM_P1_IO1
PB1.Signal=OCTOSPIM_P1_IO0
PB10.Signal=OCTOSPIM_P1_NCS
PB12.Signal=SPI2_NSS
PB13.Signal=SPI2_SCK
PB14.Signal=SPI2_MISO
PB15.Signal=SPI2_MOSI
PB2.Signal=OCTOSPIM_P1_CLK
PB3(JTDO/TRACESWO).Signal=I2S6_CK
PB4(NJTRST).Signal=I2S6_SDI
PB5.GPIO_Label=I2C1_INT0_N
PB5.Signal=GPXTI5
PB6.Signal=USART1_TX
PB7.Signal=USART1_RX
PB8.Signal=UART4_RX
PB9.Signal=UART4_TX
PC0.Signal=ADCx_INP10
PC1.Signal=ADCx_INP11
PC10.Signal=I2C5_SDA
PC11.Signal=I2C5_SCL
PC12.GPIO_Label=I2C5_INT0_N
PC12.Signal=GPXTI12
PC13.GPIO_Label=B1_PLAY
PC13.Signal=GPIO_Input
PC14-OSC32_IN.GPIO_Label=B1_MFB
PC14-OSC32_IN.Signal=GPIO_Input
PC15-OSC32_OUT.GPIO_Label=B1_FWD
PC15-OSC32_OUT.Signal=GPIO_Input
PC4.GPIO_Label=LCD_INT_N
PC4.Signal=GPXTI4
PC5.GPIO_Label=LCD_PD_N
PC5.Signal=GPIO_Output
PC8.GPIO_Label=CHG_ACOK
PC8.Signal=GPXTI8
PC9.Signal=I2C3_SDA
PD0.GPIO_Label=I2C5_INT1_N
PD0.Signal=GPXTI0
PD1.GPIO_Label=I2C5_INT2_N
PD1.Signal=GPXTI1
PD10.GPIO_Label=B1_LEDMODE_1
PD10.Signal=GPIO_Input
PD11.GPIO_Label=B1_LEDMODE_2
PD11.Signal=GPIO_Input
PD12.Signal=S_TIM4_CH1
PD13.Signal=S_TIM4_CH2
PD14.Signal=S_TIM4_CH3
PD2.GPIO_Label=I2C5_INT3_N
PD2.Signal=GPXTI2
PD3.GPIO_Label=I2C5_INT4_N
PD3.Signal=GPXTI3
PD9.GPIO_Label=B1_LCD_SWITCH
PD9.Signal=GPIO_Input
PE2.GPIO_Label=B1_VOL_UP
PE2.Signal=GPIO_Input
PE4.GPIO_Label=B1_VOL_DOWN
PE4.Signal=GPIO_Input
PE5.GPIO_Label=B1_BACK
PE5.Signal=GPIO_Input
PE7.GPIO_Label=LCD_B1_D3
PE7.Signal=GPIO_Input
PE8.GPIO_Label=LCD_BL_DRIVE
PE8.Signal=GPIO_Output
