BlockWorker/ModularAudio/firmware/PowerAmpController/Core/Src/main.c

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
/* Includes ------------------------------------------------------------------*/
#include "main.h"

/* USER CODE BEGIN Includes */
#include "retarget.h"
#include "stdio.h"
#include "adc.h"
#include "pvdd_control.h"
#include "safety.h"
#include "i2c.h"
/* USER CODE END Includes */

ADC_HandleTypeDef hadc1;
ADC_HandleTypeDef hadc2;
ADC_HandleTypeDef hadc3;
ADC_HandleTypeDef hadc4;
DMA_HandleTypeDef hdma_adc1;
DMA_HandleTypeDef hdma_adc2;
DMA_HandleTypeDef hdma_adc3;
DMA_HandleTypeDef hdma_adc4;

DAC_HandleTypeDef hdac1;

I2C_HandleTypeDef hi2c3;

IWDG_HandleTypeDef hiwdg;

UART_HandleTypeDef huart3;

WWDG_HandleTypeDef hwwdg;

/* USER CODE BEGIN PV */
static uint32_t wwdg_early_wakeups = 0;

static uint32_t clip_otw_last_assert_tick = 0;
static uint32_t clip_otw_last_clear_tick = 0;
bool clip_detected = false;
bool otw_detected = false;
/* USER CODE END PV */

void SystemClock_Config(void);
static void MX_GPIO_Init(void);
static void MX_DMA_Init(void);
static void MX_ADC1_Init(void);
static void MX_ADC2_Init(void);
static void MX_ADC3_Init(void);
static void MX_ADC4_Init(void);
static void MX_DAC1_Init(void);
static void MX_I2C3_Init(void);
static void MX_USART3_UART_Init(void);
static void MX_IWDG_Init(void);
static void MX_WWDG_Init(void);
/* USER CODE BEGIN 0 */
void HAL_GPIO_EXTI_Callback(uint16_t GPIO_Pin) {
  if (GPIO_Pin == AMP_FAULT_N_Pin) {
    if (HAL_GPIO_ReadPin(AMP_FAULT_N_GPIO_Port, AMP_FAULT_N_Pin) == GPIO_PIN_SET) {
      DEBUG_PRINTF("Amp Fault Cleared\n");
    } else {
      DEBUG_PRINTF("Amp Fault Detected!!\n");
      I2C_TriggerInterrupt(I2CDEF_POWERAMP_INT_FLAGS_INT_AMP_FAULT_Msk);
    }
  } else if (GPIO_Pin == AMP_CLIP_OTW_N_Pin) {
    //just store the current tick in corresponding variable
    if (HAL_GPIO_ReadPin(AMP_CLIP_OTW_N_GPIO_Port, AMP_CLIP_OTW_N_Pin) == GPIO_PIN_RESET) {
      //asserted
      clip_otw_last_assert_tick = HAL_GetTick();
    } else {
      //cleared
      clip_otw_last_clear_tick = HAL_GetTick();
    }
  }
}

void HAL_WWDG_EarlyWakeupCallback(WWDG_HandleTypeDef *hwwdg) {
  //if this interrupt gets through: we are not stuck in any other interrupt (since this one is lowest priority)
  //allow a limited number of refreshes in this case (main loop can "freeze" for a little longer this way if needed)
  if (wwdg_early_wakeups < MAIN_WWDG_EARLYWAKE_MAX) {
    wwdg_early_wakeups++;
    HAL_WWDG_Refresh(hwwdg);
    DEBUG_PRINTF("WWDG Early wakeup %lu\n", wwdg_early_wakeups);
  }
}

static __always_inline void _RefreshWatchdogs() {
  HAL_WWDG_Refresh(&hwwdg);
  wwdg_early_wakeups = 0;
  HAL_IWDG_Refresh(&hiwdg);
}

void RefreshWatchdogsExt() {
  _RefreshWatchdogs();
}
/* USER CODE END 0 */

/**
  * @brief  The application entry point.
  * @retval int
  */
int main(void)
{
  /* MCU Configuration--------------------------------------------------------*/

  /* Reset of all peripherals, Initializes the Flash interface and the Systick. */
  HAL_Init();

  /* Configure the system clock */
  SystemClock_Config();

  /* USER CODE BEGIN SysInit */
  //below: moved DAC1 init to the very start
  /* USER CODE END SysInit */

  /* Initialize all configured peripherals */
  MX_DAC1_Init();
  MX_GPIO_Init();
  MX_DMA_Init();
  MX_ADC1_Init();
  MX_ADC2_Init();
  MX_ADC3_Init();
  MX_ADC4_Init();
  MX_I2C3_Init();
  MX_USART3_UART_Init();
  MX_IWDG_Init();
  MX_WWDG_Init();
  /* USER CODE BEGIN 2 */

  RetargetInit(&huart3);

  _RefreshWatchdogs();

  DEBUG_PRINTF("Controller started\n");

  _RefreshWatchdogs();

  DEBUG_PRINTF("Initializing PVDD control...\n");
  if (PVDD_Init() != HAL_OK) {
    Error_Handler();
  }

  _RefreshWatchdogs();
  HAL_Delay(10);
  _RefreshWatchdogs();

  DEBUG_PRINTF("Calibrating ADC...\n");
  if (ADC_Calibrate() != HAL_OK) {
    Error_Handler();
  }

  _RefreshWatchdogs();

  DEBUG_PRINTF("ADC cal complete, starting monitoring\n");
  if (ADC_StartMonitoring() != HAL_OK) {
    Error_Handler();
  }

  HAL_Delay(10);
  _RefreshWatchdogs();

  DEBUG_PRINTF("Initializing safety system...\n");
  if (SAFETY_Init() != HAL_OK) {
    Error_Handler();
  }

  HAL_Delay(10);
  _RefreshWatchdogs();

  DEBUG_PRINTF("Initializing I2C...\n");
  if (I2C_Init() != HAL_OK) {
    Error_Handler();
  }

  HAL_Delay(10);
  _RefreshWatchdogs();

  DEBUG_PRINTF("Amp state: fault %d clip %d\n", HAL_GPIO_ReadPin(AMP_FAULT_N_GPIO_Port, AMP_FAULT_N_Pin), HAL_GPIO_ReadPin(AMP_CLIP_OTW_N_GPIO_Port, AMP_CLIP_OTW_N_Pin));

  DEBUG_PRINTF("Init complete!\n");

  /* USER CODE END 2 */

  /* Infinite loop */
  /* USER CODE BEGIN WHILE */
  while (1) {
    /* USER CODE END WHILE */

    /* USER CODE BEGIN 3 */
    uint32_t iteration_start_tick = HAL_GetTick();

    //check clip/otw last edges: if close enough to each other and now, detect clipping
    if (clip_otw_last_assert_tick - clip_otw_last_clear_tick < 25 && iteration_start_tick - clip_otw_last_clear_tick < 40) {
      if (!clip_detected && !otw_detected) {
        clip_detected = true;
        I2C_TriggerInterrupt(I2CDEF_POWERAMP_INT_FLAGS_INT_CLIP_DET_Msk);
      }
    }
    //check clip/otw state
    if (HAL_GPIO_ReadPin(AMP_CLIP_OTW_N_GPIO_Port, AMP_CLIP_OTW_N_Pin) == GPIO_PIN_RESET) {
      //asserted: detect OTW if last assert edge was long enough ago (i.e. long enough pulse)
      if (iteration_start_tick - clip_otw_last_assert_tick > 25) {
        otw_detected = true;
        clip_detected = false;
        I2C_TriggerInterrupt(I2CDEF_POWERAMP_INT_FLAGS_INT_OTW_DET_Msk);
      }
    } else {
      //cleared: clear OTW, and if last clear edge is long enough ago, clear clipping too
      otw_detected = false;
      if (iteration_start_tick - clip_otw_last_clear_tick > 30) {
        clip_detected = false;
      }
    }

#ifdef DISABLED___DEBUG
    static uint32_t cycle_count = 0;
    if (cycle_count++ * MAIN_LOOP_PERIOD_MS >= 1000) {
      cycle_count = 0;
      printf("---------------------\n");
      printf("PVDD: %6.3f valid %d - amp shutdown %d\n", pvdd_voltage_measured, pvdd_valid_voltage, is_shutdown);
      printf("Vrms: %7.3f/%7.3f  %7.3f/%7.3f  %7.3f/%7.3f  %7.3f/%7.3f\n", rms_voltage_0s1[0], rms_voltage_1s0[0], rms_voltage_0s1[1], rms_voltage_1s0[1], rms_voltage_0s1[2], rms_voltage_1s0[2], rms_voltage_0s1[3], rms_voltage_1s0[3]);
      printf("Irms: %7.3f/%7.3f  %7.3f/%7.3f  %7.3f/%7.3f  %7.3f/%7.3f\n", rms_current_0s1[0], rms_current_1s0[0], rms_current_0s1[1], rms_current_1s0[1], rms_current_0s1[2], rms_current_1s0[2], rms_current_0s1[3], rms_current_1s0[3]);
      printf("Pavg: %7.3f/%7.3f  %7.3f/%7.3f  %7.3f/%7.3f  %7.3f/%7.3f\n", avg_real_power_0s1[0], avg_real_power_1s0[0], avg_real_power_0s1[1], avg_real_power_1s0[1], avg_real_power_0s1[2], avg_real_power_1s0[2], avg_real_power_0s1[3], avg_real_power_1s0[3]);
      printf("Papp: %7.3f/%7.3f  %7.3f/%7.3f  %7.3f/%7.3f  %7.3f/%7.3f\n", avg_apparent_power_0s1[0], avg_apparent_power_1s0[0], avg_apparent_power_0s1[1], avg_apparent_power_1s0[1], avg_apparent_power_0s1[2], avg_apparent_power_1s0[2], avg_apparent_power_0s1[3], avg_apparent_power_1s0[3]);
    }
#endif

    PVDD_LoopUpdate();
    SAFETY_LoopUpdate();
    I2C_LoopUpdate();

    _RefreshWatchdogs();
    while((HAL_GetTick() - iteration_start_tick) < MAIN_LOOP_PERIOD_MS); //replaces HAL_Delay() to not wait any unnecessary extra ticks
  }
  /* USER CODE END 3 */
}

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
