BlockWorker/ModularAudio/firmware/DigitalAudioProcessor/Core/Src/main.c

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
/* Includes ------------------------------------------------------------------*/
#include "main.h"
#include "usb_device.h"

/* USER CODE BEGIN Includes */
#include "retarget.h"
#include "sample_rate_conv.h"
#include "signal_processing.h"
#include "sai_out.h"
#include "inputs.h"
#include "i2c.h"
/* USER CODE END Includes */


I2C_HandleTypeDef hi2c1;

I2S_HandleTypeDef hi2s1;
I2S_HandleTypeDef hi2s2;
I2S_HandleTypeDef hi2s3;
DMA_HandleTypeDef hdma_spi1_rx;
DMA_HandleTypeDef hdma_spi2_rx;
DMA_HandleTypeDef hdma_spi3_rx;

RAMECC_HandleTypeDef hramecc1_m1;
RAMECC_HandleTypeDef hramecc1_m2;
RAMECC_HandleTypeDef hramecc1_m3;
RAMECC_HandleTypeDef hramecc1_m4;
RAMECC_HandleTypeDef hramecc1_m6;
RAMECC_HandleTypeDef hramecc2_m1;
RAMECC_HandleTypeDef hramecc2_m2;
RAMECC_HandleTypeDef hramecc3_m1;

SAI_HandleTypeDef hsai_BlockB4;
DMA_HandleTypeDef hdma_sai4_b;

SPDIFRX_HandleTypeDef hspdif1;
DMA_HandleTypeDef hdma_spdif_rx_cs;
DMA_HandleTypeDef hdma_spdif_rx_dt;

TIM_HandleTypeDef htim2;
TIM_HandleTypeDef htim5;

UART_HandleTypeDef huart4;

WWDG_HandleTypeDef hwwdg1;

MDMA_HandleTypeDef hmdma_mdma_channel0_sw_0;
void SystemClock_Config(void);
void PeriphCommonClock_Config(void);
static void MPU_Config(void);
static void MX_GPIO_Init(void);
static void MX_BDMA_Init(void);
static void MX_DMA_Init(void);
static void MX_MDMA_Init(void);
static void MX_I2S2_Init(void);
static void MX_I2S3_Init(void);
static void MX_SAI4_Init(void);
static void MX_SPDIFRX1_Init(void);
static void MX_I2C1_Init(void);
static void MX_UART4_Init(void);
static void MX_I2S1_Init(void);
static void MX_RAMECC_Init(void);
static void MX_TIM2_Init(void);
static void MX_TIM5_Init(void);
static void MX_WWDG1_Init(void);
/* USER CODE BEGIN 0 */
static __always_inline void _RefreshWatchdogs() {
  //HAL_IWDG_Refresh(&hiwdg1);
  HAL_WWDG_Refresh(&hwwdg1);
}
/* USER CODE END 0 */

/**
  * @brief  The application entry point.
  * @retval int
  */
int main(void)
{
  /* USER CODE BEGIN 1 */
  /*CoreDebug->DEMCR |= CoreDebug_DEMCR_TRCENA_Msk;
  DWT->LAR = 0xC5ACCE55;
  DWT->CYCCNT = 0;
  DWT->CTRL |= (DWT_CTRL_CYCCNTENA_Msk | DWT_CTRL_EXCTRCENA_Msk | DWT_CTRL_CPIEVTENA_Msk |
      DWT_CTRL_EXCEVTENA_Msk | DWT_CTRL_LSUEVTENA_Msk | DWT_CTRL_FOLDEVTENA_Msk);*/
  /* USER CODE END 1 */

  /* MPU Configuration--------------------------------------------------------*/
  MPU_Config();

  /* Enable I-Cache---------------------------------------------------------*/
  SCB_EnableICache();

  /* MCU Configuration--------------------------------------------------------*/

  /* Reset of all peripherals, Initializes the Flash interface and the Systick. */
  HAL_Init();

  /* Configure the system clock */
  SystemClock_Config();

/* Configure the peripherals common clocks */
  PeriphCommonClock_Config();

  /* Initialize all configured peripherals */
  MX_GPIO_Init();
  MX_BDMA_Init();
  MX_DMA_Init();
  MX_MDMA_Init();
  MX_I2S2_Init();
  MX_I2S3_Init();
  MX_SAI4_Init();
  MX_SPDIFRX1_Init();
  MX_I2C1_Init();
  MX_UART4_Init();
  MX_USB_DEVICE_Init();
  MX_I2S1_Init();
  MX_RAMECC_Init();
  MX_TIM2_Init();
  MX_TIM5_Init();
  MX_WWDG1_Init();
  /* USER CODE BEGIN 2 */

  RetargetInit(&huart4);
  DEBUG_PRINTF("Controller started\n");

  _RefreshWatchdogs();

  //init SRC before USB to receive samples right away
  if (SRC_Init() == HAL_OK) {
    DEBUG_PRINTF("SRC initialised\n");
  } else {
    DEBUG_PRINTF("*** SRC init failed!\n");
    HAL_Delay(100);
    Error_Handler();
  }

  if (SRC_Configure(SR_96K) == HAL_OK) {
    DEBUG_PRINTF("SRC configured for 96K\n");
  } else {
    DEBUG_PRINTF("*** SRC config failed!\n");
    HAL_Delay(100);
    Error_Handler();
  }

  _RefreshWatchdogs();

  if (SP_Init() == HAL_OK) {
    DEBUG_PRINTF("SP initialised\n");
  } else {
    DEBUG_PRINTF("*** SP init failed!\n");
    HAL_Delay(100);
    Error_Handler();
  }

  if (SAI_OUT_Init() == HAL_OK) {
    DEBUG_PRINTF("SAI initialised\n");
  } else {
    DEBUG_PRINTF("*** SAI init failed!\n");
    HAL_Delay(100);
    Error_Handler();
  }

  _RefreshWatchdogs();

  if (INPUT_Init() == HAL_OK) {
    DEBUG_PRINTF("Inputs initialised\n");
  } else {
    DEBUG_PRINTF("*** Input init failed!\n");
    HAL_Delay(100);
    Error_Handler();
  }

  if (I2C_Init() == HAL_OK) {
    DEBUG_PRINTF("I2C initialised\n");
  } else {
    DEBUG_PRINTF("*** I2C init failed!\n");
    HAL_Delay(100);
    Error_Handler();
  }

  _RefreshWatchdogs();

#ifdef DEBUG
  //initialise cycle counter and let it run, for tracking idle cycles
  /*CoreDebug->DEMCR |= CoreDebug_DEMCR_TRCENA_Msk;
  DWT->LAR = 0xC5ACCE55;
  DWT->CYCCNT = 0;
  DWT->CTRL |= DWT_CTRL_CYCCNTENA_Msk;

  uint32_t idle_cycles = 0;
  float avg_idle_cycles = 0.0f;*/
#endif

  /* USER CODE END 2 */

  /* Infinite loop */
  /* USER CODE BEGIN WHILE */
  //loop iteration counter - even if extremely unlikely wrap-around happens, it shouldn't be critical
  uint32_t loop_count = 0;
  while (1)
  {
    uint32_t iteration_start_tick = HAL_GetTick();
    /* USER CODE END WHILE */

    /* USER CODE BEGIN 3 */
#ifdef DEBUG
    /*avg_idle_cycles = 0.125f * (float)idle_cycles + 0.875f * avg_idle_cycles;
    idle_cycles = 0;*/

    //SRC debug printouts
    /*if (loop_count % 200 == 0) {
      extern float* const src_debug_adaptive_decimation_ptr;
      DEBUG_PRINTF("Adaptive decm factor: %.4f  rate err: %.5f  buffer err: %.1f\n", *src_debug_adaptive_decimation_ptr, SRC_GetAverageRateError(), SRC_GetAverageBufferFillError());
      extern float _spdif_sample_rate_approx;
      DEBUG_PRINTF("SPDIF in rate: %.1f\n", _spdif_sample_rate_approx);
    }*/
#endif

    /*if (loop_count % 50 == 0) {
      DEBUG_PRINTF("USB VBUS: %u\n", HAL_GPIO_ReadPin(GPIOA, GPIO_PIN_9));
    }*/

    INPUT_LoopUpdate();
    I2C_LoopUpdate();

    loop_count++;
    _RefreshWatchdogs();
    while((HAL_GetTick() - iteration_start_tick) < MAIN_LOOP_PERIOD_MS) { //replaces HAL_Delay() to not wait any unnecessary extra ticks
#ifdef DEBUG

#endif
    }
  }
  /* USER CODE END 3 */
}

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
/* MPU Configuration */

void MPU_Config(void)
{
  MPU_Region_InitTypeDef MPU_InitStruct = {0};

  /* Disables the MPU */
  HAL_MPU_Disable();

  /** Initializes and configures the Region and the memory to be protected
  */
  MPU_InitStruct.Enable = MPU_REGION_ENABLE;
  MPU_InitStruct.Number = MPU_REGION_NUMBER0;
  MPU_InitStruct.BaseAddress = 0x0;
  MPU_InitStruct.Size = MPU_REGION_SIZE_4GB;
  MPU_InitStruct.SubRegionDisable = 0x0;
  MPU_InitStruct.TypeExtField = MPU_TEX_LEVEL1;
  MPU_InitStruct.AccessPermission = MPU_REGION_FULL_ACCESS;
  MPU_InitStruct.DisableExec = MPU_INSTRUCTION_ACCESS_ENABLE;
  MPU_InitStruct.IsShareable = MPU_ACCESS_NOT_SHAREABLE;
  MPU_InitStruct.IsCacheable = MPU_ACCESS_NOT_CACHEABLE;
  MPU_InitStruct.IsBufferable = MPU_ACCESS_NOT_BUFFERABLE;

  HAL_MPU_ConfigRegion(&MPU_InitStruct);

  /** Initializes and configures the Region and the memory to be protected
  */
  MPU_InitStruct.Number = MPU_REGION_NUMBER1;
  MPU_InitStruct.Size = MPU_REGION_SIZE_512MB;
  MPU_InitStruct.TypeExtField = MPU_TEX_LEVEL0;
  MPU_InitStruct.IsCacheable = MPU_ACCESS_CACHEABLE;

  HAL_MPU_ConfigRegion(&MPU_InitStruct);

  /** Initializes and configures the Region and the memory to be protected
  */
  MPU_InitStruct.Number = MPU_REGION_NUMBER2;
  MPU_InitStruct.Size = MPU_REGION_SIZE_64KB;
  MPU_InitStruct.AccessPermission = MPU_REGION_PRIV_RO_URO;

  HAL_MPU_ConfigRegion(&MPU_InitStruct);

  /** Initializes and configures the Region and the memory to be protected
  */
  MPU_InitStruct.Number = MPU_REGION_NUMBER3;
  MPU_InitStruct.Size = MPU_REGION_SIZE_4KB;
  MPU_InitStruct.AccessPermission = MPU_REGION_NO_ACCESS;
  MPU_InitStruct.DisableExec = MPU_INSTRUCTION_ACCESS_DISABLE;
  MPU_InitStruct.IsCacheable = MPU_ACCESS_NOT_CACHEABLE;

  HAL_MPU_ConfigRegion(&MPU_InitStruct);

  /** Initializes and configures the Region and the memory to be protected
  */
  MPU_InitStruct.Number = MPU_REGION_NUMBER4;
  MPU_InitStruct.BaseAddress = 0x40000000;
  MPU_InitStruct.Size = MPU_REGION_SIZE_512MB;
  MPU_InitStruct.TypeExtField = MPU_TEX_LEVEL2;
  MPU_InitStruct.AccessPermission = MPU_REGION_FULL_ACCESS;

  HAL_MPU_ConfigRegion(&MPU_InitStruct);
  /* Enables the MPU */
  HAL_MPU_Enable(MPU_PRIVILEGED_DEFAULT);

}

/**
  * @brief  This function is executed in case of error occurrence.
  * @retval None
  */
void Error_Handler(void)
{
  /* USER CODE BEGIN Error_Handler_Debug */
  /* User can add his own implementation to report the HAL error return state */
  __disable_irq();
  while (1)
  {
  }
  /* USER CODE END Error_Handler_Debug */
}

#ifdef  USE_FULL_ASSERT
/**
  * @brief  Reports the name of the source file and the source line number
  *         where the assert_param error has occurred.
  * @param  file: pointer to the source file name
  * @param  line: assert_param error line source number
  * @retval None
  */
void assert_failed(uint8_t *file, uint32_t line)
{
  /* USER CODE BEGIN 6 */
  /* User can add his own implementation to report the file name and line number,
     ex: printf("Wrong parameters value: file %s on line %d\r\n", file, line) */
  /* USER CODE END 6 */
}
#endif /* USE_FULL_ASSERT */
