BlockWorker/ModularAudio/firmware/BluetoothReceiver_Controller/Core/Src/bt_driver.c

/*
 * bt_driver.c
 *
 *  Created on: Mar 2, 2025
 *      Author: Alex
 */

#include "bt_driver.h"
#include "uart_host.h"
#include <stdlib.h>


#define BT_PARSEBUF_SIZE 2048
#define BT_CMDBUF_SIZE 256


typedef struct _cmd_queue_item {
  BT_Command command;
  char cmd_text[BT_CMDBUF_SIZE];
  uint32_t cmd_length;
  uint8_t retransmit_attempts;
  struct _cmd_queue_item* next;
} BT_CommandQueueItem;


//arrays of definition strings for configuration, commands, and notification parsing
static const char* _config_array[] = BT_CONFIG_ARRAY;

//UART receive buffer (byte and char/text views)
static uint8_t _rx_buffer[BT_RXBUF_SIZE] = { 0 };
static char* _rx_text = (char*)_rx_buffer;
//buffer offset of start of current receive call
static uint32_t _rx_buffer_write_offset = 0;
//buffer offset of the next character to be read for parsing
static uint32_t _rx_buffer_read_offset = 0;

//notification parse buffer holding current notification (or part if not complete yet)
static char _parse_buffer[BT_PARSEBUF_SIZE] = { 0 };
//parse buffer offset of next character to be written
static uint32_t _parse_buffer_write_offset = 0;
//smaller text buffers for notification parameters
static char _parse_str_0[256] = { 0 };
static char _parse_str_1[256] = { 0 };
static char _parse_str_2[256] = { 0 };
static char _parse_str_3[256] = { 0 };

//command preparation buffer holding the current command
static char _cmd_prep_buffer[BT_CMDBUF_SIZE] = { 0 };
//head and tail pointers of command queue
static BT_CommandQueueItem* _cmd_queue_head = NULL;
static BT_CommandQueueItem* _cmd_queue_tail = NULL;

//command that is currently being executed (and has not been confirmed as completed yet)
static BT_Command _current_command = CMD_NONE;
//transmit buffer for the current command
static char _cmd_tx_buffer[BT_CMDBUF_SIZE] = { 0 };
//tick after which the next command may be sent
static uint32_t _next_cmd_tick = 0;
//tick after which the current command times out
static uint32_t _cmd_timeout_tick = HAL_MAX_DELAY;

//whether any config changes had to be made during init, requiring a write and reset
static bool _init_config_changed = false;
//whether a factory reset should be forced on next init
static bool _init_force_factory_reset = false;

//link parameters seen in status update
static uint8_t _status_a2dp_link_id = 0;
static uint64_t _status_a2dp_bt_addr = 0;
static bool _status_a2dp_stream_active = false;
static char _status_a2dp_codec[BT_STATE_STR_LENGTH] = { 0 };
static uint8_t _status_avrcp_link_id = 0;
static uint64_t _status_avrcp_bt_addr = 0;
static bool _status_avrcp_playing = false;

//whether an interrupt handler has detected an error, requiring a reset
static bool _interrupt_error = false;
//whether HAL error interrupts should be suppressed (after MCU reset)
static bool _suppress_error_interrupt = true;


BT_DriverState bt_driver_state;


/******************************************************************************************
 * COMMAND FUNCTIONS
 ******************************************************************************************/

static HAL_StatusTypeDef _BT_QueueCommand(BT_Command command, int32_t length) {
  if (length <= 0 || length >= BT_CMDBUF_SIZE) {
    //command buffer overflow or other error
    return HAL_ERROR;
  }

  //allocate queue item
  BT_CommandQueueItem* new_item = malloc(sizeof(BT_CommandQueueItem));
  if (new_item == NULL) {
    //insufficient heap memory
    return HAL_ERROR;
  }

  //populate queue item values
  new_item->command = command;
  memcpy(new_item->cmd_text, _cmd_prep_buffer, length);
  new_item->cmd_text[length] = '\0';
  new_item->cmd_length = length;
  new_item->retransmit_attempts = 0;
  new_item->next = NULL;

  if (_cmd_queue_head == NULL || _cmd_queue_tail == NULL) {
    //queue currently empty: make new item the first and only item
    _cmd_queue_head = new_item;
  } else {
    //queue not empty: append new item to the tail
    _cmd_queue_tail->next = new_item;
  }
  //new item becomes the tail either way
  _cmd_queue_tail = new_item;

  return HAL_OK;
}

static BT_CommandQueueItem* _BT_DequeueCommand() {
  if (_cmd_queue_head == NULL || _cmd_queue_tail == NULL) {
    //empty queue: nothing to dequeue
    return NULL;
  }

  //take item from the front (head) of the queue, next item becomes the new head
  BT_CommandQueueItem* item = _cmd_queue_head;
  _cmd_queue_head = item->next;
  if (_cmd_queue_head == NULL) {
    //removed item was the last item: clear tail pointer too
    _cmd_queue_tail = NULL;
  }

  return item;
}

//put the given command back at the top of the queue, e.g. in case of an error
static void _BT_RequeueCommand(BT_CommandQueueItem* item) {
  if (item == NULL) {
    return;
  }

  if (_cmd_queue_head == NULL || _cmd_queue_tail == NULL) {
    //queue currently empty: make item the only item, i.e. also the tail
    _cmd_queue_tail = item;
    item->next = NULL;
  } else {
    //queue not empty: append current head to the item
    item->next = _cmd_queue_head;
  }
  //either way: item becomes the new head
  _cmd_queue_head = item;
}

static void _BT_ClearCommandQueue() {
  //iterate through queue from head, freeing all items
  BT_CommandQueueItem* item = _cmd_queue_head;
  while (item != NULL) {
    BT_CommandQueueItem* next_item = item->next;
    free(item);
    item = next_item;
  }

  //clear pointers to mark queue as empty
  _cmd_queue_head = NULL;
  _cmd_queue_tail = NULL;
}

HAL_StatusTypeDef BT_Command_AVRCP_META_DATA(uint8_t link_id) {
  int32_t res = snprintf(_cmd_prep_buffer, BT_CMDBUF_SIZE, BT_CMD_AVRCP_META_DATA, link_id);
  return _BT_QueueCommand(CMD_AVRCP_META_DATA, res);
}

HAL_StatusTypeDef BT_Command_BROADCAST(bool start, uint8_t source, const char* pin) {
  int32_t res = snprintf(_cmd_prep_buffer, BT_CMDBUF_SIZE, BT_CMD_BROADCAST, start ? "ON" : "OFF", source, pin);
  return _BT_QueueCommand(CMD_BROADCAST, res);
}

HAL_StatusTypeDef BT_Command_BROADCODE(uint8_t link_id, const char* pin) {
  int32_t res = snprintf(_cmd_prep_buffer, BT_CMDBUF_SIZE, BT_CMD_BROADCODE, link_id, pin);
  return _BT_QueueCommand(CMD_BROADCODE, res);
}

HAL_StatusTypeDef BT_Command_CLOSE(uint8_t link_id) {
  int32_t res = snprintf(_cmd_prep_buffer, BT_CMDBUF_SIZE, BT_CMD_CLOSE, link_id);
  return _BT_QueueCommand(CMD_CLOSE, res);
}

HAL_StatusTypeDef BT_Command_CLOSE_ALL() {
  int32_t res = snprintf(_cmd_prep_buffer, BT_CMDBUF_SIZE, BT_CMD_CLOSE_ALL);
  return _BT_QueueCommand(CMD_CLOSE_ALL, res);
}

static HAL_StatusTypeDef BT_Command_CONFIG() {
  int32_t res = snprintf(_cmd_prep_buffer, BT_CMDBUF_SIZE, BT_CMD_CONFIG);
  return _BT_QueueCommand(CMD_CONFIG, res);
}

HAL_StatusTypeDef BT_Command_CONNECTABLE(bool connectable) {
  int32_t res = snprintf(_cmd_prep_buffer, BT_CMDBUF_SIZE, BT_CMD_CONNECTABLE, connectable ? "ON" : "OFF");
  return _BT_QueueCommand(CMD_CONNECTABLE, res);
}

HAL_StatusTypeDef BT_Command_DISCOVERABLE(bool discoverable) {
  int32_t res = snprintf(_cmd_prep_buffer, BT_CMDBUF_SIZE, BT_CMD_DISCOVERABLE, discoverable ? "ON" : "OFF");
  return _BT_QueueCommand(CMD_DISCOVERABLE, res);
}

HAL_StatusTypeDef BT_Command_MUSIC(uint8_t link_id, const char* command) {
  int32_t res = snprintf(_cmd_prep_buffer, BT_CMDBUF_SIZE, BT_CMD_MUSIC, link_id, command);
  return _BT_QueueCommand(CMD_MUSIC, res);
}

HAL_StatusTypeDef BT_Command_NAME(uint64_t bt_addr) {
  int32_t res = snprintf(_cmd_prep_buffer, BT_CMDBUF_SIZE, BT_CMD_NAME, bt_addr);
  return _BT_QueueCommand(CMD_NAME, res);
}

HAL_StatusTypeDef BT_Command_OPEN(uint64_t bt_addr, const char* profile) {
  int32_t res = snprintf(_cmd_prep_buffer, BT_CMDBUF_SIZE, BT_CMD_OPEN, bt_addr, profile);
  return _BT_QueueCommand(CMD_OPEN, res);
}

HAL_StatusTypeDef BT_Command_OPEN_BCAST(uint64_t bt_addr, const char* profile, uint8_t adv_sid, uint32_t bcast_id, bool pa_sync) {
  int32_t res = snprintf(_cmd_prep_buffer, BT_CMDBUF_SIZE, BT_CMD_OPEN_LONG, bt_addr, profile, 2, adv_sid, bcast_id, pa_sync ? 1 : 0);
  return _BT_QueueCommand(CMD_OPEN_LONG, res);
}

//static HAL_StatusTypeDef BT_Command_RESET() {
//  int32_t res = snprintf(_cmd_prep_buffer, BT_CMDBUF_SIZE, BT_CMD_RESET);
//  return _BT_QueueCommand(CMD_RESET, res);
//}

HAL_StatusTypeDef BT_Command_RSSI(uint64_t bt_addr) {
  int32_t res = snprintf(_cmd_prep_buffer, BT_CMDBUF_SIZE, BT_CMD_RSSI, bt_addr);
  return _BT_QueueCommand(CMD_RSSI, res);
}

HAL_StatusTypeDef BT_Command_QUALITY(uint64_t bt_addr) {
  int32_t res = snprintf(_cmd_prep_buffer, BT_CMDBUF_SIZE, BT_CMD_QUALITY, bt_addr);
  return _BT_QueueCommand(CMD_QUALITY, res);
}

HAL_StatusTypeDef BT_Command_SCAN_BCAST(uint8_t timeout) {
  int32_t res = snprintf(_cmd_prep_buffer, BT_CMDBUF_SIZE, BT_CMD_SCAN_BCAST, timeout);
  return _BT_QueueCommand(CMD_SCAN_BCAST, res);
}

HAL_StatusTypeDef BT_Command_SEND(uint8_t link_id, const char* payload) {
  int32_t res = snprintf(_cmd_prep_buffer, BT_CMDBUF_SIZE, BT_CMD_SEND, link_id, payload);
  return _BT_QueueCommand(CMD_SEND, res);
}

static HAL_StatusTypeDef BT_Command_SET(const char* key, const char* value) {
  int32_t res = snprintf(_cmd_prep_buffer, BT_CMDBUF_SIZE, BT_CMD_SET, key, value);
  return _BT_QueueCommand(CMD_SET, res);
}

HAL_StatusTypeDef BT_Command_STATUS() {
  int32_t res = snprintf(_cmd_prep_buffer, BT_CMDBUF_SIZE, BT_CMD_STATUS);
  _status_a2dp_link_id = 0;
  _status_a2dp_bt_addr = 0;
  _status_a2dp_stream_active = false;
  _status_a2dp_codec[0] = '\0';
  _status_avrcp_link_id = 0;
  _status_avrcp_bt_addr = 0;
  _status_avrcp_playing = false;
  return _BT_QueueCommand(CMD_STATUS, res);
}

HAL_StatusTypeDef BT_Command_TONE(const char* tone_string) {
  int32_t res = snprintf(_cmd_prep_buffer, BT_CMDBUF_SIZE, BT_CMD_TONE, tone_string);
  return _BT_QueueCommand(CMD_TONE, res);
}

HAL_StatusTypeDef BT_Command_VOLUME(uint8_t link_id, uint8_t volume) {
  int32_t res = snprintf(_cmd_prep_buffer, BT_CMDBUF_SIZE, BT_CMD_VOLUME, link_id, volume);
  return _BT_QueueCommand(CMD_VOLUME, res);
}

HAL_StatusTypeDef BT_Command_VOLUME_GET() {
  int32_t res = snprintf(_cmd_prep_buffer, BT_CMDBUF_SIZE, BT_CMD_VOLUME_GET);
  return _BT_QueueCommand(CMD_VOLUME_GET, res);
}

static HAL_StatusTypeDef BT_Command_WRITE() {
  int32_t res = snprintf(_cmd_prep_buffer, BT_CMDBUF_SIZE, BT_CMD_WRITE);
  return _BT_QueueCommand(CMD_WRITE, res);
}


static void _BT_ErrorReset() {
  if (BT_Init() != HAL_OK) {
    //re-init fails completely: reset MCU
    HAL_NVIC_SystemReset();
  }
}

static void _BT_Command_Finish(BT_Error error) {
  _next_cmd_tick = HAL_GetTick() + BT_CMD_DELAY;

  if (error == BTERR_NONE) {
    //DEBUG_PRINTF("Command finished successfully\n");
    _current_command = CMD_NONE;
    return;
  }

  DEBUG_PRINTF("* BT reported error 0x%04X\n", (uint16_t)error);

  if (((uint16_t)error & 0xFFF0U) == 0xF000U) {
    //"critical error", reset
    _current_command = CMD_NONE;
    if (error == BTERR_WRONG_CONFIG) {
      //wrong config: force factory reset
      _init_force_factory_reset = true;
    }
    _BT_ErrorReset();
    //report critical errors to host
    UARTH_Notification_Event_Error((uint16_t)error, false);
    return;
  }

  if (_current_command == CMD_INIT || _current_command == CMD_CONFIG || _current_command == CMD_SET || _current_command == CMD_WRITE) {
    //error in init procedure: reset
    _current_command = CMD_NONE;
    _BT_ErrorReset();
    return;
  }

  if (_current_command == CMD_CONNECTABLE || _current_command == CMD_DISCOVERABLE || _current_command == CMD_MUSIC || _current_command == CMD_TONE || _current_command == CMD_VOLUME) {
    //error in host-triggered command: report error to host
    DEBUG_PRINTF("BT error queued to UART\n");
    UARTH_Notification_Event_Error((uint16_t)error, false);
  }

  _current_command = CMD_NONE;
}

static void _BT_Command_Timeout() {
  DEBUG_PRINTF("* Command timed out!\n");
  if (_current_command == CMD_INIT || _current_command == CMD_CONFIG || _current_command == CMD_SET || _current_command == CMD_WRITE) {
    //timeout in init procedure: reset
    _BT_ErrorReset();
  } else {
    _BT_Command_Finish(BTERR_COMMAND_TIMEOUT);
  }
}


/******************************************************************************************
 * NOTIFICATION PARSING FUNCTIONS
 ******************************************************************************************/

//check correctness of given config key-value pair - if incorrect, queue a correcting SET command, and mark the config as changed
static void _BT_CheckConfigItem(const char* key, const char* value) {
  //iterate through all config array entries to check whether the given key is in there
  int i;
  for (i = 0; i < BT_CONFIG_ARRAY_ENTRIES; i++) {
    const char* arr_key = _config_array[2 * i];
    char arr_value[128] = { 0 };

    //check given key against config entry key
    if (strcmp(key, arr_key) == 0) {
      //key matches config entry key: check value

      //populate value - for UI_CONFIG, insert firmware update setting; for all others, just copy
      if (strcmp(arr_key, "UI_CONFIG") == 0) {
        const char* enable_ota = bt_driver_state.ota_upgrade_enabled ? "ON" : "OFF";
        snprintf(arr_value, 128, _config_array[2 * i + 1], enable_ota, enable_ota);
      } else {
        strncpy(arr_value, _config_array[2 * i + 1], 127);
      }

      if (strcmp(value, arr_value) != 0) {
        //value doesn't match: queue command to correct it and mark the config as changed
        _init_config_changed = true;
        if (BT_Command_SET(arr_key, arr_value) != HAL_OK) {
          //failed to queue set command: reset
          _BT_ErrorReset();
        }
      }
      return;
    }
  }
}

static bool _BT_ProcessStatusUpdate() {
  if (_status_a2dp_link_id == 0) {
    //no A2DP link
    bt_driver_state.a2dp_link_id = 0;
    bt_driver_state.a2dp_stream_active = false;
    bt_driver_state.a2dp_codec[0] = '\0';
  } else {
    if (bt_driver_state.a2dp_link_id != _status_a2dp_link_id) {
      //different link ID
      if (bt_driver_state.a2dp_link_id == 0) {
        //no link saved: save found link
        bt_driver_state.a2dp_link_id = _status_a2dp_link_id;
      } else {
        //different link saved: error
        DEBUG_PRINTF("* Status update encountered wrong A2DP link ID %02X instead of %02X\n", _status_a2dp_link_id, bt_driver_state.a2dp_link_id);
        return false;
      }
    }
    if (bt_driver_state.connected_device_addr != _status_a2dp_bt_addr) {
      //different device address
      if (bt_driver_state.connected_device_addr == 0) {
        //no device address saved: save found address
        bt_driver_state.connected_device_addr = _status_a2dp_bt_addr;
        bt_driver_state.connected_device_name[0] = '\0';
      } else {
        //different device address saved: error
        DEBUG_PRINTF("* Status update encountered wrong A2DP link address %012llX instead of %012llX\n", _status_a2dp_bt_addr, bt_driver_state.connected_device_addr);
        return false;
      }
    }
    bt_driver_state.a2dp_stream_active = _status_a2dp_stream_active;
    strncpy(bt_driver_state.a2dp_codec, _status_a2dp_codec, BT_STATE_STR_LENGTH - 1);
    bt_driver_state.a2dp_codec[BT_STATE_STR_LENGTH - 1] = '\0';
  }

  if (_status_avrcp_link_id == 0) {
    //no AVRCP link
    bt_driver_state.avrcp_link_id = 0;
    bt_driver_state.avrcp_playing = false;
    bt_driver_state.avrcp_title[0] = '\0';
    bt_driver_state.avrcp_artist[0] = '\0';
    bt_driver_state.avrcp_album[0] = '\0';
  } else {
    if (bt_driver_state.avrcp_link_id != _status_avrcp_link_id) {
      //different link ID
      if (bt_driver_state.avrcp_link_id == 0) {
        //no link saved: save found link
        bt_driver_state.avrcp_link_id = _status_avrcp_link_id;
      } else {
        //different link saved: error
        DEBUG_PRINTF("* Status update encountered wrong AVRCP link ID %02X instead of %02X\n", _status_avrcp_link_id, bt_driver_state.avrcp_link_id);
        return false;
      }
    }
    if (bt_driver_state.connected_device_addr != _status_avrcp_bt_addr) {
      //different device address
      if (bt_driver_state.connected_device_addr == 0) {
        //no device address saved: save found address
        bt_driver_state.connected_device_addr = _status_avrcp_bt_addr;
        bt_driver_state.connected_device_name[0] = '\0';
      } else {
        //different device address saved: error
        DEBUG_PRINTF("* Status update encountered wrong AVRCP link address %012llX instead of %012llX\n", _status_avrcp_bt_addr, bt_driver_state.connected_device_addr);
        return false;
      }
    }
    bt_driver_state.avrcp_playing = _status_avrcp_playing;
  }

  if (bt_driver_state.a2dp_link_id == 0 && bt_driver_state.avrcp_link_id == 0) {
    //both links disconnected: device disconnected
    bt_driver_state.connected_device_addr = 0;
    bt_driver_state.connected_device_name[0] = '\0';
    bt_driver_state.connected_device_rssi = 0;
    bt_driver_state.connected_device_link_quality = 0;
    //notify host of change if requested
    UARTH_ForceCheckChangeNotification();
  }

  return true;
}


static bool _BT_Parse_OK() {
  if (strcmp(_parse_buffer, BT_NOTIF_OK) != 0) {
    return false;
  }
  if (_current_command == CMD_CONFIG) {
    if (_init_config_changed) {
      //config will be changed (set commands queued), so queue a write command at the end
      if (BT_Command_WRITE() != HAL_OK) {
        //failed to queue write command: reset
        _BT_ErrorReset();
        return true;
      }
    } else {
      //config is correct, so init is done
      bt_driver_state.init_complete = true;
      DEBUG_PRINTF("BT driver init completed successfully\n");
      //notify host of change if requested
      UARTH_ForceCheckChangeNotification();
    }
  } else if (_current_command == CMD_WRITE) {
    //config write succeeded, so reset to (hopefully) correct config
    _BT_ErrorReset();
    return true;
  } else if (_current_command == CMD_STATUS) {
    //status update complete: process it
    if (_BT_ProcessStatusUpdate()) {
      //all good: queue additional reads if we're connected
      if (bt_driver_state.connected_device_addr != 0) {
        if (bt_driver_state.connected_device_name[0] == '\0') {
          //request name if unknown
          BT_Command_NAME(bt_driver_state.connected_device_addr);
        }
        BT_Command_RSSI(bt_driver_state.connected_device_addr);
        BT_Command_QUALITY(bt_driver_state.connected_device_addr);
      }
      //notify host of change if requested
      UARTH_ForceCheckChangeNotification();
    } else {
      //invalid: queue close all
      if (BT_Command_CLOSE_ALL() != HAL_OK) {
        //reset if close command fails
        _BT_ErrorReset();
      }
    }
  }
  _BT_Command_Finish(BTERR_NONE);
  //DEBUG_PRINTF("OK response parsed\n");
  return true;
}

static bool _BT_Parse_CONFIG_Item() {
  if (sscanf(_parse_buffer, BT_NOTIF_CONFIG_ITEM, _parse_str_0, _parse_str_1) < 2) {
    return false;
  }
  _BT_CheckConfigItem(_parse_str_0, _parse_str_1);
  //DEBUG_PRINTF("Config item parsed: %s = %s\n", _parse_str_0, _parse_str_1);
  return true;
}

static bool _BT_Parse_NAME() {
  uint64_t bt_addr;
  if (sscanf(_parse_buffer, BT_NOTIF_NAME, &bt_addr, _parse_str_0) < 2) {
    return false;
  }
  if (bt_driver_state.connected_device_addr == bt_addr) {
    strncpy(bt_driver_state.connected_device_name, _parse_str_0, BT_STATE_STR_LENGTH - 1);
    bt_driver_state.connected_device_name[BT_STATE_STR_LENGTH - 1] = '\0';
    //notify host of change if requested
    UARTH_ForceCheckChangeNotification();
  } else {
    DEBUG_PRINTF("* NAME response for different address (%012llX) than connected (%012llX)\n", bt_addr, bt_driver_state.connected_device_addr);
  }
  _BT_Command_Finish(BTERR_NONE);
  //DEBUG_PRINTF("NAME response parsed\n");
  return true;
}

static bool _BT_Parse_RSSI() {
  int16_t rssi;
  if (sscanf(_parse_buffer, BT_NOTIF_RSSI, &rssi) < 1) {
    return false;
  }
  if (bt_driver_state.connected_device_addr != 0) {
    bt_driver_state.connected_device_rssi = rssi;
    //notify host of change if requested
    UARTH_ForceCheckChangeNotification();
  } else {
    DEBUG_PRINTF("* RSSI response outside of connected state\n");
  }
  //DEBUG_PRINTF("RSSI response parsed\n");
  return true;
}

static bool _BT_Parse_QUALITY() {
  uint16_t quality;
  if (sscanf(_parse_buffer, BT_NOTIF_QUALITY, &quality) < 1) {
    return false;
  }
  if (bt_driver_state.connected_device_addr != 0) {
    bt_driver_state.connected_device_link_quality = quality;
    //notify host of change if requested
    UARTH_ForceCheckChangeNotification();
  } else {
    DEBUG_PRINTF("* QUALITY response outside of connected state\n");
  }
  //DEBUG_PRINTF("QUALITY response parsed\n");
  return true;
}

static bool _BT_Parse_SCAN() {
  uint64_t bt_addr;
  uint32_t bcast_id;
  uint8_t adv_id;
  int16_t rssi;
  if (sscanf(_parse_buffer, BT_NOTIF_SCAN_BCAST, &bt_addr, &bcast_id, &adv_id, _parse_str_0, &rssi) == 5) {
    //TODO: process broadcast scan result
    DEBUG_PRINTF("SCAN broadcast response parsed\n");
    return true;
  } else if (strcmp(_parse_buffer, BT_NOTIF_SCAN_OK) == 0) {
    _BT_Command_Finish(BTERR_NONE);
    DEBUG_PRINTF("SCAN_OK response parsed\n");
    return true;
  }
  return false;
}

static bool _BT_Parse_STATE() {
  if (sscanf(_parse_buffer, BT_NOTIF_STATE, _parse_str_0, _parse_str_1, _parse_str_2, _parse_str_3) < 4) {
    return false;
  }

  bt_driver_state.connectable = (strcmp(_parse_str_0, "ON") == 0);
  bt_driver_state.discoverable = (strcmp(_parse_str_1, "ON") == 0);
  //notify host of change if requested
  UARTH_ForceCheckChangeNotification();

  //DEBUG_PRINTF("STATE response parsed\n");
  return true;
}

static bool _BT_Parse_LINK() {
  uint8_t link_id;
  uint64_t bt_addr;
  uint32_t sample_rate;
  uint32_t bcast_code;
  uint32_t bcast_pdel;
  uint8_t bcast_encr;
  uint8_t bcast_subgroup;
  uint8_t bcast_biss;

  if (sscanf(_parse_buffer, BT_NOTIF_LINK_A2DP, &link_id, &bt_addr, _parse_str_0, _parse_str_1, _parse_str_2, &sample_rate) == 6) {
    _status_a2dp_link_id = link_id;
    _status_a2dp_bt_addr = bt_addr;
    _status_a2dp_stream_active = (strcmp(_parse_str_0, "STREAMING") == 0);
    strncpy(_status_a2dp_codec, _parse_str_1, BT_STATE_STR_LENGTH - 1);
    _status_a2dp_codec[BT_STATE_STR_LENGTH - 1] = '\0';
    //DEBUG_PRINTF("LINK A2DP response parsed\n");
    return true;
  } else if (sscanf(_parse_buffer, BT_NOTIF_LINK_AVRCP, &link_id, &bt_addr, _parse_str_0) == 3) {
    _status_avrcp_link_id = link_id;
    _status_avrcp_bt_addr = bt_addr;
    _status_avrcp_playing = (strcmp(_parse_str_0, "PLAYING") == 0);
    //DEBUG_PRINTF("LINK AVRCP response parsed\n");
    return true;
  } else if (sscanf(_parse_buffer, BT_NOTIF_LINK_BRX1, &link_id, &bt_addr, &bcast_code, _parse_str_0, _parse_str_1, &bcast_pdel, &sample_rate, &bcast_encr, &bcast_subgroup) == 9) {
    //TODO: process data
    DEBUG_PRINTF("LINK BRX1 response parsed\n");
    return true;
  } else if (sscanf(_parse_buffer, BT_NOTIF_LINK_BTX1, &link_id, &bt_addr, _parse_str_0, &bcast_pdel, &sample_rate, &bcast_subgroup, &bcast_biss) == 7) {
    //TODO: process data
    DEBUG_PRINTF("LINK BTX1 response parsed\n");
    return true;
  }

  return false;
}

static bool _BT_Parse_VOLUME_READ() {
  uint8_t link_id;
  uint8_t volume;
  if (sscanf(_parse_buffer, BT_NOTIF_VOLUME_READ, &link_id, _parse_str_0, &volume) < 3) {
    return false;
  }
  //only care about A2DP volume
  if (strcmp(_parse_str_0, "A2DP") == 0) {
    if (bt_driver_state.a2dp_link_id != 0 && link_id == bt_driver_state.a2dp_link_id) {
      bt_driver_state.abs_volume = volume & 0x7F;
      //notify host of change if requested
      UARTH_ForceCheckChangeNotification();
    } else {
      DEBUG_PRINTF("VOLUME A2DP readback reported unknown link %02X!\n", link_id);
    }
  }
  //DEBUG_PRINTF("VOLUME readback response parsed\n");
  return true;
}

static bool _BT_Parse_Ready() {
  if (strcmp(_parse_buffer, BT_NOTIF_READY) != 0) {
    return false;
  }
  if (_current_command == CMD_INIT) {
    //module started up - read config next
    if (BT_Command_CONFIG() == HAL_OK) {
      //config command queued: finish init "command"
      _BT_Command_Finish(BTERR_NONE);
      //stop suppressing UART errors (if not already seen)
      _suppress_error_interrupt = false;
    } else {
      //failed to queue config command: reset
      _BT_ErrorReset();
    }
  }
  //DEBUG_PRINTF("Ready notification parsed\n");
  return true;
}

static bool _BT_Parse_ERROR() {
  uint16_t error_code;
  if (sscanf(_parse_buffer, BT_NOTIF_ERROR, &error_code) < 1) {
    return false;
  }
  _BT_Command_Finish((BT_Error)error_code);
  DEBUG_PRINTF("ERROR notification parsed: 0x%04X\n", error_code);
  return true;
}

static bool _BT_Parse_A2DP_Event() {
  uint8_t link_id;
  if (sscanf(_parse_buffer, BT_NOTIF_A2DP_STREAM_START, &link_id) == 1) {
    if (bt_driver_state.a2dp_link_id != 0 && link_id == bt_driver_state.a2dp_link_id) {
      bt_driver_state.a2dp_stream_active = true;
      //notify host of change if requested
      UARTH_ForceCheckChangeNotification();
    } else {
      DEBUG_PRINTF("A2DP_STREAM_START on unknown link %02X!\n", link_id);
    }
    //DEBUG_PRINTF("A2DP_STREAM_START notification parsed\n");
    return true;
  } else if (sscanf(_parse_buffer, BT_NOTIF_A2DP_STREAM_SUSPEND, &link_id) == 1) {
    if (bt_driver_state.a2dp_link_id != 0 && link_id == bt_driver_state.a2dp_link_id) {
      bt_driver_state.a2dp_stream_active = false;
      //notify host of change if requested
      UARTH_ForceCheckChangeNotification();
    } else {
      DEBUG_PRINTF("A2DP_STREAM_SUSPEND on unknown link %02X!\n", link_id);
    }
    //DEBUG_PRINTF("A2DP_STREAM_SUSPEND notification parsed\n");
    return true;
  }
  return false;
}

static bool _BT_Parse_ABS_VOL() {
  uint8_t link_id;
  uint8_t volume;
  if (sscanf(_parse_buffer, BT_NOTIF_ABS_VOL, &link_id, &volume) < 2) {
    return false;
  }
  if (bt_driver_state.avrcp_link_id != 0 && link_id == bt_driver_state.avrcp_link_id) {
    bt_driver_state.abs_volume = volume & 0x7F;
    //notify host of change if requested
    UARTH_ForceCheckChangeNotification();
  } else {
    DEBUG_PRINTF("ABS_VOL on unknown link %02X!\n", link_id);
  }
  //DEBUG_PRINTF("ABS_VOL notification parsed\n");
  return true;
}

static bool _BT_Parse_AVRCP_Command() {
  uint8_t link_id;
  if (sscanf(_parse_buffer, BT_NOTIF_AVRCP_BACKWARD, &link_id) == 1) {
    //TODO: process command
    //DEBUG_PRINTF("AVRCP_BACKWARD notification parsed\n");
    return true;
  } else if (sscanf(_parse_buffer, BT_NOTIF_AVRCP_FORWARD, &link_id) == 1) {
    //TODO: process command
    //DEBUG_PRINTF("AVRCP_FORWARD notification parsed\n");
    return true;
  } else if (sscanf(_parse_buffer, BT_NOTIF_AVRCP_PAUSE, &link_id) == 1) {
    if (bt_driver_state.avrcp_link_id != 0 && link_id == bt_driver_state.avrcp_link_id) {
      bt_driver_state.avrcp_playing = false;
      //notify host of change if requested
      UARTH_ForceCheckChangeNotification();
    } else {
      DEBUG_PRINTF("AVRCP_PAUSE on unknown link %02X!\n", link_id);
    }
    //DEBUG_PRINTF("AVRCP_PAUSE notification parsed\n");
    return true;
  } else if (sscanf(_parse_buffer, BT_NOTIF_AVRCP_PLAY, &link_id) == 1) {
    if (bt_driver_state.avrcp_link_id != 0 && link_id == bt_driver_state.avrcp_link_id) {
      bt_driver_state.avrcp_playing = true;
      //notify host of change if requested
      UARTH_ForceCheckChangeNotification();
    } else {
      DEBUG_PRINTF("AVRCP_PLAY on unknown link %02X!\n", link_id);
    }
    //DEBUG_PRINTF("AVRCP_PLAY notification parsed\n");
    return true;
  } else if (sscanf(_parse_buffer, BT_NOTIF_AVRCP_STOP, &link_id) == 1) {
    if (bt_driver_state.avrcp_link_id != 0 && link_id == bt_driver_state.avrcp_link_id) {
      bt_driver_state.avrcp_playing = false;
      //notify host of change if requested
      UARTH_ForceCheckChangeNotification();
    } else {
      DEBUG_PRINTF("AVRCP_STOP on unknown link %02X!\n", link_id);
    }
    //DEBUG_PRINTF("AVRCP_STOP notification parsed\n");
    return true;
  }
  return false;
}

static bool _BT_Parse_AVRCP_MediaInfo() {
  //uint8_t link_id;
  if (sscanf(_parse_buffer, BT_NOTIF_AVRCP_MEDIA_TITLE, _parse_str_0) == 1) {
    if (bt_driver_state.avrcp_link_id != 0) {
      strncpy(bt_driver_state.avrcp_title, _parse_str_0, BT_AVRCP_META_LENGTH - 1);
      bt_driver_state.avrcp_title[BT_AVRCP_META_LENGTH - 1] = '\0';
      //notify host of change if requested
      UARTH_ForceCheckChangeNotification();
    }
    //DEBUG_PRINTF("AVRCP_MEDIA title notification parsed\n");
    return true;
  } else if (sscanf(_parse_buffer, BT_NOTIF_AVRCP_MEDIA_ARTIST, _parse_str_0) == 1) {
    if (bt_driver_state.avrcp_link_id != 0) {
      strncpy(bt_driver_state.avrcp_artist, _parse_str_0, BT_AVRCP_META_LENGTH - 1);
      bt_driver_state.avrcp_artist[BT_AVRCP_META_LENGTH - 1] = '\0';
      //notify host of change if requested
      UARTH_ForceCheckChangeNotification();
    }
    //DEBUG_PRINTF("AVRCP_MEDIA artist notification parsed\n");
    return true;
  } else if (sscanf(_parse_buffer, BT_NOTIF_AVRCP_MEDIA_ALBUM, _parse_str_0) == 1) {
    if (bt_driver_state.avrcp_link_id != 0) {
      strncpy(bt_driver_state.avrcp_album, _parse_str_0, BT_AVRCP_META_LENGTH - 1);
      bt_driver_state.avrcp_album[BT_AVRCP_META_LENGTH - 1] = '\0';
      //notify host of change if requested
      UARTH_ForceCheckChangeNotification();
    }
    //DEBUG_PRINTF("AVRCP_MEDIA album notification parsed\n");
    return true;
  }
  return false;
}

static bool _BT_Parse_CLOSE_LOSS() {
  uint8_t link_id;
  bool loss;
  if (sscanf(_parse_buffer, BT_NOTIF_CLOSE_OK, &link_id, _parse_str_0) == 2) {
    loss = false;
    //DEBUG_PRINTF("CLOSE_OK notification parsed\n");
  } else if (sscanf(_parse_buffer, BT_NOTIF_LINK_LOSS, &link_id, _parse_str_0) == 2) {
    loss = true;
    //DEBUG_PRINTF("LINK_LOSS notification parsed\n");
  } else {
    return false;
  }
  (void)loss; //unused right now

  if (bt_driver_state.a2dp_link_id != 0 && link_id == bt_driver_state.a2dp_link_id) {
    bt_driver_state.a2dp_link_id = 0;
    bt_driver_state.a2dp_stream_active = false;
    bt_driver_state.a2dp_codec[0] = '\0';
    //notify host of change if requested
    UARTH_ForceCheckChangeNotification();
  } else if (bt_driver_state.avrcp_link_id != 0 && link_id == bt_driver_state.avrcp_link_id) {
    bt_driver_state.avrcp_link_id = 0;
    bt_driver_state.avrcp_playing = false;
    bt_driver_state.avrcp_title[0] = '\0';
    bt_driver_state.avrcp_artist[0] = '\0';
    bt_driver_state.avrcp_album[0] = '\0';
    //notify host of change if requested
    UARTH_ForceCheckChangeNotification();
  } else {
    DEBUG_PRINTF("* Unknown link ID %02X closed (%s)!\n", link_id, _parse_str_0);
  }

  if (bt_driver_state.a2dp_link_id == 0 && bt_driver_state.avrcp_link_id == 0) {
    //all links disconnected: connection closed
    bt_driver_state.connected_device_addr = 0;
    bt_driver_state.connected_device_name[0] = '\0';
    bt_driver_state.connected_device_rssi = 0;
    bt_driver_state.connected_device_link_quality = 0;
    //notify host of change if requested
    UARTH_ForceCheckChangeNotification();
  }

  return true;
}

static bool _BT_Parse_OPEN_OK() {
  uint8_t link_id;
  uint64_t bt_addr;
  if (sscanf(_parse_buffer, BT_NOTIF_OPEN_OK, &link_id, _parse_str_0, &bt_addr) < 3) {
    return false;
  }

  BT_Error err = BTERR_NONE;

  if (bt_addr != bt_driver_state.connected_device_addr) {
    if (bt_driver_state.connected_device_addr == 0) {
      //new connection
      bt_driver_state.connected_device_addr = bt_addr;
      BT_Command_NAME(bt_addr);
      BT_Command_RSSI(bt_addr);
      BT_Command_QUALITY(bt_addr);
      //notify host of change if requested
      UARTH_ForceCheckChangeNotification();
    } else {
      //already connected to other Bluetooth address: error, close all connections
      DEBUG_PRINTF("* Opened connection (%02X %s) with address %012llX, while already connected to %012llX!\n", link_id, _parse_str_0, bt_addr, bt_driver_state.connected_device_addr);
      BT_Command_CLOSE_ALL();
      if (_current_command == CMD_OPEN || _current_command == CMD_OPEN_LONG) {
        _BT_Command_Finish(BTERR_UNKNOWN);
      }
      return true;
    }
  }

  if (strcmp(_parse_str_0, "A2DP") == 0) {
    bt_driver_state.a2dp_link_id = link_id;
    bt_driver_state.a2dp_stream_active = false;
    bt_driver_state.a2dp_codec[0] = '\0';
    //query volume upon connecting
    BT_Command_VOLUME_GET();
    //notify host of change if requested
    UARTH_ForceCheckChangeNotification();
  } else if (strcmp(_parse_str_0, "AVRCP") == 0) {
    bt_driver_state.avrcp_link_id = link_id;
    bt_driver_state.avrcp_playing = false;
    bt_driver_state.avrcp_title[0] = '\0';
    bt_driver_state.avrcp_artist[0] = '\0';
    bt_driver_state.avrcp_album[0] = '\0';
    //query volume upon connecting
    BT_Command_VOLUME_GET();
    //notify host of change if requested
    UARTH_ForceCheckChangeNotification();
  }

  if (_current_command == CMD_OPEN || _current_command == CMD_OPEN_LONG) {
    _BT_Command_Finish(err);
  }
  //DEBUG_PRINTF("OPEN_OK notification parsed\n");
  return true;
}

static bool _BT_Parse_OPEN_ERROR() {
  uint64_t bt_addr;
  uint8_t reason;
  int scan_res = sscanf(_parse_buffer, BT_NOTIF_OPEN_ERROR, &bt_addr, _parse_str_0, &reason);
  if (scan_res == 3) {
    if (_current_command == CMD_OPEN || _current_command == CMD_OPEN_LONG) {
      _BT_Command_Finish((BT_Error)(0xFFF0U | reason));
    }
    //DEBUG_PRINTF("OPEN_ERROR with reason notification parsed\n");
    return true;
  } else if (scan_res == 2) {
    if (_current_command == CMD_OPEN || _current_command == CMD_OPEN_LONG) {
      _BT_Command_Finish(BTERR_UNKNOWN);
    }
    //DEBUG_PRINTF("OPEN_ERROR without reason notification parsed\n");
    return true;
  }
  return false;
}

//static bool _BT_Parse_PAIR_ERROR() {
//  uint64_t bt_addr;
//  if (sscanf(_parse_buffer, BT_NOTIF_PAIR_ERROR, &bt_addr) < 1) {
//    return false;
//  }
//  //TODO: process error
//  //DEBUG_PRINTF("PAIR_ERROR notification parsed\n");
//  return true;
//}
//
//static bool _BT_Parse_PAIR_OK() {
//  uint64_t bt_addr;
//  if (sscanf(_parse_buffer, BT_NOTIF_PAIR_OK, &bt_addr) < 1) {
//    return false;
//  }
//  //TODO: process pair
//  //DEBUG_PRINTF("PAIR_OK notification parsed\n");
//  return true;
//}
//
//static bool _BT_Parse_PAIR_PENDING() {
//  if (strcmp(_parse_buffer, BT_NOTIF_PAIR_PENDING) != 0) {
//    return false;
//  }
//  //TODO: process pending pair
//  //DEBUG_PRINTF("PAIR_PENDING notification parsed\n");
//  return true;
//}

static bool _BT_Parse_RECV() {
  uint8_t link_id;
  uint16_t size;
  if (sscanf(_parse_buffer, BT_NOTIF_RECV, &link_id, &size, _parse_str_0) < 3) {
    return false;
  }
  //TODO: process received data
  DEBUG_PRINTF("RECV notification parsed\n");
  return true;
}

static const bool (*_unprompted_parsers[])() = {
  &_BT_Parse_Ready,
  &_BT_Parse_ERROR,
  &_BT_Parse_A2DP_Event,
  &_BT_Parse_ABS_VOL,
  &_BT_Parse_AVRCP_Command,
  &_BT_Parse_AVRCP_MediaInfo,
  &_BT_Parse_CLOSE_LOSS,
  &_BT_Parse_OPEN_OK,
  &_BT_Parse_OPEN_ERROR,
//  &_BT_Parse_PAIR_ERROR,
//  &_BT_Parse_PAIR_OK,
//  &_BT_Parse_PAIR_PENDING,
  &_BT_Parse_RECV
};

static const int _unprompted_parser_count = 10;

//parse the notification in the parse buffer (must be completely received at this point)
static void _BT_ParseNotification() {
  //try to parse command responses if there's a corresponding active command
  if (_current_command != CMD_NONE) {
    if (_BT_Parse_OK()) return;
  }

  if (_current_command == CMD_CONFIG) {
    if (_BT_Parse_CONFIG_Item()) return;
  } else if (_current_command == CMD_NAME) {
    if (_BT_Parse_NAME()) return;
  } else if (_current_command == CMD_RSSI) {
    if (_BT_Parse_RSSI()) return;
  } else if (_current_command == CMD_QUALITY) {
    if (_BT_Parse_QUALITY()) return;
  } else if (_current_command == CMD_SCAN_BCAST) {
    if (_BT_Parse_SCAN()) return;
  } else if (_current_command == CMD_STATUS) {
    if (_BT_Parse_STATE()) return;
    if (_BT_Parse_LINK()) return;
  } else if (_current_command == CMD_VOLUME_GET) {
    if (_BT_Parse_VOLUME_READ()) return;
  }

  //try to parse notifications that may come up unprompted
  int i;
  for (i = 0; i < _unprompted_parser_count; i++) {
    if (_unprompted_parsers[i]()) return;
  }

  //DEBUG_PRINTF("Notification parse failed\n");
  //DEBUG_PRINTF("Notification parse failed: %s\n", _parse_buffer);
}


/******************************************************************************************
 * INTERRUPT CALLBACKS
 ******************************************************************************************/

void BT_UARTEx_RxEventCallback(UART_HandleTypeDef* huart, uint16_t Size) {
  //calculate next call's write offset in circular buffer
  _rx_buffer_write_offset += (uint32_t)Size;
  if (_rx_buffer_write_offset >= BT_RXBUF_SIZE) {
    _rx_buffer_write_offset = 0;
  }

  //start next reception immediately to avoid receiver overrun (data loss)
  //single transaction limited to remaining buffer space before wrap-around, because the HAL function has no "circular buffer" concept
  if (HAL_UARTEx_ReceiveToIdle_IT(&huart6, _rx_buffer + _rx_buffer_write_offset, BT_RXBUF_SIZE - _rx_buffer_write_offset) != HAL_OK) {
    DEBUG_PRINTF("*** NOTIFICATION RECEIVE ERROR\n");
    _interrupt_error = true;
  }
}

void BT_UART_TxCpltCallback(UART_HandleTypeDef* huart) {
  DEBUG_PRINTF("[CMD] %s\n", _cmd_tx_buffer);
}

void BT_UART_ErrorCallback(UART_HandleTypeDef* huart) {
  //ignore frame error at init
  if (_suppress_error_interrupt && HAL_UART_GetError(&huart6) == HAL_UART_ERROR_FE) {
    _suppress_error_interrupt = false;
    return;
  }
  DEBUG_PRINTF("*** UART6 internal error!\n");
  _interrupt_error = true;
}


/******************************************************************************************
 * MAIN DRIVER FUNCTIONS
 ******************************************************************************************/

//enables the OTA firmware upgrade functionality, until the next MCU reset
HAL_StatusTypeDef BT_EnableOTAUpgrade() {
  bt_driver_state.ota_upgrade_enabled = true;
  return BT_Init();
}

HAL_StatusTypeDef BT_Init() {
  bool factory_reset = _init_force_factory_reset;
  HAL_StatusTypeDef res = HAL_OK;

  _suppress_error_interrupt = true;

  //reset module physically
  HAL_GPIO_WritePin(BT_RST_N_GPIO_Port, BT_RST_N_Pin, GPIO_PIN_RESET);

  HAL_UART_Abort(&huart6);

  //reset all driver state
  _rx_buffer_write_offset = 0;
  _rx_buffer_read_offset = 0;
  _parse_buffer_write_offset = 0;
  _current_command = CMD_INIT;
  _next_cmd_tick = 0;
  _cmd_timeout_tick = HAL_MAX_DELAY;
  _init_config_changed = false;
  _init_force_factory_reset = false;
  _interrupt_error = false;

  _BT_ClearCommandQueue();

  bt_driver_state.init_complete = false;
  bt_driver_state.connectable = true;
  bt_driver_state.discoverable = false;
  bt_driver_state.connected_device_addr = 0;
  bt_driver_state.connected_device_name[0] = '\0';
  bt_driver_state.connected_device_rssi = 0;
  bt_driver_state.connected_device_link_quality = 0;
  bt_driver_state.a2dp_link_id = 0;
  bt_driver_state.a2dp_stream_active = false;
  bt_driver_state.a2dp_codec[0] = '\0';
  bt_driver_state.avrcp_link_id = 0;
  bt_driver_state.avrcp_playing = false;
  bt_driver_state.avrcp_title[0] = '\0';
  bt_driver_state.avrcp_artist[0] = '\0';
  bt_driver_state.avrcp_album[0] = '\0';
  bt_driver_state.abs_volume = 0;

  //take module out of reset after a small delay, or long delay for factory reset
  HAL_Delay(factory_reset ? 1900 : 1);
  //start reception of notifications
  if (HAL_UARTEx_ReceiveToIdle_IT(&huart6, _rx_buffer + _rx_buffer_write_offset, BT_RXBUF_SIZE - _rx_buffer_write_offset) != HAL_OK) {
    res = HAL_ERROR;
  }
  HAL_GPIO_WritePin(BT_RST_N_GPIO_Port, BT_RST_N_Pin, GPIO_PIN_SET);

  //report reset to host
  UARTH_Notification_Event_BTReset();

  //schedule init timeout
  _cmd_timeout_tick = HAL_GetTick() + BT_CMD_TIMEOUT;

  return res;
}

void BT_Update(uint32_t loop_counter) {
  uint32_t tick = HAL_GetTick();

  //handle interrupt errors
  if (_interrupt_error) {
    _BT_ErrorReset();
    return;
  }

  //handle received data
  while (_rx_buffer_read_offset != _rx_buffer_write_offset) {
    //read character from receive buffer, transfer to parse buffer, and increment offsets
    char rx_char = _rx_text[_rx_buffer_read_offset++];
    _parse_buffer[_parse_buffer_write_offset++] = rx_char;
    //handle circular receive buffer
    if (_rx_buffer_read_offset >= BT_RXBUF_SIZE) {
      _rx_buffer_read_offset = 0;
    }

    if (rx_char == '\r') {
      //received CR character: notification complete, so null-terminate parse buffer, reset write offset, and parse the notification
      _parse_buffer[_parse_buffer_write_offset] = '\0';
      _parse_buffer_write_offset = 0;

      DEBUG_PRINTF("[NOTIF] %s\n", _parse_buffer);

      _BT_ParseNotification();
    } else if (_parse_buffer_write_offset >= BT_PARSEBUF_SIZE - 1) {
      //parse buffer overflow: reset parse buffer
      DEBUG_PRINTF("*** ERROR: Notification parse buffer overflow\n");
      _parse_buffer_write_offset = 0;
    }
  }

  //check for command timeout
  if (_current_command != CMD_NONE && (int32_t)(tick - _cmd_timeout_tick) >= 0) {
    _BT_Command_Timeout();
  }

  //send next command if it's time for that
  if (_current_command == CMD_NONE && (int32_t)(tick - _next_cmd_tick) >= 0) {
    //conditions for next command are met: dequeue command, if there is one
    BT_CommandQueueItem* item = _BT_DequeueCommand();
    if (item == NULL) {
      //no command queued: update next command tick (to avoid eventual underflows), try again next time
      _next_cmd_tick = tick;
    } else {
      //command queued: sanity-check length first
      uint32_t length = item->cmd_length;
      if (length < BT_CMDBUF_SIZE) {
        //length okay: proceed, extract queue item values
        _current_command = item->command;
        memcpy(_cmd_tx_buffer, item->cmd_text, length);
        _cmd_tx_buffer[length + 1] = '\0';

        //start command
        if (HAL_UART_Transmit_IT(&huart6, (uint8_t*)_cmd_tx_buffer, length) == HAL_OK) {
          //send success: free queue item memory, schedule timeout
          free(item);
          _cmd_timeout_tick = tick + BT_CMD_TIMEOUT;
        } else {
          //error: reset to no command, update next command tick, requeue item to try again next time
          DEBUG_PRINTF("*** Command transmit error on command %s\n", _cmd_tx_buffer);
          if (item->retransmit_attempts >= BT_CMD_RETRANSMIT_ATTEMPTS) {
            //maximum retransmit attempts exceeded: reset
            _BT_ErrorReset();
            return;
          } else {
            //attempt retransmit
            _current_command = CMD_NONE;
            _next_cmd_tick = tick;
            item->retransmit_attempts++;
            _BT_RequeueCommand(item);
          }
        }
      }
    }
  }

  //queue status read commands if it's time for that and driver is initialised
  if (loop_counter % BT_STATUS_READ_PERIOD == 0 && bt_driver_state.init_complete) {
    BT_Command_STATUS();
  }
}
