BlockWorker/ModularAudio/firmware/BlockBoxController/Core/Inc/main.h

#define __D2_BSS __attribute__((section(".d2_bss")))
#define __D2_DATA __attribute__((section(".d2_data")))
#define __D3_BSS __attribute__((section(".d3_bss")))
#define __D3_DATA __attribute__((section(".d3_data")))
#define __DTCM_BSS __attribute__((section(".dtcm_bss")))
#define __DTCM_DATA __attribute__((section(".dtcm_data")))
#define __ITCM_DATA __attribute__((section(".itcm_data")))
#define B1_VOL_UP_Pin GPIO_PIN_2
#define B1_VOL_UP_GPIO_Port GPIOE
#define B1_VOL_DOWN_Pin GPIO_PIN_4
#define B1_VOL_DOWN_GPIO_Port GPIOE
#define B1_BACK_Pin GPIO_PIN_5
#define B1_BACK_GPIO_Port GPIOE
#define B1_PLAY_Pin GPIO_PIN_13
#define B1_PLAY_GPIO_Port GPIOC
#define B1_MFB_Pin GPIO_PIN_14
#define B1_MFB_GPIO_Port GPIOC
#define B1_FWD_Pin GPIO_PIN_15
#define B1_FWD_GPIO_Port GPIOC
#define LCD_GPIO3_Pin GPIO_PIN_4
#define LCD_GPIO3_GPIO_Port GPIOA
#define LCD_GPIO2_Pin GPIO_PIN_5
#define LCD_GPIO2_GPIO_Port GPIOA
#define LCD_INT_N_Pin GPIO_PIN_4
#define LCD_INT_N_GPIO_Port GPIOC
#define LCD_PD_N_Pin GPIO_PIN_5
#define LCD_PD_N_GPIO_Port GPIOC
#define LCD_B1_D3_Pin GPIO_PIN_7
#define LCD_B1_D3_GPIO_Port GPIOE
#define LCD_BL_DRIVE_Pin GPIO_PIN_8
#define LCD_BL_DRIVE_GPIO_Port GPIOE
#define B1_LCD_SWITCH_Pin GPIO_PIN_9
#define B1_LCD_SWITCH_GPIO_Port GPIOD
#define B1_LEDMODE_1_Pin GPIO_PIN_10
#define B1_LEDMODE_1_GPIO_Port GPIOD
#define B1_LEDMODE_2_Pin GPIO_PIN_11
#define B1_LEDMODE_2_GPIO_Port GPIOD
#define CHG_ACOK_Pin GPIO_PIN_8
#define CHG_ACOK_GPIO_Port GPIOC
#define AMP_CLIP_OTW_N_Pin GPIO_PIN_10
#define AMP_CLIP_OTW_N_GPIO_Port GPIOA
#define AMP_FAULT_N_Pin GPIO_PIN_11
#define AMP_FAULT_N_GPIO_Port GPIOA
#define AMP_RESET_N_Pin GPIO_PIN_12
#define AMP_RESET_N_GPIO_Port GPIOA
#define I2C5_INT0_N_Pin GPIO_PIN_12
#define I2C5_INT0_N_GPIO_Port GPIOC
#define I2C5_INT0_N_EXTI_IRQn EXTI15_10_IRQn
#define I2C5_INT1_N_Pin GPIO_PIN_0
#define I2C5_INT1_N_GPIO_Port GPIOD
#define I2C5_INT1_N_EXTI_IRQn EXTI0_IRQn
#define I2C5_INT2_N_Pin GPIO_PIN_1
#define I2C5_INT2_N_GPIO_Port GPIOD
#define I2C5_INT2_N_EXTI_IRQn EXTI1_IRQn
#define I2C5_INT3_N_Pin GPIO_PIN_2
#define I2C5_INT3_N_GPIO_Port GPIOD
#define I2C5_INT3_N_EXTI_IRQn EXTI2_IRQn
#define I2C5_INT4_N_Pin GPIO_PIN_3
#define I2C5_INT4_N_GPIO_Port GPIOD
#define I2C5_INT4_N_EXTI_IRQn EXTI3_IRQn
#define I2C1_INT0_N_Pin GPIO_PIN_5
#define I2C1_INT0_N_GPIO_Port GPIOB
