BlockWorker/ModularAudio/firmware/BatteryMonitor_Controller/Core/Src/main.c

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
/* Includes ------------------------------------------------------------------*/
#include "main.h"

/* USER CODE BEGIN Includes */
#include "retarget.h"
#include <stdio.h>
#include <string.h>
#include "bms.h"
#include "uart_host.h"
/* USER CODE END Includes */

CRC_HandleTypeDef hcrc;

I2C_HandleTypeDef hi2c3;

IWDG_HandleTypeDef hiwdg;

UART_HandleTypeDef huart1;
UART_HandleTypeDef huart2;

/* USER CODE BEGIN PV */
//power switch status and debouncing logic variables
static uint8_t pwrsw_debounce_count = 0;
static GPIO_PinState pwrsw_last_state = GPIO_PIN_SET;
bool pwrsw_status = false;

//whether the current main loop cycle follows stop mode
static bool wakeup_from_stop = false;
/* USER CODE END PV */

void SystemClock_Config(void);
static void MX_GPIO_Init(void);
static void MX_I2C3_Init(void);
static void MX_USART2_UART_Init(void);
static void MX_CRC_Init(void);
static void MX_IWDG_Init(void);
static void MX_USART1_UART_Init(void);
/* USER CODE BEGIN 0 */
static __always_inline void _RefreshWatchdogs() {
  //HAL_WWDG_Refresh(&hwwdg);
  HAL_IWDG_Refresh(&hiwdg);
}

static void _TestReadDataMem() {
  uint8_t data_mem_values[115] = { 0 };

  DEBUG_PRINTF("Reading contiguous data memory...\n");
  if (BMS_I2C_DataMemoryRead(MEMADDR_CAL_CELL1_GAIN, data_mem_values, 0x5E, 3) == HAL_OK) {
    DEBUG_PRINTF("Success: Contiguous memory read\n");
  } else {
    DEBUG_PRINTF("Contiguous data memory read failed!\n");
  }

  DEBUG_PRINTF("Reading extra data memory...\n");
  if (BMS_I2C_DataMemoryRead(MEMADDR_CAL_CELL4_DELTA, data_mem_values + 0x71, 2, 3) == HAL_OK) {
    DEBUG_PRINTF("Success: Extra memory read\n");
  } else {
    DEBUG_PRINTF("Extra data memory read failed!\n");
  }

  HAL_Delay(10);

  uint8_t configured_mem_values[115] __attribute__((aligned (2))) = { 0 };
  memcpy(configured_mem_values + 0x14, bms_config_main_array, sizeof(bms_config_main_array));
  *(uint16_t*)(configured_mem_values + 0x06) = BMS_CAL_CURR_GAIN;
  *(uint16_t*)(configured_mem_values + 0x0A) = BMS_CAL_CC1_GAIN;

  int i, j;
  DEBUG_PRINTF("\n     _0 _1 _2 _3 _4 _5 _6 _7 _8 _9 _A _B _C _D _E _F\n");
  for (i = 0; i < 8; i++) {
    int end = (i == 7) ? 3 : 16;

    DEBUG_PRINTF("\n r%X_", i);
    for (j = 0; j < end; j++) {
      DEBUG_PRINTF(" %02X", data_mem_values[16 * i + j]);
    }
    DEBUG_PRINTF("\n c%X_", i);
    for (j = 0; j < end; j++) {
      DEBUG_PRINTF(" %02X", configured_mem_values[16 * i + j]);
    }
    DEBUG_PRINTF("\n");
  }
}


GPIO_PinState GPIO_ReadOutputPin(GPIO_TypeDef *GPIOx, uint16_t GPIO_Pin)
{
  GPIO_PinState bitstatus;

  if ((GPIOx->ODR & GPIO_Pin) != (uint32_t)GPIO_PIN_RESET) {
    bitstatus = GPIO_PIN_SET;
  } else {
    bitstatus = GPIO_PIN_RESET;
  }
  return bitstatus;
}


void HAL_GPIO_EXTI_Callback(uint16_t GPIO_Pin) {
  switch (GPIO_Pin) {
    case BMS_ALERT_N_Pin:
      BMS_AlertInterrupt();
      break;
    case PWR_SWITCH_Pin:
      pwrsw_last_state = HAL_GPIO_ReadPin(PWR_SWITCH_GPIO_Port, PWR_SWITCH_Pin);
      pwrsw_debounce_count = MAIN_PWRSW_DEBOUNCE_CYCLES;
      break;
  }
}

void HAL_UART_TxCpltCallback(UART_HandleTypeDef* huart) {
  if (huart == &huart1) {
    UARTH_UART_TxCpltCallback(huart);
  } else if (huart == &huart2) {
    Retarget_UART_TxCpltCallback(huart);
  }
}
/* USER CODE END 0 */

/**
  * @brief  The application entry point.
  * @retval int
  */
int main(void)
{
  /* USER CODE BEGIN 1 */
  static uint32_t wu_count = 0;
  /* USER CODE END 1 */

  /* MCU Configuration--------------------------------------------------------*/

  /* Reset of all peripherals, Initializes the Flash interface and the Systick. */
  HAL_Init();

  /* Configure the system clock */
  SystemClock_Config();

  /* Initialize all configured peripherals */
  MX_GPIO_Init();
  MX_I2C3_Init();
  MX_USART2_UART_Init();
  MX_CRC_Init();
  MX_IWDG_Init();
  MX_USART1_UART_Init();
  /* USER CODE BEGIN 2 */
  RetargetInit(&huart2);

  //HAL_Delay(10);
  _RefreshWatchdogs();

  DEBUG_PRINTF("Controller started\n");

  //HAL_Delay(1000);

  pwrsw_debounce_count = 0;
  pwrsw_status = (HAL_GPIO_ReadPin(PWR_SWITCH_GPIO_Port, PWR_SWITCH_Pin) == GPIO_PIN_RESET);
  wakeup_from_stop = false;

  //configure for lowest power - not sure if compatible with stop mode, but won't hurt
  HAL_PWREx_EnableUltraLowPower();
  HAL_PWREx_EnableFastWakeUp();

  if (UARTH_Init() == HAL_OK) {
    DEBUG_PRINTF("Host UART init completed\n");
  } else {
    DEBUG_PRINTF("ERROR: Host UART init failed!\n");
    HAL_Delay(100);
    Error_Handler();
  }

  if (pwrsw_status) {
    //if starting powered on: enable isolator and allow one UART hardware error
    uarth_ignore_one_hardware_error = true;
    HAL_GPIO_WritePin(I2C_ISO_EN_GPIO_Port, I2C_ISO_EN_Pin, GPIO_PIN_SET);
  }
  //queue MCU reset notification (will only go through if powered on at startup)
  UARTH_Notification_Event_MCUReset();

  _RefreshWatchdogs();

  if (BMS_Init() == HAL_OK) {
    DEBUG_PRINTF("BMS init completed\n");
  } else {
    DEBUG_PRINTF("ERROR: BMS init failed!\n");
    HAL_Delay(100);
    Error_Handler();
  }

  //HAL_Delay(10);

  _TestReadDataMem();

  //HAL_Delay(10);

  _RefreshWatchdogs();
  /* USER CODE END 2 */

  /* Infinite loop */
  /* USER CODE BEGIN WHILE */
  //loop iteration counter - even if extremely unlikely wrap-around happens, it shouldn't be critical
  uint32_t loop_count = 0;
  while (1)
  {
    /* USER CODE END WHILE */

    /* USER CODE BEGIN 3 */
    uint32_t iteration_start_tick = HAL_GetTick();

    //check power switch: handle debouncing or see if it changed outside of debouncing somehow
    GPIO_PinState switch_state = HAL_GPIO_ReadPin(PWR_SWITCH_GPIO_Port, PWR_SWITCH_Pin);
    if (pwrsw_debounce_count > 0) {
      //if state changed: reset debounce counter
      if (switch_state != pwrsw_last_state) {
        pwrsw_last_state = switch_state;
        pwrsw_debounce_count = MAIN_PWRSW_DEBOUNCE_CYCLES;
      } else if (pwrsw_debounce_count-- == 1) { //same state as before: decrement counter and check if we're at the last cycle
        //last cycle: debounce is done, write switch status based on state
        pwrsw_status = (switch_state == GPIO_PIN_RESET);

        //if power turned off: reset timed shutdowns
        if (!pwrsw_status) {
          BMS_ResetTimedShutdownState();
        }
      }
    } else if (pwrsw_status != (switch_state == GPIO_PIN_RESET)) {
      //this shouldn't really ever happen
      DEBUG_PRINTF("WARNING: Power switch change detected that somehow wasn't caught by an interrupt\n");
      pwrsw_last_state = switch_state;
      pwrsw_debounce_count = MAIN_PWRSW_DEBOUNCE_CYCLES;
    }

    //apply power switch status to desired BMS state
    bms_should_deepsleep = !pwrsw_status;

    if (wakeup_from_stop) {
      //exit deepsleep after wakeup, to allow measurements
      BMS_ExitDeepSleep();
    }

    BMS_LoopUpdate(loop_count);

    bool deepsleep_desired = BMS_GetDeepSleepDesiredState();

    if (!deepsleep_desired) {
      //not in deepsleep desired mode: check if isolator enabled
      if (GPIO_ReadOutputPin(I2C_ISO_EN_GPIO_Port, I2C_ISO_EN_Pin) == GPIO_PIN_RESET) {
        //isolator disabled: reinitialise host UART interface, then enable isolator and allow one more UART error
        UARTH_Init();
        uarth_ignore_one_hardware_error = true;
        uarth_ignore_hardware_errors = false;
        HAL_GPIO_WritePin(I2C_ISO_EN_GPIO_Port, I2C_ISO_EN_Pin, GPIO_PIN_SET);
      }

      //perform UART host updates
      UARTH_Update(loop_count);
    } else if (GPIO_ReadOutputPin(I2C_ISO_EN_GPIO_Port, I2C_ISO_EN_Pin) == GPIO_PIN_SET) {
      //in deepsleep desired mode and isolator is enabled: abort any host UART transactions, then disable isolator and ignore UART errors
      HAL_UART_Abort(&huart1);
      uarth_ignore_hardware_errors = true;
      HAL_GPIO_WritePin(I2C_ISO_EN_GPIO_Port, I2C_ISO_EN_Pin, GPIO_PIN_RESET);
    }

    _RefreshWatchdogs();

    //check whether to stop or continue to next loop, stop conditions: BMS trying to deepsleep, no ongoing debounce, BMS in deepsleep, BMS alert pin is high (no alert)
    if (deepsleep_desired && pwrsw_debounce_count == 0 && bms_status.mode == BMSMODE_DEEPSLEEP && HAL_GPIO_ReadPin(BMS_ALERT_N_GPIO_Port, BMS_ALERT_N_Pin) == GPIO_PIN_SET) {
      //prepare everything for a check cycle after wakeup
      loop_count = 0;
      wakeup_from_stop = true;

      //enter stop mode
      __HAL_PWR_CLEAR_FLAG(PWR_FLAG_WU);
      HAL_PWR_EnterSTOPMode(PWR_LOWPOWERREGULATOR_ON, PWR_STOPENTRY_WFI);

      _RefreshWatchdogs();
      DEBUG_PRINTF("Woke up from STOP, loop before stop took %lu ms, count %lu\n", HAL_GetTick() - iteration_start_tick, wu_count++);
    } else {
      //just go to next loop after corresponding delay
      loop_count++;
      wakeup_from_stop = false;
      while((HAL_GetTick() - iteration_start_tick) < MAIN_LOOP_PERIOD_MS); //replaces HAL_Delay() to not wait any unnecessary extra ticks
    }
  }
  /* USER CODE END 3 */
}

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
