BlockWorker/ModularAudio/firmware/HiFiDAC_Controller/Core/Inc/dac_control.h

/*
 * dac_control.h
 *
 *  Created on: Sep 22, 2024
 *      Author: Alex
 */

#ifndef INC_DAC_CONTROL_H_
#define INC_DAC_CONTROL_H_

#include "main.h"

//expected value of chip ID register
#define DAC_EXPECTED_CHIP_ID 0x63

//base value for the sys mode config register - assuming sync = 0
#define DAC_SYS_MODE_CFG_BASE_VALUE 0xB1
//base value for the filter shape register - assuming filter shape = 0
#define DAC_FILTER_SHAPE_BASE_VALUE 0xB8
//base value for the IIRBW/SPDIFSEL register - assuming volume hold = 0
#define DAC_IIRBW_SPDIFSEL_BASE_VALUE 0x04
//base value for the automute enable register - assuming both automutes disabled
#define DAC_AUTOMUTE_EN_BASE_VALUE 0xFC
//base value for the automute time register - assuming mute ramp to ground = 0
#define DAC_AUTOMUTE_TIME_BASE_VALUE 0x000F

//period between manual register reads in main loop cycles
#define DAC_MANUAL_UPDATE_PERIOD 50

//calibrated volume offsets (reduction) in 0.5dB steps - prototype tests showed -1.5dB as an okay level with ~9.2Vpp
#define DAC_VOL_CAL_CH1 3
#define DAC_VOL_CAL_CH2 3
//initial volume setting (reduction) after reset/init in 0.5dB steps - here: set to -20dB
#define DAC_VOL_INIT_CH1 40
#define DAC_VOL_INIT_CH2 40


typedef struct {
  bool enabled; //whether the DAC is enabled overall

  bool sync; //whether synchronous mode is enabled (otherwise asynchronous mode)

  bool master; //whether master mode is enabled (otherwise slave mode)

  bool mute_gnd_ramp; //whether outputs ramp to ground when muted


  bool automute_ch1; //whether channels are automuted
  bool automute_ch2;

  bool full_ramp_ch1; //whether channels have completed their ramps
  bool full_ramp_ch2;

  bool monitor_error; //whether the BCK/WS monitor has detected any errors

  bool src_lock; //whether the async SRC is locked


  bool manual_mute_ch1; //whether channels are manually muted
  bool manual_mute_ch2;

  bool automute_enabled_ch1; //whether channels have automute enabled
  bool automute_enabled_ch2;

  bool en4xgain_ch1; //whether channels have 4x gain enabled
  bool en4xgain_ch2;

  bool invert_ch1; //whether channels are inverted
  bool invert_ch2;


  uint8_t volume_ch1; //channel volumes
  uint8_t volume_ch2;

  uint8_t clk_config; //DAC clock config

  uint8_t master_div; //master mode BCK divider
  uint8_t tdm_slot_num; //TDM slot number

  uint8_t tdm_slot_ch1; //channel TDM slots
  uint8_t tdm_slot_ch2;


  uint8_t filter_shape; //digital filter shape

  int16_t thd_c2_ch1; //THD correction coefficients
  int16_t thd_c2_ch2;
  int16_t thd_c3_ch1;
  int16_t thd_c3_ch2;
} DAC_Status;


extern DAC_Status dac_status;


//Check that the DAC chip ID is correct, confirming that the chip functions and can communicate
HAL_StatusTypeDef DAC_CheckChipID();

HAL_StatusTypeDef DAC_WriteSysConfig(bool enable);
HAL_StatusTypeDef DAC_WriteSysModeConfig(bool sync);
HAL_StatusTypeDef DAC_WriteDACClockConfig(uint8_t config);
HAL_StatusTypeDef DAC_WriteMasterClockConfig(uint8_t div);
HAL_StatusTypeDef DAC_Write4XGains(bool ch1gain, bool ch2gain);
HAL_StatusTypeDef DAC_WriteInputSelection(bool master);
HAL_StatusTypeDef DAC_WriteTDMSlotNum(uint8_t num);
HAL_StatusTypeDef DAC_WriteChannelTDMSlots(uint8_t ch1slot, uint8_t ch2slot);
HAL_StatusTypeDef DAC_WriteChannelVolumes(uint8_t ch1vol, uint8_t ch2vol);
HAL_StatusTypeDef DAC_WriteChannelMutes(bool ch1mute, bool ch2mute);
HAL_StatusTypeDef DAC_WriteChannelInverts(bool ch1invert, bool ch2invert);
HAL_StatusTypeDef DAC_WriteFilterShape(uint8_t shape);
HAL_StatusTypeDef DAC_WriteTHDC2(int16_t ch1c2, int16_t ch2c2);
HAL_StatusTypeDef DAC_WriteTHDC3(int16_t ch1c3, int16_t ch2c3);
HAL_StatusTypeDef DAC_WriteChannelAutomuteEnables(bool ch1automute, bool ch2automute);
HAL_StatusTypeDef DAC_WriteAutomuteTimeAndRamp(bool mute_gnd_ramp);

HAL_StatusTypeDef DAC_Init();
void DAC_LoopUpdate();


#endif /* INC_DAC_CONTROL_H_ */
