BlockWorker/ModularAudio/firmware/PowerAmpController/Core/Src/safety.c

/*
 * safety.c
 *
 *  Created on: Oct 11, 2024
 *      Author: Alex
 */

#include "safety.h"
#include <stdio.h>
#include <string.h>
#include "adc.h"
#include "pvdd_control.h"
#include "arm_math.h"
#include "i2c.h"


#define _SAFETY_CHECK_LIMITS(x,m,i) do { for (i = 0; i < 5; i++) { if (x[i] < 0.0f || x[i] > m[i]) return HAL_ERROR; } } while (0)


//safety thresholds for current, real power, and apparent power - shutdown if exceeded
//inst = single ADC batch (fast), 0s1 = 0.1s time constant EMA, 1s0 = 1.0s time constant EMA
//entries 0-3 are channel-wise (A-D, BTL mode uses A and C only), entry 4 is sum of all channels
float safety_max_current_inst[5] = SAFETY_LIMIT_MAX_CURRENT_INST;
float safety_max_current_0s1[5] = SAFETY_LIMIT_MAX_CURRENT_0S1;
float safety_max_current_1s0[5] = SAFETY_LIMIT_MAX_CURRENT_1S0;
float safety_max_real_power_inst[5] = SAFETY_LIMIT_MAX_REAL_POWER_INST;
float safety_max_real_power_0s1[5] = SAFETY_LIMIT_MAX_REAL_POWER_0S1;
float safety_max_real_power_1s0[5] = SAFETY_LIMIT_MAX_REAL_POWER_1S0;
float safety_max_apparent_power_inst[5] = SAFETY_LIMIT_MAX_APPARENT_POWER_INST;
float safety_max_apparent_power_0s1[5] = SAFETY_LIMIT_MAX_APPARENT_POWER_0S1;
float safety_max_apparent_power_1s0[5] = SAFETY_LIMIT_MAX_APPARENT_POWER_1S0;
//constant maximum limits for sanity checking and reset
const float safety_limit_current_inst[5] = SAFETY_LIMIT_MAX_CURRENT_INST;
const float safety_limit_current_0s1[5] = SAFETY_LIMIT_MAX_CURRENT_0S1;
const float safety_limit_current_1s0[5] = SAFETY_LIMIT_MAX_CURRENT_1S0;
const float safety_limit_real_power_inst[5] = SAFETY_LIMIT_MAX_REAL_POWER_INST;
const float safety_limit_real_power_0s1[5] = SAFETY_LIMIT_MAX_REAL_POWER_0S1;
const float safety_limit_real_power_1s0[5] = SAFETY_LIMIT_MAX_REAL_POWER_1S0;
const float safety_limit_apparent_power_inst[5] = SAFETY_LIMIT_MAX_APPARENT_POWER_INST;
const float safety_limit_apparent_power_0s1[5] = SAFETY_LIMIT_MAX_APPARENT_POWER_0S1;
const float safety_limit_apparent_power_1s0[5] = SAFETY_LIMIT_MAX_APPARENT_POWER_1S0;
//similar to above, but lower "warning" thresholds - notify I2C bus if exceeded
float safety_warn_current_inst[5] = SAFETY_NO_WARN;
float safety_warn_current_0s1[5] = SAFETY_NO_WARN;
float safety_warn_current_1s0[5] = SAFETY_NO_WARN;
float safety_warn_real_power_inst[5] = SAFETY_NO_WARN;
float safety_warn_real_power_0s1[5] = SAFETY_NO_WARN;
float safety_warn_real_power_1s0[5] = SAFETY_NO_WARN;
float safety_warn_apparent_power_inst[5] = SAFETY_NO_WARN;
float safety_warn_apparent_power_0s1[5] = SAFETY_NO_WARN;
float safety_warn_apparent_power_1s0[5] = SAFETY_NO_WARN;

//1 = amp shut down (by force or error condition), 0 = amp allowed to run
uint8_t is_shutdown = 1;
//safety shutdown set
uint8_t safety_shutdown = 1;
//manual shutdown set
uint8_t manual_shutdown = 1;
//error status
uint16_t safety_err_status = 0;
uint16_t safety_warn_status_inst = 0;
uint16_t safety_warn_status_loop = 0;

//helper arrays to translate from channel index (0 = A, ..., 3 = D) to corresponding status register bits (as defined in I2C defines)
static const uint16_t safety_channel_err_bits[] = { I2CDEF_POWERAMP_SERR_SOURCE_CHAN_A, I2CDEF_POWERAMP_SERR_SOURCE_CHAN_B, I2CDEF_POWERAMP_SERR_SOURCE_CHAN_C, I2CDEF_POWERAMP_SERR_SOURCE_CHAN_D };
static const uint16_t safety_channel_warn_bits[] = { I2CDEF_POWERAMP_SWARN_SOURCE_CHAN_A, I2CDEF_POWERAMP_SWARN_SOURCE_CHAN_B, I2CDEF_POWERAMP_SWARN_SOURCE_CHAN_C, I2CDEF_POWERAMP_SWARN_SOURCE_CHAN_D };


//perform sanity check that configured fast thresholds are within the valid ranges
HAL_StatusTypeDef _SAFETY_SanityCheckFastLimits() {
  int i;
  _SAFETY_CHECK_LIMITS(safety_max_current_inst, safety_limit_current_inst, i);
  _SAFETY_CHECK_LIMITS(safety_max_real_power_inst, safety_limit_real_power_inst, i);
  _SAFETY_CHECK_LIMITS(safety_max_apparent_power_inst, safety_limit_apparent_power_inst, i);
  return HAL_OK;
}

//perform sanity check that all configured thresholds are within the valid ranges
HAL_StatusTypeDef _SAFETY_SanityCheckLimits() {
  int i;
  ReturnOnError(_SAFETY_SanityCheckFastLimits());
  _SAFETY_CHECK_LIMITS(safety_max_current_0s1, safety_limit_current_0s1, i);
  _SAFETY_CHECK_LIMITS(safety_max_current_1s0, safety_limit_current_1s0, i);
  _SAFETY_CHECK_LIMITS(safety_max_real_power_0s1, safety_limit_real_power_0s1, i);
  _SAFETY_CHECK_LIMITS(safety_max_real_power_1s0, safety_limit_real_power_1s0, i);
  _SAFETY_CHECK_LIMITS(safety_max_apparent_power_0s1, safety_limit_apparent_power_0s1, i);
  _SAFETY_CHECK_LIMITS(safety_max_apparent_power_1s0, safety_limit_apparent_power_1s0, i);
  return HAL_OK;
}

//reset maximum thresholds to default maximum limits
void _SAFETY_ResetThresholds() {
  memcpy(safety_max_current_inst, safety_limit_current_inst, sizeof(safety_max_current_inst));
  memcpy(safety_max_current_0s1, safety_limit_current_0s1, sizeof(safety_max_current_0s1));
  memcpy(safety_max_current_1s0, safety_limit_current_1s0, sizeof(safety_max_current_1s0));
  memcpy(safety_max_real_power_inst, safety_limit_real_power_inst, sizeof(safety_max_real_power_inst));
  memcpy(safety_max_real_power_0s1, safety_limit_real_power_0s1, sizeof(safety_max_real_power_0s1));
  memcpy(safety_max_real_power_1s0, safety_limit_real_power_1s0, sizeof(safety_max_real_power_1s0));
  memcpy(safety_max_apparent_power_inst, safety_limit_apparent_power_inst, sizeof(safety_max_apparent_power_inst));
  memcpy(safety_max_apparent_power_0s1, safety_limit_apparent_power_0s1, sizeof(safety_max_apparent_power_0s1));
  memcpy(safety_max_apparent_power_1s0, safety_limit_apparent_power_1s0, sizeof(safety_max_apparent_power_1s0));
}

//instant safety shutdown of the amp
__always_inline void _SAFETY_TriggerSafetyShutdown() {
  safety_shutdown = 1;
  is_shutdown = 1;
  HAL_GPIO_WritePin(AMP_RESET_N_GPIO_Port, AMP_RESET_N_Pin, GPIO_PIN_RESET);
}

//perform threshold checks for main loop
void _SAFETY_DoLoopChecks() {
  float current_sum_0s1 = 0.0f, real_power_sum_0s1 = 0.0f, apparent_power_sum_0s1 = 0.0f, current_sum_1s0 = 0.0f, real_power_sum_1s0 = 0.0f, apparent_power_sum_1s0 = 0.0f;
  int i;

  //reset loop warnings
  safety_warn_status_loop = 0;

  //loop to get and check channel values
#ifdef MAIN_FOUR_CHANNEL
  for (i = 0; i < 4; i++) {
#else
  for (i = 0; i < 3; i += 2) {
#endif
    float current_0s1 = rms_current_0s1[i];
    float current_1s0 = rms_current_1s0[i];
    float real_power_0s1 = avg_real_power_0s1[i];
    float real_power_1s0 = avg_real_power_1s0[i];
    float apparent_power_0s1 = avg_apparent_power_0s1[i];
    float apparent_power_1s0 = avg_apparent_power_1s0[i];

    //check max
    _Bool imaxf = current_0s1 > safety_max_current_0s1[i];
    _Bool imaxl = current_1s0 > safety_max_current_1s0[i];
    _Bool pmaxf = real_power_0s1 > safety_max_real_power_0s1[i];
    _Bool pmaxl = real_power_1s0 > safety_max_real_power_1s0[i];
    _Bool amaxf = apparent_power_0s1 > safety_max_apparent_power_0s1[i];
    _Bool amaxl = apparent_power_1s0 > safety_max_apparent_power_1s0[i];
    if (imaxf || imaxl || pmaxf || pmaxl || amaxf || amaxl) {
      //DEBUG_PRINTF("ERROR: Safety loop - maximum exceeded, channel %d: %f A, %f W, %f VA\n", i, current_0s1, real_power_0s1, apparent_power_0s1);
      if (imaxf) {
        safety_err_status |= I2CDEF_POWERAMP_SERR_SOURCE_MTYPE_IRMS_FAST;
      }
      if (imaxl) {
        safety_err_status |= I2CDEF_POWERAMP_SERR_SOURCE_MTYPE_IRMS_SLOW;
      }
      if (pmaxf) {
        safety_err_status |= I2CDEF_POWERAMP_SERR_SOURCE_MTYPE_PAVG_FAST;
      }
      if (pmaxl) {
        safety_err_status |= I2CDEF_POWERAMP_SERR_SOURCE_MTYPE_PAVG_SLOW;
      }
      if (amaxf) {
        safety_err_status |= I2CDEF_POWERAMP_SERR_SOURCE_MTYPE_PAPP_FAST;
      }
      if (amaxl) {
        safety_err_status |= I2CDEF_POWERAMP_SERR_SOURCE_MTYPE_PAPP_SLOW;
      }
      safety_err_status |= safety_channel_err_bits[i];
      _SAFETY_TriggerSafetyShutdown();
      I2C_TriggerInterrupt(I2CDEF_POWERAMP_INT_FLAGS_INT_SERR_Msk);
      return;
    }

    //check warning
    _Bool iwarnf = current_0s1 > safety_warn_current_0s1[i];
    _Bool iwarnl = current_1s0 > safety_warn_current_1s0[i];
    _Bool pwarnf = real_power_0s1 > safety_warn_real_power_0s1[i];
    _Bool pwarnl = real_power_1s0 > safety_warn_real_power_1s0[i];
    _Bool awarnf = apparent_power_0s1 > safety_warn_apparent_power_0s1[i];
    _Bool awarnl = apparent_power_1s0 > safety_warn_apparent_power_1s0[i];
    if (iwarnf || iwarnl || pwarnf || pwarnl || awarnf || awarnl) {
      //DEBUG_PRINTF("WARNING: Safety loop - warn level exceeded, channel %d: %f A, %f W, %f VA\n", i, current_0s1, real_power_0s1, apparent_power_0s1);
      if (iwarnf) {
        safety_warn_status_loop |= I2CDEF_POWERAMP_SWARN_SOURCE_MTYPE_IRMS_FAST;
      }
      if (iwarnl) {
        safety_warn_status_loop |= I2CDEF_POWERAMP_SWARN_SOURCE_MTYPE_IRMS_SLOW;
      }
      if (pwarnf) {
        safety_warn_status_loop |= I2CDEF_POWERAMP_SWARN_SOURCE_MTYPE_PAVG_FAST;
      }
      if (pwarnl) {
        safety_warn_status_loop |= I2CDEF_POWERAMP_SWARN_SOURCE_MTYPE_PAVG_SLOW;
      }
      if (awarnf) {
        safety_warn_status_loop |= I2CDEF_POWERAMP_SWARN_SOURCE_MTYPE_PAPP_FAST;
      }
      if (awarnl) {
        safety_warn_status_loop |= I2CDEF_POWERAMP_SWARN_SOURCE_MTYPE_PAPP_SLOW;
      }
      safety_warn_status_loop |= safety_channel_warn_bits[i];
      I2C_TriggerInterrupt(I2CDEF_POWERAMP_INT_FLAGS_INT_SWARN_Msk);
    }

    current_sum_0s1 += current_0s1;
    current_sum_1s0 += current_1s0;
    real_power_sum_0s1 += real_power_0s1;
    real_power_sum_1s0 += real_power_1s0;
    apparent_power_sum_0s1 += apparent_power_0s1;
    apparent_power_sum_1s0 += apparent_power_1s0;
  }

  //check sum values (threshold index 4)
  //check max
  _Bool imaxfs = current_sum_0s1 > safety_max_current_0s1[4];
  _Bool imaxls = current_sum_1s0 > safety_max_current_1s0[4];
  _Bool pmaxfs = real_power_sum_0s1 > safety_max_real_power_0s1[4];
  _Bool pmaxls = real_power_sum_1s0 > safety_max_real_power_1s0[4];
  _Bool amaxfs = apparent_power_sum_0s1 > safety_max_apparent_power_0s1[4];
  _Bool amaxls = apparent_power_sum_1s0 > safety_max_apparent_power_1s0[4];
  if (imaxfs || imaxls || pmaxfs || pmaxls || amaxfs || amaxls) {
    //DEBUG_PRINTF("ERROR: Safety loop - maximum exceeded, channel sum: %f A, %f W, %f VA\n", current_sum_0s1, real_power_sum_0s1, apparent_power_sum_0s1);
    if (imaxfs) {
      safety_err_status |= I2CDEF_POWERAMP_SERR_SOURCE_MTYPE_IRMS_FAST;
    }
    if (imaxls) {
      safety_err_status |= I2CDEF_POWERAMP_SERR_SOURCE_MTYPE_IRMS_SLOW;
    }
    if (pmaxfs) {
      safety_err_status |= I2CDEF_POWERAMP_SERR_SOURCE_MTYPE_PAVG_FAST;
    }
    if (pmaxls) {
      safety_err_status |= I2CDEF_POWERAMP_SERR_SOURCE_MTYPE_PAVG_SLOW;
    }
    if (amaxfs) {
      safety_err_status |= I2CDEF_POWERAMP_SERR_SOURCE_MTYPE_PAPP_FAST;
    }
    if (amaxls) {
      safety_err_status |= I2CDEF_POWERAMP_SERR_SOURCE_MTYPE_PAPP_SLOW;
    }
    safety_err_status |= I2CDEF_POWERAMP_SERR_SOURCE_CHAN_SUM;
    _SAFETY_TriggerSafetyShutdown();
    I2C_TriggerInterrupt(I2CDEF_POWERAMP_INT_FLAGS_INT_SERR_Msk);
    return;
  }
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
