BlockWorker/ModularAudio/(commit log)

2024-07-11 Initial commit: CleanLVSupply first layout
    [5v.kicad_sch, CleanLVSupply.kicad_pcb, CleanLVSupply.kicad_sch, m15v.kicad_sch, p15v.kicad_sch]
2024-07-12 CleanLVSupply routing progress
    [5v.kicad_sch, CleanLVSupply.kicad_pcb, CleanLVSupply.kicad_sch, m15v.kicad_sch, p15v.kicad_sch]
2024-07-12 CleanLVSupply design done for now
    [CleanLVSupply-CuBottom.gbr, CleanLVSupply-CuIn1.gbr, CleanLVSupply-CuIn2.gbr, CleanLVSupply-CuTop.gbr, CleanLVSupply-EdgeCuts.gbr, CleanLVSupply-MaskBottom.gbr, CleanLVSupply-MaskTop.gbr, CleanLVSupply-NPTH.drl]
2024-07-12 Fix folder structure
    [5v.kicad_sch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]
2024-07-13 CleanLVSupply fixes, HiFiDAC skeleton
    [CleanLVSupply-CuBottom.gbr, CleanLVSupply-CuIn1.gbr, CleanLVSupply-CuIn2.gbr, CleanLVSupply-CuTop.gbr, CleanLVSupply-EdgeCuts.gbr, CleanLVSupply-MaskBottom.gbr, CleanLVSupply-MaskTop.gbr, CleanLVSupply-NPTH.drl]
2024-07-13 Include simulations, HiFiDAC partial design
    [3.3v.kicad_sch, HiFiDAC.kicad_sch, LM25576_AVG.OLB, LM25576_AVG.opj, LM25576_TRANS.OLB, LM25576_TRANS.OPJ, LM5123-Q1_AVG.OLB, LM5123-Q1_PSPICE_AVG.opj]
2024-07-14 HiFiDAC progress
    [3.3v.kicad_sch, HiFiDAC.kicad_sch, diff-amp.kicad_sch, i-v-stage.kicad_sch]
2024-07-14 HiFiDAC schematic initially done, CleanLVSupply added shield pads
    [3.3v.kicad_sch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]
2024-07-14 HiFiDAC renumbered and footprints assigned
    [3.3v.kicad_sch, HiFiDAC.kicad_sch, diff-amp.kicad_sch, i-v-stage.kicad_sch]
2024-07-14 HiFiDAC PCB progress, slight shape changes
    [CleanLVSupply-CuBottom.gbr, CleanLVSupply-CuIn1.gbr, CleanLVSupply-CuIn2.gbr, CleanLVSupply-CuTop.gbr, CleanLVSupply-EdgeCuts.gbr, CleanLVSupply-MaskBottom.gbr, CleanLVSupply-MaskTop.gbr, CleanLVSupply-NPTH.drl]
2024-07-15 HiFiDAC redesign of clocking, digital IO, ferrite beads
    [3.3v.kicad_sch, HiFiDAC.kicad_pcb, HiFiDAC.kicad_sch, diff-amp.kicad_sch, digital-io.kicad_sch, i-v-stage.kicad_sch]
2024-07-16 HiFiDAC initial layout complete
    [3.3v.kicad_sch, HiFiDAC.kicad_pcb, HiFiDAC.kicad_sch, digital-io.kicad_sch]
2024-07-16 HiFiDAC routing initially complete
    [HiFiDAC.kicad_pcb, HiFiDAC.kicad_sch, digital-io.kicad_sch]
2024-07-16 HiFiDAC PCB reference placement, text, and cleanup
    [HiFiDAC.kicad_pcb]
2024-07-17 HiFiDAC routing done, CleanLVSupply fuses added
    [5v.kicad_sch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]
2024-07-17 CleanLVSupply, HiFiDAC adjustments, first order version
    [CleanLVSupply-CuBottom.gbr, CleanLVSupply-CuIn1.gbr, CleanLVSupply-CuIn2.gbr, CleanLVSupply-CuTop.gbr, CleanLVSupply-EdgeCuts.gbr, CleanLVSupply-MaskBottom.gbr, CleanLVSupply-MaskTop.gbr, CleanLVSupply-NPTH.drl]
2024-07-23 PowerAmpSupply simulation, I2S nucleo firmware
    [LM5123-Q1_PSPICE_AVG.opj, LM5123-Q1_PSPICE_TRANS.opj, LM5123_Excel_Quickstart_Calculator_for_Boost_Controller_Design - testing.xlsx, LM5123_Excel_Quickstart_Calculator_for_Boost_Controller_Design.xlsx, PowerAmpSupply.kicad_pcb, PowerAmpSupply.kicad_sch]
2024-07-24 PowerAmpSupply schematic progress
    [LM5123-Q1_PSPICE_TRANS.opj, LM5123_Excel_Quickstart_Calculator_for_Boost_Controller_Design - testing.xlsx, LM5123_Excel_Quickstart_Calculator_for_Boost_Controller_Design.xlsx, PowerAmpSupply.kicad_pcb, PowerAmpSupply.kicad_sch]
2024-07-27 CleanLVSupply reduce -17V switch frequency
    [LM25576_AVG.opj, LM25576_TRANS.OPJ, PowerAmpSupply.kicad_pcb, PowerAmpSupply.kicad_sch, m15v.kicad_sch]
2024-07-28 CleanLVSupply build-based updates, v1.1
    [CleanLVSupply-CuBottom.gbr, CleanLVSupply-CuIn1.gbr, CleanLVSupply-CuIn2.gbr, CleanLVSupply-CuTop.gbr, CleanLVSupply-EdgeCuts.gbr, CleanLVSupply-MaskBottom.gbr, CleanLVSupply-MaskTop.gbr, CleanLVSupply-NPTH.drl]
2024-08-04 PowerAmplifier initial design mostly done
    [Class-D LC Filter Designer.xlsx, PowerAmplifier.kicad_pcb, PowerAmplifier.kicad_sch, controller.kicad_sch]
2024-08-07 PowerAmplifier initially complete, PowerAmpSupply progress
    [LM5123-Q1_PSPICE_TRANS.opj, LM5123_Excel_Quickstart_Calculator_for_Boost_Controller_Design-lowfreq.xlsx, LM5123_Excel_Quickstart_Calculator_for_Boost_Controller_Design.xlsx, PowerAmpSupply.kicad_pcb, PowerAmpSupply.kicad_sch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]
2024-08-07 PowerAmpSupply FET change and layout progress
    [LM5123-Q1_PSPICE_TRANS.opj, LM5123_Excel_Quickstart_Calculator_for_Boost_Controller_Design.xlsx, PowerAmpSupply.kicad_pcb, PowerAmpSupply.kicad_sch, PowerAmplifier.kicad_pcb]
2024-08-09 PowerAmpSupply almost done
    [LM5123-Q1_PSPICE_TRANS.opj, PowerAmpSupply.kicad_pcb, PowerAmpSupply.kicad_sch]
2024-08-12 PowerAmp+Supply additions
    [LM5123_Excel_Quickstart_Calculator_for_Boost_Controller_Design.xlsx, PowerAmp heatspreader v2.step, PowerAmpSupply heatspreader v5.step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]
2024-08-12 PowerAmpSupply final + ICL, PowerAmp final
    [PowerAmpSupply-CuBottom.gbr, PowerAmpSupply-CuIn1.gbr, PowerAmpSupply-CuIn2.gbr, PowerAmpSupply-CuTop.gbr, PowerAmpSupply-EdgeCuts.gbr, PowerAmpSupply-MaskBottom.gbr, PowerAmpSupply-MaskTop.gbr, PowerAmpSupply-NPTH.drl]
2024-08-12 Added BOMs
    [CleanLVSupply.csv, HiFiDAC.csv, PowerAmpSupply inv.csv, PowerAmplifier inv.csv, PowerAmplifier.csv]
2024-08-14 HiFiDAC minor fixes (v1.1)
    [HiFiDAC.kicad_pcb]
2024-08-17 Remove fixed 3d model refs
    [PowerAmpSupply.kicad_pcb, PowerAmplifier.kicad_pcb]
2024-08-27 HiFiDAC testing (v1 failed), PowerAmpSupply order
    [PowerAmpSupply inv.csv, PowerAmplifier inv.csv]
2024-08-29 HiFiDAC v2 start - output stage sim
2024-08-30 HiFiDAC v2 progress
    [3.3v.kicad_sch, HiFiDAC.kicad_sch, diff-amp.kicad_sch, i-v-stage.kicad_sch]
2024-09-10 HiFiDAC v2 layout+route progress
    [3.3v.kicad_sch, HiFiDAC.kicad_pcb, HiFiDAC.kicad_sch, i-v-stage.kicad_sch]
2024-09-13 HiFiDAC v2 ordered version
    [HiFiDAC inv.csv, HiFiDAC v1 inv.csv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]
2024-09-14 PowerAmp+Supply fan LDO change, Supply Rgate fix
    [PowerAmpSupply.kicad_pcb, PowerAmpSupply.kicad_sch, PowerAmplifier inv.csv, PowerAmplifier.csv, PowerAmplifier.kicad_pcb, PowerAmplifier.kicad_sch, inrush.kicad_sch]
2024-09-15 PowerAmpSupply coax test connectors
    [LM5123_Excel_Quickstart_Calculator_for_Boost_Controller_Design.xlsx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]
2024-09-15 Removed LM5155 (unused)
    [LM5155_56_Quickstart_Calculator_for_Boost_Converter_Design_V1_1_1.xlsx]
2024-09-15 PowerAmpSupply VTRK change
    [PowerAmpSupply.kicad_pcb, PowerAmpSupply.kicad_sch, PowerAmplifier inv.csv, PowerAmplifier.csv, PowerAmplifier.kicad_pcb, controller.kicad_sch]
2024-09-16 PowerAmplifier inventory check pre-order
    [PowerAmplifier inv.csv]
2024-09-17 PowerAmpSupply adjusted max VIN to 24V
    [LM5123-Q1_PSPICE_TRANS.opj, LM5123_Excel_Quickstart_Calculator_for_Boost_Controller_Design.xlsx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]
2024-09-29 BatteryMonitor initially done, BatteryCharger start
    [BatteryCharger.kicad_pcb, BatteryCharger.kicad_sch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]
2024-10-01 BatteryCharger schematic initially done
    [BatteryCharger.kicad_sch]
2024-10-03 BatteryCharger pcb progress
    [BatteryCharger.kicad_pcb, BatteryCharger.kicad_sch]
2024-10-03 BatteryMonitor added power switch connector
    [BatteryMonitor-CuBottom.gbr, BatteryMonitor-CuIn1.gbr, BatteryMonitor-CuIn2.gbr, BatteryMonitor-CuTop.gbr, BatteryMonitor-EdgeCuts.gbr, BatteryMonitor-MaskBottom.gbr, BatteryMonitor-MaskTop.gbr, BatteryMonitor-NPTH.drl]
2024-10-04 BatteryCharger board initially done
    [BatteryCharger-CuBottom.gbr, BatteryCharger-CuIn1.gbr, BatteryCharger-CuIn2.gbr, BatteryCharger-CuTop.gbr, BatteryCharger-EdgeCuts.gbr, BatteryCharger-MaskBottom.gbr, BatteryCharger-MaskTop.gbr, BatteryCharger-NPTH.drl]
2024-10-06 PowerAmplifier zobel resistor fix
    [PowerAmplifier.csv, PowerAmplifier.kicad_pcb, PowerAmplifier.kicad_sch]
2024-10-09 5x3 Baseplate designs
    [Baseplate 5x3 3mm.step, Baseplate 5x3 6mm flat.step, Baseplate 5x3 6mm light.step]
2024-10-09 PowerAmp firmware progress ADC testing
2024-10-09 BatteryMonitor and BatteryCharger inventory order
    [BatteryCharger inv.csv, BatteryCharger.kicad_sch, BatteryMonitor inv.csv]
2024-10-13 PowerAmplifier firmware progress
2024-10-18 PowerAmpController I2C progress
2024-10-18 PowerAmpController I2C initially done
2024-10-19 PowerAmpController I2C reinforcement and progress
    [PowerAmpController.ioc, i2c.c, i2c.h, i2c_defines_poweramp.h, main.c, pvdd_control.c, safety.c, safety.h]
2024-10-20 PowerAmpController enable watchdogs
2024-10-22 BasePower 12v simulations
    [GENERIC_BLOCKS.OLB, TPS552892-CALCULATION-TOOL-V1.0-orig.xlsx, TPS552892-CALCULATION-TOOL-V1.0.xlsx, TPS552892.OLB, TPS552892.opj]
2024-10-22 PowerAmpController implement init interrupt
2024-10-25 BasePower schematic mostly done
    [12v-buck-boost.kicad_sch, 3.3v-buck.kicad_sch, 5v-buck.kicad_sch, BasePower.kicad_pcb, BasePower.kicad_sch, TPS552892-CALCULATION-TOOL-V1.0.xlsx]
2024-10-27 BasePower layout mostly done
    [BasePower.kicad_pcb, BasePower.kicad_sch]
2024-10-27 BasePower design and inventory done
    [12v-buck-boost.kicad_sch, 3.3v-buck.kicad_sch, 5v-buck.kicad_sch, BasePower inv.csv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]
2024-10-27 PowerAmpController: Handle expected overvoltage
2024-10-27 PowerAmpController lower UART IRQ priority
2024-10-28 BatteryMonitor controller config
    [BatteryMonitor.kicad_pcb]
2024-10-29 BatteryMonitor v1.1: I2C swap, isolation
    [BatteryMonitor-CuBottom.gbr, BatteryMonitor-CuIn1.gbr, BatteryMonitor-CuIn2.gbr, BatteryMonitor-CuTop.gbr, BatteryMonitor-EdgeCuts.gbr, BatteryMonitor-MaskBottom.gbr, BatteryMonitor-MaskTop.gbr, BatteryMonitor-NPTH.drl]
2024-10-29 BatteryMonitor updated inventory
    [BatteryMonitor inv.csv, BatteryMonitor.csv]
2024-11-03 I2CMonitorApp start
2024-11-04 I2CMonitorApp and PowerAmpController testing
2024-11-08 Digital filter testing in Python
2024-12-12 HiFiDAC halved I-V gain
    [HiFiDAC.kicad_pcb, i-v-stage.kicad_sch]
2024-12-13 BasePower v1.1: Now with fuses
    [BasePower-CuBottom.gbr, BasePower-CuIn1.gbr, BasePower-CuIn2.gbr, BasePower-CuTop.gbr, BasePower-EdgeCuts.gbr, BasePower-MaskBottom.gbr, BasePower-MaskTop.gbr, BasePower-NPTH.drl]
2024-12-28 Created 12VLDO just in case
    [12VLDO-CuBottom.gbr, 12VLDO-CuTop.gbr, 12VLDO-EdgeCuts.gbr, 12VLDO-MaskBottom.gbr, 12VLDO-MaskTop.gbr, 12VLDO-NPTH.drl, 12VLDO-PTH.drl, 12VLDO-PasteBottom.gbr]
2024-12-28 BasePower v1.2 + inventory
    Added 12V clean LDO and improved power good display
    [12v-buck-boost.kicad_sch, 12v-clean-ldo.kicad_sch, 3.3v-buck.kicad_sch, 5v-buck.kicad_sch, BasePower 1.2 add inv.csv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]
2024-12-30 DigitalAudioProcessor schematic + start of PCB
    [DigitalAudioProcessor.kicad_pcb, DigitalAudioProcessor.kicad_sch]
2024-12-30 DigitalAudioProcessor PCB done
    [DigitalAudioProcessor-CuBottom.gbr, DigitalAudioProcessor-CuIn1.gbr, DigitalAudioProcessor-CuIn2.gbr, DigitalAudioProcessor-CuTop.gbr, DigitalAudioProcessor-EdgeCuts.gbr, DigitalAudioProcessor-MaskBottom.gbr, DigitalAudioProcessor-MaskTop.gbr, DigitalAudioProcessor-NPTH.drl]
2025-01-01 DigitalAudioProcessor net labels
    [DigitalAudioProcessor.kicad_pcb, DigitalAudioProcessor.kicad_sch]
2025-01-01 BluetoothReceiver schematic done
    [BluetoothReceiver.kicad_pcb, BluetoothReceiver.kicad_sch]
2025-01-01 BluetoothReceiver PCB mostly done
    [BluetoothReceiver.kicad_pcb, BluetoothReceiver.kicad_sch]
2025-01-02 BluetoothReceiver design done
    [BluetoothReceiver-CuBottom.gbr, BluetoothReceiver-CuIn1.gbr, BluetoothReceiver-CuIn2.gbr, BluetoothReceiver-CuTop.gbr, BluetoothReceiver-EdgeCuts.gbr, BluetoothReceiver-MaskBottom.gbr, BluetoothReceiver-MaskTop.gbr, BluetoothReceiver-NPTH.drl]
2025-01-03 BlockBoxController pin assignments
    [BlockBoxController.kicad_pcb, BlockBoxController.kicad_sch]
2025-01-03 BlockBoxController schematic done for now
    [BasePower 1.2 add inv.csv, BlockBoxController.kicad_pcb, BlockBoxController.kicad_sch]
2025-01-05 BlockBoxController design done
    [BlockBoxController-CuBottom.gbr, BlockBoxController-CuIn1.gbr, BlockBoxController-CuIn2.gbr, BlockBoxController-CuTop.gbr, BlockBoxController-EdgeCuts.gbr, BlockBoxController-MaskBottom.gbr, BlockBoxController-MaskTop.gbr, BlockBoxController-NPTH.drl]
2025-01-05 Inventory done and ordered
    [BasePower 1.2 add inv.csv, BatteryMonitor inv.csv, BlockBoxController inv.csv, BluetoothReceiver inv.csv, DigitalAudioProcessor inv.csv]
2025-01-07 PowerAmpSupply UVLO increase
    [PowerAmpSupply-CuBottom.gbr, PowerAmpSupply-CuIn1.gbr, PowerAmpSupply-CuIn2.gbr, PowerAmpSupply-CuTop.gbr, PowerAmpSupply-EdgeCuts.gbr, PowerAmpSupply-MaskBottom.gbr, PowerAmpSupply-MaskTop.gbr, PowerAmpSupply-NPTH.drl]
2025-01-07 Corner/side washer design for module mounting
    [Washers.stl]
2025-01-09 PowerAmpController safe PVDD reduction
2025-01-09 Backup info sheet
    [Modular Audio 2025-01-09.xlsx]
2025-01-15 BatteryEnclosure design
    [Cover.stl, Lid.stl, Shell.stl]
2025-01-15 BatteryMonitor firmware start
    [BatteryMonitor.kicad_pcb, BatteryMonitor.step]
2025-01-15 Moved I2CMonitor
2025-01-18 BatteryMonitor controller BMS comms established
    Tested to some extent
2025-01-18 BatteryMonitor doubled FET protection zener
    Single zener causes excessive leakage when off; opposite-polarity pair fixes that
    [BatteryMonitor-CuBottom.gbr, BatteryMonitor-CuIn1.gbr, BatteryMonitor-CuIn2.gbr, BatteryMonitor-CuTop.gbr, BatteryMonitor-EdgeCuts.gbr, BatteryMonitor-MaskBottom.gbr, BatteryMonitor-MaskTop.gbr, BatteryMonitor-NPTH.drl]
2025-01-24 BatteryMonitor Controller progress
2025-01-24 BatteryMonitor current calibration done
2025-01-25 Battery calculations/estimations
    [charge-0.2a.csv, charge-1.0a.csv, energy-0.2a.csv, energy-1.0a.csv]
2025-01-27 BatteryMonitor controller state-of-charge calculation
    Still needs testing
2025-01-29 BatteryMonitor Controller cell balancing implemented
2025-01-31 BatteryMonitor Controller small features
    Low-voltage powerdown, latching charge faults, fault recovery on powerdown, changed external I2C to UART (needs testing)
2025-01-31 BasePower adjusted LED resistors for equal brightness
    [12v-buck-boost.kicad_sch, 12v-clean-ldo.kicad_sch, 3.3v-buck.kicad_sch, 5v-buck.kicad_sch, BasePower.kicad_pcb, BasePower.kicad_sch]
2025-02-23 BlockBoxController minimal firmware
    [BlockBoxController.kicad_pcb]
2025-02-25 BlockBoxController display firmware start
    OSPI testing and framework, EVE driver in progress
2025-02-25 BlockBoxController display firmware driver done
2025-03-02 BluetoothReceiver firmware IOT777 defines
    [IOT777-3.1.21-default-config.txt, IOT777-3.1.21-required-config.txt]
2025-03-05 BluetoothReceiver firmware module driver basics
    Handles module configuration and printouts to debug now
    [IOT777-3.1.21-default-config.txt, IOT777-3.1.21-required-config.txt]
2025-03-06 BluetoothReceiver firmware renames
    More sensible prefix for Bluetooth module driver stuff
2025-03-08 BluetoothReceiver firmware progress
    Majority of IDC driver done (excluding broadcast stuff), started UART comm protocol definitions
    [IDC777-default-config.txt, IOT777-3.1.21-required-config.txt]
2025-03-09 BluetoothReceiver firmware done for now
    Added host communication driver and interoperability with BT driver
2025-03-13 BatteryMonitor firmware UART interface done
    Derived from BluetoothReceiver UART interface
    Also improved battery health (EEPROM now) and timed shutdown handling
2025-03-17 BatteryCharger testing + small fix
    U2 voltage source was incorrect
    [BatteryCharger-CuBottom.gbr, BatteryCharger-CuIn1.gbr, BatteryCharger-CuIn2.gbr, BatteryCharger-CuTop.gbr, BatteryCharger-EdgeCuts.gbr, BatteryCharger-MaskBottom.gbr, BatteryCharger-MaskTop.gbr, BatteryCharger-NPTH.drl]
2025-03-18 BatteryMonitor PC interface and fix
    For BatteryCharger testing, which is done now
    [uart_host.c]
2025-03-22 Minor firmware fixes, preparations for HiFiDAC I2C
    [HiFiDAC_Controller.ioc, dac_control.c, dac_control.h, dac_spi.h, i2c.c, i2c.h, i2c_defines_hifidac.h, i2c_defines_poweramp.h]
2025-03-24 More firmware fixes, HiFiDAC I2C progress
    [HiFiDAC_Controller.ioc, i2c.c, i2c.h, i2c_defines_hifidac.h, main.c, uart_defines_btrx.h]
2025-03-24 I2CMonitor updates
    Added BluetoothReceiver window
    Improved serial port stability (new library)
    Made I2C comms global between windows (because single bus)
2025-03-24 HiFiDAC firmware I2C progress
2025-03-25 HiFiDAC firmware I2C done + I2CMonitor integration
2025-03-30 DAP SRC filter design in MATLAB started
2025-03-31 DAP MATLAB filter design initially done
2025-03-31 DAP firmware fractional FIR implemented
    Reimplemented modified form of CMSIS-DSP FIR processing, optimised for this use case
2025-04-01 DAP firmware SRC progress
    Input sample processing done, barring errors
    [DigitalAudioProcessor.ioc, sample_rate_conv.c, sample_rate_conv.h]
2025-04-02 DAP firmware SRC minimum working implementation
    Still has some issues (USB transfer sync loss, crackling) but works in principle at 96k
    [fractional_fir.c, fractional_fir.h, main.c, sai_out.c, sample_rate_conv.c, sample_rate_conv.h]
2025-04-03 DAP firmware SRC+USB fixes
    Seems to work well now in general
    SRC still has stability issues ("wobbling" of frequency) which degrades audio
    [DigitalAudioProcessor.ioc, main.c, sample_rate_conv.c]
2025-04-04 DAP firmware SRC stabilised
    Now based on mean input rate (direct control) and buffer level (PI control)
    [DigitalAudioProcessor.ioc, main.c, main.h, retarget.c, sample_rate_conv.c, sample_rate_conv.h]
2025-04-05 DAP firmware signal processing start
    Also disabled IWDG because it was failing to initialise (???)
    [DigitalAudioProcessor.ioc, main.c, main.h, sai_out.c, sample_rate_conv.c, sample_rate_conv.h, signal_processing.c, signal_processing.h]
2025-04-05 DAP firmware enabled loop unrolling
    For both CMSIS-DSP (prebuilt) and extensions.
    More than doubled the available computation power for further signal processing.
2025-04-07 Updated BMS idle tracking
    Might have used it a bit in between, not very clean... need to get at least one more data point with no usage until then
2025-04-08 DAP firmware I2S inputs implemented
    Had some issues with byte misalignment after I2S stop and restart.
    Also fixed an SRC bug. IWDG causing issues again, so disabled.
    [DigitalAudioProcessor.ioc, NucleoF446ZE_Audio.ioc, inputs.c, inputs.h, main.c, main.h, sample_rate_conv.c]
2025-04-09 Firmwares updated to new STM32CubeIDE version
2025-04-09 DAP firmware updated to new STM32CubeIDE generation
    Upgrading to STM32Cube FW_H7 v1.12.1 doesn't seem to work yet - breaks SAI config?
    [DigitalAudioProcessor.ioc, inputs.c, main.c, main.h]
2025-04-09 DAP firmware I2C beginnings
2025-04-09 DAP I2C implemented + I2CMonitor counterpart
2025-04-10 DAP firmware support positive gains; I2C testing
2025-04-19 DAP firmware disabled excessive SPDIF printouts
2025-04-20 I2CMonitorApp RTC and EEPROM windows
    All seems to work fine in testing
    EEPROM write buffer 32B instead of 64B
2025-04-24 DAP firmware I2C CRC checks implemented
    Also implemented into I2CMonitorApp, should help communication robustness
2025-04-24 PowerAmpController I2C CRC implemented
    Same for corresponding I2CMonitorApp part
    Consider not immediately disconnecting I2CMonitorApp upon error?
    [i2c.c, i2c.h, i2c_defines_poweramp.h]
2025-04-25 I2CMonitorApp added tolerance for some comm errors
    No longer disconnects instantly on the first error
2025-04-25 HiFiDAC_Controller I2C CRC implemented
    Also in I2CMonitorApp accordingly
2025-04-26 BatteryCharger v1.2: Increased input voltage range
    Now 17.5V min instead of 19.5V min, to avoid power cycling at startup due to inrush
    [BatteryCharger-CuBottom.gbr, BatteryCharger-CuIn1.gbr, BatteryCharger-CuIn2.gbr, BatteryCharger-CuTop.gbr, BatteryCharger-EdgeCuts.gbr, BatteryCharger-MaskBottom.gbr, BatteryCharger-MaskTop.gbr, BatteryCharger-NPTH.drl]
2025-05-04 BMS idle tracking complete
    Discharge rate seems to be <0.5% per month, which is very low even for pure cell self-discharge
2025-05-04 DAP firmware MPU: set peripherals as device memory
    Should have really been done all along - surprised it even worked correctly in the previous state
    [DigitalAudioProcessor.ioc, main.c]
2025-05-09 BlockBoxController module IF abstraction, synchronous I2C
    Some testing done, up next is asynchronous I2C
2025-05-11 BlockBoxController async I2C implemented
    Tested only with CRC so far, also missing interrupt pin handling
    [BlockBoxController.ioc, cpp_main.cpp, cpp_main.h, main.c, main.h, module_interface.h, module_interface_common.cpp, module_interface_i2c.cpp]
2025-05-13 BatteryMonitor and BluetoothReceiver UART CRC implemented
    Also applied to corresponding I2CMonitorApp logic
2025-05-16 BlockBoxController UART module interface implemented
    Not tested yet
2025-05-17 BlockBoxController UART module interface tested
    Basics seem to work alright
2025-07-06 BlockBoxController register-based UART interface
2025-07-06 BlockBoxController register-based I2C interface
2025-07-09 BlockBoxController callback refactoring
    Switched to std::function instead of function pointers
2025-07-11 BlockBoxController BluetoothReceiver interface basic testing and fixes
    [bluetooth_receiver_interface.cpp, module_interface.cpp, module_interface.h, module_interface_uart.cpp, system.h, system_bbv2.cpp]
2025-07-11 BlockBoxController interrupt-enabled I2C module interface
2025-07-13 BlockBoxController ModuleInterface added 16-bit register address support
    In particular, for the (non-register-enabled) I2C interface; will be necessary for I2C EEPROM access
2025-07-15 PowerAmpController firmware safety improvement
    Small change to the initialisation code, so that the DAC output is initialised faster, resulting in a shorter dead-time and therefore a shorter/smaller PVDD transient
    [main.c]
2025-07-15 BlockBoxController PowerAmp interface implemented
    Including basic testing and first actual sound test
2025-07-18 UI design progress - main screen basics
    Missing touch areas
    [bt_config.h]
2025-07-19 BlockBoxController GUI refactoring and groundwork
    Standardised class/type naming, implemented and tested basics for the global top status bar
2025-07-20 PowerAmpController raised I2C interrupt priority
    Higher priority than ADC interrupts now.
    While this goes against the importance order (ADC is most important for safety), the I2C interrupts are always fast to handle (shouldn't affect safety calculation speed much), and this avoids locking up the I2C bus for extended periods of time.
    [PowerAmpController.ioc, i2c.h]
2025-07-22 BlockBoxController improved touch calibration
    Now in its own screen, asynchronous, with a post-calibration test.
    Integrated into initialisation procedure and EEPROM.
    Basic testing successful, also verifying basic EEPROM interface functionality.
2025-07-23 BlockBoxController AudioPathManager implementation started
    Basic functions done, missing init, Bluetooth updates, power state handling, and event handling - and of course testing
    [audio_path_manager.cpp, audio_path_manager.h, bbv2_gui_manager.cpp, bbv2_gui_manager.h, gui_manager.cpp, system_bbv2.cpp]
2025-07-24 BlockBoxController AudioPathManager progress
    Init, event + power state handling, and Bluetooth updates done. Still untested.
2025-07-26 BlockBoxController PowerOffScreen and other GUI improvements
    - Includes auto-calibration after timeout
    - Integrated top bar with AudioPathManager
    - Text width calculations and shortening helper
    - MainScreen stub, icon draws implemented
    [EVE_commands.cpp, EVE_commands.h, bbv2_gui_manager.cpp, bbv2_gui_manager.h, bbv2_screen.cpp, bbv2_screen.h, gui_common_draws.cpp, gui_common_draws.h]
2025-07-26 BlockBoxController AudioPathManager input check improvement
    GetActiveInput should be fast and const - check for input correctness periodically in loop instead
    [audio_path_manager.cpp, audio_path_manager.h]
2025-07-26 DigitalAudioProcessor fixed USB disconnect detection
    Pull-down on the USB_VBUS line is required to consistently detect disconnection.
    Firmware adjusted to not flush buffer on disconnect, as that causes a long freeze - seems to work fine without it too.
    [DigitalAudioProcessor-CuBottom.gbr, DigitalAudioProcessor-CuIn1.gbr, DigitalAudioProcessor-CuIn2.gbr, DigitalAudioProcessor-CuTop.gbr, DigitalAudioProcessor-EdgeCuts.gbr, DigitalAudioProcessor-MaskBottom.gbr, DigitalAudioProcessor-MaskTop.gbr, DigitalAudioProcessor-NPTH.drl]
2025-07-26 BlockBoxController HiFiDAC interface fix
    Lesson learned: Unnamed bits in bit fields may have any state - make sure to mask them out when using the value.
    [hifidac_interface.cpp]
2025-07-26 BlockBoxController GUI major performance improvements
    - No longer spin-waiting after display command writes, now handled better in GUIManager instead
    - Screen updates only written when necessary now
    - Minor changes to PowerOffScreen
    [EVE_commands.cpp, cpp_main.cpp, gui_common_draws.cpp, gui_manager.cpp, gui_manager.h, gui_screen.cpp, gui_screen.h, power_off_screen.cpp]
2025-07-26 BlockBoxController Bluetooth volume improvements
    AudioPathManager should no longer send unnecessary Bluetooth volume updates to the device
    [audio_path_manager.cpp]
2025-07-27 BlockBoxController GUIScreen removed display_timeout
    No longer necessary after the recent performance improvement
    [bbv2_screen.cpp, bbv2_screen.h, gui_screen.cpp, gui_screen.h, init_screen.cpp, main_screen.cpp, power_off_screen.cpp, test_screen.cpp]
2025-07-27 BlockBoxController AudioPathManager behaviour fixes
    Prevent wrong/unnecessary Bluetooth volume writes on power-off, fix mute synchronisation with Bluetooth device, and make sure Bluetooth volume is read upon a new connection
    [audio_path_manager.cpp, audio_path_manager.h]
2025-07-27 BlockBoxController MainScreen implemented
    As well as small debug and UI improvements; Long-press and tick durations shortened
    [EVE_commands.cpp, bbv2_screen.cpp, gui_manager.h, main_screen.cpp, main_screen.h, module_interface_i2c.cpp, power_off_screen.cpp, system_bbv2.cpp]
2025-07-30 USBPanel schematic
    Module/PCB for USB Type-C I/O (charging and data)
    [USBPanel.kicad_pcb, USBPanel.kicad_sch]
2025-07-31 USBPanel layout
    [USBPanel.kicad_pcb, USBPanel.kicad_sch]
2025-08-01 USBPanel PCB complete
    [USBPanel-CuBottom.gbr, USBPanel-CuIn1.gbr, USBPanel-CuIn2.gbr, USBPanel-CuIn3.gbr, USBPanel-CuIn4.gbr, USBPanel-CuTop.gbr, USBPanel-EdgeCuts.gbr, USBPanel-MaskBottom.gbr]
2025-08-03 USBPanel and I/O panel stuff ordered
    Includes small changes and fixes for the USBPanel PCB, the main panel design itself, and various small parts for it
    [AntennaMount.stl, Panel.step, PanelDBlank.step, PanelLaserMarking.dxf, PanelSmallBlank.step, ToslinkBlank.step, USBPanel inv.csv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]
2025-08-06 EQ design: Added 20Hz highpass on woofer
    Designed to avoid excessive subsonic power that may damage the driver.
2025-08-08 PowerAmpController firmware improvements
    - Significantly increased maximum fast and instantaneous safety limits, since we may want those to be higher for powerful drivers
    - Fixed I2C interrupt priorities
    - Implemented clipping and OTW detection to differentiate between event types on the CLIP_OTW pin (based on timing)
    [PowerAmpController.ioc, i2c.c, i2c_defines_poweramp.h, main.c, main.h, power_amp_interface.cpp, power_amp_interface.h, safety.h]
2025-08-09 BlockBoxController implemented mixer+EQ+calibration modes
    Also reworked parts of the DAP interface for better interaction
    [audio_path_manager.cpp, audio_path_manager.h, dap_interface.cpp, dap_interface.h, eeprom_interface.h]
2025-08-09 BlockBoxController GUI touch tracker smoothing
    Should hopefully prevent most glitches/jumps on sliders
    [bbv2_gui_manager.cpp, gui_manager.cpp, gui_manager.h, settings_screen_audio.cpp]
2025-08-10 PowerAmpController display settings screen implemented
    Includes RTC settings
2025-08-11 BlockBoxController AudioPathManager Bluetooth update fix
    Also send volume updates to Bluetooth device on min/max volume limit change.
    [audio_path_manager.cpp]
2025-08-12 BlockBoxController ModuleInterface robustness fix
    Had some issues with completed_transfers being modified while being iterated through in LoopTasks - now copies and clears the vector first, then iterates through the copy.
    [module_interface.cpp]
2025-08-12 BlockBoxController implemented graceful handling of spurious module resets
    Attempts to return to the last known state for the corresponding manager.
    [amp_manager.cpp, amp_manager.h, audio_path_manager.cpp, audio_path_manager.h, bluetooth_receiver_interface.cpp, dap_interface.cpp, hifidac_interface.cpp, power_amp_interface.cpp]
2025-08-12 Changed module reset signalling method over I2C
    Before: interrupt with returned register value 0, now: interrupt with reset-specific flag set; more robust this way.
    Also improved robustness of BlockBoxController I2C interface blocking transfer functions.
    [dap_interface.cpp, hifidac_interface.cpp, i2c.c, i2c_defines_dap.h, i2c_defines_hifidac.h, i2c_defines_poweramp.h, module_interface.h, module_interface_i2c.cpp]
2025-08-12 BlockBoxController AmpManager fixed warning factor setting
    Now shuts down the amplifier for warning limit application.
    [amp_manager.cpp]
2025-08-13 BlockBoxController removed default-capture from lambdas
    For robustness (avoid inadvertently reference-capturing something we don't want)
    [amp_manager.cpp, audio_path_manager.cpp, bbv2_screen.cpp, bluetooth_receiver_interface.cpp, dap_interface.cpp, eeprom_interface.cpp, hifidac_interface.cpp, main_screen.cpp]
2025-08-13 DigitalAudioProcessor increased I2C interrupt priorty
    Reduces communication errors. Doesn't seem to affect DAP operation negatively, but may need to monitor this further.
    [DigitalAudioProcessor.ioc]
2025-08-15 BlockBoxController ECC partially implemented
    TODO: write-back on single error events
    [cpp_main.cpp, main.c, main.h]
2025-08-15 PowerAmpSupply EMI measurement
    Attempted some mitigation, with limited success
2025-08-19 PowerAmp instability investigation, controller died
    PowerAmpSupply was likely at fault, removed diode D1, seems to have fixed it.
    PowerAmp controller died, so removed references to it in BlockBoxController for now (until replaced).
    [LM5123_Excel_Quickstart_Calculator_for_Boost_Controller_Design.xlsx]
2025-08-19 PowerAmplifier tentative PFFB simulations
    Probably imprecise model, but still useful for informative purposes.
2025-08-21 USBPanel small footprint fix
    [USBPanel.kicad_pcb]
2025-08-21 I2CMonitorApp implemented USBPanel interaction
    Monitoring of TPS25751 status and tool for EEPROM flashing
2025-08-23 USBPanel configuration and post-build edits
    Changed LED colour assignments and resistor values.
    [USBPanel-CuBottom.gbr, USBPanel-CuIn1.gbr, USBPanel-CuIn2.gbr, USBPanel-CuIn3.gbr, USBPanel-CuIn4.gbr, USBPanel-CuTop.gbr, USBPanel-EdgeCuts.gbr, USBPanel-MaskBottom.gbr]
2025-08-25 BlockBoxController implemented battery interface
    Including a few small testing-based changes.
2025-08-26 UART interface receive status monitoring
    Fixed a problem where UART interfaces may randomly stop receiving messages - now automatically restart reception
    [battery_interface.cpp, module_interface_uart.cpp, uart_host.c]
2025-08-26 PowerAmpSupply slower inrush simulation
    Should work with just a new R25 value, but may need testing if it maintains correct boost converter turn-on behaviour.
2025-08-27 PowerAmpSupply additional startup simulations
    Trying to see whether soft-start would prevent inrush-limit issues, results inconclusive
    [LM5123-Q1_PSPICE_TRANS.opj]
2025-08-27 BlockBoxController charger interface implemented
    Detection and init seem to work, charging not tested yet, adapter current measurement not right yet
2025-08-28 BlockBoxController removed charger current measurement
    Seems like this ADC setup is just too unstable. Not critical anyway.
    [BlockBoxController.ioc, charger_interface.cpp, charger_interface.h, main.c, system_bbv2.cpp]
2025-08-29 BlockBoxController PowerManager implementation started
    Basic charging logic seems to work, but needs more testing (different configs, start/end condition correctness, etc).
    Auto-shutdown not implemented yet.
    [BlockBoxController.ioc, charger_interface.cpp, charger_interface.h, eeprom_interface.h, main.c, power_manager.cpp, power_manager.h, system.h]
2025-08-29 BatteryMonitor firmware usability improvements
    Lowered full-charge voltage (matches SoC approximation 100%-level now).
    End-of-discharge shutdown no longer able to trigger while charging (allowing recharge after light-moderate overdischarge).
    [bms.c, bms.h]
2025-08-30 BlockBoxController added power settings screen
    Including auto-shutdown and charging behaviour testing, and related bug fixes.
    TODO: battery remaining time estimation
    [bbv2_gui_manager.cpp, bbv2_gui_manager.h, bbv2_screen.cpp, gui_manager.cpp, gui_manager.h, power_manager.cpp, power_manager.h, settings_screen_base.cpp]
2025-08-31 PowerAmpSupply slower inrush applied and tested
    Seems to work, so included the change in the design
    [PowerAmpSupply.kicad_pcb, PowerAmpSupply.kicad_sch, inrush.kicad_sch]
2025-09-01 BlockBoxController implemented battery time estimate
    Also added automatic re-write on ECC single-bit errors.
    [cpp_main.cpp, power_manager.cpp, power_manager.h, settings_screen_power.cpp]
2025-09-08 BlockBoxController debug log implementation start
    Actual logging should be done, UI proof-of-concept works, UI needs to be finished (scrolling, expand/collapse, filtering if wanted?, etc)
2025-09-10 BlockBoxController LED lighting implemented
    LEDManager for driving, phase-shifted PWM, and UI for configuration
2025-09-11 BlockBoxController debug logging rolled out
    Replaced most messages with log calls.
    [amp_manager.cpp, audio_path_manager.cpp, battery_interface.cpp, bbv2_gui_manager.cpp, bbv2_screen.cpp, bluetooth_receiver_interface.cpp, charger_interface.cpp, cpp_main.cpp]
2025-09-11 BlockBoxController enabled IWDG
    Also fixed superfluous green LED flash on init
    [BlockBoxController.ioc, cpp_main.cpp, main.c, main.h]
2025-09-16 BlockBoxController temporarily disabled LEDs
    Recurring LED driver damage, even at low duty cycle, during normal operation - needs more investigation
    [BlockBoxController.ioc, led_manager.cpp]
2025-09-18 BlockBoxController re-enabled LEDs
    Built new separate LED driver output stage with powerful transistors, hopefully it lives
2025-09-19 First in-box sound measurements, EQ fixes
    Uncalibrated measurements using REW and Zoom H2n mic.
    EQ re-enabled low shelf cut to avoid excess bass, added crossover to power EQ (otherwise no filters on that; may want to revise sometime)
    [audio_path_manager.cpp]
