BlockWorker/ModularAudio/(notices)

Notices in the files:
firmware/PowerAmpController/Core/Src/main.c:
Copyright (c) 2024 STMicroelectronics.
All rights reserved.
This software is licensed under terms that can be found in the LICENSE file
firmware/BlockBoxController/Core/Src/main.c:
Copyright (c) 2025 STMicroelectronics.
parts and their libraries:
©2025 BlockWorker
©2024 BlockWorker
